lukimcfly/MaturaProjekt/Bilder/Aufbau/arduino-und-breadboard.jpg

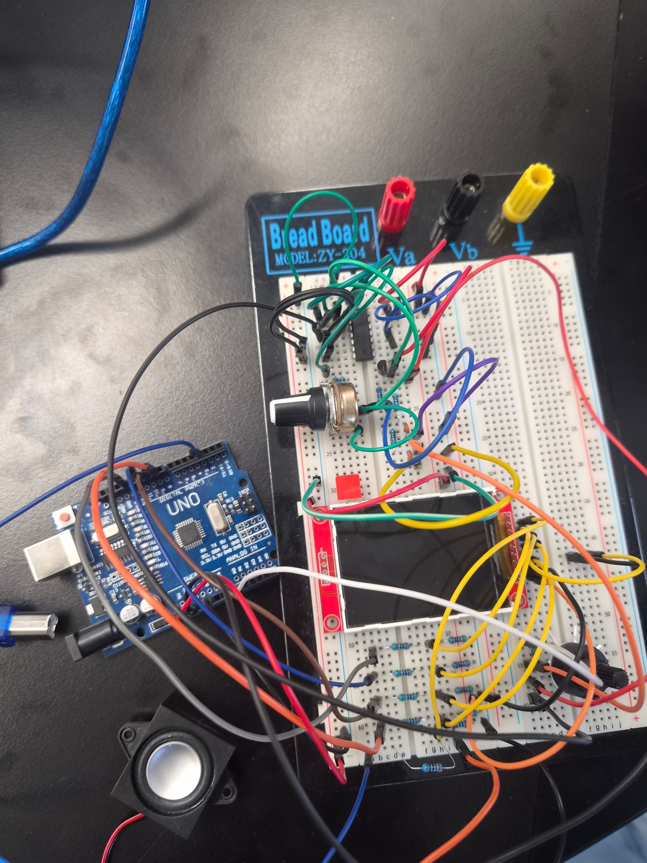
Bilder/Aufbau/arduino-und-breadboard.jpg
