lukimcfly/MaturaProjekt/Bilder/Aufbau/saegezahn-breadboard.jpg

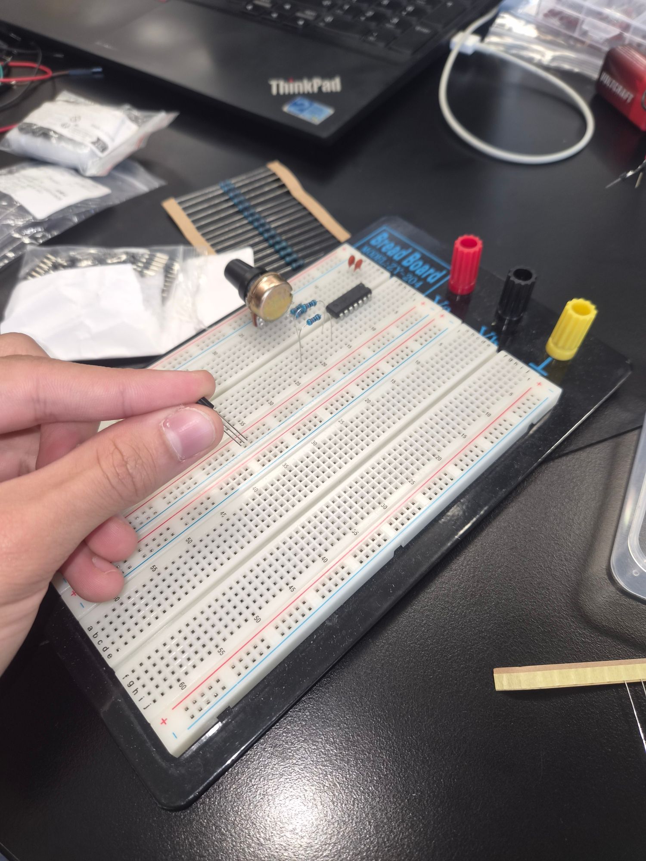
Bilder/Aufbau/saegezahn-breadboard.jpg
