lukimcfly/MaturaProjekt/Bilder/README.md

# Bilder

Alle Bilder zum Projekt. Jedes Bild bekommt hier unten eine Zeile im Index —
sonst weiß in zwei Monaten niemand mehr, was auf `IMG_4471.jpg` zu sehen ist.

## Unterordner

| Ordner | Inhalt |
|---|---|
| `Schaltplaene/` | KiCad-Screenshots, Schaltplanausschnitte, PCB-Layouts |
| `Aufbau/` | Fotos von Breadboard-Aufbauten, Bauteilen, Gehäuse |
| `Messungen/` | Oszilloskop-Screenshots, Spektren, Messprotokolle |

## Bild aus der Zwischenablage speichern

Statt von Hand abzuspeichern: Bild kopieren (Snipping Tool, Strg+C in KiCad),
dann im Projektordner in PowerShell:

```
.\Bilder\zwischenablage-speichern.ps1 saw-oszillator-v3
.\Bilder\zwischenablage-speichern.ps1 breadboard-mixer -Ordner Aufbau
```

Das Datum wird automatisch vorangestellt.

## Dateibenennung

`JJJJ-MM-TT_kurzbeschreibung.png`

Beispiele:
- `2026-08-12_oszillator-schmitt-trigger.png`
- `2026-09-05_breadboard-mixer.jpg`
- `2026-09-10_oszi-saegezahn-440hz.png`

Das Datum vorne sortiert die Bilder automatisch chronologisch und lässt sich
direkt dem passenden Tagebucheintrag zuordnen.

---

## Index

| Datei | Datum | Was ist zu sehen |
|---|---|---|
| `Schaltplaene/2026-08-19_saw-oszillator-kicad-v2.png` | 19.08.2026 | KiCad-Schaltplan Sägezahn-Oszillator, aktuelle Revision mit RVar zur Frequenzeinstellung |
| `Schaltplaene/2026-08-19_saw-oszillator-stromfluss.png` | 19.08.2026 | Erklärskizze zum Stromfluss mit Sägezahn-Kurve und Schaltschwellen V_T+ / V_T− |
| `Messungen/2026-08-19_falstad-simulation-saegezahn.mp4` | 19.08.2026 | Bildschirmaufnahme der Falstad-Simulation: Schaltung und Sägezahn-Kurvenform mit Frequenzregelung |
| `Schaltplaene/2026-09-16_platine-oszillator-oben.png` | 16.09.2026 | Oszillator-Platine, Bestückungsseite — die fertig geroutete Version |
| `Schaltplaene/2026-09-16_platine-oszillator-unten.png` | 16.09.2026 | Oszillator-Platine, Rückseite mit der Massefläche |
| `Schaltplaene/2026-09-21_bedienfeld-uebersicht.png` | 21.09.2026 | Bedienfeld: alle 24 Drehknöpfe, 7 Drehschalter, 13 Kippschalter, 3 Fader, Modus-Taster, 13 Buchsen, Display und Lautsprecherklemmen eines Geräts, mit Referenzen aus VERDRAHTUNG.md |
| *(fehlt noch)* `Schaltplaene/2026-08-12_oszillator-schmitt-trigger.png` | 12.08.2026 | erste Revision des Oszillators (RHigh 20 kΩ, RLow/RB 270 Ω) |
| `Schaltplaene/distortion-schalter-alt-SW2.png` | – | Distortion: ursprünglicher einfacher Umschalter weich/hart (SW2) |
| `Schaltplaene/distortion-schalter-neu-SW4-DPDT.png` | – | Distortion: neuer zweipoliger Umschalter (SW4, DPDT) |
| `Aufbau/saegezahn-breadboard.jpg` | nach den Herbstferien | Sägezahn-Oszillator auf dem Breadboard |
| `Aufbau/arduino-oszilloskop-display.jpg` | nach den Herbstferien | 2,2"-Display (ILI9341) des Arduino-Oszilloskops, Rückseite |
| `Aufbau/arduino-und-breadboard.jpg` | nach den Herbstferien | Arduino Uno, Display und Sägezahn-Oszillator auf dem Breadboard |
| `Aufbau/arduino-oszilloskop-saegezahn-2185hz.jpg` | nach den Herbstferien | Display zeigt den Sägezahn mit 2185 Hz |
| `WhatsApp/IMG-JJJJMMTT-WA….jpg` | im Dateinamen | Fotos aus dem Gruppenchat (Skizzen, Schaltpläne, Simulationen, Messungen). Bekannt: 20260610-WA0011 Oszilloskop LED-Blinker, 20260610-WA0005 Schaltplan Blinker, 20260818-WA0001 Sägezahn v1, 20260819-WA0002 Sägezahn v2, 20260819-WA0001 Produktskizze, 20260820-WA0003 Funktionsgenerator, 20260824-WA0003 / 20260826-WA0000 Distortion, 20260826-WA0009 Falstad-Mixer, 20260909-WA0003 Filter v1 |

---

## Beschreibungen

### 2026-08-19 — Sägezahn-Oszillator, aktuelle Revision (`...kicad-v2.png`)

| Bauteil | Wert | Funktion |
|---|---|---|
| U2A | 74LVC2G17 | Schmitt-Trigger-Buffer, Eingang Pin 1, Ausgang Pin 6 |
| RVar | 0 Ω – 25 kΩ | **einstellbarer Ladewiderstand → bestimmt die Tonhöhe** |
| RHigh | 5 kΩ | fester Anteil des Ladewiderstands, begrenzt die höchste Frequenz |
| C4 | 100 nF | zeitbestimmender Kondensator |
| Q4 | NPN | Entladeschalter, vom Schmitt-Trigger-Ausgang gesteuert |
| RLow | 220 Ω | Entladewiderstand vom Kondensatorknoten zum Kollektor |
| RB | 220 Ω | Basiswiderstand |

**Funktionsprinzip:** C4 lädt sich langsam über RVar + RHigh auf. Bei Erreichen der
oberen Schaltschwelle V_T+ kippt der Schmitt-Trigger-Ausgang auf HIGH, schaltet Q4
durch und entlädt C4 schnell über RLow gegen Masse. Bei V_T− kippt der Ausgang
zurück und der Ladevorgang beginnt von vorn.

Weil der Ladewiderstand (5 – 30 kΩ) rund hundertmal grösser ist als der
Entladewiderstand (220 Ω), dauert das Aufladen sehr viel länger als das Entladen —
genau diese **Asymmetrie erzeugt die Sägezahnform**. Mit RVar lässt sich die
Ladezeit und damit die Frequenz einstellen.

### 2026-08-19 — Erklärskizze Stromfluss (`...stromfluss.png`)

Dieselbe Schaltung mit eingezeichnetem Strompfad und der resultierenden
Sägezahn-Kurve zwischen den beiden Schaltschwellen V_T+ und V_T−. Zeigt anschaulich
den langsamen Anstieg und den steilen Abfall. Bauteilwerte in dieser Skizze noch
aus der ersten Revision (RHigh 20 kΩ, RLow 270 Ω, RB 2,2 kΩ).

### 2026-08-12 — erste Revision (Bilddatei fehlt noch)

Gleiche Topologie, andere Werte: RHigh 20 kΩ, RLow 270 Ω, RB 270 Ω, C4 ohne
festen Wert. Noch ohne einstellbaren Widerstand, also mit fester Frequenz.

### 2026-08-19 — Falstad-Simulation (`Messungen/...saegezahn.mp4`)

Bildschirmaufnahme der laufenden Simulation auf `falstad.com/circuit`. Zu sehen
sind die nachgebaute Schaltung und die erzeugte Sägezahnspannung; über den
einstellbaren Widerstand ändert sich die Frequenz.

**Erster Funktionsnachweis des selbst entworfenen Oszillators.**

Standbilder aus dem Video (Kurvenform, Frequenz an beiden Anschlagpunkten von
RVar) sollten noch als PNG gesichert werden — im schriftlichen Kommentar lässt
sich kein Video abdrucken.

### 2026-09-12 — Leiterplatten-Layouts (`Schaltplaene/2026-09-12_platine-*.png`)

3D-Ansichten der fertig gerouteten Platinen, jeweils Ober- und Unterseite.

| Datei | Inhalt |
|---|---|
| `2026-09-12_platine-hauptplatine-oben.png` | Hauptplatine, Bestückungsseite. Oben die Versorgung (Sicherungen, Verpolschutz, Siebung), in der Mitte der Mixer, unten rechts die LM386-Endstufe |
| `2026-09-12_platine-hauptplatine-unten.png` | Hauptplatine, Rückseite — fast durchgehende Massefläche, nur wenige kurze Leiterbahnen |
| `2026-09-12_platine-filter-oben.png` | Filter-Platine, Bestückungsseite. Die beiden Integratoren spiegeln sich um `U401` |
| `2026-09-12_platine-filter-unten.png` | Filter-Platine, Rückseite |

Warum die Rückseite fast leer ist: auf einer zweilagigen Platine **ist** die
Rückseite die Massefläche. Jede Leiterbahn dort schneidet einen Schlitz hinein,
den der Rückstrom umfliessen muss — deshalb kostet der Router das Fahren auf der
Rückseite extra und benutzt sie nur zum Kreuzen.

### 2026-09-16 — Oszillator-Platine (`Schaltplaene/2026-09-16_platine-oszillator-*.png`)

Die dritte und dichteste Platine, jetzt vollständig geroutet.

| Datei | Inhalt |
|---|---|
| `2026-09-16_platine-oszillator-oben.png` | Bestückungsseite. Oben die Versorgung mit den beiden Elkos, links `U103` (Vierfach-Op-Amp im SOIC-14, heute TL074CDR) mit den sechs Dioden der Wellenformung, rechts `U101` (TL074) in der Fassung, unten die beiden grossen Panel-Stecker `POTIS` und `SCHALTER` |
| `2026-09-16_platine-oszillator-unten.png` | Rückseite. Hier ist mehr Kupfer zu sehen als bei den anderen beiden Platinen — die Platine ist dichter, der Router muss öfter auf die Rückseite ausweichen |

Auffällig auf der Unterseite ist **ein längerer Zug quer über die Platine**: das
Netz `O1_AINV`. Dafür wurde eine Sperrfläche bewusst aufgehoben; die Begründung
und die gemessenen Kosten stehen in
[`Platinen/README.md`](../Platinen/README.md).

Die 27 Widerstände stehen **senkrecht** (ein Draht um 180° zurückgebogen) — auf
den Bildern gut zu erkennen. Liegend hätten sie neben den vier ICs keinen Platz
gelassen.
