lukimcfly/MaturaProjekt/Unsere-Materialien/README.md

# Unsere Materialien

Alles, was wir selbst für die Abgabe erstellen.

## Unterordner

| Ordner | Inhalt |
|---|---|
| `Vertrag/` | Der Maturaarbeits-Vertrag (Projektbeschreibung, Fragestellung, Bewertungskriterien) |
| `Logbuch/` | Das offizielle Logbuch zur Abgabe |
| `Schriftlicher-Kommentar/` | Der schriftliche Kommentar / die Projektarbeit |

## Verwandte Ordner außerhalb

- `diary/` — laufendes Arbeitstagebuch, die Rohfassung für das Logbuch
- `plan/` — Zeitpläne
- `quellen/` — Lernmaterial, wird später zum Quellenverzeichnis
