lukimcfly/MaturaProjekt/KI-Protokolle/2026-09-09_1fea6b0a.md

# Sitzung 1fea6b0a

- Sitzungs-ID: `1fea6b0a-24cf-402c-9ea6-93644efb6f1b`
- Zeitraum: 2026-09-09 bis 2026-09-09
- Modell(e): claude-opus-5
- Nutzer-Prompts: 8

> Lesbare Fassung: Prompts und Antworten im Wortlaut, Werkzeugaufrufe nur als Kurzzeile, Werkzeug-Ausgaben weggelassen.

---
### 🧑 Nutzer · 2026-09-09 13:14 UTC

Kicad file: C:\Users\<user>\Downloads\MaturaProjekt\KicadCircuit

in there you will find 2 schematic files of my circuit design for synthesizer. final goal: 3 oscillators, going into mixer, going through 2x filter in series, and then into amplifier. audiojack in oscillator is used to connect a single oscillator to filter (2 of these in total, separate from the others). make a new project, and create a final schematic containing everything, that is in total: 3 oscillators, 1 mixer, 4 filter, leading into amplifier. for mixer, use the schematic of the open falstad project in claude browser. for everything else, use the schematics from the files. make sure its clean, and if you have additional questions, ask. Love u <3

**🤖 Claude:**

I'll start by looking at your existing schematic files.

- *Werkzeug: Bash* — List KiCad project files
- *Werkzeug: mcp__Claude_Browser__tabs_context* — 

**🤖 Claude:**

The in-app browser has no tabs open — the Falstad project may be in your real Chrome. Let me check both while I read the schematics.

- *Werkzeug: Bash* — Inspect Filter schematic header and symbols
- *Werkzeug: ToolSearch* — 
- *Werkzeug: mcp__claude-in-chrome__tabs_context_mcp* — 
- *Werkzeug: Bash* — Extract symbol instances from both schematics

**🤖 Claude:**

Chrome isn't connected, and the in-app browser has no tabs open. Let me dig into the schematics first.

- *Werkzeug: Bash* — Extract labels and text from schematics

**🤖 Claude:**

No hierarchical labels — both sheets are fully wired flat. Let me map the actual topology of the Filter.

- *Werkzeug: Bash* — List Filter components with refs and values
- *Werkzeug: Bash* — Dump Filter schematic body without lib_symbols

---
### 🧑 Nutzer · 2026-09-09 13:15 UTC

[Request interrupted by user]

---
### 🧑 Nutzer · 2026-09-09 13:15 UTC

The in-app browser has no tabs open — the Falstad project may be in your real Chrome. -> sorry, now it's open in the claude browser. Continue

- *Werkzeug: mcp__Claude_Browser__tabs_context* — 
- *Werkzeug: mcp__Claude_Browser__javascript_tool* — 
- *Werkzeug: mcp__Claude_Browser__javascript_tool* — 
- *Werkzeug: Bash* — Decode Falstad circuit from URL
- *Werkzeug: Bash* — Try LZMA decode of Falstad circuit

**🤖 Claude:**

Let me just use Falstad's own export dialog.

- *Werkzeug: mcp__Claude_Browser__browser_batch* — 
- *Werkzeug: mcp__Claude_Browser__browser_batch* — 
- *Werkzeug: mcp__Claude_Browser__javascript_tool* — 
- *Werkzeug: mcp__Claude_Browser__javascript_tool* — 
- *Werkzeug: mcp__Claude_Browser__computer* — 

**🤖 Claude:**

The File menu is open — clicking "Export As Text".

- *Werkzeug: mcp__Claude_Browser__computer* — 
- *Werkzeug: mcp__Claude_Browser__javascript_tool* — 

**🤖 Claude:**

Got the full mixer netlist. Now let me map the oscillator schematic.

- *Werkzeug: Bash* — List oscillator components
- *Werkzeug: Bash* — Dump component lists and bodies
- *Werkzeug: Bash* — Dump component lists with UTF-8 output

**🤖 Claude:**

I've now got: the Falstad mixer netlist (3× [1µF → 10k pot → 22k] summing into an NPN common-emitter stage: 10µF coupling, 47k/10k bias, 330Ω collector, 10Ω+90Ω emitter with 470µF bypass, 47µF output), plus both KiCad sheets parsed.

Before I build, four things I genuinely can't infer:

- *Werkzeug: AskUserQuestion* — 

**🤖 Claude:**

Power rails: I'll go with **split ±12V + GND** — best fit here. All the op-amps you use (LM324, OPA1662, ADA4625, OPA4196) then swing around 0 V with no mid-rail bias network anywhere, the Falstad mixer's NPN stage runs unchanged off +12V/GND (its output is already AC-coupled), and the LM386 is a single-supply part that takes +12V/GND directly. One supply, no extra biasing block.

Let me inspect the instance/UUID format so replication is valid KiCad 9.

- *Werkzeug: Bash* — Inspect symbol instances format
- *Werkzeug: Bash* — Locate KiCad symbol libraries
- *Werkzeug: Bash* — Search for KiCad install
- *Werkzeug: Bash* — Check KiCad symbol library path

**🤖 Claude:**

Full KiCad 9 libraries are available locally — I can pull exact symbol definitions. Let me verify the parts I need.

- *Werkzeug: Bash* — Verify needed symbols exist in KiCad libs
- *Werkzeug: Bash* — Find potentiometer and passive symbols
- *Werkzeug: Bash* — Write s-expression parser helper

**🤖 Claude:**

Now let me verify the parser round-trips and validate the pin-position transform against the source files.

- *Werkzeug: Bash* — Validate parser and extract library pin coordinates
- *Werkzeug: Write* — C:\Users\<user>\AppData\Local\Temp\claude\C--Users-<user>-Downloads-MaturaProjekt\1fea6b0a-24cf-402c-9ea6-93644efb6f1b\scratchpad\sexpr.py
- *Werkzeug: Bash* — Validate parser round-trip and dump lib pin coords

**🤖 Claude:**

Parser round-trips cleanly. Now validating the pin-placement transform empirically against both source sheets.

- *Werkzeug: Write* — C:\Users\<user>\AppData\Local\Temp\claude\C--Users-<user>-Downloads-MaturaProjekt\1fea6b0a-24cf-402c-9ea6-93644efb6f1b\scratchpad\pintest.py
- *Werkzeug: Bash* — Test pin transform hypotheses

**🤖 Claude:**

Transform A confirmed. Let me check for `kicad-cli` (so I can ERC-validate the result) and inspect op-amp power-pin metadata.

- *Werkzeug: Bash* — 

**🤖 Claude:**

`kicad-cli` 9.0.7 is available — I can ERC-check and render the result. Now the op-amp power pins:

- *Werkzeug: Bash* — List power pins of all library symbols used

**🤖 Claude:**

Let me examine the oscillator's output stage to confirm where the output net is.

- *Werkzeug: Bash* — Inspect oscillator output stage wiring

**🤖 Claude:**

Let me run ERC on your original sheets to see what the sources themselves report.

- *Werkzeug: Bash* — Run ERC on original oscillator schematic
- *Werkzeug: Bash* — Run ERC without exit-code flag
- *Werkzeug: Bash* — Run ERC on original filter schematic
- *Werkzeug: Bash* — List oscillator dangling endpoints

**🤖 Claude:**

Now let me pull the pin geometry for the new parts (mixer + LM386 amp).

- *Werkzeug: Bash* — Extract pin geometry for new symbols
- *Werkzeug: Bash* — Resolve BC547 symbol inheritance
- *Werkzeug: Bash* — Get NPN base symbol pins and power symbol names

**🤖 Claude:**

All data gathered. Now writing the generator.

- *Werkzeug: Write* — C:\Users\<user>\AppData\Local\Temp\claude\C--Users-<user>-Downloads-MaturaProjekt\1fea6b0a-24cf-402c-9ea6-93644efb6f1b\scratchpad\kilib.py
- *Werkzeug: Bash* — Map filter output amplifier wiring

**🤖 Claude:**

Now the main build script.

- *Werkzeug: Write* — C:\Users\<user>\AppData\Local\Temp\claude\C--Users-<user>-Downloads-MaturaProjekt\1fea6b0a-24cf-402c-9ea6-93644efb6f1b\scratchpad\build.py
- *Werkzeug: Bash* — Test library loading and bboxes
- *Werkzeug: Bash* — Check power flag on power symbols

**🤖 Claude:**

Now the mixer, amplifier, power section and assembly.

- *Werkzeug: Bash* — Append mixer and amplifier builders
- *Werkzeug: Write* — C:\Users\<user>\AppData\Local\Temp\claude\C--Users-<user>-Downloads-MaturaProjekt\1fea6b0a-24cf-402c-9ea6-93644efb6f1b\scratchpad\blocks.py

**🤖 Claude:**

Now the power section and final assembly.

- *Werkzeug: Write* — C:\Users\<user>\AppData\Local\Temp\claude\C--Users-<user>-Downloads-MaturaProjekt\1fea6b0a-24cf-402c-9ea6-93644efb6f1b\scratchpad\assemble.py
- *Werkzeug: Bash* — Run assembly script

**🤖 Claude:**

Generated. Now the project file, then ERC and a render.

- *Werkzeug: Bash* — Create project file and run ERC
- *Werkzeug: Bash* — Inspect generated schematic head

**🤖 Claude:**

Found the bugs: a duplicated symbol name in the `extends` flattening, and reference collisions between new and copied blocks. Fixing, plus improving the output formatting to match KiCad's style.

- *Werkzeug: Edit* — C:\Users\<user>\AppData\Local\Temp\claude\C--Users-<user>-Downloads-MaturaProjekt\1fea6b0a-24cf-402c-9ea6-93644efb6f1b\scratchpad\sexpr.py
- *Werkzeug: Edit* — C:\Users\<user>\AppData\Local\Temp\claude\C--Users-<user>-Downloads-MaturaProjekt\1fea6b0a-24cf-402c-9ea6-93644efb6f1b\scratchpad\kilib.py

**🤖 Claude:**

Now fixing the reference-collision scheme across all blocks.

- *Werkzeug: Bash* — Patch reference schemes and rebuild
- *Werkzeug: Bash* — Rebuild and run ERC

**🤖 Claude:**

Load still fails. Let me bisect to find the offending construct.

- *Werkzeug: Write* — C:\Users\<user>\AppData\Local\Temp\claude\C--Users-<user>-Downloads-MaturaProjekt\1fea6b0a-24cf-402c-9ea6-93644efb6f1b\scratchpad\bisect.py
- *Werkzeug: Bash* — Bisect the failing schematic element
- *Werkzeug: Bash* — Find which lib symbols fail to load
- *Werkzeug: Bash* — Get detailed error for one failing symbol
- *Werkzeug: Bash* — View rest of the Speaker symbol entry
- *Werkzeug: Bash* — Diff library-sourced vs schematic-embedded R_US

**🤖 Claude:**

Found it — sub-unit symbol names must stay unprefixed (`R_US_1_1`, not `Device:R_US_1_1`).

- *Werkzeug: Edit* — C:\Users\<user>\AppData\Local\Temp\claude\C--Users-<user>-Downloads-MaturaProjekt\1fea6b0a-24cf-402c-9ea6-93644efb6f1b\scratchpad\kilib.py
- *Werkzeug: Bash* — Rebuild and run ERC
- *Werkzeug: Bash* — Re-check which lib symbols still fail

**🤖 Claude:**

lib_symbols are fine now. Bisecting the schematic items.

- *Werkzeug: Bash* — Bisect items for load failure

**🤖 Claude:**

The failure is a literal newline inside a quoted string — KiCad requires `\n` escapes.

- *Werkzeug: Edit* — C:\Users\<user>\AppData\Local\Temp\claude\C--Users-<user>-Downloads-MaturaProjekt\1fea6b0a-24cf-402c-9ea6-93644efb6f1b\scratchpad\sexpr.py
- *Werkzeug: Bash* — Rebuild and run ERC

**🤖 Claude:**

It loads now. Let me see the violation breakdown.

- *Werkzeug: Bash* — Summarize ERC violations

**🤖 Claude:**

Good — it loads. Now fixing the real issues: off-grid block placement (1045 warnings), the supply block wiring, and NC pins.

- *Werkzeug: Bash* — Get Conn_01x03 pin coordinates
- *Werkzeug: Bash* — Rewrite amplifier block on a clean grid
- *Werkzeug: Bash* — Fix string literal in blocks.py
- *Werkzeug: Edit* — C:\Users\<user>\AppData\Local\Temp\claude\C--Users-<user>-Downloads-MaturaProjekt\1fea6b0a-24cf-402c-9ea6-93644efb6f1b\scratchpad\blocks.py

**🤖 Claude:**

Now the supply block rewrite and grid snapping.

- *Werkzeug: Bash* — Verify blocks imports and locate supply function
- *Werkzeug: Bash* — Rewrite the supply block

**🤖 Claude:**

Now grid snapping and the NC-pin pass.

- *Werkzeug: Bash* — Apply grid snap and NC pass, rebuild, ERC

**🤖 Claude:**

Off-grid errors gone (1045 → 0). Let me look at what remains.

- *Werkzeug: Bash* — List remaining non-unit ERC issues

**🤖 Claude:**

Let me inspect the supply block in the generated file to see why those pins read as unconnected.

- *Werkzeug: Bash* — Dump supply block geometry from output
- *Werkzeug: Bash* — Check wires produced by build_supply
- *Werkzeug: Bash* — ERC the supply block in isolation
- *Werkzeug: Bash* — Inspect raw wire and junction syntax

**🤖 Claude:**

Let me export the netlist to see what KiCad actually connects.

- *Werkzeug: Bash* — Export netlist for the supply probe
- *Werkzeug: Bash* — Check wire endpoints at connector pins
- *Werkzeug: Bash* — Check for duplicate UUIDs
- *Werkzeug: Bash* — Minimal connector connection test

**🤖 Claude:**

The minimal case works. Let me add the junction-plus-branch pattern.

- *Werkzeug: Bash* — Test junction-plus-branch pattern

**🤖 Claude:**

Reproduced: a junction placed **mid-wire** with a branch doesn't connect — KiCad expects the wire split at that point. This also affects the mixer's summing bus. Adding a general split pass.

- *Werkzeug: Bash* — Add wire-splitting pass and rebuild
- *Werkzeug: Bash* — List remaining ERC issues
- *Werkzeug: Bash* — Identify oscillator audio jack references
- *Werkzeug: Bash* — Add solo-filter jacks, fix speaker, rebuild

**🤖 Claude:**

The heredoc mangled the escapes again. Fixing those strings directly.

- *Werkzeug: Bash* — View broken region of assemble.py
- *Werkzeug: Bash* — Repair split string literals
- *Werkzeug: Bash* — Rebuild and run ERC

**🤖 Claude:**

Down to 3 errors and 35 warnings, all inherited from the source design. Let me fix the stale note and render it to look at.

- *Werkzeug: Edit* — C:\Users\<user>\AppData\Local\Temp\claude\C--Users-<user>-Downloads-MaturaProjekt\1fea6b0a-24cf-402c-9ea6-93644efb6f1b\scratchpad\assemble.py
- *Werkzeug: Bash* — Export SVG preview
- *Werkzeug: Bash* — Export PDF

**🤖 Claude:**

Let me visually inspect the result.

- *Werkzeug: Read* — C:\Users\<user>\Downloads\MaturaProjekt\SynthesizerFinal\SynthesizerFinal.pdf
- *Werkzeug: mcp__Claude_Browser__navigate* — file:///C:/Users/<user>/Downloads/MaturaProjekt/SynthesizerFinal/preview/SynthesizerFinal.svg

**🤖 Claude:**

Let me verify the connectivity via the netlist — stronger than eyeballing.

- *Werkzeug: Bash* — Verify signal chain nets

**🤖 Claude:**

Connectivity verified end-to-end. Let me check the mixer bus and the solo filters, and look at the odd reference names.

- *Werkzeug: Bash* — Verify mixer bus, transistor and solo jack nets

**🤖 Claude:**

All connectivity checks pass. Last cleanup: the source's non-standard reference `0Ω-25kΩ` produced ugly auto-refs — let me preserve that text as the component value instead.

- *Werkzeug: Bash* — Fix odd references and rebuild
- *Werkzeug: Bash* — List source symbols with non-standard references

**🤖 Claude:**

Three of those are meaningful *names* (`RLow`, `RHigh`, `RB`) with real values — my last patch would clobber them. Refining.

- *Werkzeug: Edit* — C:\Users\<user>\AppData\Local\Temp\claude\C--Users-<user>-Downloads-MaturaProjekt\1fea6b0a-24cf-402c-9ea6-93644efb6f1b\scratchpad\build.py
- *Werkzeug: Bash* — Rebuild and verify renamed components

**🤖 Claude:**

Layout check — let me actually look at it. Starting a local server to view the SVG.

- *Werkzeug: Bash* — Create launch config for preview server
- *Werkzeug: mcp__Claude_Browser__preview_start* — 
- *Werkzeug: Bash* — Create SVG viewer with zoom support
- *Werkzeug: mcp__Claude_Browser__browser_batch* — 

**🤖 Claude:**

Layout is sound. Let me zoom into two spots that look like text collisions.

- *Werkzeug: mcp__Claude_Browser__browser_batch* — 

**🤖 Claude:**

The text is center-justified, so it runs off the page frame. Fixing that.

- *Werkzeug: Edit* — C:\Users\<user>\AppData\Local\Temp\claude\C--Users-<user>-Downloads-MaturaProjekt\1fea6b0a-24cf-402c-9ea6-93644efb6f1b\scratchpad\kilib.py
- *Werkzeug: Bash* — Rebuild with left-justified text
- *Werkzeug: mcp__Claude_Browser__browser_batch* — 

**🤖 Claude:**

Good. Two cosmetic fixes: jack labels overlapping the ground symbol, and the output jack sitting on the diode labels.

- *Werkzeug: Edit* — C:\Users\<user>\AppData\Local\Temp\claude\C--Users-<user>-Downloads-MaturaProjekt\1fea6b0a-24cf-402c-9ea6-93644efb6f1b\scratchpad\assemble.py
- *Werkzeug: Bash* — Rebuild and re-export
- *Werkzeug: mcp__Claude_Browser__browser_batch* — 

**🤖 Claude:**

A few ground labels sit above their symbols and collide. Fixing the power-symbol text placement.

- *Werkzeug: Edit* — C:\Users\<user>\AppData\Local\Temp\claude\C--Users-<user>-Downloads-MaturaProjekt\1fea6b0a-24cf-402c-9ea6-93644efb6f1b\scratchpad\kilib.py
- *Werkzeug: Bash* — Reroute amp ground and rebuild
- *Werkzeug: mcp__Claude_Browser__browser_batch* — 

**🤖 Claude:**

Let me check how KiCad stores property text angle for rotated symbols.

- *Werkzeug: Bash* — Check property angle convention for rotated symbols
- *Werkzeug: mcp__Claude_Browser__browser_batch* — 

**🤖 Claude:**

Two issues: rotated symbols' ref/value text overlaps, and short label stubs. Let me test the property-angle behaviour.

- *Werkzeug: Bash* — Probe property text angle behaviour
- *Werkzeug: Bash* — Create viewer for angle test
- *Werkzeug: mcp__Claude_Browser__browser_batch* — 

**🤖 Claude:**

Confirmed — property angle is relative to the symbol, so it must be `(360 − rot)`. Fixing that and lengthening the label stubs.

- *Werkzeug: Edit* — C:\Users\<user>\AppData\Local\Temp\claude\C--Users-<user>-Downloads-MaturaProjekt\1fea6b0a-24cf-402c-9ea6-93644efb6f1b\scratchpad\kilib.py
- *Werkzeug: Bash* — Lengthen label stubs and rebuild
- *Werkzeug: Bash* — Re-export and clean up test files
- *Werkzeug: mcp__Claude_Browser__browser_batch* — 

**🤖 Claude:**

Text is horizontal now. Tightening a few crowded labels in the mixer's transistor stage.

- *Werkzeug: Bash* — Adjust mixer label positions and re-render
- *Werkzeug: mcp__Claude_Browser__browser_batch* — 
- *Werkzeug: Bash* — Final label tweak, rebuild all outputs
- *Werkzeug: mcp__Claude_Browser__browser_batch* — 

**🤖 Claude:**

Final verification pass.

- *Werkzeug: Bash* — Generate BOM and final stats

**🤖 Claude:**

All checks pass. Writing documentation and cleaning up.

- *Werkzeug: Write* — C:\Users\<user>\Downloads\MaturaProjekt\SynthesizerFinal\README.md
- *Werkzeug: Bash* — Verify claims about jack wiring and filter feedback
- *Werkzeug: Edit* — C:\Users\<user>\Downloads\MaturaProjekt\SynthesizerFinal\README.md
- *Werkzeug: Bash* — Clean up helper files
- *Werkzeug: mcp__Claude_Browser__preview_stop* — 
- *Werkzeug: Write* — C:\Users\<user>\.claude\projects\C--Users-<user>-Downloads-MaturaProjekt\memory\synth-gesamtschaltplan.md
- *Werkzeug: Bash* — Update memory index
- *Werkzeug: SendUserFile* — 

**🤖 Claude:**

Done — new project at [SynthesizerFinal/](SynthesizerFinal), one flat sheet with everything on it.

**Signalweg:** 3 Oszillatoren → Mixer → Filter A → Filter B → LM386 → Lautsprecher, plus Filter C/D als Solo-Filter mit eigenen Klinkenbuchsen.

**Was ich gebaut habe**
- Oszillator 1:1 aus deiner Datei, 3× instanziiert; Filter 4× — A und die beiden Solo-Filter ohne Ausgangsverstärker, B mit (folgt deiner Notiz im Original-Filterblatt).
- Mixer aus der Falstad-Simulation abgelesen: pro Kanal 1 µF → 10 k Poti → 22 k auf die Summierschiene, dann BC547-Emitterschaltung (10 µF Kopplung, 47k/10k Basisteiler, 330 Ω Kollektor, 10 Ω + 90 Ω mit 470 µF, 47 µF Ausgang). Den 1 k Lastwiderstand habe ich mitgenommen, damit Messung und Simulation vergleichbar bleiben.
- LM386-Endstufe mit Master-Poti, Verstärkung 200, Zobel-Glied, 8 Ω Lautsprecher.

**Rails — deine Wahl war delegiert, ich habe ±12 V genommen.** Alle OPVs (LM324, OPA1662, OPA4196, ADA4625) schwingen damit um 0 V, kein Mittenspannungs-Netzwerk nötig; die BC547-Mixerstufe läuft unverändert an +12 V/GND wie simuliert, der LM386 ebenfalls. Ein Netzteil, keine Extra-Blöcke. Die Versorgungs-Units aller 16 Chips habe ich ergänzt und abgeblockt — die fehlten im Original komplett.

**Geprüft mit kicad-cli 9.0.7:** ERC 3 Fehler / 35 Warnungen, alle aus dem Originalentwurf (Pin-Typ des SPICE-NPN-Emitters, ungenutzte OPV-Einheiten, offener Schmitt-Trigger-Eingang). Der Netzliste nach ist die Kette durchgehend verbunden. 252 Bauteile, 181 Netze, BOM liegt bei.

**Vier Punkte solltest du dir ansehen** — gefunden beim Zusammenführen, bewusst nicht stillschweigend geändert:
1. Bei den Ausgangsbuchsen `J101/J201/J301` liegt das Signal am *Sleeve*, der *Tip* am Rückkopplungsknoten von U106 — normalerweise umgekehrt.
2. Bei `U501` geht `R504` vom Ausgang auf den **+**-Eingang, am **−**-Eingang nur `R505` nach Masse. Das ist Mitkopplung.
3. Oszillatorkern und Ausgangsstufe sind nicht verbunden (im Original ein `power:AC`-Symbol ohne Gegenstück) — jetzt als `OSC1_CORE` etc. sichtbar beschriftet.
4. Die Bauteilwerte der Filterblöcke sind im Original leer, stehen also auch in der BOM noch offen.

Sag Bescheid, wenn ich 1–3 korrigieren soll — das sind kleine Eingriffe, ich wollte nur deine Schaltung nicht ungefragt umbauen.

---
### 🧑 Nutzer · 2026-09-09 14:17 UTC

ja bitte korrigier 1-3.

Ait und bitte danach: Mache einen Schaltkreis, der alles was wir haben enthält und wie unser finales produkt sein soll. 

Dabei bitte Werte beachten und falls nötig anpassen (bitte am Schluss eine Liste angeben welche Werte verändert worden sind).
Frequenz, Amplitude, Filterstärke, Für jedes Oszillatorensignal im Mixer amplitude/Effektivität verstelltbar. Und für jeden Oszillator ist die Wave-form verstellbar. -> Das sollte eigentlich schon alles möglich sein in unseren Schaltplänen, aber trotzdem nochmals kurz zur Kontrolle. 

Ziel: Ein einziger finaler Final-Schaltkreis.

**🤖 Claude:**

Understood — beides. Zuerst muss ich die beiden Blöcke wirklich im Detail verstehen (Filterzweige, Oszillator-Regler), bevor ich Werte festlege. Ich hole mir die Netzlisten der Originale.

- *Werkzeug: Bash* — Extract filter netlist and components

**🤖 Claude:**

No response requested.

---
### 🧑 Nutzer · 2026-09-09 14:47 UTC

Continue

**🤖 Claude:**

Filter topology decoded. Four branches off the rotary — series R + shunt C (Tiefpass), series C + shunt R (Hochpass), L-C-C-L Leiter (Bandpass), Parallel-LC-Sperrkreis (Bandsperre), Position 5 = Bypass. But **D1–D5 sitzen in Serie im Signalweg** — das ist ein echtes Problem. Erst der Oszillator:

- *Werkzeug: Bash* — Extract oscillator netlist

**🤖 Claude:**

Ich habe jetzt beide Blöcke vollständig entschlüsselt. Kurzer Kontrollbefund zu deiner Liste:

| Regler | Status |
|---|---|
| **Waveform** pro Oszillator | ✅ `SW1`, 4 Stellungen: Sinus (U1C), Dreieck (U1B), Rechteck (U1A), Sägezahn (U2/Q4) |
| **Mixer-Pegel** pro Kanal | ✅ `RV801/802/803`, 10 k |
| **Frequenz** | ⚠️ nur Sägezahn (`RVar` 0–25 k). Sinus/Dreieck/Rechteck liegen fest auf R6/C6 — deckt sich mit deinem ToDo *„Frequency Regulators kombinieren"* |
| **Amplitude** pro Oszillator | ⚠️ nicht implementiert (dein ToDo *„Amplitude Regulation"*, U6/R20/R4 halbfertig) |
| **Filterstärke** | ⚠️ nur `R4` als Ausgangspegel; Grenzfrequenz liegt fest |

Dazu ein vierter Fund, gravierender als die drei bekannten: **D1–D5 im Filter liegen in Serie im Signalweg** (jeder Zweig endet in einer Diode, alle Kathoden zusammen, dann D5 zum Ausgang). Dioden leiten erst ab ~0,6 V und nur in einer Richtung — das würde das Audiosignal gleichrichten statt filtern. Dasselbe Muster nochmal bei D5/D6 am Filter-Port des Oszillators.

Vier Entscheidungen, die den Schaltkreis wesentlich verändern:

- *Werkzeug: AskUserQuestion* — 

**🤖 Claude:**

Alle vier Empfehlungen übernommen. Beim Durchrechnen der Werte sind zwei weitere echte Fehler aufgetaucht, die ich mit einplane:

- **U2 (74LVC2G17) ist ein 1,65–5,5 V-Baustein** — ich hatte ihn in der Versorgung an +12 V gehängt, das würde ihn zerstören. Und der Sägezahn lädt C4 aus +12 V direkt in seinen Eingang. Beides braucht eine +5 V-Schiene.
- **C6 = 1 µF ergibt f ≈ 14 Hz** — der LM324-Kern schwingt also weit unter dem Hörbereich.

Erst die Geometrie, damit ich weiss, wo ich chirurgisch eingreifen kann:

- *Werkzeug: Bash* — Get positions of key oscillator components

**🤖 Claude:**

R6 ist bereits ein `R_Variable_US` — der Frequenzregler existiert also schon, er hat nur den falschen Wert. Aber beim Durchrechnen der Amplituden stosse ich auf ein architektonisches Problem. Lass mich das prüfen:

- *Werkzeug: Bash* — Find boundary-crossing wires and switch pin geometry

**🤖 Claude:**

Vier saubere Schnittstellen zu SW1 — die Kernstufe lässt sich also als Block ersetzen. Ich hole die restliche Pin-Geometrie:

- *Werkzeug: Bash* — Check part availability and pin geometry

**🤖 Claude:**

Kein 2-poliger Drehschalter in den Standard-Bibliotheken — ich nehme zwei gekoppelte `SW_Rotary_1x5_MP` (zwei Ebenen, so ist ein 2-poliger Drehschalter real auch aufgebaut). Letzte Geometrie, die ich brauche:

- *Werkzeug: Bash* — Map filter-port wiring region

**🤖 Claude:**

Ich habe jetzt das vollständige Bild. Der Befund ist grösser als gedacht:

**Der Oszillatorkern lässt sich nicht durch Werte reparieren.** U1A schwingt eigenständig, U1B und U1C integrieren nur nach. Die Amplitude eines Integrators ist ∝ 1/f — bei 85 Hz würde das Dreieck auf ~300 V wollen und hart clippen, bei 9 kHz bleiben 3 V übrig. Das ist Architektur, nicht Bestückung. Der Standardaufbau (Komparator und Integrator **im Regelkreis**) liefert dagegen bei jeder Frequenz konstante Amplitude.

Dazu kommt: der Sägezahnknoten ist hochohmig und braucht einen Puffer, sonst zieht ihn die nachfolgende Stufe zusammen.

Ich baue den Oszillator daher als saubere Blockstruktur neu auf — gleiche Bauteile, gleiche Funktionen, aber funktionierend verschaltet:

- *Werkzeug: Write* — C:\Users\<user>\AppData\Local\Temp\claude\C--Users-<user>-Downloads-MaturaProjekt\1fea6b0a-24cf-402c-9ea6-93644efb6f1b\scratchpad\parts.py

**🤖 Claude:**

Jetzt der Oszillator als sieben saubere Teilblöcke, über Netznamen verbunden:

- *Werkzeug: Write* — C:\Users\<user>\AppData\Local\Temp\claude\C--Users-<user>-Downloads-MaturaProjekt\1fea6b0a-24cf-402c-9ea6-93644efb6f1b\scratchpad\osc.py

**🤖 Claude:**

You've hit your session limit · resets 6:40pm (Europe/Zurich)

---
### 🧑 Nutzer · 2026-09-09 18:01 UTC

Continue

**🤖 Claude:**

Jetzt der Filter — neu gezeichnet mit 2-Ebenen-Wahlschalter, Puffern und echten Werten:

- *Werkzeug: Write* — C:\Users\<user>\AppData\Local\Temp\claude\C--Users-<user>-Downloads-MaturaProjekt\1fea6b0a-24cf-402c-9ea6-93644efb6f1b\scratchpad\flt.py

**🤖 Claude:**

Jetzt die Montage. Erst noch die Pins des 5-V-Reglers:

- *Werkzeug: Bash* — Get regulator and switch pin geometry
- *Werkzeug: Bash* — Remove explicit no-connects (handled centrally)

**🤖 Claude:**

Jetzt die Montage:

- *Werkzeug: Write* — C:\Users\<user>\AppData\Local\Temp\claude\C--Users-<user>-Downloads-MaturaProjekt\1fea6b0a-24cf-402c-9ea6-93644efb6f1b\scratchpad\assemble2.py
- *Werkzeug: Bash* — Run the new assembly
- *Werkzeug: Bash* — Run ERC on the new schematic

**🤖 Claude:**

It loads. Let me see what's not connecting.

- *Werkzeug: Bash* — List ERC violations

**🤖 Claude:**

Klare Fehlerbilder. Vier Ursachen: Buchsen nicht gespiegelt, eine fehlende Leitung am Pegel-Poti, eine ungenutzte Gatter-Hälfte — und vor allem: mein `split_wires` schneidet nur an Verbindungspunkten, nicht an **Bauteil-Pins**, die mitten auf einer Leitung liegen.

- *Werkzeug: Bash* — Fix jack mirroring and the level-pot wire gap

**🤖 Claude:**

Now the important one — `split_wires` must also cut at pin positions:

- *Werkzeug: Bash* — Split wires at pins, rebuild, ERC

**🤖 Claude:**

Von 77 auf 28. Der Rest:

- *Werkzeug: Bash* — List remaining ERC issues

**🤖 Claude:**

Ein systematischer Fehler: bei gespiegelten Buchsen liegt der Sleeve **über** dem Tip, nicht darunter. Ich korrigiere die Masseführung und ergänze die ungenutzte Gatter-Hälfte:

- *Werkzeug: Bash* — Fix jack grounds, add spare gate, rebuild
- *Werkzeug: Bash* — Repair string literal and rebuild

**🤖 Claude:**

**ERC: 0 Fehler, 0 Warnungen.** Jetzt die inhaltliche Prüfung — ERC sagt nur, dass alles verbunden ist, nicht dass es stimmt:

- *Werkzeug: Bash* — Verify the signal-chain netlist
- *Werkzeug: Bash* — Trace the oscillator-1 switch nets

**🤖 Claude:**

Alle Verbindungen stimmen — der Regelkreis ist geschlossen (`R105` führt vom Dreieck zurück auf den Komparator-Eingang). Jetzt der Filter:

- *Werkzeug: Bash* — Verify filter A branch wiring

**🤖 Claude:**

Filter verifiziert: Ebene A schaltet den Eingang, Ebene B den Ausgang, alle vier Zweige beidseitig getrennt — und die Gegenkopplung `RV403` liegt jetzt am **−**-Eingang. Jetzt die optische Kontrolle:

- *Werkzeug: Bash* — Export SVG/PDF/BOM and set up preview
- *Werkzeug: mcp__Claude_Browser__preview_start* — 
- *Werkzeug: mcp__Claude_Browser__browser_batch* — 
- *Werkzeug: mcp__Claude_Browser__browser_batch* — 

**🤖 Claude:**

Elektrisch stimmt es. Ein paar Beschriftungen überlappen noch — die räume ich auf:

- *Werkzeug: Bash* — Declutter labels and re-render
- *Werkzeug: mcp__Claude_Browser__browser_batch* — 
- *Werkzeug: Bash* — Raise horizontal part labels and re-render
- *Werkzeug: mcp__Claude_Browser__browser_batch* — 

**🤖 Claude:**

Filter liest sich sauber. Zwei letzte Beschriftungskorrekturen, dann die Dokumentation:

- *Werkzeug: Bash* — Final rebuild with all outputs

**🤖 Claude:**

Beim Durchrechnen der Pegel fallen mir zwei echte Probleme auf: das Rechteck käme mit 21 Vss aus dem LM324 und würde die Ausgangsstufe übersteuern, und der Sägezahn liefert nur ~1 Vss. Beides muss angeglichen werden:

- *Werkzeug: Bash* — Add sawtooth gain stage and square divider
- *Werkzeug: Bash* — Repair literals and rebuild
- *Werkzeug: Bash* — Verify the new sawtooth gain and square divider nets

**🤖 Claude:**

Alles verifiziert. Finale Ausgabe und optische Schlusskontrolle:

- *Werkzeug: Bash* — Final export and BOM totals
- *Werkzeug: mcp__Claude_Browser__browser_batch* — 

**🤖 Claude:**

Eine letzte Kollision, dann die Dokumentation:

- *Werkzeug: Bash* — Final fix, rebuild, export, clean up
- *Werkzeug: mcp__Claude_Browser__preview_stop* — 
- *Werkzeug: Write* — C:\Users\<user>\Downloads\MaturaProjekt\SynthesizerFinal\README.md
- *Werkzeug: Bash* — Final netlist verification
- *Werkzeug: Bash* — Correct README figures
- *Werkzeug: SendUserFile* — 
- *Werkzeug: Write* — C:\Users\<user>\.claude\projects\C--Users-<user>-Downloads-MaturaProjekt\memory\synth-gesamtschaltplan.md

**🤖 Claude:**

Fertig. Ein Schaltplan, [SynthesizerFinal/](SynthesizerFinal), ERC **0 Fehler / 0 Warnungen**, Netzliste knotenweise nachgeprüft.

**Punkte 1–3 erledigt:** Ausgangsbuchse entdreht (Tip = Signal), Gegenkopplung des Filterverstärkers auf den −-Eingang gelegt, Kern und Ausgangsstufe verbunden.

**Deine Reglerliste — Kontrolle:** Wellenform und Mixer-Pegel waren schon da. Frequenz gab es nur für den Sägezahn, Amplitude gar nicht, Cutoff gar nicht — alle drei sind jetzt drin. Der Frequenzknopf ist ein 2-fach-Gleichlaufpoti (dein ToDo „Frequency Regulators kombinieren"), ca. 95 Hz – 9,6 kHz.

**Beim Rechnen kamen vier Sachen hoch, die ich nicht vorhergesehen hatte:**

1. **U2 (74LVC2G17) ist ein 1,65–5,5 V-Baustein.** In Rev. 1 hing er an +12 V und der Sägezahn lud seinen Eingang direkt aus +12 V — das hätte ihn zerstört. Jetzt gibt es eine +5 V-Schiene (78L05).
2. **Der Oszillatorkern liess sich nicht über Werte reparieren.** U1A schwang eigenständig, U1B/U1C integrierten nur nach — die Amplitude eines Integrators ist ∝ 1/f, das Dreieck hätte bei 95 Hz über 300 V gewollt und wäre bei 9 kHz auf 3 V geschrumpft. Ich habe Komparator und Integrator in einen Regelkreis gelegt (Standard-Funktionsgenerator) und den Sinus über einen Dioden-Former statt zweite Integration gemacht. **Das ist der grösste Eingriff in deinen Entwurf** — steht in Abschnitt 3.4 der Doku begründet, falls du es anders willst.
3. **Das Rechteck kam mit 21 Vss** aus dem LM324 und hätte die Ausgangsstufe in die Begrenzung getrieben; der Sägezahn lieferte nur ~1 Vss. Beide sind jetzt auf ~7 Vss angeglichen, damit ein Wellenformwechsel keinen Lautstärkesprung macht.
4. **Der Sägezahnknoten war hochohmig** und wäre von der nächsten Stufe zusammengezogen worden — jetzt gepuffert.

**Die Werteliste** steht komplett in Abschnitt 2 der [README](SynthesizerFinal/README.md): 30 Zeilen für den Oszillator mit alt → neu und Begründung, plus die Filterwerte (dort war im Original kein einziger gesetzt).

Zwei Dinge zum Nachprüfen vor dem Aufbau: die 33/68 mH-Drosseln sind die teuersten und toleranzbehaftetsten Teile, und der Gleichlauf der Frequenzpotis stimmt nur auf ~15 % — Sägezahn und Funktionsgenerator folgen unterschiedlichen Zeitgesetzen. Für einen Knopf pro Oszillator reicht es, exakt ginge nur mit zwei getrennten Reglern.

---
### 🧑 Nutzer · 2026-09-09 18:21 UTC

Öffne den Plan in KiCad damit ich ihn anschauen kann

- *Werkzeug: PowerShell* — Locate KiCad and Eeschema executables
- *Werkzeug: PowerShell* — Open the schematic in Eeschema

**🤖 Claude:**

Eeschema läuft, der Plan ist offen (Fenster „SynthesizerFinal — Schematic Editor").

Ein paar Hinweise zum Anschauen:

- **Ganze Seite:** `Ansicht → Zoom auf Seite` bzw. Taste `Home` — das Blatt ist 834 × 825 mm, beim Öffnen siehst du sonst nur einen Ausschnitt.
- **Aufteilung:** links die drei Oszillatoren (je acht beschriftete Teilblöcke A–G), Mitte Mixer und die vier Filter, rechts Endstufe, IC-Versorgung und Netzteil.
- **Netznamen verfolgen:** Die Blöcke sind über Netznamen statt langer Leitungen verbunden (`OSC1_TRI`, `OSC1_WAVE` …). Ein Klick auf ein Netz hebt es hervor; mit `Bearbeiten → Suchen` springst du direkt zu einem Namen.
- **ERC nachvollziehen:** `Werkzeuge → Electrical Rules Checker` → sollte 0/0 melden.

Falls dir Beschriftungen zu dicht stehen: einfach anklicken und mit `M` verschieben — das ändert nichts an den Netzen.

---
### 🧑 Nutzer · 2026-09-09 18:27 UTC

Ok aber der Schaltplan ist immer noch nicht wie ich es wollte. Im moment hast du die Oszillatoren, Filter und so weiter als einzelne Bau-Schaltpläne. Ich will jedoch einen einzelen vollstänging verbunden Schaltkreis der alle unsere bis jetzigen Bau-Schaltpläne enthält. Verstehst du was ich meine? Also nicht mehr alles seperat, sondern ein einzelner verbundener Schaltplan. Das habe ich eigentlich mit "finalem Schaltplan gemeint".

**🤖 Claude:**

Ja, jetzt verstehe ich — du willst die Blöcke **mit echten Leitungen verbunden** sehen, nicht über Netznamen. Im Moment ist jeder Block eine Insel, und `OSC1_TRI` usw. verbinden sie unsichtbar. Man kann das Signal nicht mit dem Finger verfolgen.

Ich zeichne die Verbindungen aus. Zuerst prüfe ich, wie gross ein KiCad-Blatt sein darf — das bestimmt die Anordnung:

- *Werkzeug: Bash* — Test KiCad maximum page size

**🤖 Claude:**

KiCad nimmt auch grosse Blätter. Jetzt die Blockgrössen, damit ich die Kette planen kann:

- *Werkzeug: Bash* — Measure block sizes and port positions

**🤖 Claude:**

Alle Ports sind bekannt. Zwei Blöcke muss ich umdrehen, damit alles links→rechts fliesst, und die Dreieck-Rückführung wird blockintern verdrahtet:

- *Werkzeug: Bash* — Reorient waveselect, internalize feedback

**🤖 Claude:**

Alle Blöcke fliessen jetzt links→rechts. Jetzt die Verdrahtung — die Netznamen werden durch echte Leitungen ersetzt:

- *Werkzeug: Write* — C:\Users\<user>\AppData\Local\Temp\claude\C--Users-<user>-Downloads-MaturaProjekt\1fea6b0a-24cf-402c-9ea6-93644efb6f1b\scratchpad\assemble3.py
- *Werkzeug: Bash* — Build the fully wired version and run ERC

**🤖 Claude:**

0 Fehler — nur meine Leitungs-Korridore liegen nicht auf dem 1,27-mm-Raster:

- *Werkzeug: Bash* — Snap routing to grid and re-check

**🤖 Claude:**

ERC 0/0. Jetzt der entscheidende Test: die Verdrahtung muss **elektrisch identisch** zur geprüften Version sein — nur eben gezeichnet statt benannt:

- *Werkzeug: Bash* — Compare netlists: wired version vs verified label version

**🤖 Claude:**

228 Netze auf beiden Seiten, und der einzige Unterschied ist die Pin-Nummerierung des Koppelkondensators `C_03` — der ist gespiegelt, weil ich den Wellenformschalter gedreht habe. Da ist ein **gepolter** Elko an einer Stelle ohne definierte Gleichspannung; ich mache beide Koppelkondensatoren ungepolt, dann ist die Frage erledigt:

- *Werkzeug: Bash* — Non-polarized coupling caps, rebuild, render
- *Werkzeug: mcp__Claude_Browser__preview_start* — 
- *Werkzeug: mcp__Claude_Browser__browser_batch* — 

**🤖 Claude:**

Das sieht jetzt aus wie **ein** Schaltkreis. Lass mich die Verdrahtung im Detail prüfen — ob Leitungen durch Bauteile laufen:

- *Werkzeug: mcp__Claude_Browser__browser_batch* — 
- *Werkzeug: mcp__Claude_Browser__browser_batch* — 

**🤖 Claude:**

Sauber verdrahtet, keine Leitung läuft durch ein Bauteil — und die Netzlisten-Gegenprobe beweist das auch elektrisch (228 = 228 identische Netze).

Eine Verbesserung: ich setze die Netznamen **zusätzlich** auf die Leitungen. Die Verbindung bleibt gezeichnet, aber du kannst in Eeschema weiterhin nach `OSC1_TRI` suchen:

- *Werkzeug: Bash* — Name the routed nets on the wires
- *Werkzeug: Bash* — Verify netlist is unchanged after naming
- *Werkzeug: Bash* — Confirm electrical equivalence

**🤖 Claude:**

Elektrisch identisch zur geprüften Version. Jetzt die Ausgaben und die Doku:

- *Werkzeug: Bash* — Export PDF/BOM, update README, clean up
- *Werkzeug: mcp__Claude_Browser__preview_stop* — 
- *Werkzeug: PowerShell* — Reopen the updated schematic in Eeschema
- *Werkzeug: SendUserFile* — 

**🤖 Claude:**

Jetzt hast du es richtig verstanden gehabt — ich nicht. Eeschema ist neu geladen (Rev. 3), drück `Home` für die ganze Seite.

**Was jetzt anders ist:** Die Baugruppen sind nicht mehr nebeneinandergestellte Inseln, sondern mit echten Leitungen verbunden. Du kannst den Weg mit dem Finger verfolgen:

- Jeder Block hat Eingänge links, Ausgänge rechts, und die Blöcke stehen in Signalrichtung.
- In jedem Oszillator laufen Sägezahn, Rechteck, Dreieck und Sinus als vier Leitungen in den Wellenformschalter zusammen, dann weiter durch Distortion → Filter-Port → Ausgangsstufe.
- Die drei Oszillatorausgänge laufen rechts hinunter in den Mixer; dessen Ausgang führt unterhalb der Oszillatoren nach links zu Filter A → Filter B → LM386 → Lautsprecher.
- Die Dreieck-Rückführung im Funktionsgenerator ist jetzt blockintern um den Verstärker herum gezeichnet statt über einen Netznamen.

Die Netznamen stehen **zusätzlich** auf den Leitungen — die Verbindung ist gezeichnet, aber du kannst in Eeschema trotzdem nach `OSC1_TRI` oder `MIX_OUT` suchen.

**Zwei Dinge habe ich bewusst nicht als Leitung gezeichnet:**
1. **Versorgung und Masse** bleiben Spannungssymbole (+12 V, −12 V, +5 V, GND). Allein Masse hat 112 Anschlusspunkte — als Leitungen wäre der Plan unlesbar. Das macht jeder Schaltplan so.
2. **Die Solo-Filter C und D** hängen an Klinkenbuchsen, weil sie im Gerät tatsächlich per Kabel eingeschleift werden und nicht fest verdrahtet sind.

Falls du eines von beiden trotzdem ausgezeichnet haben willst, sag Bescheid.

**Kontrolle:** ERC 0 Fehler / 0 Warnungen, und ich habe die Netzliste Netz für Netz gegen die vorher geprüfte Version verglichen — **228 = 228, identisch**. Die Umverdrahtung hat elektrisch nichts verändert, nur sichtbar gemacht. (Nebenbei sind die zwei Koppelkondensatoren im Oszillator jetzt ungepolt statt Elko — an der Stelle liegt keine definierte Gleichspannung an.)
