lukimcfly/MaturaProjekt/KI-Protokolle/2026-09-09_dde0fce2.md

# Sitzung dde0fce2

- Sitzungs-ID: `dde0fce2-516f-4a8c-b976-b3142dbb4919`
- Zeitraum: 2026-09-09 bis 2026-09-09
- Modell(e): claude-opus-5
- Nutzer-Prompts: 2

> Lesbare Fassung: Prompts und Antworten im Wortlaut, Werkzeugaufrufe nur als Kurzzeile, Werkzeug-Ausgaben weggelassen.

---
### 🧑 Nutzer · 2026-09-09 12:30 UTC

Two real bugs, and one that just makes it sound bad.
1. The mixer node is DC-connected to the base. This is the big one. Since the wiper of each pot has a DC path to ground through the pot's lower half, your three pots sit in parallel with the 10k bias resistor. At mid-travel that's 5k per channel, 1.67k for all three, in parallel with 10k → about 1.4k. Your base voltage becomes
12 V × 1.4k / (47k + 1.4k) ≈ 0.35 V
which is under V_BE, so the transistor is essentially cut off. Worse, the value changes as you move the knobs: pots fully up gives ~0.6 V, fully down shorts the base to ground and kills the stage completely. That's the cursed behaviour — the volume knobs are also bias knobs.
Fix: put a coupling cap (10 µF, + toward the base) between the mixer node and the base.
2. The three wipers are tied directly together. Passive summing with no isolation means each channel's wiper is loaded by the other two, so the pots interact: turning one channel up pulls the others down, and none of them are independent. Put a series resistor (10k–47k) between each wiper and the summing node. You lose some level, but the amp has plenty of gain. The proper answer is an op-amp virtual-earth summer, which gives you real channel independence and unity control per input — worth doing if you have a spare op-amp, since you're already on op-amps for the square oscillator.
3. The gain is absurd, so anything that survives the above will clip. With the 100 Ω emitter resistor fully bypassed by 470 µF, r_e ≈ 26 mV / I_E ≈ 2 Ω, so A_v ≈ 330 / 2 ≈ 170. Split the emitter resistor: 10 Ω unbypassed in series with 90 Ω bypassed. Gain drops to ~28 and the distortion goes with it. The flat-topped, notched traces on your scope are this plus problem 1.
Two smaller things: 330 nF into 10k puts your high-pass corner at ~48 Hz, which is right on top of your 60 Hz test tone — you're getting amplitude loss and phase shift before the signal even reaches the mixer. Use 1 µF or larger. And the base input impedance of a bypassed common-emitter stage is only a couple of kΩ and varies with signal level, which loads a passive mixer non-linearly; the summing resistors help, but an emitter follower or op-amp buffer between mixer and amp is the clean solution.
Fix 1 first on its own and see how much of the weirdness disappears — I'd guess most of it.
Ok could you create the fixed circuit visually? So that i can follow your schematic, to draw it in my simulator to see if it works.
Here's the corrected schematic. Teal parts are what's new or changed.
V
visualize
V
visualize show_widget
Wiring notes for redrawing it in the sim:

* The pots stay as you had them — signal into one end, other end to ground, wiper is the output. The only change on that side is the 22k in series with each wiper before the shared bus.
* The 10 µF and 47 µF are polarised in a real build; positive terminal toward the base and toward the collector respectively, since those nodes sit at a higher DC potential than what's on the other side. In the simulator polarity doesn't matter, but get it right in KiCad.
* The emitter split is one node: emitter → 10 Ω → node A → 90 Ω → ground, with the 470 µF from node A to ground. Node A is the junction, not the emitter itself.

What you should see after this: bias sitting near V_B = 2.1 V, V_E = 1.4 V, I_E ≈ 14 mA, collector idling around 7.4 V, and it should stay there no matter where the knobs are. If the collector doesn't sit near 7.4 V, the coupling cap isn't doing its job and something still has a DC path to the base.
If it's still clipping at full input, raise the unbypassed emitter resistor from 10 Ω to 22 Ω — that halves the gain again. And check what your three oscillators actually put out; if the square wave is several volts peak-to-peak you'll want the summing resistors larger on that channel (47k or 100k) so it doesn't dominate the mix.
It's not working. There is basicely only a square-wave. When i changed the resistors, the final wave-form doesnt change at all for some reason. 
Please help again. Btw if you want to, you can use my computer. The simulator is opened in the website in my opera browser. 
Im using the falstad circuit simulator.
Two separate things are going on, and one of them isn't a circuit problem at all.
The scope is on the ground symbol, not the load. The label reads `ground` and `Max=0 V` — the green flat line is that node's voltage, which is 0 by definition, and the yellow trace is the current through that ground connection. Falstad auto-scales every scope to fit, so when you change a resistor the amplitude changes but the drawing rescales to the same height. That's exactly your "doesn't change at all". Right-click the 1k resistor itself → View in New Scope, then right-click the scope → turn off auto-scale (Manual Scale) and set a fixed range. Now you'll see real volts.
The supply is +5 V but the bias network is still the 12 V one. With 47k/10k from 5 V:
V_B = 5 × 10/57 = 0.88 V → V_E = 0.23 V → I_E = 2.3 mA → V_C = 5 − 0.76 = 4.24 V
The collector idles 0.76 V below the rail and 3.8 V above the emitter. It can swing down a long way and almost nothing up, so the positive half of every waveform slams into the rail while the negative half survives — everything comes out looking square-ish regardless of what went in. Gain is still ~330/21 ≈ 16, so a few hundred mV at the base is already more than the stage can produce.
Easiest fix: put the rail back to +12 V and leave everything else. That's what the values were designed around.
If you want to stay at 5 V, rescale the stage: 47k/22k divider, collector 680 Ω, emitter 33 Ω unbypassed + 300 Ω bypassed. That gives V_B = 1.59 V, V_E = 0.94 V, I_E = 2.85 mA, V_C = 3.06 V — roughly centred, with about 2 V of swing each way and a gain of ~16.
Then turn the pots down. All three Falstad sources default to 5 V amplitude; even after the 22k summing network you're delivering a few hundred mV to the base, which is over the top for a gain-of-16 stage. Start with the pots near 10–20% and bring them up until it just starts to flatten, then back off.
One debugging tip: set the three oscillators to different frequencies — say 110 Hz, 160 Hz and 230 Hz instead of all 60 Hz. Right now they're all the same frequency so the sum is one repeating composite and you can't tell which channel is contributing what. With different frequencies you can see each one appear and disappear as you move its pot.
On using your computer: I can only drive Chrome, through the Claude for Chrome extension — Opera won't work even though it's Chromium underneath. If you open the Falstad sim in Chrome with the extension connected, I'm happy to go in and adjust the values and scope settings directly.

We'll continue the Session in this Session pls.

ait we'll work in Claude browser:
https://falstad.com/circuit/circuitjs.html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

I mean it kind of works. But when all wave-signals are the same frequency, i can't really see the waveform, which should be created when combined for example the square and sine (/AC) waveforms.

**🤖 Claude:**

I'll open your circuit in the browser and look at it.

- *Werkzeug: mcp__Claude_Browser__navigate* — https://falstad.com/circuit/circuitjs.html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
- *Werkzeug: mcp__Claude_Browser__computer* — 
- *Werkzeug: mcp__Claude_Browser__computer* — 

**🤖 Claude:**

Good news: it's actually working now. Let me make the scope big enough to actually read.

- *Werkzeug: mcp__Claude_Browser__computer* — 
- *Werkzeug: mcp__Claude_Browser__browser_batch* — 
- *Werkzeug: mcp__Claude_Browser__browser_batch* — 
- *Werkzeug: mcp__Claude_Browser__browser_batch* — 
- *Werkzeug: mcp__Claude_Browser__browser_batch* — 
- *Werkzeug: mcp__Claude_Browser__browser_batch* — 
- *Werkzeug: mcp__Claude_Browser__browser_batch* — 
- *Werkzeug: mcp__Claude_Browser__browser_batch* — 

**🤖 Claude:**

Now it's readable. Let me test your actual question — set all three to the same frequency.

- *Werkzeug: mcp__Claude_Browser__browser_batch* — 

**🤖 Claude:**

Found something important — that square wave source is set to **169.7 V** peak, not 5 V.

- *Werkzeug: mcp__Claude_Browser__browser_batch* — 
- *Werkzeug: mcp__Claude_Browser__browser_batch* — 
- *Werkzeug: mcp__Claude_Browser__browser_batch* — 
- *Werkzeug: mcp__Claude_Browser__browser_batch* — 
- *Werkzeug: mcp__Claude_Browser__browser_batch* — 

**🤖 Claude:**

Output dropped to 69 mV — let me check the transistor's operating point.

- *Werkzeug: mcp__Claude_Browser__browser_batch* — 

**🤖 Claude:**

Let me pull the netlist so I can check exact values.

- *Werkzeug: mcp__Claude_Browser__browser_batch* — 
- *Werkzeug: mcp__Claude_Browser__browser_batch* — 
- *Werkzeug: mcp__Claude_Browser__browser_batch* — 

**🤖 Claude:**

Found it. Let me set the pot sliders properly.

- *Werkzeug: mcp__Claude_Browser__browser_batch* — 
- *Werkzeug: mcp__Claude_Browser__browser_batch* — 
- *Werkzeug: mcp__Claude_Browser__browser_batch* — 
- *Werkzeug: mcp__Claude_Browser__browser_batch* — 

**🤖 Claude:**

Now the real answer to your question — let me set all three to the same frequency.

- *Werkzeug: mcp__Claude_Browser__browser_batch* — 
- *Werkzeug: mcp__Claude_Browser__browser_batch* — 
- *Werkzeug: mcp__Claude_Browser__browser_batch* — 
- *Werkzeug: mcp__Claude_Browser__browser_batch* — 
- *Werkzeug: mcp__Claude_Browser__browser_batch* — 
- *Werkzeug: mcp__Claude_Browser__browser_batch* — 
- *Werkzeug: mcp__Claude_Browser__browser_batch* — 

**🤖 Claude:**

It works now. Let me grab you a link to this fixed state.

- *Werkzeug: mcp__Claude_Browser__browser_batch* — 
- *Werkzeug: mcp__Claude_Browser__javascript_tool* — 
- *Werkzeug: mcp__Claude_Browser__browser_batch* — 

**🤖 Claude:**

Found it — two things, and neither was the topology.

## 1. Your sources are at mains voltage, not 5 V

Falstad's default for AC/square/sawtooth sources is **120 V rms**. When I opened them:

| Channel | Was | Now |
|---|---|---|
| Square | **169.7 V** peak | 5 V |
| Sawtooth | **98 V rms** | 5 V |
| Sine | **120 V rms** (169.7 V peak) | 5 V |

## 2. Your pots were at 0.5 %, not 50 %

This is the sneaky one. The `50` printed next to each pot is **R2 = 50 Ω**, not "50 percent". With a 10 k pot that's the wiper sitting essentially on the ground end — every channel attenuated 200:1.

Those two errors partly cancelled: 170 V × 1/200 ≈ 0.85 V of square got through and swamped everything, while the other two channels contributed nothing measurable. That's exactly your "basically only a square wave". I set the sliders on the right to about 14 % (8.6 k / 1.4 k) — those three "Resistance" sliders in the right-hand panel *are* your volume knobs.

## 3. The scope was autoscaling (the "nothing changes" thing)

Set it to Manual, 1 V/div, 8 divisions, 2 ms/div. Now a resistor change actually moves the trace.

## Your question: same-frequency mixing

It works — I set all three to 200 Hz. You get one stable repeating period where you can read each contributor: the sawtooth ramp, the square's vertical step, and the sine's curvature between them. Output is 1.68 V peak, no clipping.

The two things that were hiding it: at 10 ms/div you were looking at 30+ cycles smeared into a band, and only one channel had any level. Rule of thumb — set ms/div so you see **2–3 periods**, no more.

Here's the working state: [fixed circuit](https://falstad.com/circuit/circuitjs.html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) — all three at 200 Hz, 5 V, pots at 14 %, scope configured.

## One thing I'd still change

The bias is running lower than the design target. Measured: Ic = 7.95 mA, Vbe = 649 mV, Vce = 8.58 V → V_E = 0.80 V, V_B = **1.45 V**, V_C = 9.38 V.

I said 2.1 V earlier, which ignored base current. At 79.5 µA through the 8.2 k Thevenin resistance of the divider you lose 0.65 V, so V_B lands at 1.45 V. The consequence: the collector can swing 8.6 V down but only 2.6 V up — asymmetric, so it clips on positive peaks first. **Change the 47 k to 33 k** and you get I_C ≈ 12 mA, V_C ≈ 8.0 V, which is better balanced. Not urgent at these levels, but it's why the headroom feels one-sided.

---
### 🧑 Nutzer · 2026-09-09 12:42 UTC

good. I now set the max voltages of the signal input sources to 1v from 5v, because it hits the powerrail/ in the scoupe i can see it getting cut off in height at some point. With 1v it doesnt get cut off. Is that fine?

- *Werkzeug: mcp__Claude_Browser__computer* — 

**🤖 Claude:**

Yes, that's fine — but it's worth being clear about *what* you actually changed, because it matters for the real build.

**Electrically, lowering the source from 5 V to 1 V and turning the pot down to 20 % are the same thing.** Both just reduce how many millivolts arrive at the base. The stage doesn't know which one you did.

What you've ended up with is actually a good place to be. Looking at the sim right now: channels 1 and 3 are at full (`50 / 10k`), channel 2 is at zero (`10k / 50`), and the output is 1.74 V peak, clean. So **knob fully up = maximum clean output**. That's exactly how a mixer channel should be scaled — you want the top of the knob's travel to be the edge of clipping, not somewhere in the middle where 80 % of the rotation is useless.

Two things to keep in mind:

**Your real oscillators won't be 1 V.** In the simulator you can just type a number. On the breadboard, whatever your square/saw/sine circuits put out is fixed — and if the square oscillator is an op-amp on ±12 V rails, that's ~20 V p-p, twenty times what you're simulating. The attenuation has to live somewhere in the circuit. So: measure what each oscillator actually produces, then size the summing resistor per channel to bring it down. A hot channel might need 100 k where a quiet one needs 22 k.

**All three channels up will be ~50 % louder than what you're seeing.** Right now only two are contributing. Turn on the sawtooth and check it still doesn't clip before you call the levels final.

**And the clipping was one-sided.** Look back at where it flattened — it was the top of the wave hitting the rail, not both ends. That's the bias asymmetry from last time: V_C sits at 9.38 V, so there's 8.6 V of room downward but only 2.6 V upward. Swapping the 47 k for 33 k moves V_C to about 8.0 V and roughly doubles how much clean output you get before the top flattens. Worth doing, since it means you can run the sources higher and get a healthier signal for the Fourier analysis later.
