lukimcfly/MaturaProjekt/KI-Protokolle/2026-09-11_c1dcfd51.md

# Sitzung c1dcfd51

- Sitzungs-ID: `c1dcfd51-b65a-4db6-aa36-06bad855a632`
- Zeitraum: 2026-09-11 bis 2026-09-11
- Modell(e): claude-opus-5
- Nutzer-Prompts: 2

> Lesbare Fassung: Prompts und Antworten im Wortlaut, Werkzeugaufrufe nur als Kurzzeile, Werkzeug-Ausgaben weggelassen.

---
### 🧑 Nutzer · 2026-09-11 09:48 UTC

ok lowkey can you setup the whole thing as a github project. That way I and my friend can work simultaneously. I'll do the authenticantion etc if you need them (probably), so open it in the browser where i can directly do that part.

- *Werkzeug: PowerShell* — Inspect project, git/gh availability
- *Werkzeug: PowerShell* — List large files and extensions
- *Werkzeug: Write* — C:\Users\<user>\Downloads\MaturaProjekt\.gitignore
- *Werkzeug: Write* — C:\Users\<user>\Downloads\MaturaProjekt\.gitattributes
- *Werkzeug: PowerShell* — Init repo and make first commit
- *Werkzeug: mcp__Claude_Browser__navigate* — https://github.com/new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

**🤖 Claude:**

I've set up the local side, and GitHub's "create repository" page is open in the browser pane.

**Done so far:**
- Turned `MaturaProjekt/` into a git repo on the `main` branch.
- Added a [.gitignore](.gitignore) that skips KiCad lock and backup files, Word temp files and Windows clutter. The `.lck` file currently in the folder is already skipped.
- Added a [.gitattributes](.gitattributes) so images, videos, PDFs and .docx files are treated as binary.
- Made the first commit with all 26 files (about 30 MB). The largest is the 27.5 MB Falstad video, which is under GitHub's 100 MB limit.

**Your part in the browser:**
1. Sign in to GitHub.
2. The form should already be filled in with the name `MaturaProjekt`, set to **private**, with a description. Leave "Add README", ".gitignore" and "license" **unticked**, because the repo already has them. Click **Create repository**.
3. Paste me the repo URL, like `https://github.com/<you>/MaturaProjekt`.

Then I'll push the files. Git Credential Manager will open a sign-in window once; just approve it there.

**After that, to add your friend:** go to the repo → Settings → Collaborators → Add people. They accept the invite and can clone it.

**One thing to know about working at the same time:** KiCad schematic files (`.kicad_sch`) and `.docx` files can't really be merged if you both edit the same one. So don't both edit the same schematic or the Logbuch at once. Markdown files like the diary entries merge fine.

---
### 🧑 Nutzer · 2026-09-11 10:14 UTC

https://github.com/[GitHub-Nutzer]/MaturaProjekt

- *Werkzeug: PowerShell* — Add remote and push main
- *Werkzeug: mcp__Claude_Browser__navigate* — https://github.com/[GitHub-Nutzer]/MaturaProjekt/settings/access
- *Werkzeug: mcp__Claude_Browser__navigate* — https://github.com/login?return_to=%2F[GitHub-Nutzer]%2FMaturaProjekt%2Fsettings%2Faccess

**🤖 Claude:**

Everything is now on GitHub at https://github.com/[GitHub-Nutzer]/MaturaProjekt, and the push went through without errors.

**To add your friend:** the browser pane is showing a GitHub sign-in page. It isn't logged in, which is why the repo's settings page first showed "Page not found" (private repos look like that when you're signed out). Once you sign in, it goes to **Settings → Collaborators → Add people**. Enter your friend's GitHub username and they'll get an invite by email.

**For your friend, once they've accepted:**
```bash
git clone https://github.com/[GitHub-Nutzer]/MaturaProjekt.git
```

**How you both work day to day:**
1. **Before you start:** run `git pull` to get the other person's changes.
2. **After you've worked:** run `git add -A`, then `git commit -m "what you did"`, then `git push`.
3. If `git push` is rejected, the other person pushed first. Run `git pull`, then push again.

Don't both edit the same `.kicad_sch` file or the Logbuch `.docx` at the same time, because git can't merge those. Separate diary files per day merge fine.

If you'd rather click than type, GitHub Desktop or VS Code's Source Control panel do the same pull/commit/push steps. I can also just do the commit and push for you after each session.
