lukimcfly/MaturaProjekt/KI-Protokolle/2026-10-21_9a1cd49d.md

# GitHub sync check

- Sitzungs-ID: `9a1cd49d-4fd4-46bd-8854-9a24f8ae14c3`
- Zeitraum: 2026-10-21 bis 2026-10-21
- Modell(e): claude-opus-5-5
- Nutzer-Prompts: 8

> Lesbare Fassung: Prompts und Antworten im Wortlaut, Werkzeugaufrufe nur als Kurzzeile, Werkzeug-Ausgaben weggelassen.

---
### 🧑 Nutzer · 2026-10-21 11:23 UTC

@"C:\Users\<user>\Downloads\Merkblatt_Schriftlicher_Kommentar (2).pdf" @"C:\Users\<user>\Downloads\Literaturangaben 2024 (2).pdf" @"C:\Users\<user>\Downloads\Checkliste wissenschaftliche Maturaarbeiten (2).pdf" @"C:\Users\<user>\Downloads\2025_zitierregeln (1).pdf" @"C:\Users\<user>\Downloads\Verwendung von KI (1).docx" @"C:\Users\<user>\Downloads\Merkblatt_Nachweis_KI.pdf"
See that everything gets synced with github. My friend uploaded some stuff, idk if i yet uploaded all my stuff.

- *Werkzeug: Bash* — Check remote, fetch, and show status

---
### 🧑 Nutzer · 2026-10-21 11:23 UTC

[Request interrupted by user for tool use]

---
### 🧑 Nutzer · 2026-10-21 11:25 UTC

Continue?

- *Werkzeug: Bash* — Show remote and working tree status
- *Werkzeug: Bash* — Fetch and compare local with GitHub
- *Werkzeug: Bash* — Fast-forward to GitHub and list documents in repo
- *Werkzeug: Bash* — Inspect school documents folder and ignore rules
- *Werkzeug: Bash* — Read school documents README

**🤖 Claude:**

Pulled your friend's changes. Now I'm putting the six school documents you attached into `Schul-Unterlagen/` and pushing them.

- *Werkzeug: Bash* — Copy attached school documents into repo folder
- *Werkzeug: Bash* — Update README, commit and push to GitHub

**🤖 Claude:**

Your local copy and GitHub now match.

- **Your friend's changes are in your local copy now.** Their commit ("2/3 PCB Designs done, still WIP") had the PCB designs in `Platinen/`, the scripts in `Werkzeuge/`, new board photos in `Bilder/`, the diary entry for 2026-09-12 and a bigger version of the `SynthesizerFinal` schematic. You had no local changes, so nothing clashed.
- **Your stuff:** besides the six school files you attached, there was nothing of yours that wasn't on GitHub yet. I put the six files in [Schul-Unterlagen/](Schul-Unterlagen/) with cleaned-up names (no "(2)" suffixes), listed them in [the folder's README](Schul-Unterlagen/README.md), and pushed. They're on GitHub now.

**Be careful in KiCad:** it looks like you still have `SynthesizerFinal` open. The file on disk is now your friend's newer schematic. Close it **without saving**, then reopen it. If you save the old version that's still open, you'll overwrite their changes.

---
### 🧑 Nutzer · 2026-10-21 11:34 UTC

1. A question: Can you see my custom created skills (they were made on my pc, so idk if it reached the notebook, probably not, i don't see them), they should be called "/deepen" and "/panel".
2. So to explain the Situation: My friend has uploaded the latest work, but we are basicely done with the pcb plate and circuits, we also ordered the final pcb plate already and its on the way. So the things we need to do now is the question of our project (idk if you have our Maturaproject vertrag or something liket that should it be called), but we kind also have the comparision of a digital and an anolog sound. We should analyze it with fourrier or so, idk how exactly should we do that, but i wouldn't do it so big, since our main work was creating the analog synthesizer (we just needed a question as to why we would create this synthesizer and "understanding/fun" doesnt count for it). But since we don't have yet the pcb plate, we don't have the analog synthesizer and need to wait for it to produce actual sounds, so we can't do it fully yet, but we can at least prepare for it (how we should it, what we even do, and how big should it be (cause we only have 3 weeks left)). The 2. thing we can do is the formal stuff like the "schriftlicher kommentar" and everything that should still be done for the "abgabe". 

So firstly explain th situation where we are, besides the pcb plate done and on the way

- *Werkzeug: Bash* — Look for custom skills and survey project folders
- *Werkzeug: Read* — C:\Users\<user>\.claude\projects\C--Users-<user>-Downloads-MaturaProjekt\memory\matura-projekt-inhalt.md
- *Werkzeug: Bash* — Read plan, materials, diary, sources and skills list
- *Werkzeug: Bash* — Extract text from school PDFs

**🤖 Claude:**

Let me read the key school documents directly.

- *Werkzeug: Read* — C:\Users\<user>\Downloads\MaturaProjekt\Schul-Unterlagen\Merkblatt_Schriftlicher_Kommentar.pdf
- *Werkzeug: Read* — C:\Users\<user>\Downloads\MaturaProjekt\Schul-Unterlagen\Merkblatt_Nachweis_KI.pdf
- *Werkzeug: Read* — C:\Users\<user>\Downloads\MaturaProjekt\Schul-Unterlagen\Checkliste_wissenschaftliche_Maturaarbeiten.pdf
- *Werkzeug: Bash* — Extract text from logbook and KI docx
- *Werkzeug: Bash* — Extract text from logbook and KI docx (UTF-8)
- *Werkzeug: Bash* — Extract text from logbook and KI docx
- *Werkzeug: ToolSearch* — 
- *Werkzeug: mcp__4702f3be-bac4-4925-8f54-6102c1aba1c9__search* — 
- *Werkzeug: mcp__4702f3be-bac4-4925-8f54-6102c1aba1c9__search* — 

**🤖 Claude:**

I've read through the repo and the school documents. Here's where things stand.

## 1. Your skills `/deepen` and `/panel`

They're not on this laptop. Custom skills live on the computer where you made them, in `C:\Users\<you>\.claude\skills\<name>\` (each skill is a folder with a `SKILL.md`). The only skills here are the standard ones the app syncs. To get yours over, copy the `deepen` and `panel` folders from your PC into `C:\Users\<user>\.claude\skills\` on this laptop. Or I can put them in the repo under `.claude/skills/`. Then they'd come along with every `git pull`, and your friend would get them too.

## 2. Where the project stands

**Done:**
- The schematic (`SynthesizerFinal`, revision 4), with no errors in KiCad's electrical check.
- The three board layouts, the files the factory needs to make them, the parts lists and the front-panel wiring table (153 wires). Per your message, the boards are ordered.

**Not done, roughly by urgency:**

1. **The research question.** It isn't written down anywhere. It's not in the repo, and I couldn't find a project agreement in your school mails or files either. Check whether you handed something in at the start. Your written work has to be built around this question: the guidelines want it stated and justified in the introduction and answered in the conclusion. So this comes first.

2. **Building the synth.** Once the boards arrive you still have to solder three oscillator boards, four filter boards and the main board, wire 153 front-panel wires, get a ready-made ±12 V power supply and fix whatever doesn't work. That's real work inside the 3 weeks, and the Fourier measurements depend on it. Are the parts for the boards ordered too, or only the boards themselves?

3. **The Fourier analysis.** Nothing is prepared yet. You're right to keep it small. Much of it can be set up before the synth exists: the method, the digital reference sound and the analysis script.

4. **The written report (schriftlicher Kommentar).** Not started. The school wants **5–15 pages** with a fixed structure:
   - title page and table of contents
   - introduction with the research question
   - research (what is already known)
   - method, including why you built the product the way you did
   - results
   - bibliography and list of figures

   Formatting: 1.5 line spacing, justified text, footnote citations, and it has to be **printed and bound**. Plan a day for that before 10.11.

5. **The official logbook is two months behind.** `Logbuch neu.docx` stops at **19/08/26**. Since then there's only one diary file (12/09). Breadboard testing, finishing the PCBs, ordering and everything else since mid-September isn't documented. You can rebuild a lot of it from the git history and the diary.

6. **Declaring AI use is the biggest risk.** The 12/09 entry says the PCB work was done "mit KI-Unterstützung", and the 40 scripts in `Werkzeuge/` came out of that. The school rules say:
   - Every AI use goes into the logbook with the AI's name and version, the exact prompt, the date and how you used the answer.
   - In the grid "Verwendung von KI" you note the logbook page for each use.
   - In the report, the AI use is written out after the list of figures.
   - **Not declaring it counts as cheating** (the work may have to be redone).
   - Heavy AI use also lowers how much counts as your own work.

   So both of you should dig up the old chats now while they still exist. Write honestly about what you designed yourselves (oscillator idea, choosing the modules, the circuit fixes) and what the AI tooling did. This session counts too.

7. **Sources are thin.** `quellen/` only has YouTube videos. For the research chapter and the citation rules you need a few solid sources: chip datasheets, one or two books or articles on analog synthesis and on Fourier analysis.

Minor: the 12/09 diary entry names your friend, which goes against your no-names rule for the diary. Also, the timeline in `plan/` ended with the autumn holidays and is out of date.

**My suggestion for the order:** decide the research question this week (it decides how big the Fourier part has to be). Then write a new plan for the 20 days until 10.11 that covers building the synth, the Fourier work, the report, catching up the logbook and the AI declaration. I can draft research questions and a small Fourier method next if you want.

---
### 🧑 Nutzer · 2026-10-21 12:09 UTC

@"C:\Users\<user>\Downloads\[Namen]_Logbuch_Maturarbeit (1).docx" @"C:\Users\<user>\Downloads\Quellen (1).docx" @"C:\Users\<user>\Downloads\Zwischenbericht zur Maturaarbeit- Synthesiser.pdf" @"C:\Users\<user>\Downloads\FINAL4_MA_Vertrag_Oscillator (1).docx"
Okay wait i'll send you some more files, idk if the quelle or logbuch are just duplicates or older version or have some missing things, so we need to sync them as well. 
I also sent you the "Vertrag" where you can see what our project exactly is, so i want to estimate how much we should do for the fourrier analyis, comparision between analog and digital.
I also sent you the "Zwischenbericht" that was handed out during "Zwischen Matur", but we only got grade 4 overall. Product was good, bericht and presentation was lacking. That's why we also wanted to start earlier (not on the last day, but 3 weeks before, so that we can actually do it well).

- *Werkzeug: Bash* — Extract text from contract, sources and logbook
- *Werkzeug: Read* — C:\Users\<user>\Downloads\Zwischenbericht zur Maturaarbeit- Synthesiser.pdf
- *Werkzeug: Grep* — (?i)display|oled|lcd|gehäuse

**🤖 Claude:**

Now syncing the four files into the repo.

- *Werkzeug: Bash* — Copy contract, old logbook, feedback and sources into repo

**🤖 Claude:**

Now updating the READMEs and merging the new sources into `lernmaterial.md`.

- *Werkzeug: Bash* — Update READMEs, merge sources, commit and push
- *Werkzeug: Write* — C:\Users\<user>\.claude\projects\C--Users-<user>-Downloads-MaturaProjekt\memory\matura-projekt-inhalt.md
- *Werkzeug: Edit* — C:\Users\<user>\.claude\projects\C--Users-<user>-Downloads-MaturaProjekt\memory\MEMORY.md

**🤖 Claude:**

All four files are now in the repo and on GitHub.

## Which files were new

| File | Duplicate? | Saved as |
|---|---|---|
| Logbook (`[Namen]_Logbuch…`) | **No.** It's the first half of the logbook (11.03.–03.06.2026: contract, low-pass filter, LED blinker, first square wave). `Logbuch neu.docx` only starts on 12.08. | `Unsere-Materialien/Logbuch/Logbuch alt (Maerz-Juni 2026).docx` |
| Quellen | **Mostly new.** Two datasheets, two YouTube videos and two online textbooks weren't in the repo yet. | Original docx in `quellen/`, entries added to `quellen/lernmaterial.md` |
| Vertrag | New | `Unsere-Materialien/Vertrag/` |
| Zwischenbericht | New | `Schul-Unterlagen/` |

For the final hand-in, merge the two logbook halves into one document. There are still gaps: **03.06.–12.08.**, and everything **after 19.08.**

## How big the Fourier part has to be

Your contract settles this. You already have a research question in it: *"Wie können verschiedene analoge Oszillatoren gebaut werden und welche Effekte lassen sich ohne digitale Hilfe erzeugen?"* So the Fourier comparison doesn't have to carry the project. It's a sub-question.

But it's not optional. **Three of the product grading criteria** (the product counts 40%) are about it:
- the comparison was done sensibly and the differences are clearly explained,
- the differences are justified,
- it includes Fourier analyses of the different waves and shows the difference in complexity.

So keep it small, but do it properly. My suggestion:

- **What you measure:** your 3–4 waveforms (sawtooth, square, triangle, "sine") at **one fixed pitch** (e.g. 220 Hz). Each one analog (recorded from the synth) and digital (the same wave generated on the computer). Filter and distortion only as a bonus if there's time.
- **Analysis:** a short Python script that runs a Fourier transform and plots the spectrum. You compare the harmonics with the theory:
  - sawtooth: all harmonics, falling off as 1/n
  - square: odd harmonics only, 1/n
  - triangle: odd harmonics only, falling off faster (1/n²)
- **What you'll probably find:**
  - The analog waves have slightly rounded edges, so the high harmonics drop off faster.
  - Analog pitch drifts slightly and there's some noise.
  - Your "sine" made from the triangle still has odd harmonics in it.
  - The digital waves have exact pitch, but can produce aliasing (wrong extra frequencies above the sampling limit).

  That's the "difference in complexity" the contract asks for, and you can explain why each one happens.
- **Careful with one claim:** the contract says digital "can never recreate" analog sounds. Don't just repeat that. Check it with your measurements and say honestly what the data shows. That's exactly the kind of reflection that gets marked well.
- **In the report:** about 2–3 of the 5–15 pages, with 2–3 figures (waveform plus spectrum, analog next to digital, plus a table of harmonic amplitudes).
- **Effort:** about 8–10 hours total. 4–5 h of prep now, 1–2 h of measuring once the synth works, 2–3 h of writing.
- **What you can prepare now, before the boards arrive:**
  - write the script and test it on any recording (e.g. a phone recording of a tone),
  - create the digital reference waves,
  - write the theory section,
  - decide how you'll record (audio interface or line-in? or the school oscilloscope, maybe with its own FFT function).
- **Backup plan:** if the full synth isn't running in time, measure a single oscillator board.

## What the June feedback means for the next 3 weeks

The feedback lines up with the contract criteria, and the two together are a checklist:

1. **The text looked AI-generated.** Write the report yourselves. I can help with structure, check it against the checklist, and give feedback on your drafts. If I write the text, you'll get the same comment again, plus a problem with the "Eigenleistung" criterion.
2. **Explain the circuits with colored figures:** where current flows, which direction, what is measured where. Same in the presentation.
3. **The Fachgespräch (20%).** They'll ask why your signal looks the way it does, the difference between voltage and current, and what you did yourselves. Given how much AI went into the PCB scripts, you need to be able to explain them and separate your own work from the AI's clearly. The AI declaration in the logbook was already flagged in June. Now it's urgent.
4. **Promised in the contract, not in the design:** a **case**, a **labeled interface**, and a **display that shows the waveform**. The display isn't in the schematic. Either plan a simple version or talk to your supervisor now about changing the contract. Contract changes are allowed if both sides agree.
5. **Strict plan with buffer.** That was a direct ToDo from the feedback.

One more thing: the second page of the Zwischenbericht shows two grade calculations (4.5, and a second one with 5.5). Maybe one of them is from a template, or the two of you got different grades. Worth asking.

Should I write the 20-day plan to 10.11 next (building the synth, Fourier work, report, merging the logbook, AI declaration, case and display), or start with the Fourier prep script?

---
### 🧑 Nutzer · 2026-10-21 12:45 UTC

@"C:\Users\<user>\Downloads\Schriftlicher Kommentar Maturarbeit Synthesizer.pdf"
<!-- reply 2 -->
> The text looked AI-generated.

that was actually annoying, since we actually wrote it ourselves.

<!-- reply -->
> (4.5, and a second one with 5.5). Maybe one of them is from a template, or the two of you got different grades. Worth asking.

no i think the product (the prototype synthesizer) was a 5.5 and the presentation and "Zwischen Schriftlicher Kommentar" was a 4.5.

Okay the Zwischenbericht was the evaluation, i sent you now the "Schriftlicher Kommentar" which we handed out for the Zwischen Matura, so you can directly see what we did there. 

About the AI usage: I think we should explain and note that we used AI for value-calculation in our self designed circuits (which is true). Idk about the pcb, we used AI to design the pcb plate according to our circuits that we had. We used AI for generating the simulations in Kicad, so it could runs some tests (as i heard off, there is no default simulation you can run in kicad, but you need to write some small python programms for each component or so (i hope you can check that and then explain to me shortly how it did that). Trough these simulations it generated data sheets, where the amplifications etc. are all measured (i sent you 2 images of them). Then we used AI to keep things in track, like this current Session. I think the rest was done by ourselves. 

So how should we do exactly the AI usage statement, just answer pls don't write anything yet.

- *Werkzeug: Grep* — (?i)ngspice|spice|\.cir\b|simulat
- *Werkzeug: Read* — C:\Users\<user>\Downloads\Schriftlicher Kommentar Maturarbeit Synthesizer.pdf
- *Werkzeug: Grep* — (?i)ngspice|spice|simulat|falstad
- *Werkzeug: Bash* — Read handoff notes about simulation setup

**🤖 Claude:**

## How the simulation worked

It wasn't one Python program per component. What happened:

1. **The circuit as a text file.** The AI wrote a SPICE netlist (`.cir` file). It lists every part with its value and which nodes it connects to, so it's the schematic written as text.
2. **Models for the chips.** Resistors and capacitors are simple. Op-amps like the LM324 and TL074 need a small replacement circuit (a "macromodel") that copies their datasheet behaviour: maximum gain, how fast the output can change (slew rate), and that the output can't go beyond the supply voltage. The Schmitt trigger needed its own model too. That's what "op-amp macromodels validated against datasheet" in the image means.
3. **ngspice does the calculation.** ngspice is a free circuit simulator. It ran two kinds of analysis:
   - transient: voltage over time, which gives the waveforms in your first image,
   - AC: gain over frequency, which gives the filter curves.
4. **Python only made the charts** from the exported numbers.

So the two images are **simulation reports**, not datasheets. They're numbers calculated from models, not measured on real parts.

Two things to know:
- **Your Zwischen-Kommentar says KiCad has no free simulation. That's wrong.** KiCad has had ngspice built in since version 6. Correct it in the final version, otherwise the teachers notice the contradiction.
- The simulation files (`sim/` and `work/sim/` in `Werkzeuge/HANDOFF.md`) are **not in the repo**. They're probably on your friend's PC. Add them, they're your evidence.

## The important point before the statement

Your summary ("AI did value calculation, PCB, simulation") **undersells it.** The second image and `HANDOFF.md` show the AI also **found design errors and changed the circuit**:
- filters C/D didn't work at all because of a misplaced ground symbol,
- C804 was installed the wrong way round,
- the mixer was clipping,
- LM324 replaced by TL074,
- band-pass filter replaced by a state-variable filter,
- notch filter rebuilt,
- fuses and reverse-polarity protection added,
- levels of the waveforms adjusted to match.

That's not "calculating values", that's checking and redesigning. If the statement doesn't name it, it's **incomplete, and the school counts that as cheating**. If you name it honestly, you only lose some credit for own work, and you get it back by being able to explain each fix.

## How to do the statement (three places, per the school documents)

**1. In the logbook, for each AI use** (Merkblatt Nachweis KI):
- tool and version (e.g. "Claude Code, model Claude Opus 5.5". Your friend's sessions may have used a different model, check those),
- date,
- **the prompt word for word**,
- what you took over, and how.

For long agent sessions like this one, quote the main prompts and add the full chat as an appendix or digital attachment. Sessions in this app can be exported as transcripts.

**2. In the "Verwendung von KI" grid**, with the logbook page for each area:

| Area | What you used AI for |
|---|---|
| Arbeitsplanung & Organisation | Tracking, repo structure, plans (this session) |
| Programmieren & Berechnungen | Value calculations, PCB scripts, simulation netlists, later the Fourier script |
| Untersuchung & Datenerhebung | SPICE simulations |
| Auswertung von Daten | Evaluating the simulations |
| Überprüfung & Kontrolle | Error search in the schematic (the defects above) |
| Hilfsmittel & Werkzeuge | KiCad automation, ngspice, PCB placement and routing |
| Darstellung von Ergebnissen | The charts, if you use them in the report |
| Vorgehen & Methode | Only if you take over my Fourier method suggestion |
| Rückmeldungen | Later, if I give feedback on your drafts |

**3. In the report:**
- a short note right after each section where AI was involved,
- a written-out chapter "Verwendung von KI" after the list of figures: what, why, how you checked it, and a reflection. Reflecting on AI use is its own grading criterion under Arbeitsprozess.

## Three things that make it come out well

- **Draw a clear line between your work and the AI's.** Yours: the concept, the choice of modules, the sawtooth oscillator idea, the breadboard prototypes, assembling and soldering, the measurements, the Fourier analysis, the writing. The AI's: board layout, simulation, error checking and the redesigns listed above. Go through each module and decide whose design it is. The state-variable filter, for example, is probably not yours.
- **Check the simulation against real measurements.** Once the boards are built, measure the actual pitch range, levels and filter curves and compare them with the simulation. That turns "the AI simulated it" into "we checked it against reality", and it's strong material for the Fachgespräch.
- **Talk to your supervisor this week.** The contract requires that AI use is agreed with your supervisor. The feedback already flagged it in June. If you bring the list now, it reads as transparency. If they find it at the hand-in, it reads as hiding something.

On "the text looked AI-generated": that's frustrating when you wrote it yourselves. Probably the general opening ("In einer Welt, in der …") read as generic. What helps: concrete details only you can have, like your own measured values, photos, mistakes and the exact moment something worked. Nobody thinks a text like that came from an AI.

---
### 🧑 Nutzer · 2026-10-21 13:13 UTC

Ok got it. 
Can you explain the whole flow of our synthesizer like how many oscillator we have, filters, when the amplifier comes etc.
Just a short answer psl

- *Werkzeug: Bash* — Read synthesizer overview for signal flow
- *Werkzeug: Bash* — Read signal-chain section of schematic README

**🤖 Claude:**

Here's the signal path from left to right:

```
OSC 1 ┐
OSC 2 ├─► Mixer ─► Filter A ─► Filter B ─► Amplifier (LM386) ─► Speaker
OSC 3 ┘
```

1. **3 oscillators** (all identical). Each one has:
   - a frequency knob, about 95 Hz to 9.6 kHz. It's one double knob that tunes the sawtooth part and the other waveforms together.
   - a waveform switch: sine, triangle, square or sawtooth.
   - its own **distortion** (on/off, soft or hard, and a drive knob).
   - its own volume knob.
2. **Mixer:** combines the three oscillators into one signal, with a level knob for each channel. It's built with a transistor (BC547), not an op-amp.
3. **Filter A, then Filter B,** one after the other. Each filter has:
   - a switch for low-pass, high-pass, band-pass, notch, or bypass (filter off),
   - a cutoff knob, about 106 Hz to 10.6 kHz,
   - a level knob.
4. **Amplifier:** an LM386 chip with the master volume knob. It's the last stage and makes the signal strong enough for the speaker.
5. **Speaker.**

On top of that, there are **Filters C and D**. They're extra filters with their own jack sockets, outside the main path. You plug them in with a cable at one oscillator's filter port, so that oscillator gets filtered on its own before the mixer.

**Power:** a ready-made ±12 V power supply, with fuses and reverse-polarity protection on the main board.

**The 3 boards:** oscillator board ×3, filter board ×4, main board ×1 (mixer, amplifier and power). All knobs and switches sit in the front panel and are connected to the boards with wires.

---
### 🧑 Nutzer · 2026-10-21 13:39 UTC

Ok so i will start writing the Schriftlicher Kommentar a bit (not everything can be written yet, as we have not completely finished it).
My friend generated the Structure for the Kommentar, each containing some explainations about what should be written here like this part:

<pasted_content id="5a5c">
1.3 Eingrenzung des Themas 

✎ Was hier hinein gehört 

–  Was macht ihr bewusst nicht – und warum? Beispiele aus eurem Projekt: 

–  Keine Steuerspannung (CV) / Keyboard-Ansteuerung, kein Hüllkurvengenerator (ADSR), kein LFO – falls zutreffend. Begründung: Zeitbudget, Fokus auf Klangerzeugung. 

–  Netzteil ±12 V fertig gekauft, nicht selbst gebaut (Sicherheit 230 V, Zeit) – steht so im Arbeitstagebuch vom 12.09.2026. 

–  Fourier-Analyse nur für [welche Wellenformen/Frequenzen?] und nur im Vergleich mit [welchem digitalen Synthesizer?]. 

–  Abgleich mit dem Vertrag: Dort sind als Erweiterungen Filter, Envelope Generator, Effekte (Distortion, EQ, Unison) und LFOs genannt, «mind. 2 dieser Erweiterungen werden gemacht». Umgesetzt: Filter und Distortion → Vertrag erfüllt. Envelope, LFO, EQ, Unison bewusst weggelassen – begründen. 

–  Das im Vertrag versprochene Display, das die Wellenform zeigt, ist als separates Arduino-Mini-Oszilloskop (2,2"-Display) umgesetzt – kurz erwähnen und begründen, warum separat statt in der Hauptschaltung (rein analoger Signalweg bleibt unberührt). 

–  Vertrag: Tests auf «Steckbrettern» vor der Platine – falls ihr das (teilweise) übersprungen und direkt Platinen bestellt habt, hier oder in Kap. 3 offen begründen.
</pasted_content id="5a5c">

I now expained what our product is made of, but i hope you can give me an example how i should write it.

**🤖 Claude:**

Here's an example for 1.3. One thing first: the school rules say AI text may be used **as inspiration, but not taken over word for word**. Use this to see how such a section is built, then write your own version. Note this request in the logbook too (date, prompt, "Beispiel als Vorlage für Aufbau verwendet").

---

**Beispiel (1.3 Eingrenzung des Themas):**

> Im Vertrag haben wir neben Oszillatoren, Mixer und Verstärker vier mögliche Erweiterungen genannt, von denen mindestens zwei umgesetzt werden sollten. Wir haben uns für Filter und Distortion entschieden, weil beide den Klang direkt hörbar verändern und sich gut mit der Fourier-Analyse untersuchen lassen. Auf einen Hüllkurvengenerator (ADSR), einen LFO, einen Equalizer und Unison haben wir bewusst verzichtet. Diese Module hätten den Synthesizer zwar vielseitiger gemacht, für die Kernfrage der Arbeit, nämlich wie analoge Oszillatoren aufgebaut sind und klingen, sind sie aber nicht nötig. Mit der verbleibenden Zeit wäre sonst der Aufbau und das Testen der Platinen zu kurz gekommen.
>
> Das Netzteil (±12 V) haben wir fertig gekauft. Ein eigenes Netzteil hätte mit 230 V Netzspannung gearbeitet, was wir aus Sicherheitsgründen nicht selbst bauen wollten.
>
> Das im Vertrag erwähnte Display ist als separates Mini-Oszilloskop mit einem Arduino umgesetzt. Wir haben es absichtlich nicht in die Hauptschaltung eingebaut, da der Signalweg des Synthesizers rein analog bleiben soll. Sonst würde ausgerechnet das Gerät, das wir mit digitalen Synthesizern vergleichen, selbst einen digitalen Teil enthalten.
>
> Die Fourier-Analyse beschränken wir auf [die vier Grundwellenformen bei einer festen Frequenz von 220 Hz] und vergleichen sie mit [denselben Wellenformen, digital erzeugt mit …]. Eine Untersuchung aller Kombinationen aus Filter- und Distortion-Einstellungen hätte den Rahmen der Arbeit gesprengt.

---

**Why it's built this way:**
- **Each paragraph = one decision + the reason.** That's what "Eingrenzung begründen" on the checklist means. The point isn't "we didn't do X", it's *why* that was the right choice.
- **Link it back to the contract and the research question.** That shows the graders the thread running through the work ("roter Faden").
- **The display paragraph turns a possible weak spot into an argument.** It connects the display to your analog-vs-digital comparison.
- **Brackets [ ]** mark things you haven't decided yet. Fill them in once the Fourier method is fixed.
- **Breadboards:** I left that point out because I don't know whether you skipped that step. If you did, add a paragraph saying so openly. That fits better in chapter 3, though, where you describe your working process.

**Tips against the "sounds like AI" impression:**
- Write the way you would explain it to your supervisor. Short sentences, no "In einer Welt, in der …".
- Use concrete details only you know. For example: "Im Juni hat unser Breadboard-Prototyp …" or "Die Platinen kosteten …".
- Be honest about compromises ("wäre zu knapp geworden"). That reads as your own reflection, not as polished AI text.
