lukimcfly/MaturaProjekt/KI-Protokolle/2026-10-21_f8199d6a.md

# btw: you can read my entire prompt meaning for the documenton yo…

- Sitzungs-ID: `f8199d6a-85a1-4c24-8467-5b5cd9bbbef0`
- Zeitraum: 2026-10-21 bis 2026-10-21
- Modell(e): claude-opus-5-5
- Nutzer-Prompts: 5

> Lesbare Fassung: Prompts und Antworten im Wortlaut, Werkzeugaufrufe nur als Kurzzeile, Werkzeug-Ausgaben weggelassen.

---
### 🧑 Nutzer · 2026-10-21 11:23 UTC

@"C:\Users\<user>\Downloads\Merkblatt_Schriftlicher_Kommentar (2).pdf" @"C:\Users\<user>\Downloads\Literaturangaben 2024 (2).pdf" @"C:\Users\<user>\Downloads\Checkliste wissenschaftliche Maturaarbeiten (2).pdf" @"C:\Users\<user>\Downloads\2025_zitierregeln (1).pdf" @"C:\Users\<user>\Downloads\Verwendung von KI (1).docx" @"C:\Users\<user>\Downloads\Merkblatt_Nachweis_KI.pdf"
See that everything gets synced with github. My friend uploaded some stuff, idk if i yet uploaded all my stuff.

- *Werkzeug: Bash* — Check remote, fetch, and show status

---
### 🧑 Nutzer · 2026-10-21 11:23 UTC

[Request interrupted by user for tool use]

---
### 🧑 Nutzer · 2026-10-21 11:25 UTC

Continue?

- *Werkzeug: Bash* — Show remote and working tree status
- *Werkzeug: Bash* — Fetch and compare local with GitHub
- *Werkzeug: Bash* — Fast-forward to GitHub and list documents in repo
- *Werkzeug: Bash* — Inspect school documents folder and ignore rules
- *Werkzeug: Bash* — Read school documents README

**🤖 Claude:**

Pulled your friend's changes. Now I'm putting the six school documents you attached into `Schul-Unterlagen/` and pushing them.

- *Werkzeug: Bash* — Copy attached school documents into repo folder
- *Werkzeug: Bash* — Update README, commit and push to GitHub

**🤖 Claude:**

Your local copy and GitHub now match.

- **Your friend's changes are in your local copy now.** Their commit ("2/3 PCB Designs done, still WIP") had the PCB designs in `Platinen/`, the scripts in `Werkzeuge/`, new board photos in `Bilder/`, the diary entry for 2026-09-12 and a bigger version of the `SynthesizerFinal` schematic. You had no local changes, so nothing clashed.
- **Your stuff:** besides the six school files you attached, there was nothing of yours that wasn't on GitHub yet. I put the six files in [Schul-Unterlagen/](Schul-Unterlagen/) with cleaned-up names (no "(2)" suffixes), listed them in [the folder's README](Schul-Unterlagen/README.md), and pushed. They're on GitHub now.

**Be careful in KiCad:** it looks like you still have `SynthesizerFinal` open. The file on disk is now your friend's newer schematic. Close it **without saving**, then reopen it. If you save the old version that's still open, you'll overwrite their changes.

---
### 🧑 Nutzer · 2026-10-21 11:34 UTC

1. A question: Can you see my custom created skills (they were made on my pc, so idk if it reached the notebook, probably not, i don't see them), they should be called "/deepen" and "/panel".
2. So to explain the Situation: My friend has uploaded the latest work, but we are basicely done with the pcb plate and circuits, we also ordered the final pcb plate already and its on the way. So the things we need to do now is the question of our project (idk if you have our Maturaproject vertrag or something liket that should it be called), but we kind also have the comparision of a digital and an anolog sound. We should analyze it with fourrier or so, idk how exactly should we do that, but i wouldn't do it so big, since our main work was creating the analog synthesizer (we just needed a question as to why we would create this synthesizer and "understanding/fun" doesnt count for it). But since we don't have yet the pcb plate, we don't have the analog synthesizer and need to wait for it to produce actual sounds, so we can't do it fully yet, but we can at least prepare for it (how we should it, what we even do, and how big should it be (cause we only have 3 weeks left)). The 2. thing we can do is the formal stuff like the "schriftlicher kommentar" and everything that should still be done for the "abgabe". 

So firstly explain th situation where we are, besides the pcb plate done and on the way

- *Werkzeug: Bash* — Look for custom skills and survey project folders
- *Werkzeug: Read* — C:\Users\<user>\.claude\projects\C--Users-<user>-Downloads-MaturaProjekt\memory\matura-projekt-inhalt.md
- *Werkzeug: Bash* — Read plan, materials, diary, sources and skills list
- *Werkzeug: Bash* — Extract text from school PDFs

**🤖 Claude:**

Let me read the key school documents directly.

- *Werkzeug: Read* — C:\Users\<user>\Downloads\MaturaProjekt\Schul-Unterlagen\Merkblatt_Schriftlicher_Kommentar.pdf
- *Werkzeug: Read* — C:\Users\<user>\Downloads\MaturaProjekt\Schul-Unterlagen\Merkblatt_Nachweis_KI.pdf
- *Werkzeug: Read* — C:\Users\<user>\Downloads\MaturaProjekt\Schul-Unterlagen\Checkliste_wissenschaftliche_Maturaarbeiten.pdf
- *Werkzeug: Bash* — Extract text from logbook and KI docx
- *Werkzeug: Bash* — Extract text from logbook and KI docx (UTF-8)
- *Werkzeug: Bash* — Extract text from logbook and KI docx
- *Werkzeug: ToolSearch* — 
- *Werkzeug: mcp__4702f3be-bac4-4925-8f54-6102c1aba1c9__search* — 
- *Werkzeug: mcp__4702f3be-bac4-4925-8f54-6102c1aba1c9__search* — 

**🤖 Claude:**

I've read through the repo and the school documents. Here's where things stand.

## 1. Your skills `/deepen` and `/panel`

They're not on this laptop. Custom skills live on the computer where you made them, in `C:\Users\<you>\.claude\skills\<name>\` (each skill is a folder with a `SKILL.md`). The only skills here are the standard ones the app syncs. To get yours over, copy the `deepen` and `panel` folders from your PC into `C:\Users\<user>\.claude\skills\` on this laptop. Or I can put them in the repo under `.claude/skills/`. Then they'd come along with every `git pull`, and your friend would get them too.

## 2. Where the project stands

**Done:**
- The schematic (`SynthesizerFinal`, revision 4), with no errors in KiCad's electrical check.
- The three board layouts, the files the factory needs to make them, the parts lists and the front-panel wiring table (153 wires). Per your message, the boards are ordered.

**Not done, roughly by urgency:**

1. **The research question.** It isn't written down anywhere. It's not in the repo, and I couldn't find a project agreement in your school mails or files either. Check whether you handed something in at the start. Your written work has to be built around this question: the guidelines want it stated and justified in the introduction and answered in the conclusion. So this comes first.

2. **Building the synth.** Once the boards arrive you still have to solder three oscillator boards, four filter boards and the main board, wire 153 front-panel wires, get a ready-made ±12 V power supply and fix whatever doesn't work. That's real work inside the 3 weeks, and the Fourier measurements depend on it. Are the parts for the boards ordered too, or only the boards themselves?

3. **The Fourier analysis.** Nothing is prepared yet. You're right to keep it small. Much of it can be set up before the synth exists: the method, the digital reference sound and the analysis script.

4. **The written report (schriftlicher Kommentar).** Not started. The school wants **5–15 pages** with a fixed structure:
   - title page and table of contents
   - introduction with the research question
   - research (what is already known)
   - method, including why you built the product the way you did
   - results
   - bibliography and list of figures

   Formatting: 1.5 line spacing, justified text, footnote citations, and it has to be **printed and bound**. Plan a day for that before 10.11.

5. **The official logbook is two months behind.** `Logbuch neu.docx` stops at **19/08/26**. Since then there's only one diary file (12/09). Breadboard testing, finishing the PCBs, ordering and everything else since mid-September isn't documented. You can rebuild a lot of it from the git history and the diary.

6. **Declaring AI use is the biggest risk.** The 12/09 entry says the PCB work was done "mit KI-Unterstützung", and the 40 scripts in `Werkzeuge/` came out of that. The school rules say:
   - Every AI use goes into the logbook with the AI's name and version, the exact prompt, the date and how you used the answer.
   - In the grid "Verwendung von KI" you note the logbook page for each use.
   - In the report, the AI use is written out after the list of figures.
   - **Not declaring it counts as cheating** (the work may have to be redone).
   - Heavy AI use also lowers how much counts as your own work.

   So both of you should dig up the old chats now while they still exist. Write honestly about what you designed yourselves (oscillator idea, choosing the modules, the circuit fixes) and what the AI tooling did. This session counts too.

7. **Sources are thin.** `quellen/` only has YouTube videos. For the research chapter and the citation rules you need a few solid sources: chip datasheets, one or two books or articles on analog synthesis and on Fourier analysis.

Minor: the 12/09 diary entry names your friend, which goes against your no-names rule for the diary. Also, the timeline in `plan/` ended with the autumn holidays and is out of date.

**My suggestion for the order:** decide the research question this week (it decides how big the Fourier part has to be). Then write a new plan for the 20 days until 10.11 that covers building the synth, the Fourier work, the report, catching up the logbook and the AI declaration. I can draft research questions and a small Fourier method next if you want.

---
### 🧑 Nutzer · 2026-10-21 11:47 UTC

you can read my entire prompt meaning for the documenton you could basicely note what my prompt was right?

- *Werkzeug: Bash* — List saved session transcripts for this project

**🤖 Claude:**

Yes, I can do that. Your prompts are saved word for word, with dates, and I can read them.

- **This session:** I see all your messages here and can write them down exactly as you typed them.
- **Earlier sessions on this laptop:** Claude Code keeps a full record of every session in this project. There are 6 of them in `C:\Users\<user>\.claude\projects\C--Users-<user>-Downloads-MaturaProjekt\`, going back to the 12 August session. Each record has the exact prompt, the date and time, and which model answered, which may differ from session to session. That covers what the school's KI sheet asks for: AI name and version, the prompt word for word, and the date.

What I can't fill in for you:
- **Your friend's sessions.** They were on their computer, so the records are there. The 12/09 PCB work, for example, probably isn't here. Your friend has to export theirs, or I can process the files if they send them.
- **ChatGPT or other tools** you used in the browser. Those chats have to be copied out of those tools.
- **How you used each answer** ("as inspiration", "partly taken over", and so on). The sheet requires that for every entry. I can suggest wording, but you two have to judge it honestly.

If you want, I'll go through all 6 records and build one list for the KI declaration: date, model, your exact prompt, a short note on what came out of it, and the matching area from the school's "Verwendung von KI" grid. I'd keep only your real prompts and drop the automatic system messages. I'd save it as `Unsere-Materialien/KI-Nachweis.md`, and you can move it into the logbook from there. Should I do it?
