lukimcfly/MaturaProjekt/KI-Protokolle/2026-10-28_b0e88781.md

# Session planning

- Sitzungs-ID: `b0e88781-ed3d-4802-9a19-b4a203525bbc`
- Zeitraum: 2026-10-28 bis 2026-11-04
- Modell(e): claude-opus-5-5
- Nutzer-Prompts: 5

> Lesbare Fassung: Prompts und Antworten im Wortlaut, Werkzeugaufrufe nur als Kurzzeile, Werkzeug-Ausgaben weggelassen.

---
### 🧑 Nutzer · 2026-10-28 12:45 UTC

Where are we, what shall be done today?

- *Werkzeug: Read* — C:\Users\<user>\.claude\projects\C--Users-<user>-Downloads-MaturaProjekt\memory\matura-projekt-inhalt.md
- *Werkzeug: Read* — C:\Users\<user>\.claude\projects\C--Users-<user>-Downloads-MaturaProjekt\memory\matura-diary-workflow.md
- *Werkzeug: Read* — C:\Users\<user>\.claude\projects\C--Users-<user>-Downloads-MaturaProjekt\memory\synth-gesamtschaltplan.md
- *Werkzeug: Bash* — List project files and recent commit history
- *Werkzeug: Bash* — Show plan files and latest diary index entries
- *Werkzeug: Bash* — Show last logbook rows, commentary status, PCB status
- *Werkzeug: mcp__4702f3be-bac4-4925-8f54-6102c1aba1c9__overview* — 
- *Werkzeug: mcp__ccd_turn__wrap_up* — 

**🤖 Claude:**

**The hand-in is Tuesday 10.11.2026, 13 days from now.** It needs two printed copies, a PDF and the Arbeitsjournal. The hardware is in good shape. The writing and documentation are behind.

## Where things stand

**Done**
- The full schematic in `SynthesizerFinal/` (Rev. 2) passes the KiCad electrical check with no errors. The oscillator core was rebuilt.
- PCB layouts and Gerber files exist for the main board and the filter board. The last commit says "2/3 PCB designs, still WIP". The boards were ordered on 21.10 and should arrive soon.
- School documents, the contract and the June feedback are filed.

**Open, most urgent first**
1. **Logbook:** the last row in `Logbuch neu.docx` is **19/08/26**. That leaves a gap of more than two months: the schematic work, the PCB layout on 12.09, the order on 21.10, and whatever happened since. The June feedback specifically called the logbook thin and said AI use wasn't documented, so this gap is risky.
2. **Written commentary (5–15 pages):** nothing is written yet. The folder is empty.
3. **Analog vs. digital Fourier comparison:** this is in the contract's grading criteria for the product, and it hasn't started. It needs measurements, so it depends on working boards.
4. **Build and test:** solder the boards once they arrive, then do a full test.
5. **Promised in the contract but missing from the schematic:** the case, the labelled front panel and the waveform display. You should decide soon whether to build these or explain why they were dropped.

## Today
This afternoon is your Maturaarbeit block: the presentation on presenting your Matura project at 13:30 in the Aula, then lessons until 16:00 in room 7005. My suggestion for the time:

- **Catch up the logbook first (about 45 minutes).** Tell me roughly what you did on each day since 19/08, including where you used AI. I'll write the German table rows into `Logbuch neu.docx` without names, as before.
- **Then outline the written commentary.** Fix the chapter structure (theory, building blocks, design, results, Fourier comparison, reflection) so the writing can run while you wait for the boards.

**Other dates to plan around:**
- Physics test on Friday.
- The full Maturitätsarbeitstag on Wednesday 4.11 is your best day for soldering and measuring.
- The optional competition entry deadline is 8.11.

Did the boards arrive yet, and did anything happen on the project since 21.10?

---
### 🧑 Nutzer · 2026-10-28 12:49 UTC

board (pcb plate) did not arrive yet and we haven't really done anything further either. Ait i guess we shall catch up the logbuch. Can you first search what is expected of the logbuch content-wise and formality-wise?

- *Werkzeug: mcp__ccd_turn__update_plan* — 
- *Werkzeug: Bash* — Extract text from school PDFs/docx and count logbook mentions
- *Werkzeug: Bash* — Show AI-usage doc and contract logbook passages
- *Werkzeug: Read* — C:\Users\<user>\Downloads\MaturaProjekt\Schul-Unterlagen\Merkblatt_Schriftlicher_Kommentar.pdf
- *Werkzeug: Read* — C:\Users\<user>\Downloads\MaturaProjekt\Schul-Unterlagen\Merkblatt_Nachweis_KI.pdf
- *Werkzeug: Read* — C:\Users\<user>\Downloads\MaturaProjekt\Schul-Unterlagen\Zwischenbericht_Rueckmeldung_Juni_2026.pdf
- *Werkzeug: Grep* — (?i)logbuch|journal|arbeitsprozess
- *Werkzeug: mcp__4702f3be-bac4-4925-8f54-6102c1aba1c9__search* — 
- *Werkzeug: Read* — C:\Users\<user>\Downloads\MaturaProjekt\Schul-Unterlagen\Checkliste_wissenschaftliche_Maturaarbeiten.pdf
- *Werkzeug: mcp__4702f3be-bac4-4925-8f54-6102c1aba1c9__search* — 
- *Werkzeug: mcp__ccd_turn__wrap_up* — 

**🤖 Claude:**

The school has **no fixed template for the logbook**. What it does have is grading criteria, AI-declaration rules and your teachers' June feedback. Together these say quite precisely what the logbook needs.

## Why it matters
- **Arbeitsprozess is 20% of the grade.** The contract says it is graded on "das Logbuch und die Betreuungsgespräche", and the logbook itself on «Struktur, Übersichtlichkeit, Reflexionsgehalt».
- **The Arbeitsjournal is handed in with the work on 10.11** (Schulnetz).

## What it must contain
These come from the contract's criteria for the Arbeitsprozess:
- **Project structure:** sub-questions and sub-steps.
- **Planning of each step:** which options you considered, what you tested, and why you chose one.
- **Regular check-ins on where you stand:** what each partial result showed.
- **Reflection on how you worked:** did your approach lead toward the goal?
- **Reflection on your AI use.**
- **Time planning, division of work** between the two of you, problems you communicated, and **input from experts**: teachers or outside people you asked.

The June feedback says the logbook was "sehr mager". It specifically lacked:
- figures, sketches, equations
- **problems and how you solved them**, including mistakes
- flowcharts for any code
- **above all, reflection on the work process**
- detailed AI use ("unbedingt im Logbuch detailliert berichten!")
- and: "Logbuch verbessern und **regelmässig zeigen**!"

## Rules for declaring AI use
This is the strict part.
- **Each AI use goes in the logbook** with:
  - the tool and its version
  - the **exact prompt**
  - the date
  - **how you used the answer** (e.g. «als Inspiration verwendet», «Aufbau teilweise übernommen»)
- **The written commentary has an AI grid** with 12 areas (Themenfindung, Recherche, Hilfsmittel und Werkzeuge, Programmieren und Berechnungen, Überprüfung, Darstellung …). For each area it asks **which page of the logbook** covers that AI use. **So the logbook needs page numbers**, and the AI entries need to be easy to find.
- Undeclared or incompletely declared AI use counts as **«aktive Täuschung»**. The consequences can be having to redo the work and a disciplinary measure. Correctly declared but heavy AI use only lowers the grade for Eigenleistung.

## Formalities
There are no explicit rules for the logbook itself. A sensible baseline:
- consistent dates (you use TT/MM/JJ)
- page numbers
- clear structure
- figures with captions

The 1.5 line spacing and citation rules apply to the written commentary.

## What this means for the catch-up
1. **The schematic and PCB work from September was done to a large extent with me (Claude).** That includes the generator scripts in `Werkzeuge/`, the rebuilt oscillator core and the board layouts. This must be declared in detail: tool, dates, what you asked, and what you decided yourselves (for example the ±12 V supply, the rotary switch, the dual-gang potentiometer). If it isn't declared, the work is the most exposed to a «Täuschung» finding. My earlier help writing the logbook text also counts as AI use.
2. **Mark the late entries as written later**, e.g. «(nachgetragen am 28/10/26)». Back-filling two months is fine. Making it look like it was written on the day is not, and the Fachgespräch would probably expose it anyway.
3. **The current 4 columns (Datum | Arbeitsschritte | Ergebnisse | Reflexionen) have no place for AI use, time spent or who did what.** I'd add a «KI-Nutzung» column and possibly «Dauer / Wer» (as roles, not names), and add page numbers.
4. **Write honest reflections, including about the gap.** For example, that 21.10 to today was a standstill while waiting for the boards, and what you learned from that about planning. That counts as Reflexionsgehalt; it doesn't count against you.

The days to fill so far are **12/09** (PCB layout) and **21/10** (order and school documents), plus the schematic work before 09/09. For each day, I'll need what you did, roughly how long it took, who did what, and which AI prompts you used, as far as you can reconstruct them. I can pull the AI-session dates and contents from our past sessions if that helps.

---
### 🧑 Nutzer · 2026-10-28 13:07 UTC

ait yeah please restructure the logbook. And for the days to fill: Im sorry but i won't be able to accurately remember, if you can please tell me what we did befor and later on that day that's missing. As you said you can also ask the other AI sessions in the MaturaProject for helping remember or maybe it even knows fully what we did on these days. You can also try to get the exact prompts (if that's needed according to the "declaring AI use"), tho i don't know if the exact prompts is suitable as they might have been some long prompts, so mabye summarizing them? Idk how exact we should/must do that.

- *Werkzeug: mcp__ccd_turn__update_plan* — 
- *Werkzeug: ToolSearch* — 
- *Werkzeug: mcp__ccd_session_mgmt__list_sessions* — 
- *Werkzeug: Bash* — List stored session transcripts and commit dates
- *Werkzeug: Bash* — Extract user prompts and active days from past session transcripts
- *Werkzeug: Bash* — List project dirs, show 12.09 diary and handoff notes

**🤖 Claude:**

I found the past AI sessions. Now I'm reading what was actually asked and done on each day.

- *Werkzeug: Bash* — Print full user prompts of key project sessions
- *Werkzeug: Bash* — Read the 21.10 assistant answer about AI declaration
- *Werkzeug: Bash* — Check commit authors and when circuit files and pictures were added
- *Werkzeug: Bash* — Check modification dates of circuit files
- *Werkzeug: mcp__ccd_turn__update_plan* — 
- *Werkzeug: Bash* — Unpack logbook docx and inspect its XML structure
- *Werkzeug: Bash* — Inspect docx parts, relationships and diary header

**🤖 Claude:**

Next I'm checking the 19/08 session for durations and AI use, then I'll rebuild the table.

- *Werkzeug: Bash* — Read the 19.08 session exchanges
- *Werkzeug: Bash* — Find which Claude model each session used
- *Werkzeug: Bash* — Read the mixer debugging session from 09.09
- *Werkzeug: Bash* — Read schematic README for revision history

**🤖 Claude:**

Now I'm pulling the exact prompt texts for the appendix.

- *Werkzeug: Bash* — Collect full prompt texts into a JSON file

**🤖 Claude:**

I have everything I need. Now I'm writing the new logbook structure and the catch-up entries.

- *Werkzeug: mcp__ccd_turn__update_plan* — 
- *Werkzeug: Bash* — List available Word styles and numbering
- *Werkzeug: Write* — C:\Users\<user>\AppData\Local\Temp\claude\C--Users-<user>-Downloads-MaturaProjekt\b0e88781-ed3d-4802-9a19-b4a203525bbc\scratchpad\build_logbuch.py
- *Werkzeug: Edit* — C:\Users\<user>\AppData\Local\Temp\claude\C--Users-<user>-Downloads-MaturaProjekt\b0e88781-ed3d-4802-9a19-b4a203525bbc\scratchpad\build_logbuch.py
- *Werkzeug: Bash* — Build test logbook and check XML is well-formed

**🤖 Claude:**

Built and well-formed. Now I'm rendering it through Word to check the layout visually.

- *Werkzeug: PowerShell* — Render test logbook to PDF with Word
- *Werkzeug: Read* — C:\Users\<user>\AppData\Local\Temp\claude\C--Users-<user>-Downloads-MaturaProjekt\b0e88781-ed3d-4802-9a19-b4a203525bbc\scratchpad\Logbuch_test.pdf
- *Werkzeug: mcp__Claude_Browser__preview_start* — file:///C:/Users/<user>/AppData/Local/Temp/claude/C--Users-<user>-Downloads-MaturaProjekt/b0e88781-ed3d-4802-9a19-b4a203525bbc/scratchpad/Logbuch_test.pdf
- *Werkzeug: mcp__Claude_Browser__computer* — 
- *Werkzeug: Bash* — Check for a PDF rendering library
- *Werkzeug: PowerShell* — Render selected PDF pages to PNG via Windows PDF API

**🤖 Claude:**

Rendered the pages. Now I'm checking them visually.

- *Werkzeug: Read* — C:\Users\<user>\AppData\Local\Temp\claude\C--Users-<user>-Downloads-MaturaProjekt\b0e88781-ed3d-4802-9a19-b4a203525bbc\scratchpad\pg0.png
- *Werkzeug: Read* — C:\Users\<user>\AppData\Local\Temp\claude\C--Users-<user>-Downloads-MaturaProjekt\b0e88781-ed3d-4802-9a19-b4a203525bbc\scratchpad\pg3.png
- *Werkzeug: Read* — C:\Users\<user>\AppData\Local\Temp\claude\C--Users-<user>-Downloads-MaturaProjekt\b0e88781-ed3d-4802-9a19-b4a203525bbc\scratchpad\pg9.png

**🤖 Claude:**

Two layout fixes: the date column wraps badly, and the `[Name]`/`[eingefügt]` markers shouldn't be yellow. Fixing and rebuilding.

- *Werkzeug: Bash* — Apply layout fixes and rebuild test logbook
- *Werkzeug: PowerShell* — Re-render rebuilt logbook pages to PNG
- *Werkzeug: Read* — C:\Users\<user>\AppData\Local\Temp\claude\C--Users-<user>-Downloads-MaturaProjekt\b0e88781-ed3d-4802-9a19-b4a203525bbc\scratchpad\pg4.png
- *Werkzeug: Read* — C:\Users\<user>\AppData\Local\Temp\claude\C--Users-<user>-Downloads-MaturaProjekt\b0e88781-ed3d-4802-9a19-b4a203525bbc\scratchpad\pg10.png

**🤖 Claude:**

Layout looks right. Now I'm installing it in the project.

- *Werkzeug: mcp__ccd_turn__update_plan* — 
- *Werkzeug: Bash* — Copy rebuilt logbook into project and show logbook README
- *Werkzeug: Bash* — Update logbook README with new structure and entries
- *Werkzeug: Edit* — C:\Users\<user>\.claude\projects\C--Users-<user>-Downloads-MaturaProjekt\memory\matura-diary-workflow.md
- *Werkzeug: mcp__ccd_turn__wrap_up* — 
- *Werkzeug: Edit* — C:\Users\<user>\.claude\projects\C--Users-<user>-Downloads-MaturaProjekt\memory\matura-diary-workflow.md

**🤖 Claude:**

I've restructured `Logbuch neu.docx` and filled the gap from 20/08 to today. I rebuilt the entries from the past AI sessions on this PC, the Git history, the 12/09 diary and the schematic README. Anything I couldn't find out is marked yellow for you to fill in. I opened it in Word to check the layout; it comes to 15 pages.

**The new structure:**
- **Six columns:** Datum | Dauer / Wer | Arbeitsschritte | Ergebnisse | Reflexionen | KI-Nutzung.
- Page numbers in the footer, which the school's AI table needs. The header row repeats on every page.
- **Appendix "KI-Nachweis":** 21 prompts quoted word for word, numbered K1–K21. Each one has the date, the tool and version (Claude Code with Claude Opus 5 or 5.5), and what you did with the answer.
- Your four existing rows got the new columns filled where I could. The 12/08 and 19/08 rows now say that the AI typed up the plan and wrote parts of the 19/08 text.

**What I could reconstruct:**

| Date | What happened |
|---|---|
| 20/08–08/09 | Separate KiCad schematics for the oscillator and the filter; the mixer simulated in Falstad. I only know this from the files, so it's thin. |
| 09/09 | Mixer debugging in Falstad (the sources were set to 120 V). The full schematic was merged into one (Rev. 2), with the decisions you made: ±12 V, rotary switch, dual-gang pot. The oscillator core was rebuilt because its amplitude dropped as the frequency rose. |
| 10/09–11/09 | Your partner, with AI: Rev. 3/4, four real errors found (filters C/D wouldn't have worked at all, C804 reversed, …), ngspice simulations, split into three boards. You set up GitHub on 11/09. |
| 12/09 | Your partner, about 8 h: board layouts and manufacturing files, with problems and fixes. |
| 13/09–20/10 | Boards ordered, autumn break. Almost no record, so mostly yellow. |
| 21/10 | School documents filed, a check on where the project stood, how to declare AI use, and the start of the commentary. |
| 28/10 | Today. |

**About exact prompts:** the school's AI guide does ask for the prompt *wörtlich*. I kept your own typed text unchanged, typos included. Pasted material (files, links, a long answer from another AI, your partner's outline) is replaced by a short "[eingefügt: …]" note, and names by [Name]. That keeps the appendix readable without leaving out anything you wrote yourself.

**Still to do, all marked yellow:**
1. **Reflections:** I deliberately left these as guiding questions rather than writing them. The June feedback criticised the AI-like text, and reflection is the part graded most on your own voice.
2. **Durations and who did what** for most days.
3. **Your partner's prompts (K12)** for the 10/09–12/09 sessions. Those sessions ran on their PC, so nothing from them is on this machine. They can export the sessions from the Claude app.
4. **Small facts I couldn't confirm:**
   - The date the boards were ordered.
   - Whether you tested on breadboards. The contract asks for it.
   - Where the pasted mixer answer in K6 came from.
   - Whether you used the example text from 21/10.
5. **Attach the full session exports as a digital appendix**, as promised in the intro note.

I also updated the logbook README to describe the new columns.

---
### 🧑 Nutzer · 2026-10-28 14:58 UTC

"

<pasted_content id="3cc7">
Funktionsprinzip verstanden:
Der Kondensator lädt sich
langsam über den
Ladewiderstand auf. Bei
Erreichen der oberen
Schaltschwelle V_T+ kippt der
Schmitt-Trigger-Ausgang,
schaltet über RB den Transistor
durch und entlädt den
Kondensator schnell über
RLow gegen Masse. Bei V_T−
kippt der Ausgang zurück. Weil
der Ladewiderstand rund
hundertmal grösser ist als der
Entladewiderstand, dauert das
Aufladen viel länger als das
Entladen – genau diese
Asymmetrie erzeugt die
Sägezahnform
</pasted_content id="3cc7">

" -> I don't think we should write so much, i think a short version or rather write what without an explaination: "Kondesator princip voll verstanden". I don't think the explaination should be in the logbuch, but in the "Schriftlicher Kommentar".

"Bilder-Ordner und Skript zum
Speichern aus der
Zwischenablage erstellt" -> I don't think the "Skript zum Speichern" is needed too, because its just the way, instead of the actual thing: We just need to say: "Uploaded and organised files in github/projectfolder (before we set the github up)". 

Generally i tend to describe you as the "Organisator" of our files, sources, images etc. that i send you. That way i can also ask about where we stand etc. (like in this chat). And you were partially responislbe for the Logbuch.

---
*2026-10-28 14:11 · [Kontext zusammengefasst – frühere Unterhaltung wurde komprimiert]*

- *Werkzeug: mcp__ccd_turn__update_plan* — 
- *Werkzeug: Bash* — Search logbook XML for the passages
- *Werkzeug: Bash* — List logbook paragraphs mentioning the passages and AI
- *Werkzeug: Bash* — Unpack docx and show legend and target paragraphs
- *Werkzeug: Bash* — Apply text changes and rezip docx

**🤖 Claude:**

Now render to check the layout.

- *Werkzeug: mcp__ccd_turn__update_plan* — 
- *Werkzeug: PowerShell* — Open in Word, count pages, export PDF
- *Werkzeug: PowerShell* — Render first two PDF pages to PNG
- *Werkzeug: Read* — C:\Users\<user>\AppData\Local\Temp\claude\C--Users-<user>-Downloads-MaturaProjekt\b0e88781-ed3d-4802-9a19-b4a203525bbc\scratchpad\v2_0.png
- *Werkzeug: Read* — C:\Users\<user>\AppData\Local\Temp\claude\C--Users-<user>-Downloads-MaturaProjekt\b0e88781-ed3d-4802-9a19-b4a203525bbc\scratchpad\v2_1.png
- *Werkzeug: Bash* — Install the updated logbook
- *Werkzeug: Edit* — C:\Users\<user>\.claude\projects\C--Users-<user>-Downloads-MaturaProjekt\memory\matura-diary-workflow.md
- *Werkzeug: mcp__ccd_turn__wrap_up* — 

**🤖 Claude:**

I made both changes in `Logbuch neu.docx`, plus the "Organisator" role. I opened it in Word to check; it's still 15 pages.

- **19/08, Ergebnisse:** shortened to "Funktionsprinzip des Sägezahn-Oszillators (Kondensator laden/entladen) vollständig verstanden; Erklärung im schriftlichen Kommentar." That last half-sentence just says where the explanation went. Delete it if you want only the first part.
- **19/08, KI-Nutzung:** now "Claude Code als Organisator: unsere Bilder und Dateien im Projektordner abgelegt und geordnet (vor dem GitHub-Setup)". The script is gone. I changed the matching "Übernahme" line under K3 in the appendix the same way.
- **Legend at the top:** one sentence now says what the AI does for you overall: it files the files, sources and pictures you send it, tells you where the project stands, and helps keep the logbook. That way the individual rows don't have to explain it every time.

I saved the rule (keep the logbook short: what was reached, not how or why) and the "Organisator" role, so later entries follow it.

The 19/08 row still has two long explaining parts in the same style: the mixer approach in Ergebnisse and the reflections, which the AI wrote back then. The same rule probably applies to those too.

---
### 🧑 Nutzer · 2026-11-04 10:31 UTC

can you pls send every chat (or the relevant ones) to the github project: I won't be able to use this device any longer, but i still need every chat and session, so that i know what i did etc. with you. 
Or would you recommend moving all these session to cloud?

- *Werkzeug: mcp__ccd_turn__update_plan* — 
- *Werkzeug: Bash* — List session files and check repo visibility
- *Werkzeug: Bash* — Check repo visibility and session dates
- *Werkzeug: Bash* — Scan transcripts for tokens and passwords
- *Werkzeug: Bash* — Inspect password mentions and personal identifiers
- *Werkzeug: mcp__ccd_turn__update_plan* — 
- *Werkzeug: Bash* — Convert all sessions to readable Markdown in repo
