lukimcfly/MaturaProjekt/Unsere-Materialien/Logbuch/Logbuch alt (Maerz-Juni 2026).docx

# Logbuch Maturarbeit

Lukas Sporrer & Timofey Denisov

11.03.2026:

Wir haben die erste Version unseres Vertrages erstellt. Wir haben die vermuteten Kosten rechechiert.

18.03.2026:

Ausfall
25/03/2026:

Wir haben einen Lowpassfilter gebaut, diesen an einen Wave-Generator angeschlossen und die Welle dann über einen Lautsprecher abgespielt: Zuerst haben wir recherchiert, wie man einen solchen Lowpassfilter baut. Mit unserem neuen Wissen haben wir alle nötigen Teile mit den bestimmten Parametern dafür aus dem Lager geholt. Dazu gehören: 1x Wave-Generator, 1x Lautsprecher, 1x Steckplatte, 1x Capacitor, 1x Potentiometer, 1x Oszilloskope Kabel. Danach haben wir den Schaltkreis gesteckt. Als wir den Wave-Generator angeschaltet haben konnten wir direkt einen Sound hören. Wir hatten eine Weile, bis wir das Oszilloskope richtig eingestellt haben. Mit dem Potenziometer konnten wir die Werten für den Resistor verändern wärend der Laufzeit. So konnten wir schnell den Unterschied des Lowpassfilters hören beim Verstellen des Potenziometers.

01/04/2026:

Wir haben das Feedback zur ersten Version unseres Vertrages erhalten und haben eine neue Version des Vertrages erstellt. Wir haben recherchiert, wie ein LED-Blinker funktioniert und am Schluss einen Schaltplan auf einer Software geplant. Da Timofey einen Zahnarzt Termin hatte, musste er frühzeitig gehen. Lukas hat in der Werkstatt das vorhandene Material begutachtet.

22/04/2026:

Timofey hat Ferienauszug. Lukas hat nach verschiedenen Schaltplan-Designer-Softwares geschaut, um eine bessere Software zu finden. Weiter wurde der LED-Blinker fertig geplant mit den richtigen Werten. Materialen wurden aus der Werkstatt im Physikgebäude geholt und dann auf ein Breadboard gesteckt laut unserer Planung. Beim Anschließen der Batterie hat man direkt gesehen wie sich die beiden LEDs abwechselnd aufblinken. Jedoch war die Frequenz zu hoch, deshalb haben wir ein paar Teile mit höheren Werten ersetzt, so dass es langsamer blinkte.

29/04/2026:

Mit dem LED-Blinker, denn wir letztes Mal gebaut haben, haben wir schon zu einem Teil einen Squarewave, Da im Schaltkreis eine on-off Periode existiert. Deshalb sind wir einen Schritt weitergegangen, um einen funktionstüchtigen Squarewave-Sound aus unserem vorhandenen Schaltkreis zu bauen. Zuerst haben wir recherchiert, wie wir einen Speaker in unseren Schaltkreis integrieren, damit dieser einen Squarewave-Ton produziert. Da der Schaltkreis für den Speaker zu schwach ist, musste noch ein Amplifier eingebaut werden. Dieser haben wir als vollständiges Gerät aus der Werkstatt geholt. Sobald der neue Schaltkreis fertig erstellt wurde und wir ihn mit Strom versorgten, hatte der Speaker schon ein paar Töne gemacht. Jedoch noch nicht im erwünschten Zustand. Die Frequenz des Squarewave-Generators war viel u wenig. Wir mussten die Frequenz von einem sichtbaren Bereich, zu einer Ton-erzeugender Frequenz anpassen. Mit einer Formel konnten wir berechnen, welche Werte für die Capacitors und Resistors genommen werden musste. Mit weiteren Anpassungen der Werte des Amplifier (mussten stark erhöht werden), haben wir einen Ton generiert, der einem nicht-verbundenen Radios anähnelt. Jedoch immer noch nicht der erwünschte Ton, deshalb haben wir angefangen zu recherchieren, wie man einen Amplifier baut. Da es verschiedene Arten von Amplifier gibt, mussten wir zuerst mal schauen, welche Art von Amplifier wir brauchen.

06/05/2026:

Mit der neuen Vertragsvorlage mussten wir zuerst unseren Vertrag nochmals anpassen.

13/05/2026:

20/05/2026:

Ausfall wegen Sonderwoche.

27/05/2026:

Wir haben ein Potenziometer in unseren Stromkreis eingebaut, so dass wir nun einen variablen Resistor haben, mit dem wir die Frequenz des Tones verändern können. Abgesehen vom Ton haben wir im Oszilloskop die Veränderung klar erkennen können. Zusätzlich haben wir realisiert, dass unser Wave-Generator gar keine richtige Squarewave produziert.

03/06/2026:
