lukimcfly/MaturaProjekt/Unsere-Materialien/Logbuch/Logbuch neu.docx

# Logbuch Maturarbeit Synthesizer

Legende: Spätere Nachträge sind beim Datum vermerkt. Rolle der KI: Claude Code dient uns als Organisator – es legt die Dateien, Quellen und Bilder ab, die wir ihm schicken, gibt Auskunft über den Projektstand und führt dieses Logbuch teilweise mit. KI-Prompts stehen im Wortlaut im Anhang (K1, K2, …). [Gelb markiert] = von uns noch zu ergänzen.

Datum | Dauer / Wer | Arbeitsschritte | Ergebnisse | Reflexionen | KI-Nutzung
12/08/26 | ca. 0,5 h Planung, ca. 2–4 h Theorie (Videos) beide | Erstellung eines präzisen Zeitplans bis zu den Herbstferien Verfestigung der Theorie, darunter: - Transistoren - Kondensatoren - Op-Amps - RC Time constant - Tief- und Hochpassfilter (Grenzfrequenz) - Verstärkerklassen (Class A, AB, B, C) | Verständnis der Funktionsweisen von Kondensatoren und Transistoren auf Atomarer Ebene Inspiration/Ideen für Amplifier anhand von Op-Amps Kondensator-Ladezeiten mit Kapazität und Widerstand rechnen | Wir hätten vor und in den Ferien mehr arbeiten sollen, da die Zeit jetzt knapper wie erwartet ist Wir müssen uns an den Zeitplan halten und viel Freizeit für das Projekt aufwenden | Claude Code (Claude Opus 5): Zeitplan aus unserer handschriftlichen Notiz abgetippt, Tagebuch-Ablage eingerichtet. Prompts K1, K2 (Anhang). Übernahme: Ablage und abgetippter Plan übernommen; Inhalt des Plans von uns.
15/08/26 | [Dauer ergänzen] [Wer] | Nach Lösungen für effizienten Oscillator gesucht, welche alle gewünschten Formen erzeugen kann | Lösung gefunden: Square-Wave mit Op-Amp generieren, Square-Wave als Ableitung für Triangle-Wave verwenden, Triangle-Wave für «Sine»-Wave verwenden. Sine in Anführungszeichen weil es keine wahre Sinusform ist | In Mathematik aufpassen lohnt sich | [KI genutzt? Falls ja: wofür]
18/08/26 | [Dauer ergänzen] [Wer] | Brainstorming für Funktionsweise Saw-Wave-Oscillator | Grobe Idee gefunden und skizziert. Braucht aber noch Anpassungen um funktionstüchtig zu werden | Eigene, funktionierende Schemen zu entwerfen braucht extrem kreatives/innovatives Denken, sowie ein Vorstellungsvermögen vom System als ganzes | [KI genutzt? Falls ja: wofür]

19/08/26

[Dauer ergänzen]

[Wer]

Umsetzung der Saw-Wave-Idee vom 18/08 in einen konkreten Schaltplan in KiCad

Recherche zu Relaxationsoszillatoren mit Schmitt-Trigger als Alternative zur Op-Amp-Lösung

Aufsetzen einer geordneten Projektablage, darunter:

- Zeitplan in digitaler Form
- Sammlung aller verwendeten Quellen
- Ordner für Schaltpläne, Aufbaufotos und Messungen

Theorie zum Mixer nachgeholt: Transistor-Audiomischer

Sägezahn-Oszillator im Online-Simulator falstad.com/circuit nachgebaut und simuliert

Schaltplan der Oszillatorstufe steht: Schmitt-Trigger-Buffer 74LVC2G17 (U2A) mit RC-Zeitglied (C4) und NPN-Transistor Q4 als schnellem Entladepfad

Funktionsprinzip des Sägezahn-Oszillators (Kondensator laden/entladen) vollständig verstanden; Erklärung im schriftlichen Kommentar.

Alle Projektdateien liegen jetzt an einem zentralen Ort statt verstreut

Ansatz für die Mixer-Stufe gefunden: Die Signale der drei Oszillatoren lassen sich über je einen Widerstand pro Kanal auf einen gemeinsamen Knoten zusammenführen und anschliessend mit einer Transistorstufe verstärken. Damit kommt der Mixer ohne Op-Amp aus, und über die Widerstandswerte lässt sich die Lautstärke der einzelnen Kanäle gegeneinander einstellen.

Zweite Revision des Oszillators gezeichnet: RHigh auf 5 kΩ verkleinert, RLow und RB auf 220 Ω, C4 auf 100 nF festgelegt und ein einstellbarer Widerstand RVar (0 Ω – 25 kΩ) in den Ladepfad eingefügt. Über RVar lässt sich die Ladezeit und damit die Tonhöhe des Oszillators einstellen.

Überschlagsrechnung zur Frequenz (angenommen 5 V Versorgung, Schaltschwellen laut Datenblatt): Ladezeit = (RVar + RHigh) · C4 · ln((VCC − V_T−)/(VCC − V_T+)). Das ergibt rund 1 kHz bei voll aufgedrehtem RVar bis rund 5,7 kHz bei RVar = 0. Der Bereich liegt damit noch zu hoch und umfasst nur etwa 2,5 Oktaven – mit einem grösseren C4 (z. B. 1 µF) verschiebt sich alles proportional nach unten in einen musikalisch brauchbaren Bereich.

Die Simulation bestätigt die Schaltung: Der Oszillator erzeugt eine saubere Sägezahnspannung, und über den einstellbaren Widerstand lässt sich die Frequenz wie vorgesehen verändern. Damit ist der selbst entworfene Oszillator zum ersten Mal nachweislich funktionsfähig – bisher war er nur auf dem Papier durchdacht.

Als Nachweis wurde eine Bildschirmaufnahme der laufenden Simulation gespeichert (Schaltung und Kurvenform).

Für den Sägezahn ist nicht die Schaltung an sich der Trick, sondern die Asymmetrie zwischen Lade- und Entladezeit. Das war der entscheidende Gedanke, der die grobe Idee vom 18/08 funktionsfähig macht.

Die RC-Theorie vom 12/08 zahlt sich direkt aus: die Frequenz lässt sich über die Zeitkonstante vorher berechnen, statt sie durch Ausprobieren zu finden. Theorie zuerst zu machen war rückblickend die richtige Reihenfolge.

Ein Schmitt-Trigger-Baustein löst hier eine Aufgabe, für die wir ursprünglich einen Op-Amp vorgesehen hatten. Es lohnt sich, für jede Baugruppe mehrere Bauteilarten zu prüfen, statt bei der ersten Idee zu bleiben.

Auch beim Mixer zeigt sich dasselbe Muster: Eine Aufgabe, die wir zuerst dem Op-Amp zugedacht hatten, geht ebenso mit einem Transistor. Für das Endprodukt müssen wir uns bewusst entscheiden, ob wir auf möglichst wenige verschiedene Bauteile setzen oder pro Baugruppe die jeweils sauberste Lösung nehmen.

Der Wechsel von der ersten zur zweiten Revision zeigt, wie wichtig es ist, die Bauteilwerte nicht nur zu setzen, sondern durchzurechnen. Erst die Rechnung macht sichtbar, dass die Frequenz noch nicht im gewünschten Bereich liegt – das hätten wir am Aufbau sonst erst gemerkt, wenn schon alles gelötet ist.

Simulieren vor dem Aufbauen hat sich sofort ausgezahlt. Ein Online-Simulator kostet nichts, braucht keine Bauteile und zeigt in Minuten, ob eine Idee überhaupt trägt. Für die restlichen Baugruppen – Mixer, Amplifier, Distortion und Filter – gehen wir künftig genauso vor: erst rechnen, dann simulieren, dann erst auf das Breadboard.

Der Sägezahn-Oszillator ist die Baugruppe, die wir am wenigsten aus fertigen Vorlagen übernommen haben. Dass ausgerechnet dieser selbst entwickelte Teil in der Simulation auf Anhieb funktioniert, ist die grösste Bestätigung bisher.

Claude Code (Claude Opus 5) als Organisator: unsere Bilder und Dateien im Projektordner abgelegt und geordnet (vor dem GitHub-Setup); Text dieser Logbuchzeile aus unseren Angaben formuliert; zwei Stichworte in der Zeile 12/08 ergänzt; Quellen eingetragen.

Prompts K3–K5. Die Sägezahn-Simulation in Falstad haben wir selbst gemacht.
20/08/26 – 08/09/26 Zeitraum nachgetragen am 28/10/26 | [Dauer ergänzen] [Wer] | Teilschaltpläne der Baugruppen in KiCad ausgearbeitet: - Oszillator (Funktionsgenerator: Rechteck → Dreieck → «Sinus», dazu Sägezahn mit Schmitt-Trigger) - Filter (Tief-, Hoch-, Bandpass, Notch; passive LC-Zweige) Mixer nach dem Video vom 19/08 in Falstad aufgebaut und simuliert (Transistor-Mixer, ein Poti pro Kanal). [Was fehlt hier noch? Breadboard-Tests, Werte gerechnet, …] | Für jede Baugruppe ein eigener Schaltplan: KicadCircuit/Oscillator1.kicad_sch und KicadCircuit/Filter.kicad_sch, Mixer als Falstad-Simulation. [Ergebnisse ergänzen] | [Eure Reflexion: Was war schwierig? Was hat gut geklappt? Lagen wir im Zeitplan (KW 35/36: Komponenten skizzieren, KiCad-Schaltplan)?] | [Wurde KI für Wertberechnungen genutzt? Laut unserer Aussage vom 21/10: ja, für die Wertberechnung in den eigenen Schaltungen. Auf welchem PC/in welchem Chat? Prompts ergänzen.]

09/09/26

nachgetragen am 28/10/26

ca. 6 h (12:30–18:40, mit Pausen)

[Wer]

Mixer-Simulation untersucht: Die Wellenformen waren beim Mischen kaum zu erkennen.

- Signalquellen standen auf dem Falstad-Standardwert 120 V statt 5 V, die Potis fast am Massenende (50 Ω von 10 kΩ).
- Quellen danach auf 1 V gesetzt, weil das Signal sonst an der Versorgungsspannung abgeschnitten wurde.

Gesamtschaltplan: Oszillator-, Filter- und Mixer-Plan zu einem einzigen, durchgehend verbundenen Schaltplan zusammengeführt: 3 Oszillatoren → Mixer → Filter A → Filter B → LM386 → Lautsprecher; Filter C/D als Solo-Filter über Klinkenbuchsen.

Auf Rückfrage von uns entschieden:

- Versorgung ±12 V, daraus +5 V für die Schmitt-Trigger
- Filterwahl über 2-poligen Drehschalter statt Dioden
- «Filterstärke» = Grenzfrequenz (Poti)
- Frequenz pro Oszillator über ein Doppel-Poti (Funktionsgenerator und Sägezahn gleichzeitig)

Mixer in der Simulation brauchbar: Knopf ganz auf = grösste unverzerrte Lautstärke.

SynthesizerFinal Rev. 2: ein flaches Schaltplanblatt, ERC 0 Fehler / 0 Warnungen.

Fehler in unserem Oszillator gefunden: Die Amplitude hing von der Frequenz ab (∝ 1/f). Bei tiefen Tönen wurde das Dreieck abgeschnitten, bei hohen verschwand es fast. Der Oszillatorkern wurde deshalb neu aufgebaut: Komparator und Integrator bilden jetzt einen Regelkreis, der Sinus entsteht über einen Dioden-Former.

[Eure Reflexion, z. B.: Warum ist uns der 1/f-Fehler im eigenen Entwurf nicht aufgefallen (jede Baugruppe nur einzeln und bei einer Frequenz angeschaut?). Was heisst das für die Tests am fertigen Gerät?]

[Wie viel vom Gesamtschaltplan könnt ihr selbst erklären? Was müsst ihr noch nachlesen (Regelkreis, Dioden-Former)?]

Claude Code (Claude Opus 5), 2 Sitzungen. Prompts K6–K10.

Mixer: Fehlerdiagnose übernommen, Korrekturen selbst in Falstad umgesetzt und überprüft.

Gesamtschaltplan: vollständig von der KI erzeugt, inkl. Neuaufbau des Oszillatorkerns und Werteanpassungen. Die Designentscheidungen (links) haben wir getroffen.

10/09/26 – 11/09/26

nachgetragen am 28/10/26

[Dauer ergänzen]

[Wer]

Schaltplan systematisch geprüft und auf Rev. 3/4 gebracht (KiCad-10-Format).

SPICE-Simulationen mit ngspice (in KiCad eingebaut): Wellenformen über die Zeit und Frequenzgänge der Filter; Op-Amps über Makromodelle nach Datenblatt.

Schaltplan in drei Platinenprojekte aufgeteilt: Oszillator (3×), Filter (4×), Hauptplatine (1×).

11/09: GitHub-Repository eingerichtet, damit wir beide gleichzeitig am Projekt arbeiten können.

Gefundene Fehler:

- Filter C und D hätten gar nicht funktioniert: ein Massesymbol lag auf dem Summenpunkt eines Integrators und schloss die virtuelle Masse kurz.
- C804 war verpolt eingezeichnet.
- Keine Stützkondensatoren direkt an den ICs → 29 × 100 nF und 14 × 10 µF ergänzt.
- Mixer übersteuerte (Oszillator bis 14 Vss, Transistorstufe nur bis ca. 8 Vss linear) → R801–803 47k → 100k, R806 330 → 470.

Weitere Änderungen: Distortion-Stufe umgebaut (war ca. 15 dB leiser), Sicherungen und Verpolungsschutz, log-Potis für die Lautstärke, LM324 durch TL074 ersetzt, Bandpass durch State-Variable-Filter ersetzt, Notch neu aufgebaut.

Schaltplan ERC 0/0, alle 305 Platinen-Bauteile mit geprüftem Footprint.

[Eure Reflexion: Was sagt es, dass zwei Filter komplett funktionslos gewesen wären und nur eine systematische Prüfung das gefunden hat? Laut Vertrag sollten Baugruppen vorher auf Steckbrettern getestet werden. Haben wir das gemacht oder bewusst übersprungen? Warum?]

Claude (Version und Prompts auf dem PC des anderen Projektmitglieds, siehe K12): Prüfung, Fehlersuche, Simulationen, Aufteilung in Platinen weitgehend durch KI.

Claude Code (Claude Opus 5): GitHub-Repository eingerichtet, Prompt K11.

[Simulationsdateien (sim/, work/sim/) ins Repository übernehmen. Sie sind der Nachweis.]

12/09/26

nachgetragen am 28/10/26

ca. 8 h

ein Projektmitglied mit KI [Wer]

Vom fertigen Schaltplan zu bestellbaren Leiterplatten:

- Bauteilplatzierung aus den echten Pad-Positionen berechnet (jedes Bauteil neben den IC-Pin, den es bedient)
- Autorouter geschrieben und mehrfach überarbeitet
- Fertigungsdaten erzeugt: Gerber, Bohrdateien, Stücklisten, Bestückungspläne, 3D-Ansichten
- Verdrahtungstabelle für das Bedienfeld: 153 Drähte, aus der Netzliste abgeleitet

Hauptplatine und Filter-Platine: Designregelprüfung (DRC) ohne Fehler, kein Netz offen. Unter 100 × 100 mm (günstige Preisstufe); Oszillator-Platine auf 108 × 108 mm vergrössert.

Probleme und Lösungen:

- Abblockkondensator des LM386 sass 41 mm vom Versorgungspin → auf 4,7 mm verschoben (sonst schwingt der LM386 leicht).
- Oszillator-Platine liess sich nicht routen: Die Stecker-Leitungen kreuzten sich 61-mal. Stiftbelegung umsortiert → 0 Kreuzungen, statt 9 noch 2 offene Netze.
- Ein Prüfskript hat den Schaltplan unbeabsichtigt verändert → aus der Sicherung wiederhergestellt, Netzliste verglichen.

Entscheid: Netzteil ±12 V fertig kaufen (230 V, Sicherheit, Zeit).

[Eure Reflexion: Laut Zeitplan war das PCB-Design erst für KW 38 geplant. Wir waren also eine Woche früher dran. Was davon könnt ihr selbst erklären (Autorouter, Platzierung)?]

Claude (auf dem PC des anderen Projektmitglieds, K12): Platzierung, Autorouter und Fertigungsdaten von der KI programmiert und erzeugt.
13/09/26 – 20/10/26 Zeitraum nachgetragen am 28/10/26 | [Dauer ergänzen] [Wer] | Oszillator-Platine fertig geroutet [prüfen], Gerber-Dateien geprüft [prüfen], Platinen bestellt [Datum der Bestellung ergänzen]. Herbstferien. [Bauteile bestellt? Netzteil gekauft? Arduino-Mini-Oszilloskop (Display) angefangen?] | Platinen bestellt, Lieferung ausstehend. [ergänzen] | [Eure Reflexion: In dieser Zeit ist laut unseren Unterlagen wenig passiert. Wie ist es dazu gekommen und was nehmen wir daraus für die letzten Wochen mit?] | [KI genutzt? Falls ja: wofür]
21/10/26 nachgetragen am 28/10/26 | ca. 3 h (11:20–14:20) [Wer] | Schul-Unterlagen gesammelt und abgelegt (Merkblätter, Checkliste, Zitierregeln, KI-Richtlinien); Vertrag, altes Logbuch, Zwischenbericht und alte Quellensammlung mit dem Repository synchronisiert. Standortbestimmung: Was fehlt bis zur Abgabe am 10/11? Umfang des Fourier-Vergleichs analog/digital anhand des Vertrags abgeschätzt. Vorgehen für die KI-Deklaration geklärt. Mit dem schriftlichen Kommentar begonnen (Gliederung vom anderen Projektmitglied, Kap. 1.3 «Eingrenzung»). | Alle Vorgaben der Schule liegen jetzt im Projektordner. Erkenntnis: Die KI hat nicht nur Werte berechnet, sondern Fehler gefunden und die Schaltung geändert. Das muss vollständig deklariert werden. Korrektur für den Kommentar: KiCad hat mit ngspice sehr wohl einen eingebauten Simulator (im Zwischen-Kommentar stand das Gegenteil). | [Eure Reflexion: z. B. dass wir diesmal drei Wochen vor der Abgabe anfangen wollten und was der Zwischenbericht für die Endabgabe bedeutet.] | Claude Code (Claude Opus 5.5). Prompts K13–K18. Ablage und Synchronisation übernommen; Standortbestimmung und Vorschlag zur KI-Deklaration als Orientierung genutzt; Beispieltext zur Eingrenzung [als Inspiration / übernommen? angeben].
28/10/26 | ca. 2 h [Wer] | Standortbestimmung: 13 Tage bis zur Abgabe, Platinen noch nicht angekommen, seit 21/10 keine weitere Arbeit. Anforderungen an das Logbuch aus Vertrag, KI-Richtlinien, Merkblatt «Nachweis KI» und Zwischenbericht zusammengetragen. Logbuch umgebaut: Spalten «Dauer / Wer» und «KI-Nutzung», Seitenzahlen, Anhang mit den Prompts im Wortlaut. Fehlende Einträge seit 19/08 aus KI-Sitzungsprotokollen, Git-Verlauf, Tagebuch und Projektdateien rekonstruiert. | Logbuch ist bis heute nachgeführt; offene Stellen sind gelb markiert. Wichtigste Anforderungen: Reflexion des Arbeitsprozesses, Probleme und Lösungen, Figuren/Gleichungen, KI-Nutzung mit Tool, Version, Prompt, Datum und Art der Übernahme; die Seitenzahlen des Logbuchs werden im KI-Raster des Kommentars angegeben. | [Eure Reflexion: Warum wurde das Logbuch seit August nicht mehr geführt, obwohl «direkt nach dem Arbeiten dokumentieren» unsere Grundregel war? Was ändern wir bis zur Abgabe?] | Claude Code (Claude Opus 5.5). Prompts K19–K21. Texte der nachgetragenen Zeilen 20/08–21/10 hat die KI aus den Protokollen formuliert; von uns geprüft [nach Prüfung bestätigen]. Reflexionen schreiben wir selbst.

# Anhang: KI-Nachweis – Prompts im Wortlaut

Gemäss Merkblatt «Nachweis der Verwendung von KI» mit System und Version, Prompt, Datum und Art der Übernahme. Unsere eigenen Eingaben stehen im Wortlaut (inkl. Tippfehler). Eingefügte Dateien, Links und fremde Texte sind in «[eingefügt: …]» beschrieben, Namen durch [Name] ersetzt. Reine Fortsetzungsbefehle («Continue») sind nicht aufgeführt. Die vollständigen Sitzungsprotokolle liegen als digitaler Anhang bei [Export beilegen].

K1 · 12/08/26, 12:06 · Claude Code (Modell Claude Opus 5)

Hi there Claude. This Session will be primarily for noting things we do when we work on our matura projekt. We're already halfway trough it (after summerbreak), but we want to continue noting things properly,, so we'll send you messages (what we have done), notes, files etc. You'll analyze please what happened and create a dairy basicely for each day. We good?

Übernahme: Tagebuch-Ablage eingerichtet; Arbeitsweise übernommen.

K2 · 12/08/26, 12:15 · Claude Code (Modell Claude Opus 5)

1. -> Wir werden einen analogischer Synthezier bauen. Plan als phyisches Produkt ist 3 Oszillatoren, Mixer, Amplifier, Distortion, aber es kann sich immer noch etwas änderen, je nach Zeit Bedarf. + dann kommt noch Fourier Analyse von analogem und digitalen Ton und noch all die Dokumente, die wir für die Matura abgeben müssen (am 10. November).

2. -> [Name] (Ich) und [Name], aber versuche keine Namen zu verwenden.

Dann haben wir jetzt schon mal eine Sache erledigt:

Wir haben jetzt einen Zeitplan erstellt bis zu den Herbstferien mit dem Ziel: das phyische Produkt zu erledigen. Der Plan ist als Bild im Anhang (bitte speichere es als text oder was auch immer, anstatt als Bild).

Übernahme: Zeitplan aus unserem Foto abgetippt und übernommen (Inhalt von uns).

K3 · 19/08/26, 12:08 · Claude Code (Modell Claude Opus 5)

add this somewhere for our pictures of the project.

Übernahme: Bilder im Projektordner abgelegt und geordnet.

K4 · 19/08/26, 12:40 · Claude Code (Modell Claude Opus 5)

@"C:\Users\<user>\Downloads\Logbuch neu.docx"

Lowkey can you continue / fill the remaining things into this logbook? Instead of seperate files for each day, we'll just continue in this word document. So please fill any remaining stuff missing. (It's from my partner, so there might be things missing or stuff you didnt know about yet)

Übernahme: Zeile 19/08 von der KI aus unseren Angaben formuliert und übernommen; zwei Theorie-Stichworte in 12/08 ergänzt.

K5 · 19/08/26, 13:33 · Claude Code (Modell Claude Opus 5)

WE DID IT. We simulated our saw-wave circuit on https://www.falstad.com/circuit/ and it shows a saw wave with frequency control.

Please also check the Zwischenablage, i copied 2 more files (1 image for the new circuit in kicat and 1 video of the website showing the wave form and the simulated circuit)

Übernahme: Bild und Video abgelegt, Logbuch ergänzt. Simulation selbst durchgeführt.

K6 · 09/09/26, 12:30 · Claude Code (Modell Claude Opus 5)

«[eingefügt: Antwort eines anderen KI-Chats zur Fehlersuche im Mixer (Herkunft bitte bestätigen), und Link zur Falstad-Simulation]»

I mean it kind of works. But when all wave-signals are the same frequency, i can't really see the waveform, which should be created when combined for example the square and sine (/AC) waveforms.

Übernahme: Fehlerdiagnose (Quellen auf 120 V, Poti-Stellung) übernommen; Korrektur selbst in Falstad umgesetzt.

K7 · 09/09/26, 12:42 · Claude Code (Modell Claude Opus 5)

good. I now set the max voltages of the signal input sources to 1v from 5v, because it hits the powerrail/ in the scoupe i can see it getting cut off in height at some point. With 1v it doesnt get cut off. Is that fine?

Übernahme: Bestätigung übernommen.

K8 · 09/09/26, 13:14 · Claude Code (Modell Claude Opus 5)

Kicad file: C:\Users\<user>\Downloads\MaturaProjekt\KicadCircuit

in there you will find 2 schematic files of my circuit design for synthesizer. final goal: 3 oscillators, going into mixer, going through 2x filter in series, and then into amplifier. audiojack in oscillator is used to connect a single oscillator to filter (2 of these in total, separate from the others). make a new project, and create a final schematic containing everything, that is in total: 3 oscillators, 1 mixer, 4 filter, leading into amplifier. for mixer, use the schematic of the open falstad project in claude browser. for everything else, use the schematics from the files. make sure its clean, and if you have additional questions, ask. Love u <3

Übernahme: Gesamtschaltplan von der KI erstellt.

K9 · 09/09/26, 14:17 · Claude Code (Modell Claude Opus 5)

ja bitte korrigier 1-3.

Ait und bitte danach: Mache einen Schaltkreis, der alles was wir haben enthält und wie unser finales produkt sein soll.

Dabei bitte Werte beachten und falls nötig anpassen (bitte am Schluss eine Liste angeben welche Werte verändert worden sind).

Frequenz, Amplitude, Filterstärke, Für jedes Oszillatorensignal im Mixer amplitude/Effektivität verstelltbar. Und für jeden Oszillator ist die Wave-form verstellbar. -> Das sollte eigentlich schon alles möglich sein in unseren Schaltplänen, aber trotzdem nochmals kurz zur Kontrolle.

Ziel: Ein einziger finaler Final-Schaltkreis.

Übernahme: Werteanpassungen und Neuaufbau des Oszillatorkerns übernommen; Entscheidungen auf Rückfrage von uns.

K10 · 09/09/26, 18:27 · Claude Code (Modell Claude Opus 5)

Ok aber der Schaltplan ist immer noch nicht wie ich es wollte. Im moment hast du die Oszillatoren, Filter und so weiter als einzelne Bau-Schaltpläne. Ich will jedoch einen einzelen vollstänging verbunden Schaltkreis der alle unsere bis jetzigen Bau-Schaltpläne enthält. Verstehst du was ich meine? Also nicht mehr alles seperat, sondern ein einzelner verbundener Schaltplan. Das habe ich eigentlich mit "finalem Schaltplan gemeint".

Übernahme: Schaltplan zu einem durchgehend verbundenen Blatt umgebaut; übernommen.

K11 · 11/09/26, 09:48 · Claude Code (Modell Claude Opus 5)

ok lowkey can you setup the whole thing as a github project. That way I and my friend can work simultaneously. I'll do the authenticantion etc if you need them (probably), so open it in the browser where i can directly do that part.

Übernahme: GitHub-Repository eingerichtet; übernommen.

K12 · 10/09/26 – 12/09/26 · [Tool und Version ergänzen]

[Prompts der Sitzungen auf dem PC des anderen Projektmitglieds ergänzen: Schaltplan Rev. 3/4, Simulationen, Platinen-Layout. Die Sitzungen lassen sich in der Claude-App exportieren.]

Übernahme: [Art der Übernahme ergänzen]

K13 · 21/10/26, 11:23 · Claude Code (Modell Claude Opus 5.5)

@"C:\Users\<user>\Downloads\Merkblatt_Schriftlicher_Kommentar (2).pdf" @"C:\Users\<user>\Downloads\Literaturangaben 2024 (2).pdf" @"C:\Users\<user>\Downloads\Checkliste wissenschaftliche Maturaarbeiten (2).pdf" @"C:\Users\<user>\Downloads\2025_zitierregeln (1).pdf" @"C:\Users\<user>\Downloads\Verwendung von KI (1).docx" @"C:\Users\<user>\Downloads\Merkblatt_Nachweis_KI.pdf"

See that everything gets synced with github. My friend uploaded some stuff, idk if i yet uploaded all my stuff.

Übernahme: Dateien abgelegt und mit GitHub synchronisiert.

K14 · 21/10/26, 11:34 · Claude Code (Modell Claude Opus 5.5)

1. A question: Can you see my custom created skills (they were made on my pc, so idk if it reached the notebook, probably not, i don't see them), they should be called "/deepen" and "/panel".

2. So to explain the Situation: My friend has uploaded the latest work, but we are basicely done with the pcb plate and circuits, we also ordered the final pcb plate already and its on the way. So the things we need to do now is the question of our project (idk if you have our Maturaproject vertrag or something liket that should it be called), but we kind also have the comparision of a digital and an anolog sound. We should analyze it with fourrier or so, idk how exactly should we do that, but i wouldn't do it so big, since our main work was creating the analog synthesizer (we just needed a question as to why we would create this synthesizer and "understanding/fun" doesnt count for it). But since we don't have yet the pcb plate, we don't have the analog synthesizer and need to wait for it to produce actual sounds, so we can't do it fully yet, but we can at least prepare for it (how we should it, what we even do, and how big should it be (cause we only have 3 weeks left)). The 2. thing we can do is the formal stuff like the "schriftlicher kommentar" and everything that should still be done for the "abgabe".

So firstly explain th situation where we are, besides the pcb plate done and on the way

Übernahme: Standortbestimmung als Orientierung genutzt.

K15 · 21/10/26, 12:09 · Claude Code (Modell Claude Opus 5.5)

@"C:\Users\<user>\Downloads\[Namen]_Logbuch_Maturarbeit (1).docx" @"C:\Users\<user>\Downloads\Quellen (1).docx" @"C:\Users\<user>\Downloads\Zwischenbericht zur Maturaarbeit- Synthesiser.pdf" @"C:\Users\<user>\Downloads\FINAL4_MA_Vertrag_Oscillator (1).docx"

Okay wait i'll send you some more files, idk if the quelle or logbuch are just duplicates or older version or have some missing things, so we need to sync them as well.

I also sent you the "Vertrag" where you can see what our project exactly is, so i want to estimate how much we should do for the fourrier analyis, comparision between analog and digital.

I also sent you the "Zwischenbericht" that was handed out during "Zwischen Matur", but we only got grade 4 overall. Product was good, bericht and presentation was lacking. That's why we also wanted to start earlier (not on the last day, but 3 weeks before, so that we can actually do it well).

Übernahme: Dateien abgelegt; Abschätzung zum Fourier-Umfang als Orientierung.

K16 · 21/10/26, 12:45 · Claude Code (Modell Claude Opus 5.5)

@"C:\Users\<user>\Downloads\Schriftlicher Kommentar Maturarbeit Synthesizer.pdf"

<!-- reply 2 -->

> The text looked AI-generated.

that was actually annoying, since we actually wrote it ourselves.

<!-- reply -->

> (4.5, and a second one with 5.5). Maybe one of them is from a template, or the two of you got different grades. Worth asking.

no i think the product (the prototype synthesizer) was a 5.5 and the presentation and "Zwischen Schriftlicher Kommentar" was a 4.5.

Okay the Zwischenbericht was the evaluation, i sent you now the "Schriftlicher Kommentar" which we handed out for the Zwischen Matura, so you can directly see what we did there.

About the AI usage: I think we should explain and note that we used AI for value-calculation in our self designed circuits (which is true). Idk about the pcb, we used AI to design the pcb plate according to our circuits that we had. We used AI for generating the simulations in Kicad, so it could runs some tests (as i heard off, there is no default simulation you can run in kicad, but you need to write some small python programms for each component or so (i hope you can check that and then explain to me shortly how it did that). Trough these simulations it generated data sheets, where the amplifications etc. are all measured (i sent you 2 images of them). Then we used AI to keep things in track, like this current Session. I think the rest was done by ourselves.

So how should we do exactly the AI usage statement, just answer pls don't write anything yet.

Übernahme: Erklärung der Simulation und Vorschlag zur KI-Deklaration als Orientierung genutzt.

K17 · 21/10/26, 13:13 · Claude Code (Modell Claude Opus 5.5)

Ok got it.

Can you explain the whole flow of our synthesizer like how many oscillator we have, filters, when the amplifier comes etc.

Just a short answer psl

Übernahme: Erklärung des Signalflusses zum eigenen Verständnis.

K18 · 21/10/26, 13:39 · Claude Code (Modell Claude Opus 5.5)

Ok so i will start writing the Schriftlicher Kommentar a bit (not everything can be written yet, as we have not completely finished it).

My friend generated the Structure for the Kommentar, each containing some explainations about what should be written here like this part:

«[eingefügt: Abschnitt «1.3 Eingrenzung des Themas» aus der Kommentar-Gliederung des anderen Projektmitglieds]»

I now expained what our product is made of, but i hope you can give me an example how i should write it.

Übernahme: [Beispieltext zur Eingrenzung: als Inspiration oder übernommen?]

K19 · 28/10/26, 12:45 · Claude Code (Modell Claude Opus 5.5)

Where are we, what shall be done today?

Übernahme: Standortbestimmung als Orientierung genutzt.

K20 · 28/10/26, 12:49 · Claude Code (Modell Claude Opus 5.5)

board (pcb plate) did not arrive yet and we haven't really done anything further either. Ait i guess we shall catch up the logbuch. Can you first search what is expected of the logbuch content-wise and formality-wise?

Übernahme: Zusammenstellung der Anforderungen übernommen.

K21 · 28/10/26, 13:07 · Claude Code (Modell Claude Opus 5.5)

ait yeah please restructure the logbook. And for the days to fill: Im sorry but i won't be able to accurately remember, if you can please tell me what we did befor and later on that day that's missing. As you said you can also ask the other AI sessions in the MaturaProject for helping remember or maybe it even knows fully what we did on these days. You can also try to get the exact prompts (if that's needed according to the "declaring AI use"), tho i don't know if the exact prompts is suitable as they might have been some long prompts, so mabye summarizing them? Idk how exact we should/must do that.

Übernahme: Umbau des Logbuchs und nachgetragene Zeilen übernommen; Reflexionen schreiben wir selbst.

Logbuch Maturarbeit Synthesizer · Seite 1 von 1
