lukimcfly/MaturaProjekt/Schul-Unterlagen/README.md

# Schul-Unterlagen

Alles, was von der Schule kommt — nicht von uns selbst erstellt.

Zum Beispiel:
- Vorgaben und Kriterienkataloge zum Maturaprojekt
- Bewertungsraster
- Termin- und Abgabepläne
- Formulare, Vorlagen
- Handouts und Unterlagen aus dem Unterricht

**Abgabetermin Matura: 10. November 2026**

## Abgelegte Dateien

| Datei | Inhalt |
|---|---|
| `Checkliste_wissenschaftliche_Maturaarbeiten.pdf` | Checkliste für Aufbau und Form der Arbeit |
| `Merkblatt_Schriftlicher_Kommentar.pdf` | Vorgaben zum schriftlichen Kommentar |
| `Zitierregeln_2025.pdf` | Zitierregeln |
| `Literaturangaben_2024.pdf` | Format der Literaturangaben |
| `Merkblatt_Nachweis_KI.pdf` | Wie die KI-Nutzung nachgewiesen werden muss |
| `Verwendung_von_KI.docx` | Vorlage/Regeln zur Verwendung von KI |
| `Zwischenbericht_Rueckmeldung_Juni_2026.pdf` | Rückmeldung der Betreuungsperson zur Zwischenpräsentation (Teilnoten, ToDos) |
