lukimcfly/MaturaProjekt/Unsere-Materialien/Logbuch/README.md

# Logbuch

**Aktuelle Datei: `Logbuch neu.docx`** — ab jetzt wird direkt hier weitergeschrieben,
nicht mehr in getrennten Tagesdateien.

## Zwei Teile

| Datei | Zeitraum |
|---|---|
| `Logbuch alt (Maerz-Juni 2026).docx` | 11.03.2026 – 03.06.2026: Vertrag, Tiefpass, LED-Blinker, erste Square-Wave (Fliesstext, ohne Tabelle) |
| `Logbuch neu.docx` | ab 12.08.2026, Tabellenform |

Lücke: 03.06. – 12.08.2026. Die Lücke seit 19.08. wurde am 28.10.2026 aus
KI-Sitzungsprotokollen, Git-Verlauf und `diary/` nachgetragen (gelb markierte Stellen
sind noch von uns zu ergänzen). Für die Abgabe sollten beide Teile in **ein**
Dokument zusammengeführt werden.

## Aufbau (neues Logbuch)

Querformat, Seitenzahlen in der Fusszeile, Kopfzeile der Tabelle wiederholt sich
auf jeder Seite. Eine Zeile pro Arbeitstag (Nachträge beim Datum vermerkt):

| Spalte | Inhalt |
|---|---|
| Datum | Format TT/MM/JJ |
| Dauer / Wer | Zeitaufwand und Beteiligte (ohne Namen) |
| Arbeitsschritte | Was wurde gemacht |
| Ergebnisse | Was ist dabei herausgekommen, Probleme und Lösungen |
| Reflexionen | Was haben wir daraus gelernt (selbst schreiben, nicht von der KI) |
| KI-Nutzung | Tool + Version, wofür, Verweis auf Prompt-Nummer, Art der Übernahme |

Danach folgt der **Anhang «KI-Nachweis»**: jeder Prompt im Wortlaut mit Nummer (K1, K2 …),
Datum, Tool und Art der Übernahme. Die Seitenzahlen von Logbuch und Anhang kommen ins
Raster «Verwendung von KI» im schriftlichen Kommentar.

## Bisherige Einträge

| Datum | Thema |
|---|---|
| 12/08/26 | Zeitplan bis Herbstferien, Theorie (Transistoren, Kondensatoren, Op-Amps, RC, Filter, Verstärkerklassen) |
| 15/08/26 | Oszillator-Konzept: Square → Triangle → «Sine» |
| 18/08/26 | Brainstorming Saw-Wave-Oszillator |
| 19/08/26 | Saw-Wave als KiCad-Schaltplan (Schmitt-Trigger-Relaxationsoszillator), Projektablage aufgesetzt |
| 20/08–08/09/26 | Teilschaltpläne Oszillator und Filter, Mixer in Falstad (nachgetragen) |
| 09/09/26 | Mixer-Fehlersuche, Gesamtschaltplan Rev. 2, Oszillatorkern neu (nachgetragen) |
| 10/09–11/09/26 | Rev. 3/4, Fehlersuche, ngspice-Simulationen, Aufteilung in drei Platinen, GitHub (nachgetragen) |
| 12/09/26 | Platinen-Layout und Fertigungsdaten (nachgetragen) |
| 13/09–20/10/26 | Platinen bestellt, Herbstferien (nachgetragen, lückenhaft) |
| 21/10/26 | Schul-Unterlagen, Standortbestimmung, KI-Deklaration, Beginn Kommentar (nachgetragen) |
| 28/10/26 | Anforderungen ans Logbuch, Logbuch umgebaut und nachgeführt |

## Hinweis

Die Ordner `diary/`, `plan/`, `quellen/` und `Bilder/` sind Zuarbeit und
Nachschlagewerk — das abgabefertige Dokument ist diese Word-Datei.
