lukimcfly/MaturaProjekt/Unsere-Materialien/Schriftlicher-Kommentar/README.md

# Schriftlicher Kommentar

Die schriftliche Arbeit zum Projekt.

Laut Zeitplan ist dafür Zeit in KW 38 und KW 39 vorgesehen
(„wenn Zeit, schriftlicher Kommentar") — siehe `plan/zeitplan-bis-herbstferien.md`.

Zuarbeit:
- `quellen/lernmaterial.md` → Quellenverzeichnis
- `diary/` → Nachweis des Arbeitsprozesses

_Noch keine Dateien abgelegt._
