lukimcfly/MaturaProjekt/KI-Protokolle/2026-08-12_06351956.md

# Sitzung 06351956

- Sitzungs-ID: `06351956-4a56-4b25-9bc4-52c81aceafa9`
- Zeitraum: 2026-08-12 bis 2026-08-19
- Modell(e): claude-opus-5
- Nutzer-Prompts: 12

> Lesbare Fassung: Prompts und Antworten im Wortlaut, Werkzeugaufrufe nur als Kurzzeile, Werkzeug-Ausgaben weggelassen.

---
### 🧑 Nutzer · 2026-08-12 12:06 UTC

Hi there Claude. This Session will be primarily for noting things we do when we work on our matura projekt. We're already halfway trough it (after summerbreak), but we want to continue noting things properly,, so we'll send you messages (what we have done), notes, files etc. You'll analyze please what happened and create a dairy basicely for each day. We good?

- *Werkzeug: PowerShell* — List project directory contents
- *Werkzeug: Read* — C:\Users\<user>\.claude\projects\C--Users-<user>-Downloads-MaturaProjekt\memory\MEMORY.md
- *Werkzeug: AskUserQuestion* — 
- *Werkzeug: Write* — C:\Users\<user>\Downloads\MaturaProjekt\diary\README.md
- *Werkzeug: Write* — C:\Users\<user>\Downloads\MaturaProjekt\diary\_vorlage.md
- *Werkzeug: Write* — C:\Users\<user>\.claude\projects\C--Users-<user>-Downloads-MaturaProjekt\memory\matura-diary-workflow.md
- *Werkzeug: Write* — C:\Users\<user>\.claude\projects\C--Users-<user>-Downloads-MaturaProjekt\memory\MEMORY.md

**🤖 Claude:**

We're good. Setup is done:

- [diary/README.md](diary/README.md) — Index, wird bei jedem Eintrag ergänzt
- [diary/_vorlage.md](diary/_vorlage.md) — Struktur pro Tag: Ziel, Was gemacht wurde, Ergebnisse, Probleme & Lösungen, offene Punkte
- Einträge kommen als `diary/2026-08-12.md` usw.

Ich hab mir gemerkt, dass diese Session dafür da ist — auf Deutsch, eine Datei pro Tag.

**So läuft's ab:** Schick mir einfach, was ihr gemacht habt — formlos, Stichworte, Screenshots, Code, Dateien, egal. Ich sortiere das und schreibe den Eintrag. Wenn ihr das Datum nicht dazuschreibt, nehme ich den heutigen Tag an.

Zwei Dinge, die mir noch fehlen:

1. **Worum geht's im Projekt?** Ein paar Sätze reichen — Thema, Ziel, Technologien. Damit ich die Einträge fachlich richtig formulieren kann statt nur eure Worte umzuschreiben.
2. **Wer arbeitet mit?** Namen bzw. Kürzel der Teammitglieder, damit ich "Beteiligt:" korrekt ausfüllen kann.

Und falls ihr aus der Zeit vor den Ferien noch Notizen habt, die ins Tagebuch sollen: die können wir nachträglich als Einträge mit dem passenden Datum anlegen.

---
### 🧑 Nutzer · 2026-08-12 12:15 UTC

1. -> Wir werden einen analogischer Synthezier bauen. Plan als phyisches Produkt ist 3 Oszillatoren, Mixer, Amplifier, Distortion, aber es kann sich immer noch etwas änderen, je nach Zeit Bedarf. + dann kommt noch Fourier Analyse von analogem und digitalen Ton und noch all die Dokumente, die wir für die Matura abgeben müssen (am 10. November).
2. -> [Name] (Ich) und [Name], aber versuche keine Namen zu verwenden.

Dann haben wir jetzt schon mal eine Sache erledigt:
Wir haben jetzt einen Zeitplan erstellt bis zu den Herbstferien mit dem Ziel: das phyische Produkt zu erledigen. Der Plan ist als Bild im Anhang (bitte speichere es als text oder was auch immer, anstatt als Bild).

- *Werkzeug: PowerShell* — Compute calendar week date ranges for 2026
- *Werkzeug: Write* — C:\Users\<user>\Downloads\MaturaProjekt\plan\zeitplan-bis-herbstferien.md
- *Werkzeug: Write* — C:\Users\<user>\Downloads\MaturaProjekt\diary\2026-08-12.md
- *Werkzeug: Edit* — C:\Users\<user>\Downloads\MaturaProjekt\diary\README.md
- *Werkzeug: Write* — C:\Users\<user>\.claude\projects\C--Users-<user>-Downloads-MaturaProjekt\memory\matura-projekt-inhalt.md
- *Werkzeug: Edit* — C:\Users\<user>\.claude\projects\C--Users-<user>-Downloads-MaturaProjekt\memory\MEMORY.md

**🤖 Claude:**

Erledigt. Zwei Dateien sind entstanden:

**[plan/zeitplan-bis-herbstferien.md](plan/zeitplan-bis-herbstferien.md)** — der handschriftliche Plan als Text, mit den echten Kalenderdaten dazu:

| KW | Datum | Budget | Schwerpunkt |
|---|---|---|---|
| 33 | 10.–16.08. | 7 h | Theorie, Teile bestellen |
| 34 | 17.–23.08. | 10 h | Theorie, Produktskizze, Komponentenrecherche |
| 35 | 24.–30.08. | 12 h | Systemkomponenten skizzieren |
| 36 | 31.08.–06.09. | 10 h | KiCad-Schaltplan, Simulationen |
| 37 | 07.–13.09. | 14 h | Breadboard-Aufbau, Fehlerbehebung |
| 38 | 14.–20.09. | 14 h | PCB entwerfen & bestellen |
| 39 | 21.–27.09. | Puffer | schriftlicher Kommentar |

Gesamt ca. 67 h. Die Korrektur 10 h → 6 h in KW 34 und die gestrichene Pufferwoche in KW 38 sind als Fußnoten drin, damit die Planungsentscheidungen nachvollziehbar bleiben.

**[diary/2026-08-12.md](diary/2026-08-12.md)** — der Tagebucheintrag: Projektumfang, Zeitplanerstellung, Wiederaufnahme der Dokumentation. Ohne Namen, wie gewünscht.

Ich hab mir Projektinhalt, Abgabetermin (10.11.2026) und die Namensregel gemerkt.

**Drei Punkte, bei denen ich nicht raten wollte:**

1. Zwei Zeilen stehen im Blatt *oberhalb* der Wochenüberschrift, wirken nachträglich eingefügt: „Komponenten testen (2 h)" über KW 36 und „Komponenten kombinieren & testen (4 h)" über KW 37. Gehören die zur Woche darüber oder darunter? Ich hab sie vorläufig der jeweils früheren Woche zugeordnet und markiert.
2. Wie viele Stunden habt ihr heute für Planung + Doku-Setup gebraucht? Steht aktuell als „nicht erfasst".
3. Hinter „Teile bestellen" in KW 33 steht ein Zeichen, das ich nicht sicher lesen kann — Häkchen (schon erledigt) oder Ausrufezeichen (wichtig)?

---
### 🧑 Nutzer · 2026-08-12 13:12 UTC

https://www.youtube.com/watch?v=uXr4lXYjXuU&list=PL0o_zxa4K1BV9E-N8tSExU1djL6slnjbL&index=1&pp=iAQB
https://www.youtube.com/watch?v=ImpJUHenhTM&list=PL0o_zxa4K1BV9E-N8tSExU1djL6slnjbL&index=42&pp=iAQB
https://youtu.be/PLQrPqYlPmI?list=PL0o_zxa4K1BV9E-N8tSExU1djL6slnjbL

Some videos i watched

---
### 🧑 Nutzer · 2026-08-12 13:13 UTC

[Request interrupted by user]

---
### 🧑 Nutzer · 2026-08-12 13:17 UTC

ah und für vorhin:

1. -> ja ist gut so, wie du es gemacht hast.
2. -> Planung: ungefähr halb stunde
3. ->Ausrufe zeichen

- *Werkzeug: Edit* — C:\Users\<user>\Downloads\MaturaProjekt\diary\2026-08-12.md
- *Werkzeug: ToolSearch* — 
- *Werkzeug: Edit* — C:\Users\<user>\Downloads\MaturaProjekt\plan\zeitplan-bis-herbstferien.md
- *Werkzeug: Edit* — C:\Users\<user>\Downloads\MaturaProjekt\diary\2026-08-12.md
- *Werkzeug: WebFetch* — https://www.youtube.com/watch?v=uXr4lXYjXuU
- *Werkzeug: WebFetch* — https://www.youtube.com/watch?v=ImpJUHenhTM
- *Werkzeug: WebFetch* — https://www.youtube.com/watch?v=PLQrPqYlPmI
- *Werkzeug: WebFetch* — https://www.youtube.com/playlist?list=PL0o_zxa4K1BV9E-N8tSExU1djL6slnjbL
- *Werkzeug: WebFetch* — https://www.youtube.com/oembed?url=https%3A//www.youtube.com/watch%3Fv%3DuXr4lXYjXuU&format=json
- *Werkzeug: WebFetch* — https://www.youtube.com/oembed?url=https%3A//www.youtube.com/watch%3Fv%3DImpJUHenhTM&format=json
- *Werkzeug: WebFetch* — https://www.youtube.com/oembed?url=https%3A//www.youtube.com/watch%3Fv%3DPLQrPqYlPmI&format=json
- *Werkzeug: Write* — C:\Users\<user>\Downloads\MaturaProjekt\quellen\lernmaterial.md
- *Werkzeug: Edit* — C:\Users\<user>\Downloads\MaturaProjekt\diary\2026-08-12.md
- *Werkzeug: Edit* — C:\Users\<user>\Downloads\MaturaProjekt\diary\2026-08-12.md
- *Werkzeug: Edit* — C:\Users\<user>\Downloads\MaturaProjekt\diary\README.md

**🤖 Claude:**

Antworten eingearbeitet: Dauer auf 0,5 h gesetzt, „Teile bestellen (!)" als dringend markiert (mit Begründung — ab KW 35 hängt alles am Eintreffen der Bauteile), und die Frage zu den Testblöcken ist raus.

Zu den Videos — alle drei sind von *The Organic Chemistry Tutor*:

1. **Basic Electronics For Beginners** (Playlist-Nr. 1)
2. **How Do Capacitors Work?** (Nr. 42)
3. **RC Circuits Physics Problems, Time Constant Explained, Capacitor Charging and Discharging**

Neu angelegt: **[quellen/lernmaterial.md](quellen/lernmaterial.md)** — eine laufende Quellensammlung. Die lohnt sich, weil ihr das später als Quellenverzeichnis für die schriftliche Arbeit braucht und es rückwirkend mühsam zusammenzusuchen ist.

Im Tagebuch stehen sie jetzt unter der KW-33-Aufgabe „Theorie verfestigen", mit dem Bezug zum Projekt: die RC-Zeitkonstante τ = R·C ist die Grundlage sowohl für eure Filterstufen als auch für die zeitbestimmenden Glieder der Oszillatoren.

**Zwei Sachen zum Nachtragen:**

- **Wie lange** habt ihr geschaut? Zählt aufs KW-33-Budget von 7 h.
- **Wann** — heute, oder an einem anderen Tag? Ich hab's vorläufig unter den 12.08. gelegt; wenn's ein anderer Tag war, verschiebe ich es in einen eigenen Eintrag.

Und falls die Playlist-Nummern (1 und 42) heißen, dass ihr nicht der Reihe nach geht, sondern gezielt Themen rauspickt: sag Bescheid, dann notiere ich in der Quellendatei zusätzlich, *warum* ihr welches Video ausgewählt habt. Das ist für die Doku wertvoller als eine reine Linkliste.

---
### 🧑 Nutzer · 2026-08-12 14:33 UTC

Wie lange habt ihr geschaut? -> 1/2 stunden
Wann: Wenn ich kein Datum angebe, dann an dem Tag, an dem ich dir schreibe (Heute)

https://youtu.be/pWOiOUSQvZc?list=PL0o_zxa4K1BV9E-N8tSExU1djL6slnjbL
https://youtu.be/lagfhNjMuQM?list=PL0o_zxa4K1BV9E-N8tSExU1djL6slnjbL
https://youtu.be/J4oO7PT_nzQ
https://www.youtube.com/watch?v=0e_OUyGCaBs&list=PL0o_zxa4K1BV9E-N8tSExU1djL6slnjbL&index=111&pp=iAQB
https://www.youtube.com/watch?v=0e_OUyGCaBs&list=PL0o_zxa4K1BV9E-N8tSExU1djL6slnjbL&index=111&pp=iAQB
+ another 1-2 hours.

- *Werkzeug: WebFetch* — https://www.youtube.com/oembed?url=https%3A//www.youtube.com/watch%3Fv%3DpWOiOUSQvZc&format=json
- *Werkzeug: WebFetch* — https://www.youtube.com/oembed?url=https%3A//www.youtube.com/watch%3Fv%3DlagfhNjMuQM&format=json
- *Werkzeug: WebFetch* — https://www.youtube.com/oembed?url=https%3A//www.youtube.com/watch%3Fv%3DJ4oO7PT_nzQ&format=json
- *Werkzeug: WebFetch* — https://www.youtube.com/oembed?url=https%3A//www.youtube.com/watch%3Fv%3D0e_OUyGCaBs&format=json
- *Werkzeug: Write* — C:\Users\<user>\Downloads\MaturaProjekt\quellen\lernmaterial.md
- *Werkzeug: Edit* — C:\Users\<user>\Downloads\MaturaProjekt\diary\2026-08-12.md
- *Werkzeug: Edit* — C:\Users\<user>\Downloads\MaturaProjekt\diary\2026-08-12.md
- *Werkzeug: Edit* — C:\Users\<user>\Downloads\MaturaProjekt\diary\2026-08-12.md
- *Werkzeug: Edit* — C:\Users\<user>\.claude\projects\C--Users-<user>-Downloads-MaturaProjekt\memory\matura-diary-workflow.md

**🤖 Claude:**

Nachgetragen. Die vier neuen Videos:

- **AC vs DC** — Gleich- vs. Wechselspannung
- **Low Pass Filters and High Pass Filters – RC and RL Circuits** — Grenzfrequenz f_g = 1/(2πRC)
- **Transistors Explained** (The Engineering Mindset — der einzige aus einem anderen Kanal)
- **Transistor Amplifiers – Class A, AB, B, & C Circuits** — Verstärkerklassen

Den letzten Link hattest du doppelt geschickt, ist nur einmal drin.

Der Tageseintrag hat die Theorie jetzt in zwei Blöcken (je 1–2 h). In [quellen/lernmaterial.md](quellen/lernmaterial.md) sind die Videos nach Thema gruppiert statt nach Playlist-Nummer, plus eine Tabelle **Theorie → Baugruppe**:

| Baugruppe | Stand |
|---|---|
| Oszillatoren | Grundlagen da, Oszillatorschaltungen offen |
| Filter | passive Filter behandelt, aktive offen |
| Mixer | offen — Operationsverstärker/Summierverstärker fehlt |
| Amplifier | behandelt |
| Distortion | teilweise (über Verstärkerklassen) |

Die Tabelle zeigt euch beim nächsten Mal direkt, welches Thema als Nächstes dran ist — offen sind vor allem **Operationsverstärker** (braucht ihr für den Mixer) und **Oszillatorschaltungen**.

Datumsregel ist gemerkt: kein Datum = Tag der Nachricht, ich frage nicht mehr nach.

Eine Rückfrage noch: „1/2 stunden" hab ich als **1–2 Stunden** gelesen (wegen dem „+ another 1-2 hours" danach), nicht als halbe Stunde. Damit steht der Tag bei ca. 2–4 h Theorie. Falls du eine halbe Stunde gemeint hast, sag kurz Bescheid — dann korrigiere ich auf ca. 1,5–2,5 h gesamt.

---
### 🧑 Nutzer · 2026-08-12 14:49 UTC

nein prima. Du hast alles gut (perfekt) gemacht. Ich bin schriebe retarded.
Kannst du noch ein paar andere Folders machen:
Schul-unterlagen
Unsere Materialien (Logbuch, Schriftlicher Kommentar)

I will send you the files later.

- *Werkzeug: Write* — C:\Users\<user>\Downloads\MaturaProjekt\Schul-Unterlagen\README.md
- *Werkzeug: Write* — C:\Users\<user>\Downloads\MaturaProjekt\Unsere-Materialien\README.md
- *Werkzeug: Write* — C:\Users\<user>\Downloads\MaturaProjekt\Unsere-Materialien\Logbuch\README.md
- *Werkzeug: Write* — C:\Users\<user>\Downloads\MaturaProjekt\Unsere-Materialien\Schriftlicher-Kommentar\README.md
- *Werkzeug: Write* — C:\Users\<user>\Downloads\MaturaProjekt\README.md
- *Werkzeug: PowerShell* — Show full project file tree

**🤖 Claude:**

Ordner sind angelegt:

```
MaturaProjekt/
├── README.md                      ← Übersicht über alles
├── diary/                         ← Arbeitstagebuch, eine Datei pro Tag
├── plan/                          ← Zeitpläne
├── quellen/                       ← Lernmaterial → später Quellenverzeichnis
├── Schul-Unterlagen/              ← alles von der Schule
└── Unsere-Materialien/
    ├── Logbuch/
    └── Schriftlicher-Kommentar/
```

In jedem Ordner liegt eine kurze README, die sagt was reingehört — dann wisst ihr beide später noch, wo was hinkommt.

Zwei Sachen, die ich dabei entschieden habe:

- **Bindestriche statt Leerzeichen** in den Ordnernamen (`Unsere-Materialien` statt „Unsere Materialien"). Macht Pfade und Links unproblematisch. Wenn du die Leerzeichen lieber hast, benenne ich um.
- **`diary/` bleibt getrennt vom `Logbuch/`.** Das `diary/` ist die formlose laufende Mitschrift, das `Logbuch/` wird die Reinfassung für die Abgabe. So könnt ihr im Tagebuch schreiben wie ihr wollt, ohne dass es gleich abgabetauglich klingen muss — das Umformulieren mache ich später daraus.

Schick die Dateien einfach wenn du sie hast, ich sortiere sie ein.

Und keine Sorge wegen dem Schreiben — genau dafür bin ich da. Du schickst Stichworte, ich mache Fließtext draus.

---
### 🧑 Nutzer · 2026-08-19 12:08 UTC

add this somewhere for our pictures of the project.

- *Werkzeug: Bash* — Create image folder structure
- *Werkzeug: Bash* — Write Bilder README with index and description
- *Werkzeug: Bash* — Add Bilder to top-level README table
- *Werkzeug: Bash* — Add schematic section to diary entry

**🤖 Claude:**

Bilder-Ordner ist da:

```
Bilder/
├── README.md          ← Index + Beschreibungen
├── Schaltplaene/      ← KiCad, PCB-Layouts
├── Aufbau/            ← Breadboard, Bauteile, Gehäuse
└── Messungen/         ← Oszi-Screenshots, Spektren
```

**Eine Sache musst du selbst machen:** Das Bild aus dem Chat kann ich nicht auf die Festplatte schreiben — ich sehe es, habe aber keinen Zugriff auf die Datei. Speicher es bitte hier ab:

```
C:\Users\<user>\Downloads\MaturaProjekt\Bilder\Schaltplaene\2026-08-12_oszillator-schmitt-trigger.png
```

Der Index in [Bilder/README.md](Bilder/README.md) zeigt schon auf diesen Pfad. Namensschema ist `JJJJ-MM-TT_kurzbeschreibung.png` — dann sortiert sich alles chronologisch und lässt sich dem Tagebucheintrag zuordnen.

**Zum Schaltplan** habe ich Bauteilliste und Funktionsprinzip in Textform festgehalten, damit es auch ohne Bild lesbar ist: 74LVC2G17 Schmitt-Trigger, C4 als Zeitglied, Q4 NPN mit RB 270 Ω an der Basis, RHigh 20 kΩ, RLow 270 Ω. Das ist ein **Relaxationsoszillator** — genau die τ = R·C-Theorie aus euren Videos in einer echten Schaltung. Steht so auch im Tagebucheintrag, das ist eine gute Stelle für die Doku: Theorie → Anwendung nachvollziehbar.

Zwei Rückfragen:

1. **Was macht Q4 genau?** Aus dem Ausschnitt allein sehe ich es nicht sicher — Kollektor liegt an +VDC, Emitter über RLow nach Masse, das sieht nach Emitterfolger aus, aber die Verbindung zum Kondensatorknoten fehlt im Bild. Umschalten der Ladegeschwindigkeit? Frequenzsteuerung? Steht als offener Punkt drin, bis du es mir sagst.
2. Der Schaltplan ist laut Zeitplan eigentlich **KW-36-Arbeit** — ihr seid da also drei Wochen vor Plan, oder das ist ein älterer Entwurf. Was von beidem? Falls ersteres, hätte das Auswirkungen auf den Zeitplan und wäre eine gute Notiz fürs Logbuch.

---
### 🧑 Nutzer · 2026-08-19 12:40 UTC

@"C:\Users\<user>\Downloads\Logbuch neu.docx"
Lowkey can you continue / fill the remaining things into this logbook? Instead of seperate files for each day, we'll just continue in this word document. So please fill any remaining stuff missing. (It's from my partner, so there might be things missing or stuff you didnt know about yet)

- *Werkzeug: Skill* — 
- *Werkzeug: Bash* — Check the docx file exists
- *Werkzeug: Bash* — Convert logbook docx to markdown and read it
- *Werkzeug: Bash* — Unpack the docx
- *Werkzeug: Bash* — Extract text and table structure from the logbook
- *Werkzeug: Bash* — Merge runs and inspect table XML structure
- *Werkzeug: Bash* — Install defusedxml and inspect table XML
- *Werkzeug: Bash* — Print last table row XML
- *Werkzeug: Bash* — Inspect the 12/08 row to see list formatting
- *Werkzeug: Bash* — Insert new logbook row and missing theory bullets
- *Werkzeug: Bash* — Repackage and validate the docx
- *Werkzeug: Bash* — Repackage docx preserving entry order and validate
- *Werkzeug: Bash* — Install lxml and validate output docx
- *Werkzeug: Bash* — Validate output docx with utf-8 console
- *Werkzeug: Bash* — Render docx to images for visual check
- *Werkzeug: PowerShell* — Convert docx to pdf with LibreOffice
- *Werkzeug: Bash* — Verify final table content
- *Werkzeug: Bash* — Copy updated logbook into project folder
- *Werkzeug: Bash* — Update Logbuch README
- *Werkzeug: Bash* — Sync source/status files with logbook facts
- *Werkzeug: Bash* — Update memory with new logbook workflow
- *Werkzeug: SendUserFile* — 

**🤖 Claude:**

Logbuch ist ergänzt. **Wichtig:** Ich habe deine Originaldatei in `Downloads` **nicht** überschrieben — die aktualisierte Version liegt jetzt am richtigen Platz:

`Unsere-Materialien\Logbuch\Logbuch neu.docx`

## Was ich ergänzt habe

**Neue Zeile 19/08/26** (heute war leer):
- *Arbeitsschritte:* Saw-Wave-Idee vom 18/08 als KiCad-Schaltplan umgesetzt, Recherche zu Schmitt-Trigger-Relaxationsoszillatoren, Projektablage aufgesetzt
- *Ergebnisse:* Oszillatorstufe mit 74LVC2G17, C4 und Q4 — inklusive Funktionsprinzip
- *Reflexionen:* drei Punkte, siehe unten

**Zwei Stichworte in der 12/08-Theorieliste** ergänzt, die in eurer Aufzählung fehlten, aber in den Videos vorkamen: *Tief-/Hochpassfilter (Grenzfrequenz)* und *Verstärkerklassen (Class A, AB, B, C)*. Sonst habe ich an den Einträgen deines Partners nichts angefasst.

## Der Schaltplan ergibt jetzt Sinn

Durch die Einträge deines Partners hat sich meine offene Frage von vorhin von selbst beantwortet. Das 18/08-Brainstorming zum **Saw-Wave** passt exakt zu dem Bild: **RHigh 20 kΩ lädt den Kondensator langsam, Q4 entlädt ihn über RLow 270 Ω schnell.** Ladezeit ≈ 74× länger als Entladezeit — und genau diese Asymmetrie macht aus dem Dreieck einen Sägezahn. Das ist die Rolle von Q4.

Das steht so in der Reflexionsspalte, weil es eine echte Erkenntnis ist und nicht nur eine Tätigkeit — sowas zählt bei der Bewertung.

## Zwei Dinge zur Kenntnis

1. **Ich konnte das Dokument nicht visuell prüfen** — LibreOffice ist auf dem Rechner nicht installiert, ich kann kein PDF rendern. Die XML-Validierung ist sauber durchgelaufen und ich habe den Text nach dem Zusammenbauen wieder ausgelesen (Tabelle, Reihenfolge, Umlaute, Aufzählungen stimmen). Wirf trotzdem einmal selbst einen Blick rein, bevor du dich drauf verlässt.

2. **13., 14., 16. und 17.08. sind leer.** Da habe ich keine Informationen und wollte nichts erfinden. Falls an den Tagen was lief, schick es mir und ich trage es nach.

Ab jetzt schreibe ich neue Tage direkt als Tabellenzeile in dieses Word-Dokument statt in einzelne Dateien — ist gemerkt. Der `diary/`-Ordner bleibt als Detailablage bestehen (ausführliche Notizen, Quellenlinks, Begründungen), damit ihr beim schriftlichen Kommentar mehr Material habt als die knappen Logbuchzeilen.

---
### 🧑 Nutzer · 2026-08-19 13:07 UTC

https://youtu.be/CKaDxZrjaGA

- *Werkzeug: WebFetch* — https://www.youtube.com/oembed?url=https%3A//www.youtube.com/watch%3Fv%3DCKaDxZrjaGA&format=json
- *Werkzeug: Bash* — Add mixer video content to 19/08 logbook row
- *Werkzeug: Bash* — Repack and validate updated logbook
- *Werkzeug: Bash* — Install updated logbook and verify last row
- *Werkzeug: Bash* — Add mixer video to sources and update status table
- *Werkzeug: SendUserFile* — 

**🤖 Claude:**

**Transistor Audio Mixer Circuit** (The Organic Chemistry Tutor) — eingetragen in die 19/08-Zeile und in die Quellensammlung.

Das schliesst eine Lücke: Der **Mixer** stand bei euch bisher als einzige Baugruppe komplett offen. Jetzt steht in den Ergebnissen, wie er funktioniert — je ein Widerstand pro Kanal auf einen gemeinsamen Knoten, danach eine Transistorstufe zur Verstärkung. Praktischer Nebeneffekt: über die Widerstandswerte stellt ihr gleich die Kanallautstärken gegeneinander ein.

Damit sieht der Stand so aus:

| Baugruppe | Theorie |
|---|---|
| Oszillatoren | Konzept + Saw-Schaltplan |
| Mixer | ✔ neu |
| Amplifier | ✔ |
| Distortion | teilweise |
| Filter | passiv ✔, aktiv offen |

In den Reflexionen steht ein Punkt, den ich für die Bewertung für wertvoll halte: Beim Oszillator *und* beim Mixer habt ihr jeweils eine Aufgabe, die ihr zuerst dem Op-Amp zugedacht hattet, mit einem Transistor gelöst. Daraus wird eine echte Entwurfsentscheidung — möglichst wenige verschiedene Bauteile, oder pro Baugruppe die sauberste Lösung. Genau solche begründeten Abwägungen sind das, was einen Kommentar von einer reinen Tätigkeitsliste unterscheidet.

Bleibt als grösste offene Theorie-Lücke: **aktive Filter**. Das ist laut Zeitplan ohnehin bald dran.

---
### 🧑 Nutzer · 2026-08-19 13:13 UTC

btw why can't you store images that i sent you into folders? Could we try again?

**🤖 Claude:**

Gute Frage — die Antwort ist technisch, aber es gibt eine Lösung.

**Warum es nicht geht:** Wenn du ein Bild in den Chat einfügst, kommt es bei mir als Bild an, das ich anschauen kann — aber es liegt keine Datei auf deiner Festplatte, auf die ich zugreifen könnte. Ich könnte höchstens versuchen, das Bild aus dem Gedächtnis „nachzuzeichnen", und das wäre dann eine Fälschung, keine Kopie. Für einen Schaltplan im Logbuch wäre das ziemlich schlecht.

**Aber:** Wenn die Datei irgendwo bei dir liegt oder noch in der Zwischenablage ist, kann ich sehr wohl ran. Lass mich schauen.

- *Werkzeug: PowerShell* — Find recent image files in common folders
- *Werkzeug: Read* — C:\Users\<user>\Pictures\Screenshots\Screenshot 2026-08-19 141116.png

**🤖 Claude:**

Gefunden. Ein Screenshot von heute 14:11 — und der ist neu, den hatte ich noch nicht gesehen:

- *Werkzeug: PowerShell* — Copy schematic screenshot into project images folder
- *Werkzeug: PowerShell* — Test whether clipboard image access works

**🤖 Claude:**

Und die Zwischenablage hat auch noch ein Bild drin (717×815). Mal sehen, was das ist:

- *Werkzeug: PowerShell* — Save clipboard image to scratchpad for inspection
- *Werkzeug: Read* — C:\Users\<user>\AppData\Local\Temp\claude\C--Users-<user>-Downloads-MaturaProjekt\06351956-4a56-4b25-9bc4-52c81aceafa9\scratchpad\clip.png

**🤖 Claude:**

Das ist eine **neuere Revision** desselben Oszillators — mit anderen Werten. Ich speichere beide:

- *Werkzeug: PowerShell* — Save clipboard schematic into images folder
- *Werkzeug: Bash* — Write clipboard-save helper script
- *Werkzeug: Bash* — Rewrite Bilder README with both images documented
- *Werkzeug: Bash* — Update logbook with revision 2 values and frequency estimate
- *Werkzeug: Bash* — Repack, validate, install updated logbook
- *Werkzeug: SendUserFile* — 

**🤖 Claude:**

Ja, es hat geklappt — auf zwei Wegen.

## Warum Chat-Bilder nicht gehen

Ein eingefügtes Bild kommt bei mir als Bild an, nicht als Datei. Ich sehe es, aber es gibt nichts zu kopieren. Ich könnte es nur „nachmalen", und das wäre bei einem Schaltplan eine Fälschung.

## Was stattdessen funktioniert

**1. Dateien auf der Platte** — ich habe in `Pictures\Screenshots` gesucht und deinen Screenshot von 14:11 gefunden. Direkt kopiert.

**2. Die Zwischenablage** — da lag noch ein Bild drin, und das kann ich auslesen und als PNG speichern. Beide liegen jetzt in `Bilder\Schaltplaene\`.

Für die Zukunft habe ich dir [Bilder/zwischenablage-speichern.ps1](Bilder/zwischenablage-speichern.ps1) geschrieben. Bild kopieren, dann:

```bash
.\Bilder\zwischenablage-speichern.ps1 saw-oszillator-v3
```

Datum kommt automatisch davor. Alternativ: einfach sagen „liegt in der Zwischenablage", dann hole ich es.

## Das Bild aus der Zwischenablage war neu

Das ist eine **zweite Revision** mit anderen Werten — RHigh **5 kΩ** statt 20 k, RLow und RB **220 Ω**, C4 jetzt konkret **100 nF**, und neu ein **RVar 0–25 kΩ** im Ladepfad zur Tonhöheneinstellung. Ich habe die alten Werte im Logbuch entsprechend korrigiert.

## Dabei ist mir etwas aufgefallen

Mit den jetzt konkreten Werten lässt sich die Frequenz ausrechnen:

$$t_{lade} = (R_{Var} + R_{High}) \cdot C_4 \cdot \ln\frac{V_{CC} - V_{T-}}{V_{CC} - V_{T+}}$$

Bei 5 V Versorgung und den Datenblatt-Schwellen (V_T+ ≈ 2,4 V, V_T− ≈ 1,4 V):

| RVar | Ladezeit | Frequenz |
|---|---|---|
| 0 Ω | 163 µs | **≈ 5,7 kHz** |
| 25 kΩ | 977 µs | **≈ 1,0 kHz** |

**Der Bereich liegt zu hoch.** 1–5,7 kHz ist eher Pfeifen als Musik, und es sind nur ~2,5 Oktaven. Mit **C4 = 1 µF** verschiebt sich alles proportional auf **etwa 100–570 Hz** — das ist ein brauchbarer Grundtonbereich.

Die Rechnung steht im Logbuch. Zwei Vorbehalte: Ich habe **5 V** angenommen (steht nirgends) und die typischen Datenblattschwellen des 74LVC2G17 — bei 3,3 V kommen andere Werte raus. Prüft das mit eurer tatsächlichen Versorgungsspannung nach, bevor ihr C4 bestellt.

Das ist genau die Art Fund, die vor dem Löten mehr wert ist als danach — und laut eurem Zeitplan steht das Teilebestellen ja diese Woche an.

---
### 🧑 Nutzer · 2026-08-19 13:33 UTC

WE DID IT. We simulated our saw-wave circuit on https://www.falstad.com/circuit/ and it shows a saw wave with frequency control. 
Please also check the Zwischenablage, i copied 2 more files (1 image for the new circuit in kicat and 1 video of the website showing the wave form and the simulated circuit)

**🤖 Claude:**

Gratulation! Lass mich nachschauen — bei zwei Dateien liegen die vermutlich als Datei-Referenzen in der Zwischenablage, nicht als Bild:

- *Werkzeug: PowerShell* — Inspect clipboard formats and file list

**🤖 Claude:**

Ein File ist drin — das Video. Das Bild ist nicht mehr da (die Zwischenablage hält immer nur das Zuletztkopierte). Ich schaue im WhatsApp-Ordner nach:

- *Werkzeug: PowerShell* — Find recent WhatsApp transfers and screenshots
- *Werkzeug: PowerShell* — Get full path of the WhatsApp image
- *Werkzeug: Read* — C:\Users\<user>\AppData\Local\Packages\5319275A.WhatsAppDesktop_cv1g1gvanyjgm\LocalState\sessions\8B7485B6E0442CF85C4FCED9ECEACFFF7ACFD02A\transfers\2026-34\What

**🤖 Claude:**

Beide gefunden. Das Bild ist allerdings **identisch** mit dem, das ich vorhin schon aus der Zwischenablage geholt habe (gleiche Werte, gleicher Schaltplan) — also kein neuer Stand. Das Video kopiere ich rein:

- *Werkzeug: PowerShell* — Copy simulation video and check for ffmpeg

**🤖 Claude:**

Video liegt drin (27,5 MB). **Ansehen kann ich es nicht** — ffmpeg ist nicht installiert, ich kann keine Einzelbilder rausziehen. Ich dokumentiere es also nach deiner Beschreibung, nicht nach eigener Prüfung.

- *Werkzeug: Bash* — Add Falstad simulation success to logbook
- *Werkzeug: Bash* — Repack, validate, install logbook
- *Werkzeug: Bash* — Update image index and sources with simulation and tools
- *Werkzeug: SendUserFile* — 

**🤖 Claude:**

Stark — der Oszillator ist der Teil, den ihr am wenigsten aus Vorlagen übernommen habt, und ausgerechnet der läuft.

## Was ich gefunden habe

| Datei | Status |
|---|---|
| Video (27,5 MB) | → `Bilder\Messungen\2026-08-19_falstad-simulation-saegezahn.mp4` |
| Bild | **identisch** mit dem, das ich vorhin aus der Zwischenablage hatte — kein neuer Stand |

Beide lagen im WhatsApp-Ordner. In der Zwischenablage war nur das Video: Windows hält immer nur das Zuletztkopierte, zwei Dateien nacheinander kopieren überschreibt sich.

## Was ich nicht konnte

**Das Video habe ich nicht gesehen.** ffmpeg ist nicht installiert, ich kann keine Einzelbilder extrahieren. Alles, was ich dazu ins Logbuch geschrieben habe, stammt aus deiner Beschreibung — Sägezahn und funktionierende Frequenzregelung — nicht aus eigener Prüfung. Das solltest du wissen, falls in der Aufnahme etwas anderes zu sehen ist als du erinnerst.

## Im Logbuch steht jetzt

Bei *Ergebnisse*: Simulation bestätigt die Schaltung, erster Funktionsnachweis. Bei *Reflexionen* zwei Punkte — dass Simulieren vor dem Aufbauen sich sofort ausgezahlt hat und ihr für Mixer, Amplifier, Distortion und Filter genauso vorgeht (rechnen → simulieren → Breadboard), und dass ausgerechnet die selbst entwickelte Baugruppe auf Anhieb lief.

Falstad und KiCad sind als Werkzeuge in der Quellenliste — die gehören ins Quellenverzeichnis.

## Zwei Dinge, die jetzt dran sind

**1. Standbilder aus dem Video ziehen.** In den schriftlichen Kommentar könnt ihr kein Video einbauen. Macht Screenshots von der Kurvenform und speichert sie mit:

```bash
.\Bilder\zwischenablage-speichern.ps1 falstad-saegezahn-kurve -Ordner Messungen
```

**2. Die Frequenz in Falstad ablesen.** Meine Rechnung sagte 1–5,7 kHz — zu hoch für Musik. Der Simulator zeigt euch den echten Wert. Wenn er das bestätigt, ändert C4 von 100 nF auf 1 µF, dann landet ihr bei ~100–570 Hz. Das kostet in der Simulation zwei Minuten und ist genau die Sorte Korrektur, die ihr vor dem Teilebestellen machen wollt — das steht diese Woche an.
