lukimcfly/MaturaProjekt/KI-Protokolle/2026-10-28_cbc54aa2.md

# Schriftlicher Kommentar review

- Sitzungs-ID: `cbc54aa2-58dd-492c-b76f-cfdaab1b8633`
- Zeitraum: 2026-10-28 bis 2026-11-04
- Modell(e): claude-opus-5-5
- Nutzer-Prompts: 2

> Lesbare Fassung: Prompts und Antworten im Wortlaut, Werkzeugaufrufe nur als Kurzzeile, Werkzeug-Ausgaben weggelassen.

---
### 🧑 Nutzer · 2026-10-28 15:01 UTC

@"C:\Users\<user>\Downloads\SchriftlicherKommentarSynthesizer_Gliederung.docx"
So we already started writing the "Schriftlicher Kommentar" as you can see.
This is only a copy of the document, so whatever you do here, it won't be overtaken in the real document. 
Anyways: Pls search what is expected of the "Schriftlicher Kommentar" content- and formality-wise. Then make a review of our current document. (Yeah we're still not done, i know that and i told you.)

- *Werkzeug: mcp__ccd_turn__update_plan* — 
- *Werkzeug: Bash* — Convert document to text and list project files
- *Werkzeug: Bash* — Extract text and structure from the document
- *Werkzeug: Bash* — Re-run extraction with UTF-8 output

**🤖 Claude:**

-I ignores PYTHON* env vars; I'll set the encoding in the script.

- *Werkzeug: Bash* — Fix output encoding and re-run extraction
- *Werkzeug: Read* — C:\Users\<user>\AppData\Local\Temp\claude\C--Users-<user>-Downloads-MaturaProjekt\cbc54aa2-58dd-492c-b76f-cfdaab1b8633\scratchpad\doc\out.txt
- *Werkzeug: Read* — C:\Users\<user>\AppData\Local\Temp\claude\C--Users-<user>-Downloads-MaturaProjekt\cbc54aa2-58dd-492c-b76f-cfdaab1b8633\scratchpad\doc\out.txt
- *Werkzeug: mcp__ccd_turn__update_plan* — 
- *Werkzeug: Bash* — Check school materials and PDF tools
- *Werkzeug: Bash* — Extract text from key school PDFs
- *Werkzeug: Bash* — Extract citation rule PDFs

**🤖 Claude:**

Still reading the school's citation rules; next I'll check the 2025 Zitierregeln, then search the web and write the review.

- *Werkzeug: Bash* — Search citation rules for key topics
- *Werkzeug: Read* — C:\Users\<user>\AppData\Local\Temp\claude\C--Users-<user>-Downloads-MaturaProjekt\cbc54aa2-58dd-492c-b76f-cfdaab1b8633\scratchpad\zit.txt
- *Werkzeug: Bash* — Inspect styles and formatting of written paragraphs
- *Werkzeug: mcp__ccd_turn__update_plan* — 
- *Werkzeug: ToolSearch* — 
- *Werkzeug: WebSearch* — 
- *Werkzeug: WebSearch* — 
- *Werkzeug: Bash* — Extract contract text

**🤖 Claude:**

Done researching; writing the review now.

- *Werkzeug: mcp__ccd_turn__wrap_up* — 

**🤖 Claude:**

## What's expected

The binding sources are the ones already in `Schul-Unterlagen/`. The web search turned up nothing school-specific beyond them, only other schools ([KZO](https://www.kzo.ch/fileadmin/internet/pdf_internet/Unterricht/Maturjahr/Wegleitung_zur_Maturitaetsarbeit_2027.pdf), [KS Seetal](https://ksseetal.lu.ch/-/media/KSSeetal/Dokumente/Download/09_Archiv/09_2_Apriori/H16_aPriori_KS_Seetal.pdf), [Gym Kirchenfeld](https://api.gymkirchenfeld.ch/api/document/file/54021)). They all ask for the same core: describe the product idea, document the process, analyse and evaluate the product.

**Content** (Merkblatt for the Kommentar, plus the Checkliste):
- **Einleitung:** the question stated and justified, topic and relevance, scope and why, key terms, the method, and the structure of the text explained.
- **Recherche:** the goal of the research, what you found, and what that means for your project. The last point is the one people forget.
- **Methode:** the work steps "in Wort und Bild", plus a **Produktbegründung**: why the product had to turn out exactly the way it did.
- **Ergebnisse:** a summary, which parts of the question you answered, lessons from the process, and an outlook.

**Also from your contract and the June feedback:**
- Explain the circuits correctly.
- Make your own contribution visible.
- Include the Fourier comparison.
- Use figures with colours and current direction.
- Make sure the text doesn't read as AI-written.

**Formalities:**
- 5–15 pages, 1.5 line spacing, justified text, page numbers.
- One font, used consistently.
- Footnotes at the bottom of each page.
- Max. 10 % Wikipedia.
- Every footnote and source entry ends with a period.
- Bound copy.
- AI declared with tool, version, exact prompt, date and how you used the output.

Your template already covers all of this correctly. It follows the 2025 Zitierregeln, where web sources in footnotes get the publication date. The 2024 sheet uses the retrieval date instead; the 2025 version is the newer one, so keep doing what you're doing.

## Review of what's written so far

### Formal problems (quick fixes)
1. **Mixed fonts.** 1.1 is in Times New Roman 10 pt and the contract text in 1.2 is Times New Roman 12 pt, both pasted in with their own formatting. 1.3 is in the theme font. The template is set to Arial 11. Fix: select everything → *Formatierung löschen* (Ctrl+Space), or paste with *Nur Text übernehmen*.
2. **The 1.3 body text is styled as "Überschrift 2".** The whole paragraph will show up as a heading in the table of contents. Switch it to Standard.
3. **Red text** in the pasted contract paragraph in 1.2.
4. **2.2 is glued onto the placeholder.** It reads "[Hier schreiben …]Unser finales Produkt…", in grey italics.
5. **The question appears twice in 1.2**, once in your new version and once as in the contract. Keep one.
6. **Unfinished:** "Bei der Fourier-Analyse wurde der Ton" in 1.3. Also double spaces in 1.3.

### Citations
- **Wikipedia is at 40 %.** It's 2 of 5 sources and 2 of 5 footnote citations; the limit is 10 %. The share drops as you add sources, but the cheapest fix is to cut the Steinzeit/Mittelalter sentence (see below). For Moog, use a non-Wikipedia source.
- **The "Comeback" source (instrumentum.ch) is an instrument shop's blog.** They have an interest in selling synths. Add a more neutral source, or mention that it comes from a retailer.
- **IFPI:** "der Mensch im Durchschnitt" overgeneralises. Check who the study actually surveyed and say so, e.g. "Laut einer weltweiten Umfrage der IFPI hören Menschen…".
- **Moog as "der erste kommerziell erhältliche Synthesizer"** is disputed (Buchla worked on his at the same time). "einer der ersten" is safer.
- Footnote format, "Vgl.", the alphabetical order and the closing periods are all correct.

### Content, section by section
**1.1:** The second paragraph is good. "da wir auch selbst elektronische Musik produzieren" is exactly the personal voice the school wants, and the step from "Comeback" to "messbarer Unterschied?" leads nicely to the Fourier part. The first paragraph is the weak spot. Hours of listening, Stone Age, Middle Ages: that's a generic "since the dawn of time" opening, the kind of thing the June feedback called "generisch/KI-artig", and it has nothing to do with your question. Start at the Moog sentence or at the analog/digital contrast instead.

**1.2:** This is still mostly the contract text, and as the template's warning says, it states claims as facts:
- "digitale Alternativen können … niemals rekreieren" and "analoge Geräte sind viel praktischer" have to become a hypothesis or your motivation.
- "Um den Unterschied … zu **beweisen**" assumes the result. Use "untersuchen" or "prüfen".
- "würden wir … vergleichen": write it in the indicative, since you're actually doing it.
- The extended question ("…und wie messen sie sich mit ihren digitalen Gegenstücken?") is the right idea, because it ties in the Fourier part, but it's a clumsy run-on. Something like: *«Wie lassen sich analoge Oszillatoren und Effekte ohne digitale Hilfe bauen, und worin unterscheiden sich ihre Klänge im Frequenzspektrum von digital erzeugten?»* Clear the change with [Betreuungsperson] and mention it in the text.
- Language: "Synthetisator" vs. "Synthesizer" (pick one). "Das **e**rzeugen" should be "Erzeugen". "sich **an** … interessieren" should be "für". "trivial genug" is an anglicism. The sentence "Schliesslich haben wir es uns als Ziel gesetzt, einen … Synthetisator, welcher … werden können." has no verb; "zu bauen" is missing.
- Missing: concrete, checkable goals that 5.2 can come back to.

**1.3:** The content is right: you chose filter and distortion, and say why. Still to fix:
- "Auf … haben wir **uns** bewusst verzichtet" should be "haben wir bewusst verzichtet".
- "Das Netzteil (12 V) **wurden**" should be "wurde", and it's ±12 V.
- "Beide lassen sich direkt sehen im Oszilloskop und hören im Klang" has odd word order. Try "Ihre Wirkung ist auf dem Oszilloskop sichtbar und im Klang hörbar."
- "etwas mehr Schwierigkeiten …, was mit der Zeit etwas knapp werden könnte" is vague. Say concretely: time budget, plus your focus on sound generation.
- Still missing: the scope of the Fourier comparison (which waveforms, which digital synth), and if it applies, why you skipped the breadboards the contract mentions.

**2.2:** The text you wrote is a **product description**, not "Prinzip und Entwicklung des Synthesizers" (history, subtractive synthesis, analog vs. digital). It belongs in **3.2** (Konzept/Blockschaltbild) and partly in 3.7. Moved there, it becomes a good basis. Language to fix:
- "wie **start** ein bestimmtes gemixt" (a typo and a missing noun)
- "Vier" should be lowercase
- "in **der** Serie **nachdem**" should be "in Serie nach dem"
- "Volumen" should be "Lautstärke"
- "PCB platte" should be "Leiterplatte"
- "Amplifier" should be "Verstärker/Endstufe"
- "auf **einer** … Platte übertragen" should be "auf eine"
- "abspielende Wellenform" should be "gespielte"
- Sine-/Saw-/Triangle-/Squarewave: use the German terms, or explain the English ones once and then stick to them. Your template asks for consistent terminology.

### The bigger picture
About 1.5 pages of the planned 13–15 are written, with **13 days left** (deadline 10.11.). According to the repo, the build/test documentation (3.6) and the whole Fourier part (Ch. 4) have no data yet, and they depend on the finished device. Those are the critical path, not the wording.

**One more thing:** this review is itself an AI use, under "Rückmeldungen und Orientierung" and "Überprüfung und Kontrolle". Add it to 8.1/8.2 and the Logbuch with this prompt, today's date (28.10.2026) and the model (Claude Opus 5.5), for example "Rückmeldung als Orientierung genutzt, Korrekturen selbst umgesetzt."

---
### 🧑 Nutzer · 2026-11-04 10:28 UTC

can i tranfer this chat to this device? (im on remote control)

**🤖 Claude:**

Sort of. With Remote Control you're already in this chat from that device, so you can keep reading and replying there. The session itself still runs on your PC, though, so it only works while the PC is on and awake.

If you want it to stop depending on the PC, there are two options:

- **Move it to the cloud.** I can move this session into a cloud session, which keeps running with the PC off. It needs your GitHub repo and a cloud environment set up. Files that only exist on the PC won't be there, like the copy of the Kommentar in `Downloads` and anything not pushed to GitHub.
- **Keep just the result.** I can save the review as a file and send it to you, so you have it on that device even after this session ends.

Should I do one of those?
