lukimcfly/MaturaProjekt/plan/zeitplan-bis-herbstferien.md

# Zeitplan Sommerferien → Herbstferien

**Erstellt:** 12.08.2026 · **Ziel:** das physische Produkt (analoger Synthesizer) bis zu den Herbstferien fertigstellen
**Quelle:** handschriftliche Planungsnotiz, hier abgetippt

> Grundregel: **Arbeitsprozess immer direkt nach dem Arbeiten dokumentieren.**

---

## KW 33 · 10.08. – 16.08.2026 — 7 h
- Theorie verfestigen (7 h)
- Teile bestellen **(!)** — im Original als besonders wichtig markiert

## KW 34 · 17.08. – 23.08.2026 — 10 h
- Theorie verfestigen (6 h) *(ursprünglich 10 h geplant, auf 6 h korrigiert)*
- Grobe Produktskizze (2 h)
- Systemkomponenten recherchieren / erlernen (Mixer, Filter, OSCs …) (2 h)

## KW 35 · 24.08. – 30.08.2026 — 12 h (+ 2 h)
- Dito, d. h. Systemkomponenten weiter recherchieren / erlernen (4 h)
- Systemkomponenten skizzieren (8 h)
- Komponenten testen (2 h) *(nachträglich eingefügt, Zuordnung KW 35 oder KW 36 offen)*

## KW 36 · 31.08. – 06.09.2026 — 10 h
- KiCad-Schaltplan machen, bis fertig (10 h)
- Werte kontrollieren, Simulationen laufen lassen wenn möglich

## KW 37 · 07.09. – 13.09.2026 — 14 h (+ 4 h)
- Komponenten kombinieren & testen (4 h) *(nachträglich eingefügt, Zuordnung KW 36 oder KW 37 offen)*
- Ganzes Produkt auf Breadboards stecken & testen
- Fehlerbehebung, Optimierung (14 h)

## KW 38 · 14.09. – 20.09.2026 — 14 h
- PCB-Platte entwerfen & bestellen (14 h)
- Teile für das Endprodukt bestellen
- Wenn Zeit: schriftlicher Kommentar
- *(ursprünglich als Pufferwoche vorgesehen, gestrichen)*

## KW 39 · 21.09. – 27.09.2026 — Puffer
- Pufferwoche
- Wenn Zeit: schriftlicher Kommentar

## Danach
**Herbstferien** — physisches Produkt soll zu diesem Zeitpunkt stehen.

---

**Summe verplant:** ca. 67 h (ohne die beiden nachträglich eingefügten Testblöcke: 61 h)
