lukimcfly/MaturaProjekt/KI-Protokolle/memory/matura-projekt-inhalt.md

---
name: matura-projekt-inhalt
description: "Inhalt des Maturaprojekts — analoger Synthesizer plus Fourier-Vergleich analog/digital, Abgabe 10.11.2026, Vertrag und Zwischenfeedback."
metadata:
  node_type: memory
  type: project
  originSessionId: 9a1cd49d-4fd4-46bd-8854-9a24f8ae14c3
  modified: 2026-10-21T12:10:07.676Z
---

Maturaarbeit ([Schule], [Klasse], zwei Personen, Betreuung: siehe Vertrag in
`Unsere-Materialien/Vertrag/`). Titel provisorisch: «Vom Schaltkreis zum Klang».
Fragestellung laut Vertrag: Wie können verschiedene analoge Oszillatoren gebaut
werden und welche Effekte lassen sich ohne digitale Hilfe erzeugen?

Teile: (1) analoger Synthesizer (Produkt, 40 % der Note), (2) Vergleich analog vs.
digital mit Fourieranalysen — steht explizit in den Produkt-Bewertungskriterien des
Vertrags, (3) schriftlicher Kommentar 5–15 S., (4) Logbuch inkl. KI-Nachweis.
Vertrag verspricht auch Gehäuse, beschriftetes Interface und ein Display für die
Wellenform (Stand 21.10.2026 nicht im Schaltplan).

**Abgabe: 10.11.2026. Schlusspräsentation 24.–26.11.2026.** Platinen am 21.10.2026
bestellt und unterwegs.

Zwischenpräsentation Juni 2026: Note ~4.5. Kritik: Text wirkte KI-generiert,
Bausteine-Theorie zu mager, Figuren ohne Farben/Stromrichtung, Logbuch mager
(keine Reflexion, KI-Nutzung nicht dokumentiert), Projektmanagement, Strom/Spannung
verwechselt, Eigenleistung nicht erklärbar. Deshalb wollen sie diesmal 3 Wochen
vorher beginnen.

In den Tagebucheinträgen keine Namen verwenden — "wir" bzw. "beide Projektmitglieder".
Arbeitsregel: Arbeitsprozess direkt nach dem Arbeiten dokumentieren.

Siehe [[matura-diary-workflow]], [[synth-gesamtschaltplan]].
