lukimcfly/MaturaProjekt/Bilder/Schaltplaene/2026-08-19_saw-oszillator-kicad-v2.png

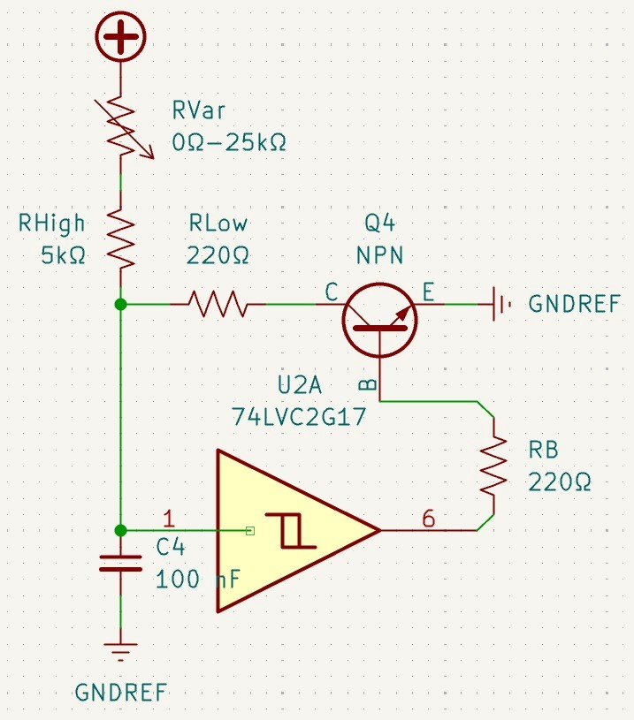
Bilder/Schaltplaene/2026-08-19_saw-oszillator-kicad-v2.png
