lukimcfly/MaturaProjekt/Bilder/Schaltplaene/2026-08-19_saw-oszillator-stromfluss.png

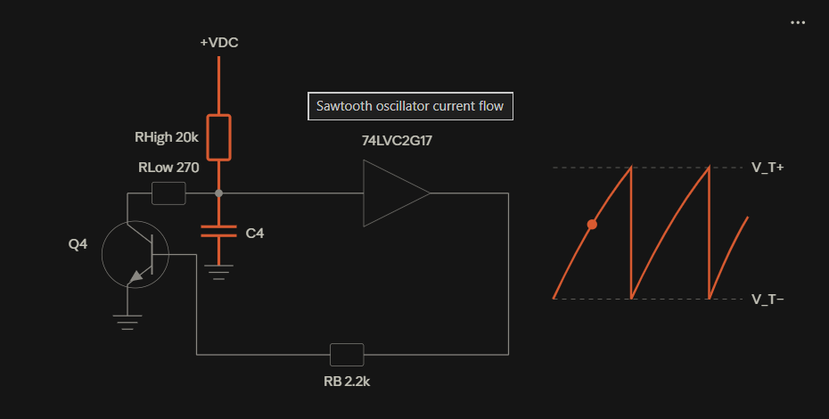
Bilder/Schaltplaene/2026-08-19_saw-oszillator-stromfluss.png
