lukimcfly/MaturaProjekt/Bilder/Schaltplaene/2026-09-12_platine-filter-oben.png

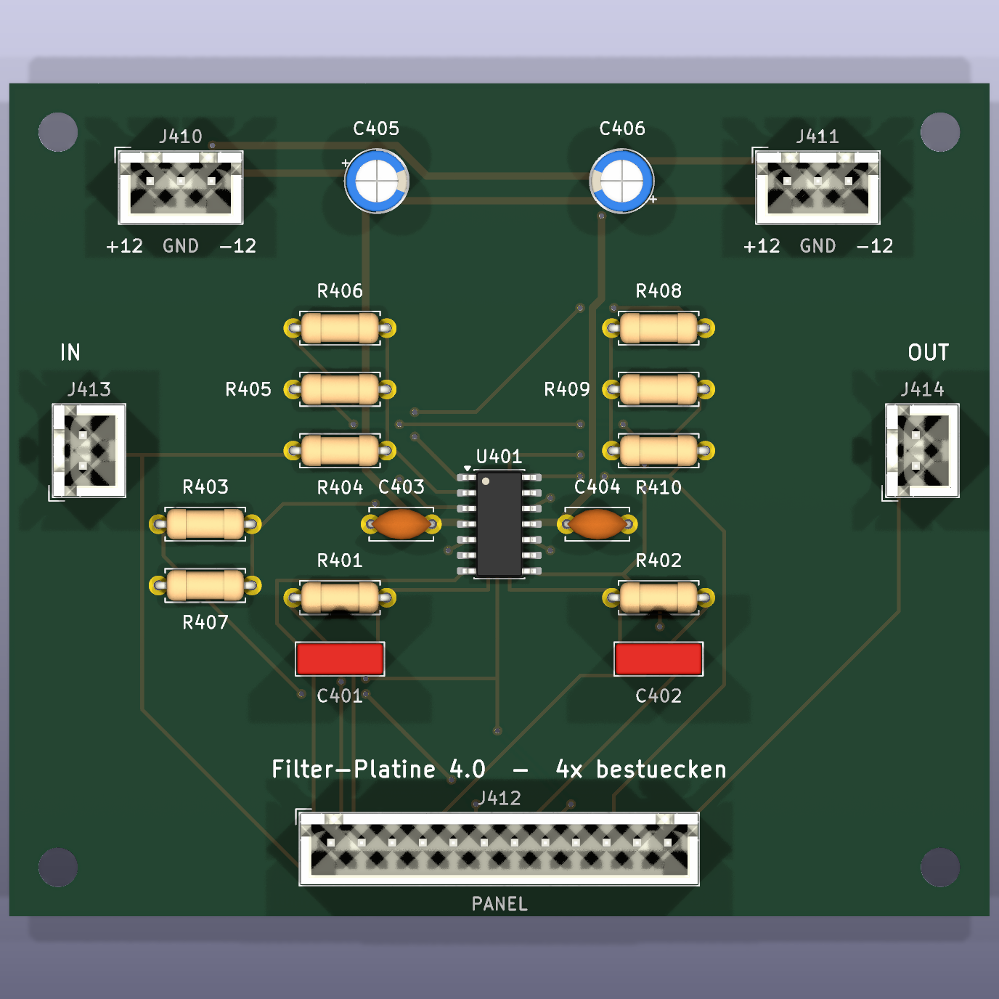
Bilder/Schaltplaene/2026-09-12_platine-filter-oben.png
