lukimcfly/MaturaProjekt/Bilder/Schaltplaene/2026-09-12_platine-filter-unten.png

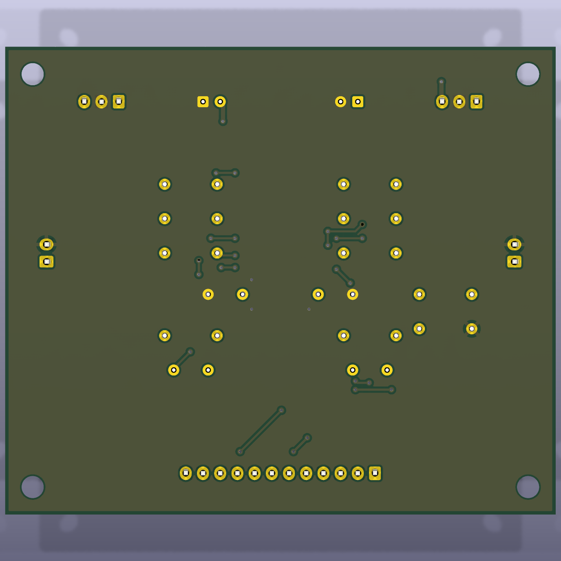
Bilder/Schaltplaene/2026-09-12_platine-filter-unten.png
