lukimcfly/MaturaProjekt/Bilder/Schaltplaene/2026-09-12_platine-hauptplatine-unten.png

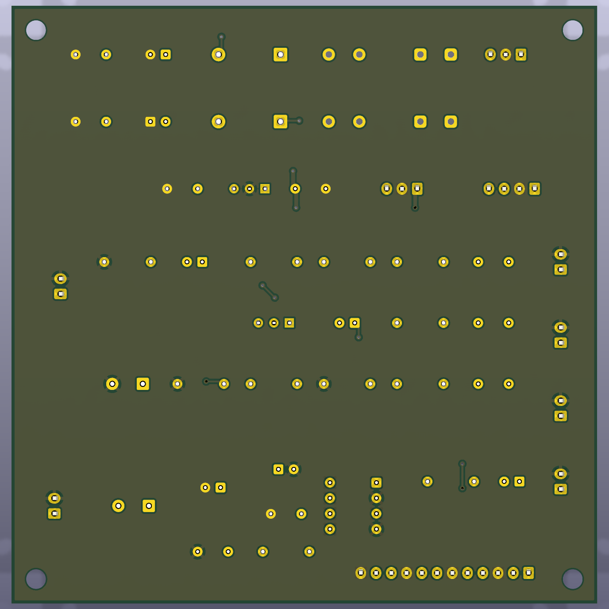
Bilder/Schaltplaene/2026-09-12_platine-hauptplatine-unten.png
