lukimcfly/MaturaProjekt/Bilder/Schaltplaene/2026-09-16_platine-oszillator-unten.png

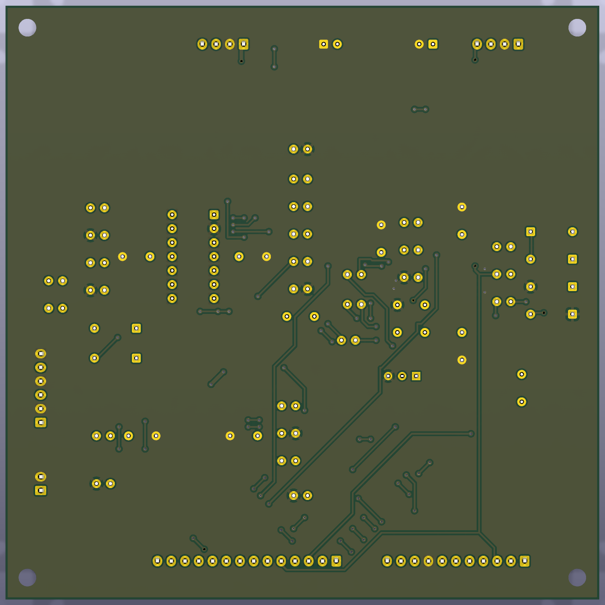
Bilder/Schaltplaene/2026-09-16_platine-oszillator-unten.png
