lukimcfly/MaturaProjekt/Bilder/Schaltplaene/2026-09-21_bedienfeld-uebersicht.png

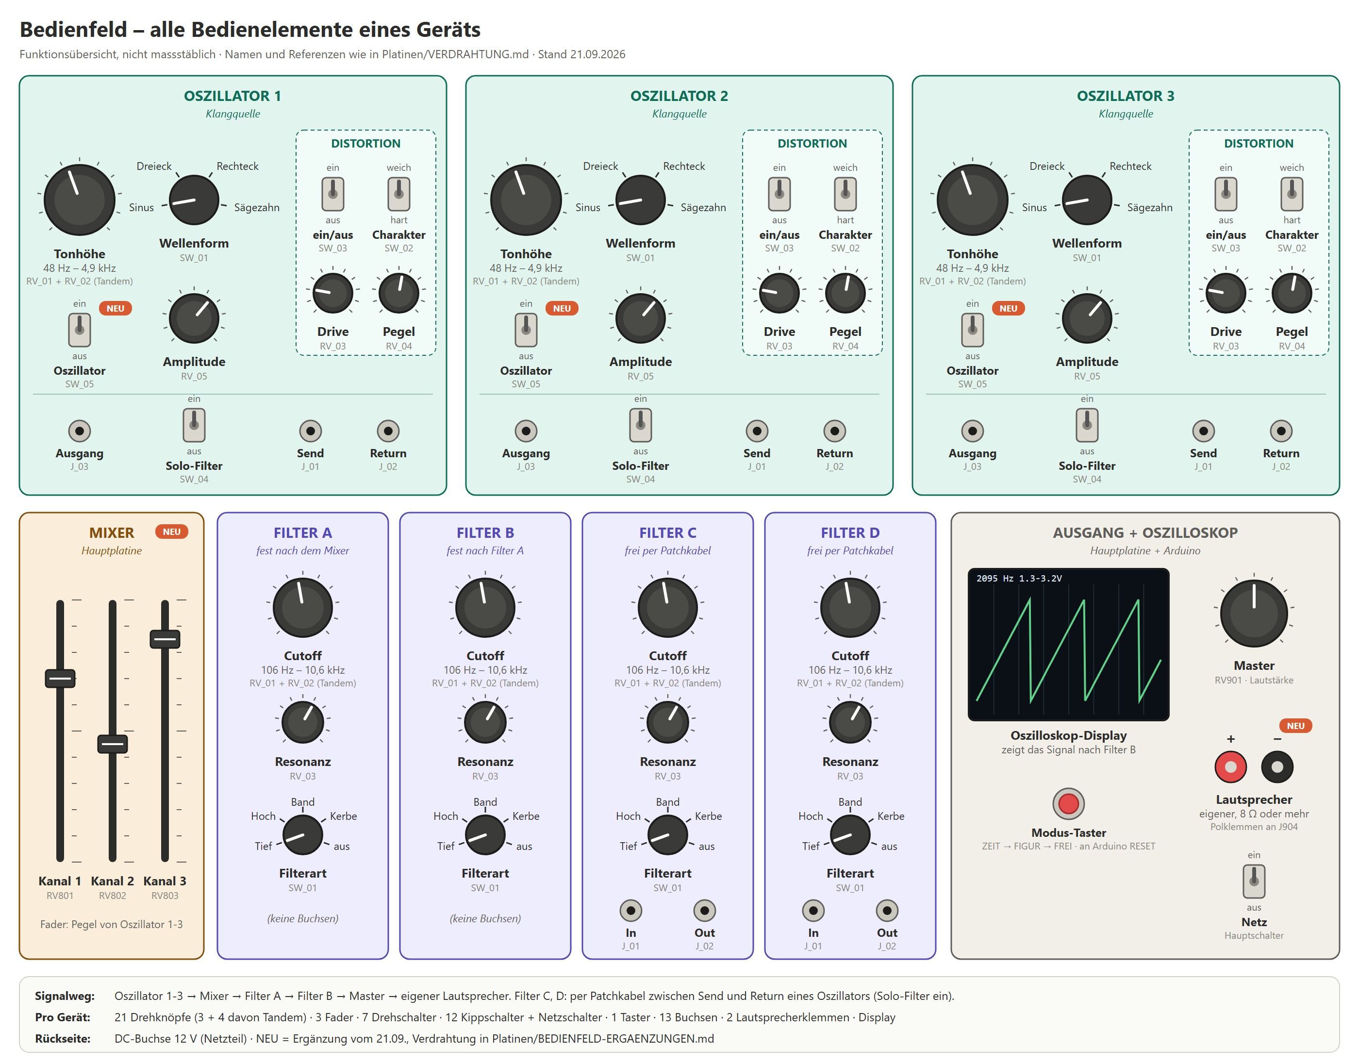
Bilder/Schaltplaene/2026-09-21_bedienfeld-uebersicht.png
