lukimcfly/MaturaProjekt/Bilder/Schaltplaene/distortion-schalter-neu-SW4-DPDT.png

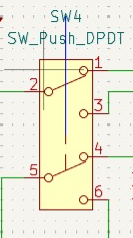
Bilder/Schaltplaene/distortion-schalter-neu-SW4-DPDT.png
