lukimcfly/MaturaProjekt/Bilder/WhatsApp/IMG-20260401-WA0004.jpg

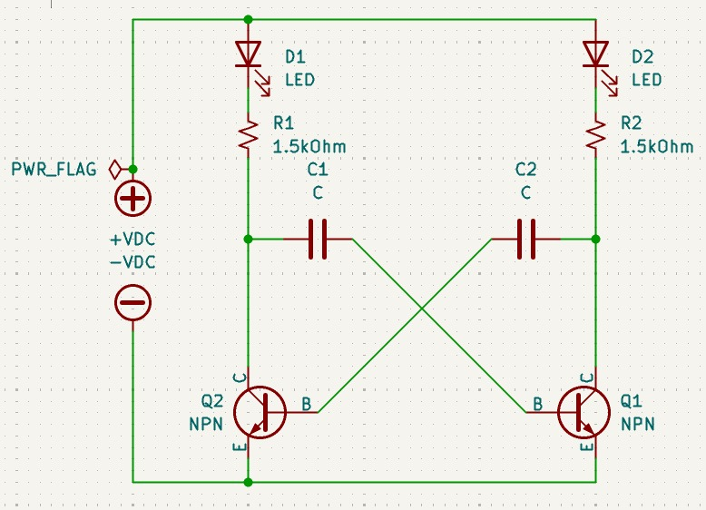
Bilder/WhatsApp/IMG-20260401-WA0004.jpg
