lukimcfly/MaturaProjekt/Bilder/WhatsApp/IMG-20260513-WA0004.jpg

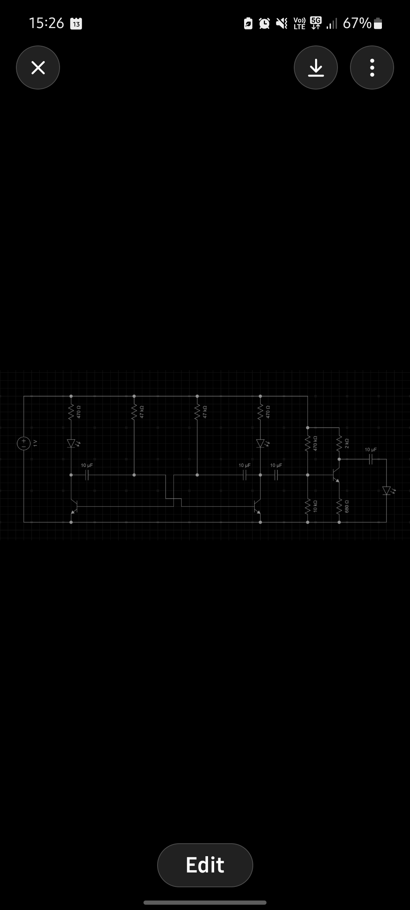
Bilder/WhatsApp/IMG-20260513-WA0004.jpg
