lukimcfly/MaturaProjekt/Bilder/WhatsApp/IMG-20260609-WA0000.jpg

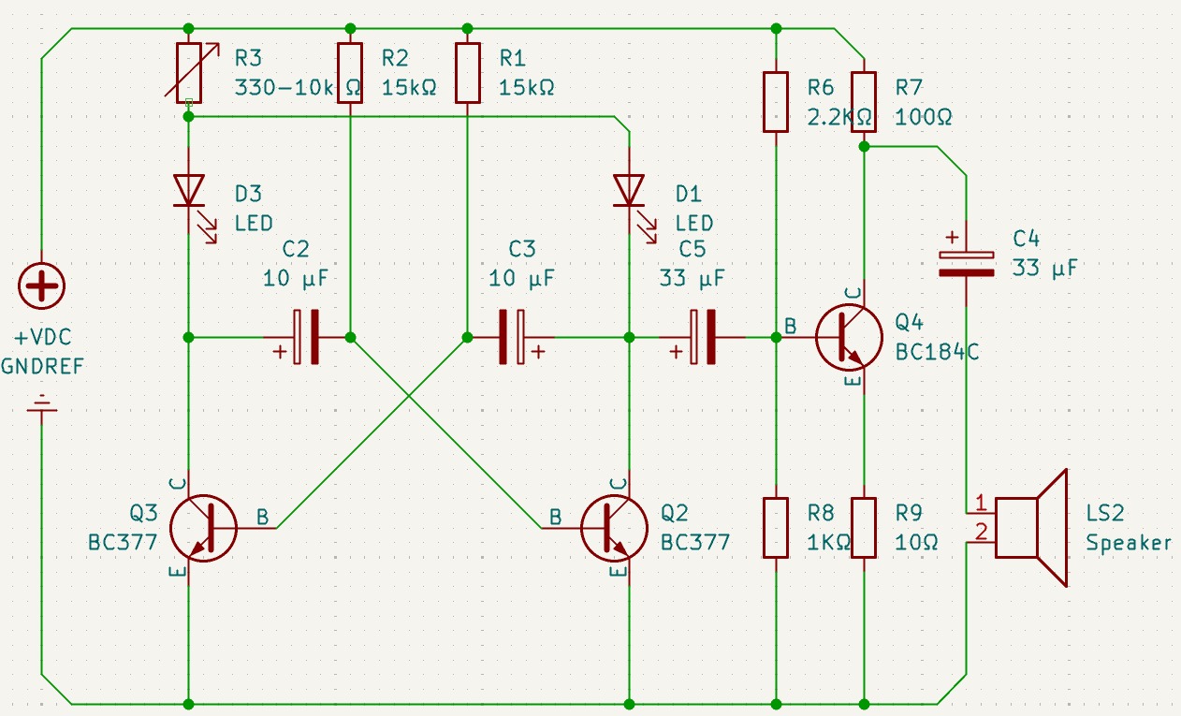
Bilder/WhatsApp/IMG-20260609-WA0000.jpg
