lukimcfly/MaturaProjekt/Bilder/WhatsApp/IMG-20260609-WA0002.jpg

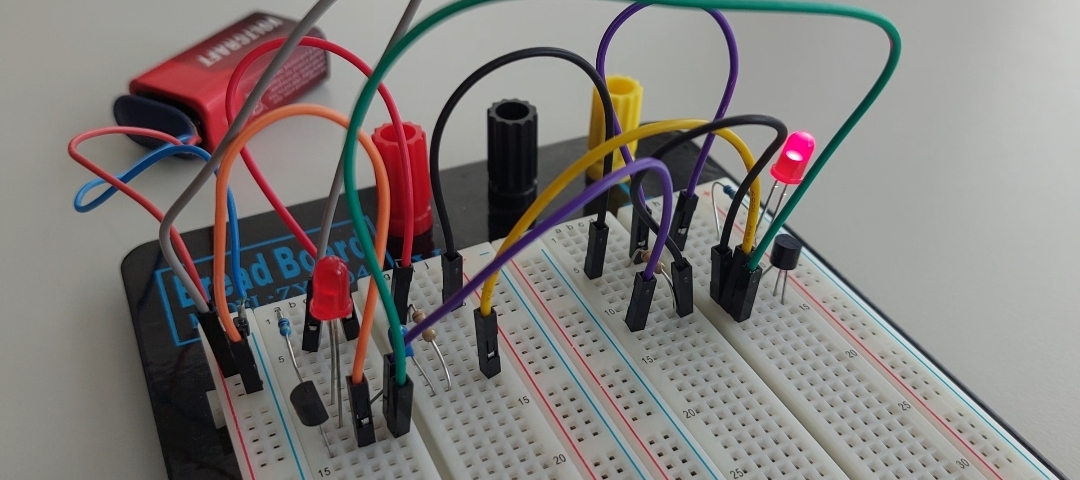
Bilder/WhatsApp/IMG-20260609-WA0002.jpg
