lukimcfly/MaturaProjekt/Bilder/WhatsApp/IMG-20260610-WA0003.jpg

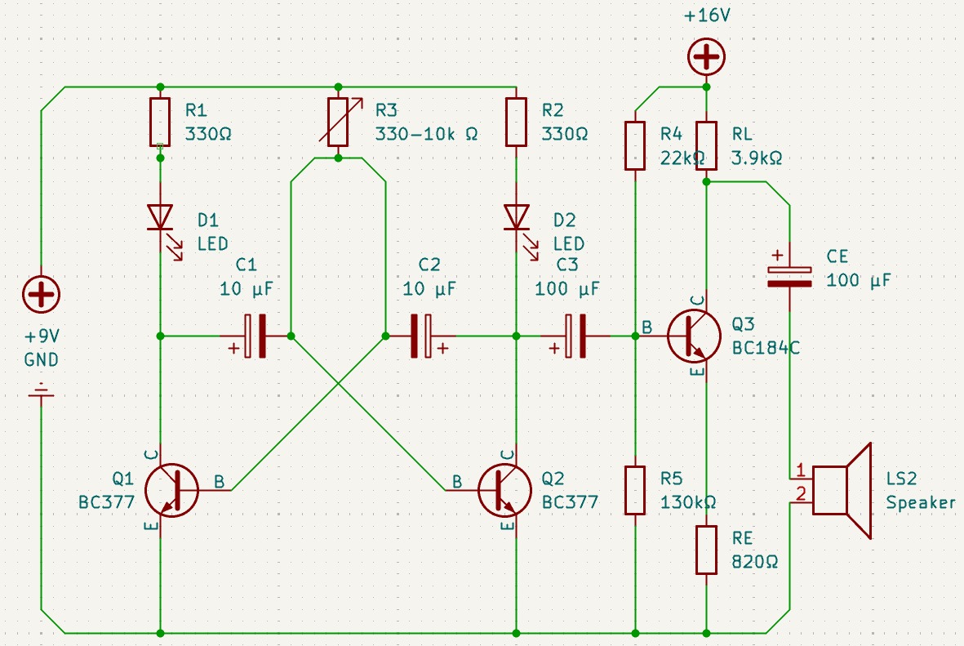
Bilder/WhatsApp/IMG-20260610-WA0003.jpg
