lukimcfly/MaturaProjekt/Bilder/WhatsApp/IMG-20260610-WA0004.jpg

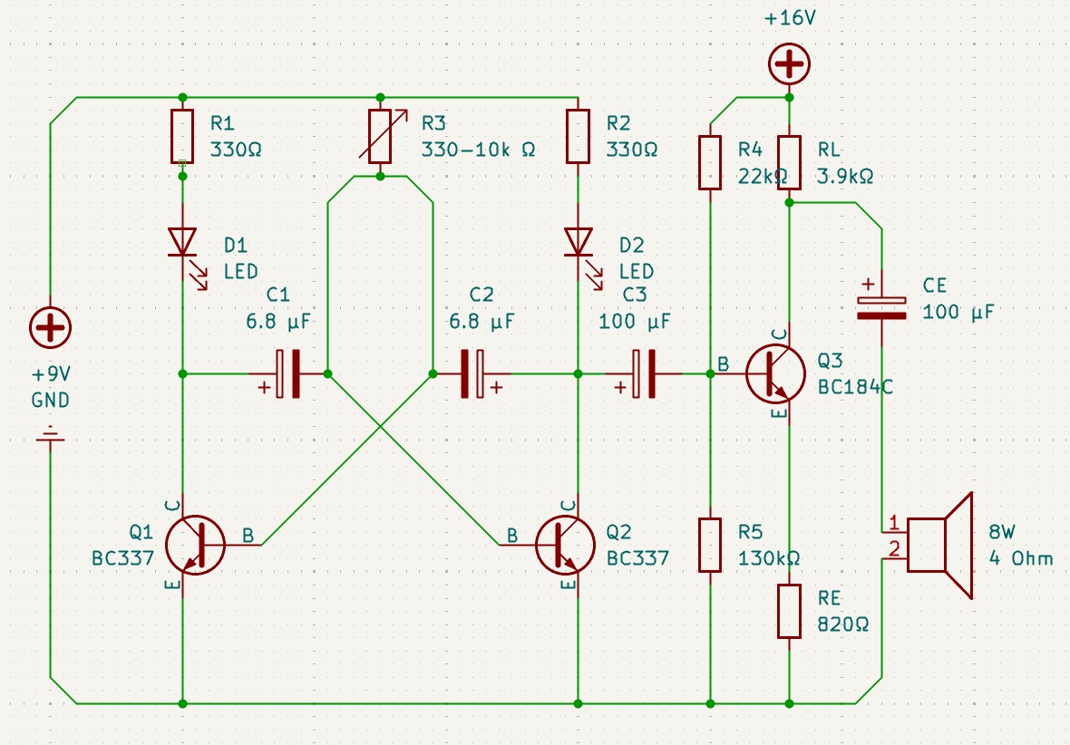
Bilder/WhatsApp/IMG-20260610-WA0004.jpg
