lukimcfly/MaturaProjekt/Bilder/WhatsApp/IMG-20260610-WA0011.jpg

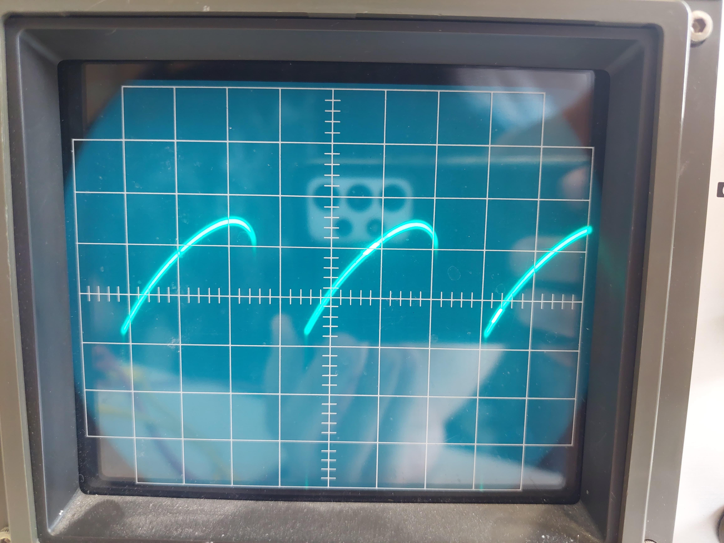
Bilder/WhatsApp/IMG-20260610-WA0011.jpg
