lukimcfly/MaturaProjekt/Bilder/WhatsApp/IMG-20260610-WA0012.jpg

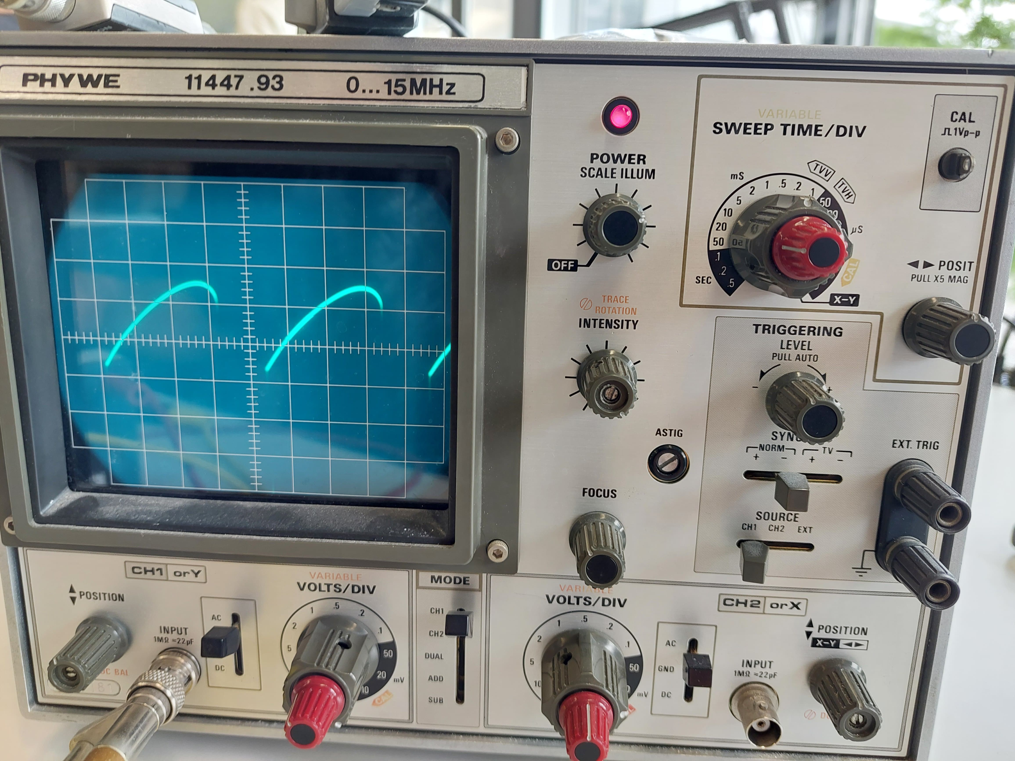
Bilder/WhatsApp/IMG-20260610-WA0012.jpg
