lukimcfly/MaturaProjekt/Bilder/WhatsApp/IMG-20260818-WA0001.jpg

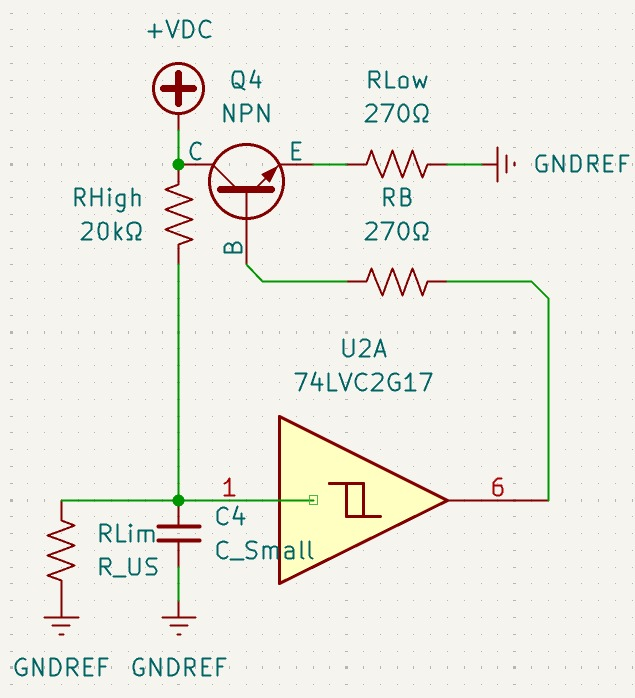
Bilder/WhatsApp/IMG-20260818-WA0001.jpg
