lukimcfly/MaturaProjekt/Bilder/WhatsApp/IMG-20260819-WA0001.jpg

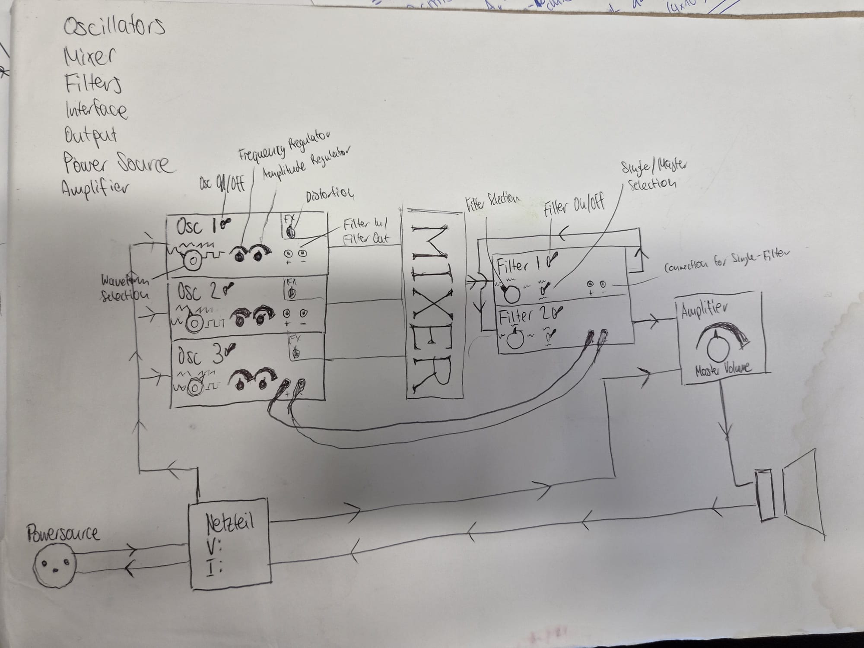
Bilder/WhatsApp/IMG-20260819-WA0001.jpg
