lukimcfly/MaturaProjekt/Bilder/WhatsApp/IMG-20260819-WA0002.jpg

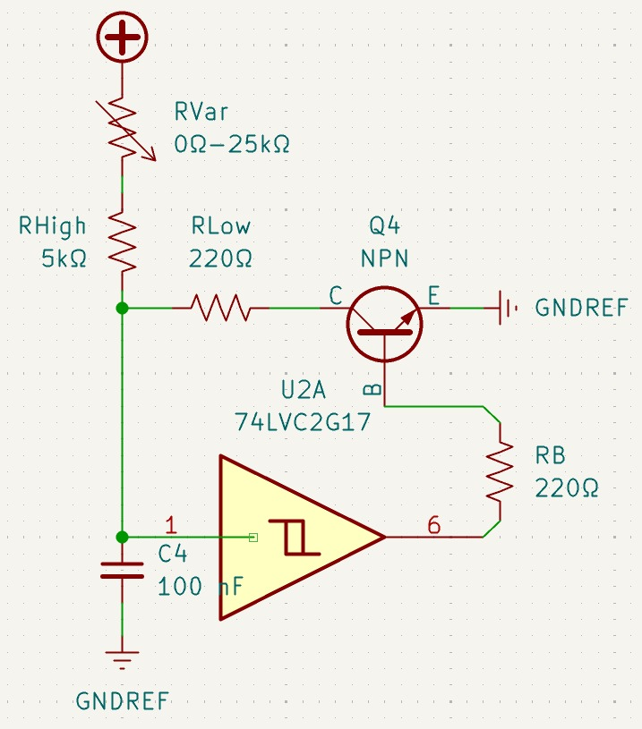
Bilder/WhatsApp/IMG-20260819-WA0002.jpg
