lukimcfly/MaturaProjekt/Bilder/WhatsApp/IMG-20260820-WA0003.jpg

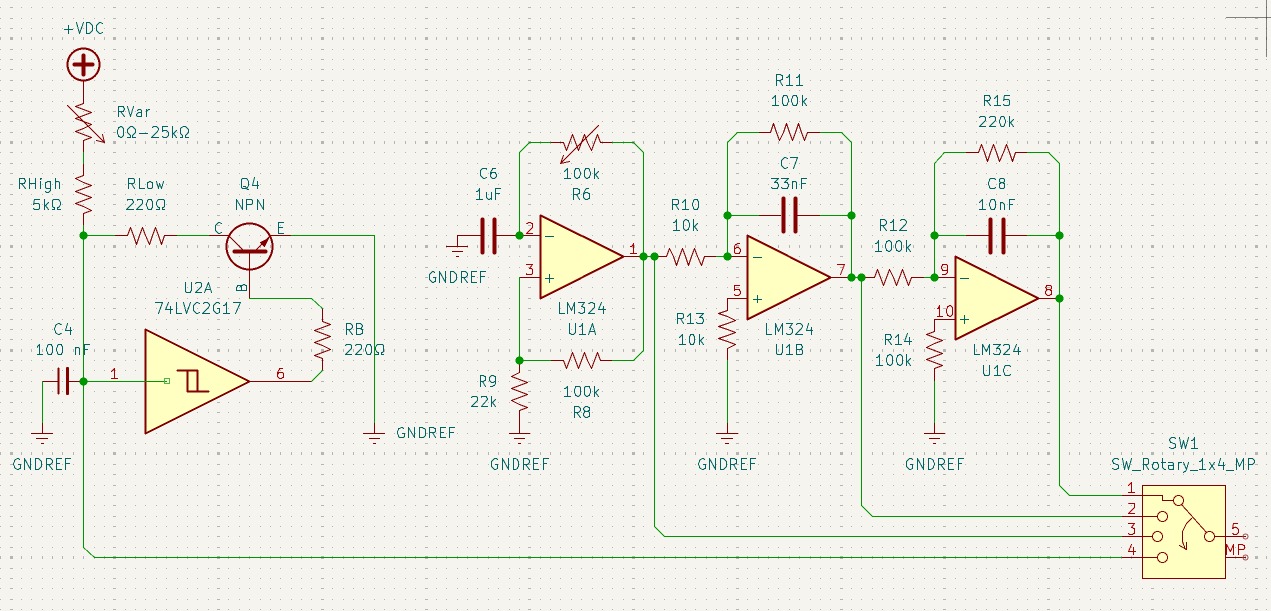
Bilder/WhatsApp/IMG-20260820-WA0003.jpg
