lukimcfly/MaturaProjekt/Bilder/WhatsApp/IMG-20260824-WA0003.jpg

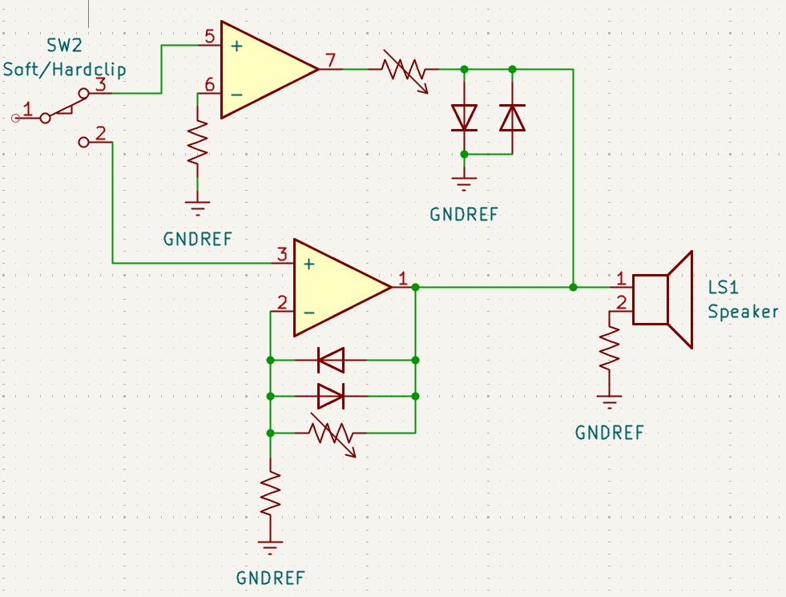
Bilder/WhatsApp/IMG-20260824-WA0003.jpg
