lukimcfly/MaturaProjekt/Bilder/WhatsApp/IMG-20260824-WA0004.jpg

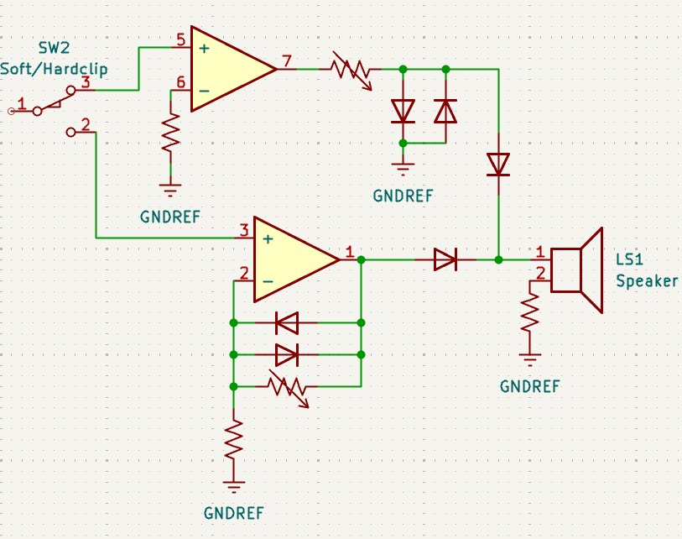
Bilder/WhatsApp/IMG-20260824-WA0004.jpg
