lukimcfly/MaturaProjekt/Bilder/WhatsApp/IMG-20260825-WA0001.jpg

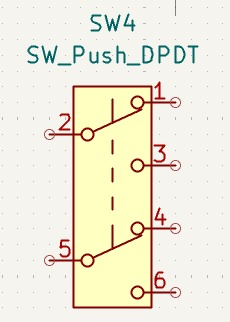
Bilder/WhatsApp/IMG-20260825-WA0001.jpg
