lukimcfly/MaturaProjekt/Bilder/WhatsApp/IMG-20260825-WA0002.jpg

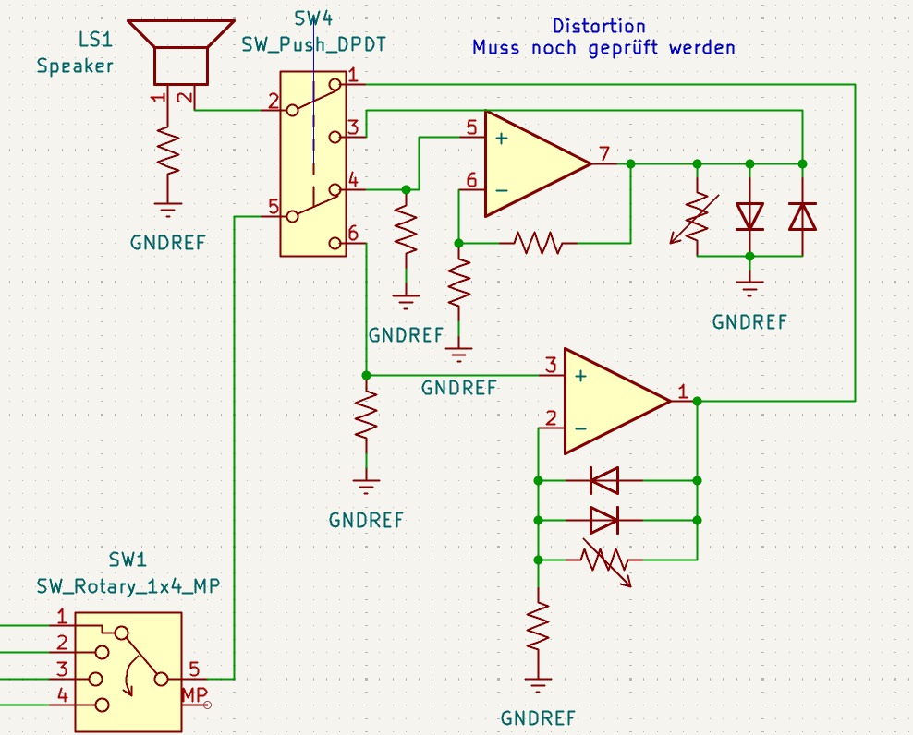
Bilder/WhatsApp/IMG-20260825-WA0002.jpg
