lukimcfly/MaturaProjekt/Bilder/WhatsApp/IMG-20260826-WA0000.jpg

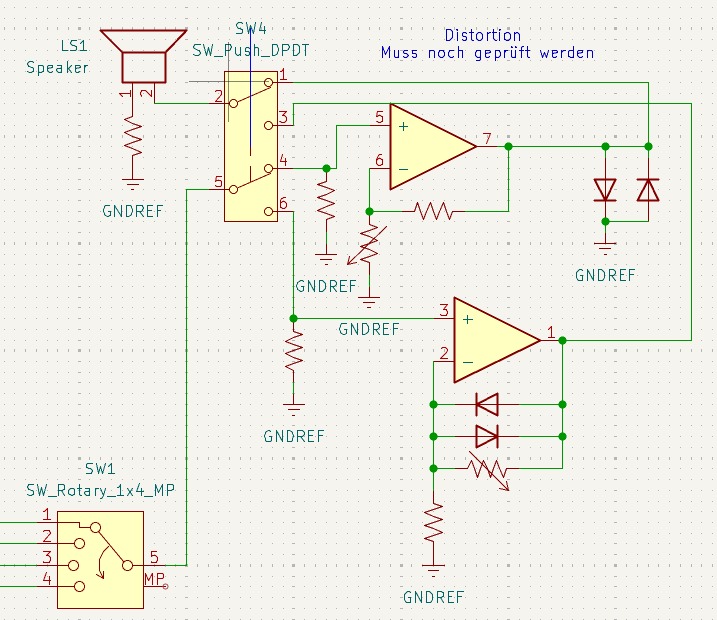
Bilder/WhatsApp/IMG-20260826-WA0000.jpg
