lukimcfly/MaturaProjekt/Bilder/WhatsApp/IMG-20260826-WA0001.jpg

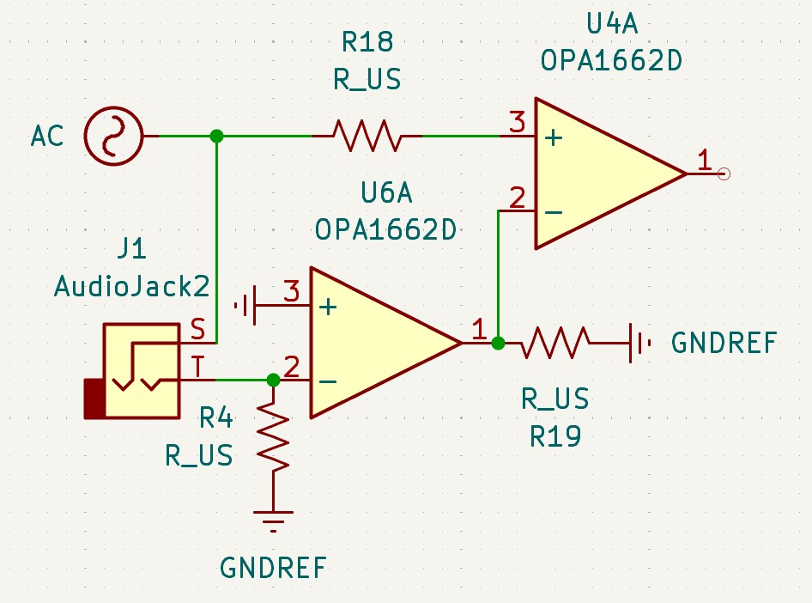
Bilder/WhatsApp/IMG-20260826-WA0001.jpg
