lukimcfly/MaturaProjekt/Bilder/WhatsApp/IMG-20260826-WA0007.jpg

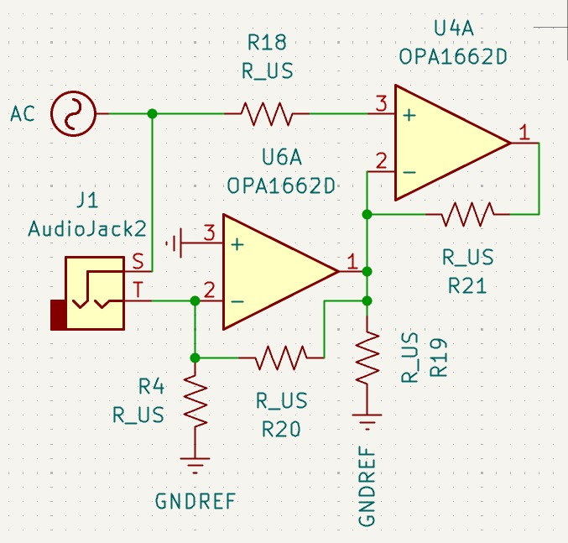
Bilder/WhatsApp/IMG-20260826-WA0007.jpg
