lukimcfly/MaturaProjekt/Bilder/WhatsApp/IMG-20260826-WA0009.jpg

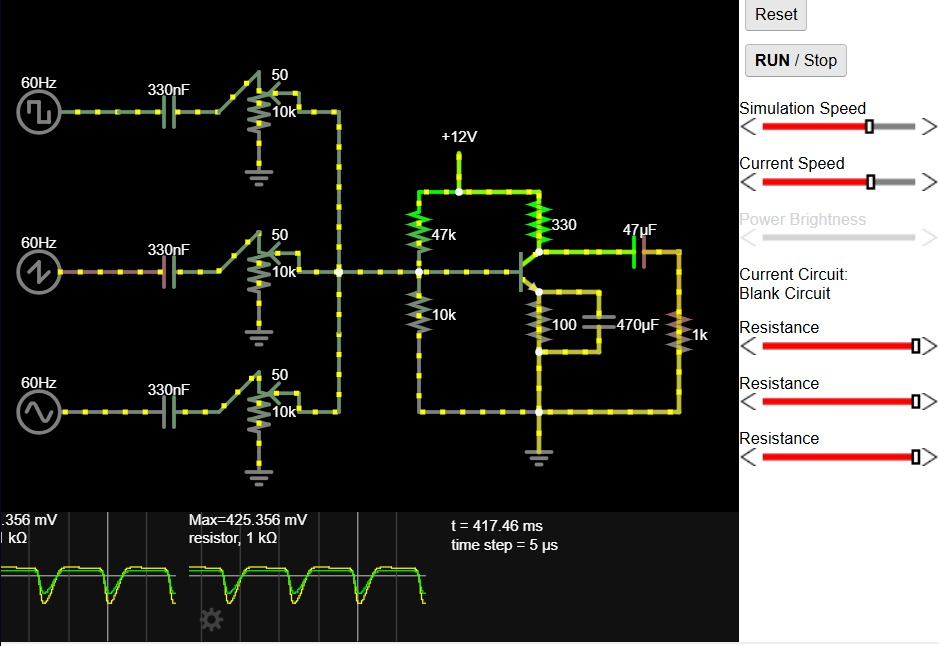
Bilder/WhatsApp/IMG-20260826-WA0009.jpg
