lukimcfly/MaturaProjekt/Bilder/WhatsApp/IMG-20260908-WA0001.jpg

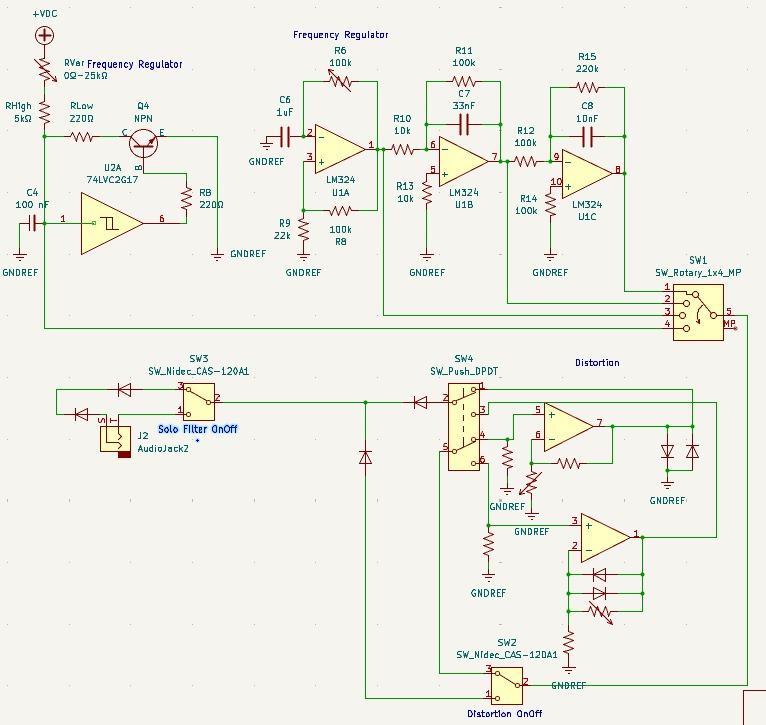
Bilder/WhatsApp/IMG-20260908-WA0001.jpg
