lukimcfly/MaturaProjekt/Bilder/WhatsApp/IMG-20260909-WA0003.jpg

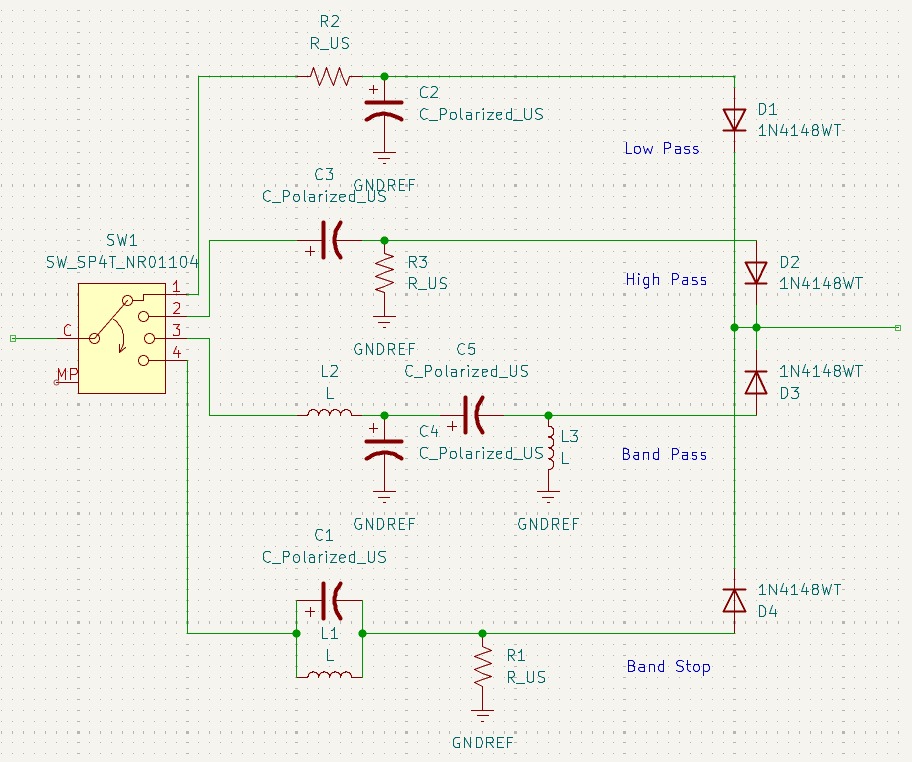
Bilder/WhatsApp/IMG-20260909-WA0003.jpg
