lukimcfly/MaturaProjekt/Bilder/WhatsApp/IMG-20260909-WA0004.jpg

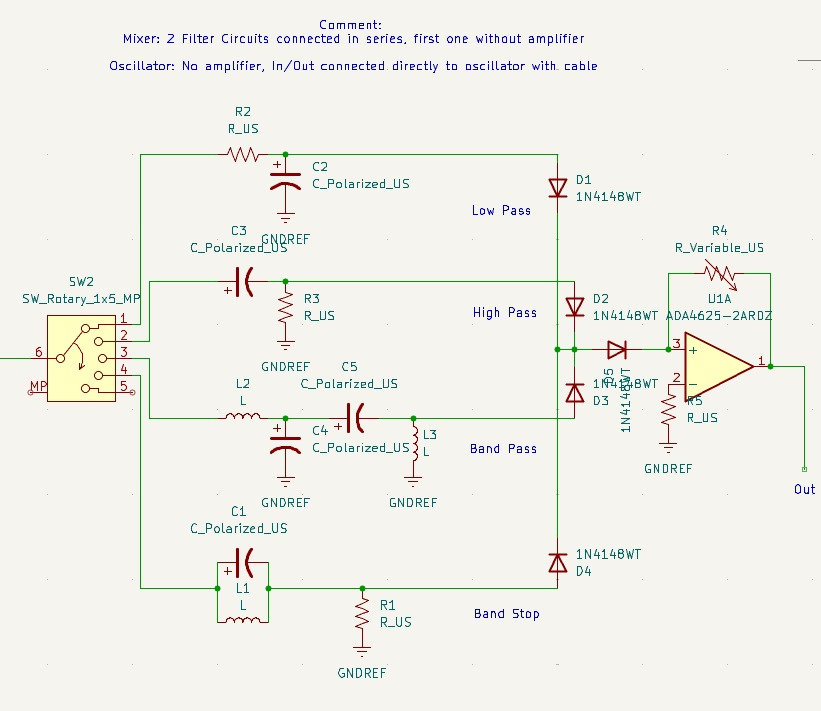
Bilder/WhatsApp/IMG-20260909-WA0004.jpg
