lukimcfly/MaturaProjekt/Bilder/WhatsApp/IMG-20260910-WA0015.jpg

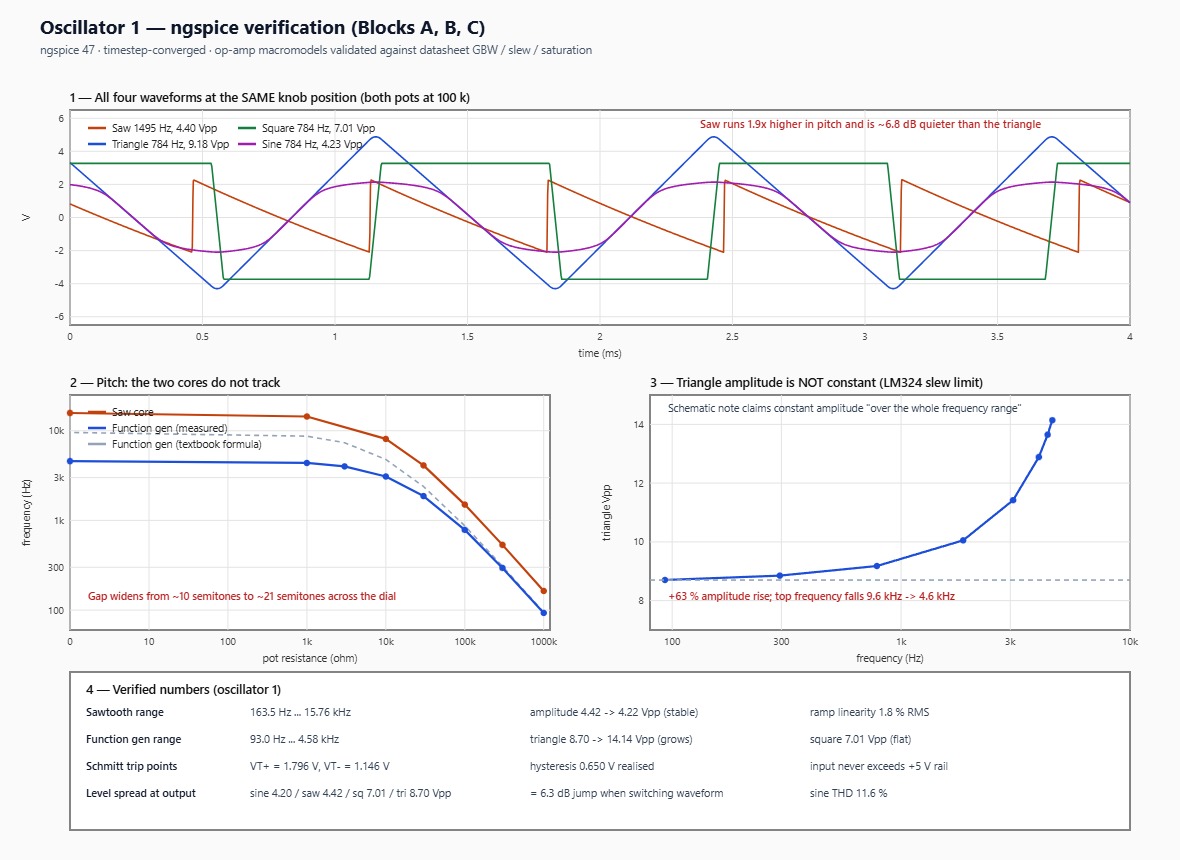
Bilder/WhatsApp/IMG-20260910-WA0015.jpg
