lukimcfly/MaturaProjekt/Bilder/WhatsApp/IMG-20260910-WA0021.jpg

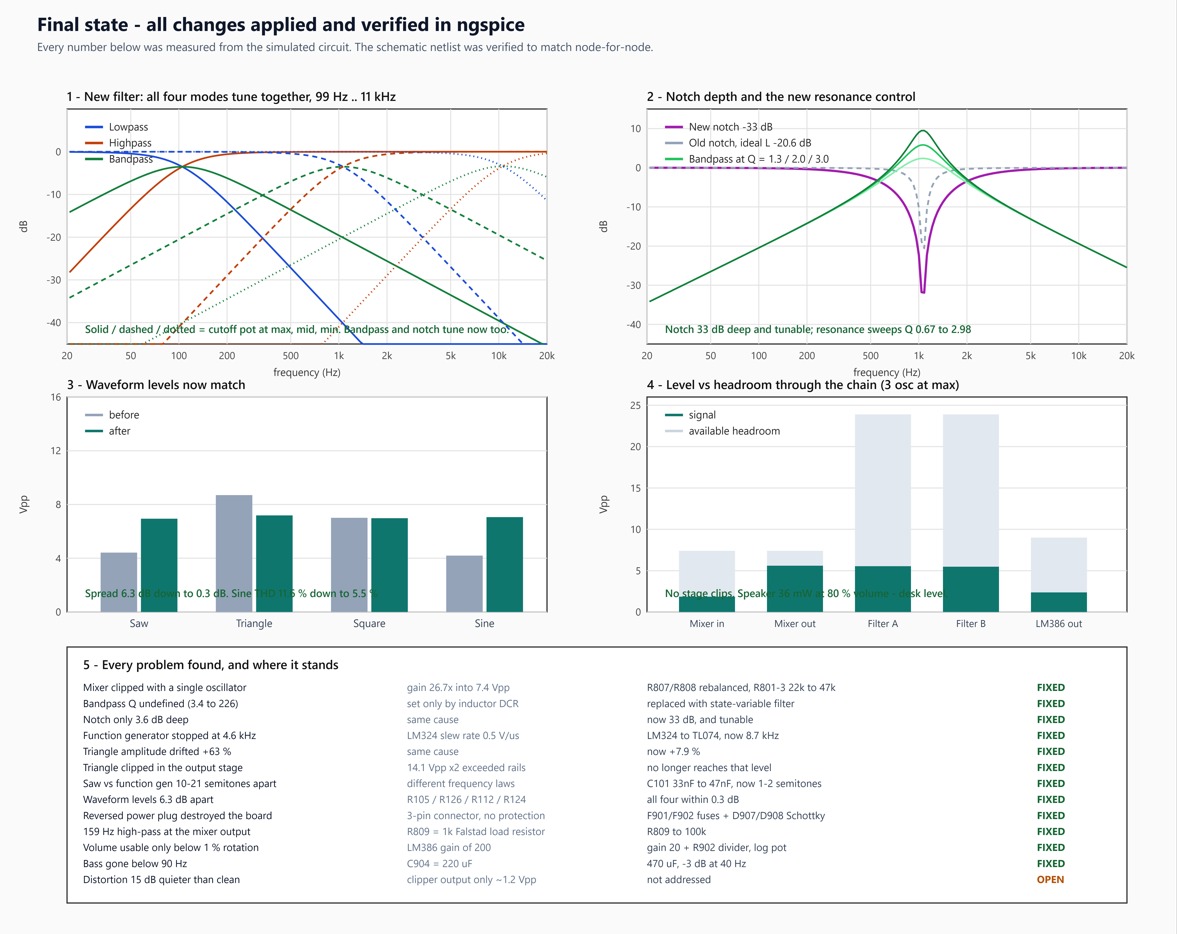
Bilder/WhatsApp/IMG-20260910-WA0021.jpg
