lukimcfly/MaturaProjekt/SynthesizerFinal/BOM.csv

Reference | Value | Footprint
C101,C201,C301 | 56nF | Capacitor_THT:C_Rect_L7.0mm_W2.5mm_P5.00mm
C102,C202,C302,C401,C402,C501,C502,C601,C602,C701,C702 | 15nF | Capacitor_THT:C_Rect_L7.0mm_W2.5mm_P5.00mm
C103,C104,C203,C204,C303,C304,C801-C803 | 1uF | Capacitor_THT:C_Rect_L7.0mm_W4.5mm_P5.00mm
C105-C111,C205-C211,C305-C311,C403,C404,C503,C504,C603,C604,C703,C704,C907,C921,C922,C942 | 100nF | Capacitor_THT:C_Disc_D5.0mm_W2.5mm_P5.00mm
C112,C113,C212,C213,C312,C313,C405,C406,C505,C506,C605,C606,C705,C706 | 10uF/25V | Capacitor_THT:CP_Radial_D5.0mm_P2.50mm
C804,C903 | 10uF/16V | Capacitor_THT:CP_Radial_D5.0mm_P2.50mm
C805 | 470uF/16V | Capacitor_THT:CP_Radial_D10.0mm_P5.00mm
C806 | 47uF/25V | Capacitor_THT:CP_Radial_D6.3mm_P2.50mm
C901 | 10uF/25V bipolar | Capacitor_THT:CP_Radial_D5.0mm_P2.50mm
C904 | 470uF/25V | Capacitor_THT:CP_Radial_D10.0mm_P5.00mm
C905 | 47nF | Capacitor_THT:C_Rect_L7.0mm_W2.5mm_P5.00mm
C906,C931,C932 | 100uF/25V | Capacitor_THT:CP_Radial_D6.3mm_P2.50mm
C941 | 330nF | Capacitor_THT:C_Rect_L7.0mm_W2.5mm_P5.00mm
D101-D106,D201-D206,D301-D306 | 1N4148 | Diode_THT:D_DO-35_SOD27_P7.62mm_Horizontal
D907,D908 | 1N5819 | Diode_THT:D_DO-41_SOD81_P10.16mm_Horizontal
F901,F902 | T500mA | Fuse:Fuseholder_Clip-5x20mm_Littelfuse_111_Inline_P20.00x5.00mm_D1.05mm_Horizontal
J101,J201,J301 | Filter-Send
J102,J202,J302 | Filter-Return
J103,J203,J303 | Ausgang
J110,J210,J310 | Versorgung ein | Connector_JST:JST_XH_B4B-XH-A_1x04_P2.50mm_Vertical
J111,J211,J311 | Versorgung weiter | Connector_JST:JST_XH_B4B-XH-A_1x04_P2.50mm_Vertical
J112,J212,J312 | Panel Potis | Connector_JST:JST_XH_B11B-XH-A_1x11_P2.50mm_Vertical
J113,J213,J313 | Panel Schalter | Connector_JST:JST_XH_B14B-XH-A_1x14_P2.50mm_Vertical
J114,J214,J314 | Panel Buchsen | Connector_JST:JST_XH_B6B-XH-A_1x06_P2.50mm_Vertical
J115,J215,J315 | Audio aus -> Mixer | Connector_JST:JST_XH_B2B-XH-A_1x02_P2.50mm_Vertical
J410,J510,J610,J710 | Versorgung ein | Connector_JST:JST_XH_B3B-XH-A_1x03_P2.50mm_Vertical
J411,J511,J611,J711 | Versorgung weiter | Connector_JST:JST_XH_B3B-XH-A_1x03_P2.50mm_Vertical
J412,J512,J612,J712 | Panel Poti + Wahlschalter | Connector_JST:JST_XH_B12B-XH-A_1x12_P2.50mm_Vertical
J413,J513,J613,J713 | Audio ein | Connector_JST:JST_XH_B2B-XH-A_1x02_P2.50mm_Vertical
J414,J514,J614,J714 | Audio aus | Connector_JST:JST_XH_B2B-XH-A_1x02_P2.50mm_Vertical
J601,J701 | Filter-In
J602,J702 | Filter-Out
J810 | Versorgung -> Oszillatoren | Connector_JST:JST_XH_B4B-XH-A_1x04_P2.50mm_Vertical
J811 | Versorgung -> Filter | Connector_JST:JST_XH_B3B-XH-A_1x03_P2.50mm_Vertical
J812 | Panel Potis | Connector_JST:JST_XH_B12B-XH-A_1x12_P2.50mm_Vertical
J813 | OSC 1 ein | Connector_JST:JST_XH_B2B-XH-A_1x02_P2.50mm_Vertical
J814 | OSC 2 ein | Connector_JST:JST_XH_B2B-XH-A_1x02_P2.50mm_Vertical
J815 | OSC 3 ein | Connector_JST:JST_XH_B2B-XH-A_1x02_P2.50mm_Vertical
J816 | -> Filter A | Connector_JST:JST_XH_B2B-XH-A_1x02_P2.50mm_Vertical
J817 | Filter B -> | Connector_JST:JST_XH_B2B-XH-A_1x02_P2.50mm_Vertical
J904 | Lautsprecher 8R | Connector_JST:JST_XH_B2B-XH-A_1x02_P2.50mm_Vertical
J990 | Netzteil +/-12V | Connector_JST:JST_XH_B3B-XH-A_1x03_P2.50mm_Vertical
Q101,Q201,Q301,Q801 | BC547 | Package_TO_SOT_THT:TO-92_Inline_Wide
R101,R106,R107,R109-R111,R113,R114,R118-R120,R123,R125,R127,R201,R206,R207,R209-R211,R213,R214,R218-R220,R223,R225,R227,R301,R306,R307,R309-R311,R313,R314,R318-R320,R323,R325,R327 | 10k | Resistor_THT:R_Axial_DIN0207_L6.3mm_D2.5mm_P2.54mm_Vertical
R102,R202,R302 | 1k | Resistor_THT:R_Axial_DIN0207_L6.3mm_D2.5mm_P2.54mm_Vertical
R103,R203,R303 | 220 | Resistor_THT:R_Axial_DIN0207_L6.3mm_D2.5mm_P2.54mm_Vertical
R104,R108,R204,R208,R304,R308 | 47k | Resistor_THT:R_Axial_DIN0207_L6.3mm_D2.5mm_P2.54mm_Vertical
R105,R205,R305 | 16k | Resistor_THT:R_Axial_DIN0207_L6.3mm_D2.5mm_P2.54mm_Vertical
R112,R212,R312 | 82k | Resistor_THT:R_Axial_DIN0207_L6.3mm_D2.5mm_P2.54mm_Vertical
R115,R215,R315 | 330k | Resistor_THT:R_Axial_DIN0207_L6.3mm_D2.5mm_P2.54mm_Vertical
R116,R216,R316 | 2.2k | Resistor_THT:R_Axial_DIN0207_L6.3mm_D2.5mm_P2.54mm_Vertical
R117,R122,R217,R222,R317,R322 | 100k | Resistor_THT:R_Axial_DIN0207_L6.3mm_D2.5mm_P2.54mm_Vertical
R121,R221,R321 | 100 | Resistor_THT:R_Axial_DIN0207_L6.3mm_D2.5mm_P2.54mm_Vertical
R124,R224,R324 | 56k | Resistor_THT:R_Axial_DIN0207_L6.3mm_D2.5mm_P2.54mm_Vertical
R126,R226,R326 | 20k | Resistor_THT:R_Axial_DIN0207_L6.3mm_D2.5mm_P2.54mm_Vertical
R401,R402,R501,R502,R601,R602,R701,R702 | 1k | Resistor_THT:R_Axial_DIN0207_L6.3mm_D2.5mm_P7.62mm_Horizontal
R403,R407,R503,R507,R603,R607,R703,R707 | 6.8k | Resistor_THT:R_Axial_DIN0207_L6.3mm_D2.5mm_P7.62mm_Horizontal
R404-R406,R408-R410,R504-R506,R508-R510,R604-R606,R608-R610,R704-R706,R708-R710,R805 | 10k | Resistor_THT:R_Axial_DIN0207_L6.3mm_D2.5mm_P7.62mm_Horizontal
R801-R803,R809 | 100k | Resistor_THT:R_Axial_DIN0207_L6.3mm_D2.5mm_P7.62mm_Horizontal
R804 | 47k | Resistor_THT:R_Axial_DIN0207_L6.3mm_D2.5mm_P7.62mm_Horizontal
R806 | 470 | Resistor_THT:R_Axial_DIN0207_L6.3mm_D2.5mm_P7.62mm_Horizontal
R807 | 100 | Resistor_THT:R_Axial_DIN0207_L6.3mm_D2.5mm_P7.62mm_Horizontal
R808 | 1 | Resistor_THT:R_Axial_DIN0207_L6.3mm_D2.5mm_P7.62mm_Horizontal
R901 | 10 | Resistor_THT:R_Axial_DIN0207_L6.3mm_D2.5mm_P7.62mm_Horizontal
R902 | 68k | Resistor_THT:R_Axial_DIN0207_L6.3mm_D2.5mm_P7.62mm_Horizontal
RV101,RV102,RV201,RV202,RV301,RV302 | 1M lin
RV103,RV203,RV303,RV401,RV402,RV501,RV502,RV601,RV602,RV701,RV702 | 100k lin
RV104,RV204,RV304 | 100k log
RV105,RV205,RV305,RV801-RV803,RV901 | 10k log
RV403,RV503,RV603,RV703 | 47k lin
SW101,SW201,SW301 | Wellenform
SW102,SW202,SW302 | weich/hart
SW103,SW203,SW303 | Distortion ein/aus
SW104,SW204,SW304 | Solo-Filter ein/aus
SW401,SW501,SW601,SW701 | Filterwahl
U101,U201,U301 | TL074 | Package_DIP:DIP-14_W7.62mm_Socket
U102,U202,U302 | 74LVC2G17 | Package_TO_SOT_SMD:SOT-23-6
U103,U203,U303,U401,U501,U601,U701 | TL074CDR | Package_SO:SOIC-14_3.9x8.7mm_P1.27mm
U104,U204,U304 | OPA1662 | Package_SO:SOIC-8_3.9x4.9mm_P1.27mm
U901 | LM386 | Package_DIP:DIP-8_W7.62mm_Socket
U990 | 78L05 | Package_TO_SOT_THT:TO-92_Inline_Wide
