lukimcfly/MaturaProjekt/Platinen/Fertigung/filter-BOM-jlcpcb.csv

Comment | Designator | Footprint | LCSC Part #
TL074CDR | U401 | SOIC-14_3.9x8.7mm_P1.27mm | C12594
