lukimcfly/MaturaProjekt/Platinen/Fertigung/oszillator-BOM-jlcpcb.csv

Comment | Designator | Footprint | LCSC Part #
SN74LVC2G17DBVR | U102 | SOT-23-6 | C10429
TL074CDR | U103 | SOIC-14_3.9x8.7mm_P1.27mm | C12594
OPA1662AIDR | U104 | SOIC-8_3.9x4.9mm_P1.27mm | C882794
