lukimcfly/MaturaProjekt/Platinen/Stuecklisten/BOM_filter.csv

Reference | Value | Footprint
C401,C402 | 15nF | Capacitor_THT:C_Rect_L7.0mm_W2.5mm_P5.00mm
C403,C404 | 100nF | Capacitor_THT:C_Disc_D5.0mm_W2.5mm_P5.00mm
C405,C406 | 10uF/25V | Capacitor_THT:CP_Radial_D5.0mm_P2.50mm
J410 | Versorgung ein | Connector_JST:JST_XH_B3B-XH-A_1x03_P2.50mm_Vertical
J411 | Versorgung weiter | Connector_JST:JST_XH_B3B-XH-A_1x03_P2.50mm_Vertical
J412 | Panel Poti + Wahlschalter | Connector_JST:JST_XH_B12B-XH-A_1x12_P2.50mm_Vertical
J413 | Audio ein | Connector_JST:JST_XH_B2B-XH-A_1x02_P2.50mm_Vertical
J414 | Audio aus | Connector_JST:JST_XH_B2B-XH-A_1x02_P2.50mm_Vertical
R401,R402 | 1k | Resistor_THT:R_Axial_DIN0207_L6.3mm_D2.5mm_P7.62mm_Horizontal
R403,R407 | 6.8k | Resistor_THT:R_Axial_DIN0207_L6.3mm_D2.5mm_P7.62mm_Horizontal
R404-R406,R408-R410 | 10k | Resistor_THT:R_Axial_DIN0207_L6.3mm_D2.5mm_P7.62mm_Horizontal
RV401,RV402 | 100k lin
RV403 | 47k lin
SW401 | Filterwahl
U401 | TL074CDR | Package_SO:SOIC-14_3.9x8.7mm_P1.27mm
