lukimcfly/MaturaProjekt/Platinen/Stuecklisten/BOM_osc.csv

Reference | Value | Footprint
C101 | 56nF | Capacitor_THT:C_Rect_L7.0mm_W2.5mm_P5.00mm
C102 | 15nF | Capacitor_THT:C_Rect_L7.0mm_W2.5mm_P5.00mm
C103,C104 | 1uF | Capacitor_THT:C_Rect_L7.0mm_W4.5mm_P5.00mm
C105-C111 | 100nF | Capacitor_THT:C_Disc_D5.0mm_W2.5mm_P5.00mm
C112,C113 | 10uF/25V | Capacitor_THT:CP_Radial_D5.0mm_P2.50mm
D101-D106 | 1N4148 | Diode_THT:D_DO-35_SOD27_P7.62mm_Horizontal
J101 | Filter-Send
J102 | Filter-Return
J103 | Ausgang
J110 | Versorgung ein | Connector_JST:JST_XH_B4B-XH-A_1x04_P2.50mm_Vertical
J111 | Versorgung weiter | Connector_JST:JST_XH_B4B-XH-A_1x04_P2.50mm_Vertical
J112 | Panel Potis | Connector_JST:JST_XH_B11B-XH-A_1x11_P2.50mm_Vertical
J113 | Panel Schalter | Connector_JST:JST_XH_B14B-XH-A_1x14_P2.50mm_Vertical
J114 | Panel Buchsen | Connector_JST:JST_XH_B6B-XH-A_1x06_P2.50mm_Vertical
J115 | Audio aus -> Mixer | Connector_JST:JST_XH_B2B-XH-A_1x02_P2.50mm_Vertical
Q101 | BC547 | Package_TO_SOT_THT:TO-92_Inline_Wide
R101,R106,R107,R109-R111,R113,R114,R118-R120,R123,R125,R127 | 10k | Resistor_THT:R_Axial_DIN0207_L6.3mm_D2.5mm_P2.54mm_Vertical
R102 | 1k | Resistor_THT:R_Axial_DIN0207_L6.3mm_D2.5mm_P2.54mm_Vertical
R103 | 220 | Resistor_THT:R_Axial_DIN0207_L6.3mm_D2.5mm_P2.54mm_Vertical
R104,R108 | 47k | Resistor_THT:R_Axial_DIN0207_L6.3mm_D2.5mm_P2.54mm_Vertical
R105 | 16k | Resistor_THT:R_Axial_DIN0207_L6.3mm_D2.5mm_P2.54mm_Vertical
R112 | 82k | Resistor_THT:R_Axial_DIN0207_L6.3mm_D2.5mm_P2.54mm_Vertical
R115 | 330k | Resistor_THT:R_Axial_DIN0207_L6.3mm_D2.5mm_P2.54mm_Vertical
R116 | 2.2k | Resistor_THT:R_Axial_DIN0207_L6.3mm_D2.5mm_P2.54mm_Vertical
R117,R122 | 100k | Resistor_THT:R_Axial_DIN0207_L6.3mm_D2.5mm_P2.54mm_Vertical
R121 | 100 | Resistor_THT:R_Axial_DIN0207_L6.3mm_D2.5mm_P2.54mm_Vertical
R124 | 56k | Resistor_THT:R_Axial_DIN0207_L6.3mm_D2.5mm_P2.54mm_Vertical
R126 | 20k | Resistor_THT:R_Axial_DIN0207_L6.3mm_D2.5mm_P2.54mm_Vertical
RV101,RV102 | 1M lin
RV103 | 100k lin
RV104 | 100k log
RV105 | 10k log
SW101 | Wellenform
SW102 | weich/hart
SW103 | Distortion ein/aus
SW104 | Solo-Filter ein/aus
U101 | TL074 | Package_DIP:DIP-14_W7.62mm_Socket
U102 | 74LVC2G17 | Package_TO_SOT_SMD:SOT-23-6
U103 | TL074CDR | Package_SO:SOIC-14_3.9x8.7mm_P1.27mm
U104 | OPA1662 | Package_SO:SOIC-8_3.9x4.9mm_P1.27mm
