lukimcfly/MaturaProjekt/Einkauf/Einkaufsliste_Synthesizer.xlsx

Sheet: Übersicht
Einkaufsliste Synthesizer - sparsame Version
Maturaprojekt · Stand 11.10.2026 · 1 Gerät, Lieferung bis ~18.10. · Preise = Warenkorb-Preise (Tayda, LCSC, Conrad); JLCPCB geschätzt, da nur nach Login
Eingabe
Anzahl Geräte | 1 | die Warenkörbe sind für 1 Gerät gefüllt
Kurs USD → CHF | 0.84 | aufgerundet für die Umrechnungsgebühr von Karte / PayPal - Tageskurs vor dem Bezahlen prüfen
Bauteile pro Blatt (CHF)
Platine | 26.47
Bedienfeld | 62.95
Verbinder | 28.84
Stromversorgung | 24.04
Arduino | 2.35
Mechanik | 4.12
Abgleich+Reserve | 0.81
Werkzeug | 8.56
Total Bauteile (ohne Platinen, ohne Versand) | 158.14
Pro Lieferant (CHF)
Lieferant | Ware | Versand | Total | Versand in Shop-Währung | Versandart
Tayda (TH) | 95.52 | 17.83 | 113.35 | 21.23 USD | DHL Express DDP - MWST, Zoll und Gebühren inbegriffen, 3-5 Tage
LCSC (CN) | 36.82 | 25.20 | 62.02 | 30 USD | DHL Express statt Standard Line: 4-6 statt 7-15 Werktage (Termin!). Preis im Warenkorb prüfen
Conrad (CH) | 25.80 | 9.95 | 35.75 | 9.95 CHF | Post
Kontrolle: Summe Lieferanten = Total Bauteile | stimmt
Platinen bei JLCPCB (Schätzung in USD - der genaue Preis erscheint erst nach dem Login)
Platine | pro Gerät | benötigt | bestellen | Grösse | Hinweis
Oszillator | 3 | 3 | 5 | 108 × 108 mm | Mindestmenge 5 - 3 gebraucht, 2 Reserve
Filter | 4 | 4 | 5 | 80 × 68 mm | Mindestmenge 5 - 4 gebraucht, 1 Reserve
Hauptplatine | 1 | 1 | 5 | 96 × 98 mm | Mindestmenge 5 - 1 gebraucht
Posten | USD | CHF
Oszillator-Platine 108 × 108 mm, 5 Stück, unbestückt | 11.00 | 9.24 | Schätzung - über 100 × 100 mm, darum kein Sonderangebot
Filter-Platine 80 × 68 mm, 5 Stück, unbestückt | 2.00 | 1.68 | Sonderangebot bis 100 × 100 mm
Hauptplatine 96 × 98 mm, 5 Stück, unbestückt | 2.00 | 1.68 | Sonderangebot bis 100 × 100 mm
Versand DHL Express DDP (MWST inbegriffen) | 28.00 | 23.52 | Schätzung; ohne Bestückung ist das Paket leichter als im September
JLCPCB total (Schätzung) | 43.00 | 36.12
GESAMTKOSTEN für 1 Gerät (CHF, inkl. Versand und MWST) | 247.24
pro Gerät | 247.24
Wichtig und leicht zu übersehen
• Vier Bestellungen: JLCPCB (Platinen), LCSC (JST-Stecker, Sonderteile), Tayda (fast alles Übrige), Conrad (Netzteile, Litze). Anleitung: Einkauf/BESTELLEN.md.
• TERMIN: die Teile sollen bis ~18.10.2026 da sein. Darum bei Tayda UND LCSC DHL Express wählen - die Standard-Linie von LCSC braucht 7-15 Werktage und wäre zu spät.
• JLCPCB liefert UNBESTÜCKT. Die 13 SMD-Chips pro Gerät (7 × TL074CDR, 3 × OPA1662, 3 × 74LVC2G17) werden selbst gelötet und sind in der Liste Platine enthalten.
• Der 74LVC2G17 ist SOT-23-6 mit 0,95 mm Raster - der heikelste Chip. Deshalb 10 statt 3 im Warenkorb.
• Die Feiertage in China (25.09.-07.10.) sind vorbei, aber JLCPCB warnt vor Rückstau direkt danach. Platinen zuerst bestellen.
• Vierfach-Op-Amp auf Oszillator und Filter ist jetzt ein TL074CDR statt OPA4196: gleiche Anschlüsse, Simulation deckungsgleich, 0.29 statt 3.62 USD.
• Tonhöhe- und Cutoff-Potis mit Kennlinie C (umgekehrt logarithmisch) - so wie sie verdrahtet sind, verteilt nur C die Oktaven gleichmässig.
• Zeitkondensatoren (56 nF, 15 nF) müssen Folie sein - der Keramik-"104" vom Steckbrett lag 56 % neben dem aufgedruckten Wert.
• Stromversorgung neu: +12 V direkt vom Netzteil, −12 V aus dem DC/DC-Wandler B1212S (+Vo an Masse). Gemeinsame Masse mit dem Arduino ist damit automatisch gegeben.
• Frontplatte höchstens ca. 3 mm dick (Klinkenbuchsen haben ein kurzes Gewinde) - bei dickerem Holz die Löcher von hinten aussenken.
• Arduino nie direkt an ein Audiosignal: die Signale schwingen um 0 V (auch negativ). Immer über die Eingangsstufe (Blatt Arduino), Abgriff FILT_B_OUT an J817.

Sheet: Platine
Platine
Alle Bauteile auf den Platinen - von Hand gelötet. JLCPCB liefert die Platinen unbestückt, deshalb stehen die 13 SMD-Chips (TL074CDR, OPA1662, 74LVC2G17) jetzt mit in dieser Liste.
Bestellmenge = Pro Gerät × Anzahl Geräte (Übersicht) + Zusätzlich - Vorhanden. Bei 1 Gerät ist das genau die Menge im Warenkorb (Shops runden, z. B. Widerstände in 10er-Schritten).
Erledigt | Teil | Wert / Typ | Bauform / Spezifikation | Wo (Referenz) | Pro Gerät | Zusätzlich (Reserve / Rundung) | Vorhanden | Bestellmenge | Lieferant | Art.-Nr. im Shop | Preis/Stk. (Warenkorb) | Währung | Summe CHF | Bemerkung
 | Widerstand | 1 Ω | Metallschicht 1 %, 0,25 W, 0207 (Royal Ohm) | R808 | 1 | 9 | 0 | 10 | Tayda (TH) | A-2244 | 0.015 | USD | 0.13 | nur in 10er-Schritten erhältlich
 | Widerstand | 10 Ω | Metallschicht 1 %, 0,25 W, 0207 (Royal Ohm) | R901 | 1 | 9 | 0 | 10 | Tayda (TH) | A-2198 | 0.015 | USD | 0.13 | nur in 10er-Schritten erhältlich
 | Widerstand | 100 Ω | Metallschicht 1 %, 0,25 W, 0207 (Royal Ohm) | R121, R221, R321, R807 | 4 | 6 | 0 | 10 | Tayda (TH) | A-2245 | 0.015 | USD | 0.13 | nur in 10er-Schritten erhältlich
 | Widerstand | 220 Ω | Metallschicht 1 %, 0,25 W, 0207 (Royal Ohm) | R103, R203, R303 | 3 | 5 | 0 | 8 | Tayda (TH) | A-2246 | 0.015 | USD | 0.10 | nur in 10er-Schritten erhältlich
 | Widerstand | 470 Ω | Metallschicht 1 %, 0,25 W, 0207 (Royal Ohm) | R806 | 1 | 9 | 0 | 10 | Tayda (TH) | A-2247 | 0.015 | USD | 0.13 | nur in 10er-Schritten erhältlich
 | Widerstand | 1kΩ | Metallschicht 1 %, 0,25 W, 0207 (Royal Ohm) | R102, R202, R302, R401, R402, R501, … (11) | 11 | 11 | 0 | 22 | Tayda (TH) | A-2200 | 0.015 | USD | 0.28 | nur in 10er-Schritten erhältlich
 | Widerstand | 2.2kΩ | Metallschicht 1 %, 0,25 W, 0207 (Royal Ohm) | R116, R216, R316 | 3 | 7 | 0 | 10 | Tayda (TH) | A-2341 | 0.015 | USD | 0.13 | nur in 10er-Schritten erhältlich
 | Widerstand | 6.8kΩ | Metallschicht 1 %, 0,25 W, 0207 (Royal Ohm) | R403, R407, R503, R507, R603, R607, R703, R707 | 8 | 2 | 0 | 10 | Tayda (TH) | A-2328 | 0.015 | USD | 0.13 | nur in 10er-Schritten erhältlich
 | Widerstand | 10kΩ | Metallschicht 1 %, 0,25 W, 0207 (Royal Ohm) | R101, R106, R107, R109, R110, R111, … (67) | 67 | 13 | 0 | 80 | Tayda (TH) | A-2203 | 0.015 | USD | 1.01 | nur in 10er-Schritten erhältlich
 | Widerstand | 16kΩ | Metallschicht 1 %, 0,25 W, 0207 (Royal Ohm) | R105, R205, R305 | 3 | 7 | 0 | 10 | Tayda (TH) | A-2206 | 0.015 | USD | 0.13 | nur in 10er-Schritten erhältlich
 | Widerstand | 20kΩ | Metallschicht 1 %, 0,25 W, 0207 (Royal Ohm) | R126, R226, R326 | 3 | 7 | 0 | 10 | Tayda (TH) | A-2339 | 0.015 | USD | 0.13 | nur in 10er-Schritten erhältlich
 | Widerstand | 47kΩ | Metallschicht 1 %, 0,25 W, 0207 (Royal Ohm) | R104, R108, R204, R208, R304, R308, R804 | 7 | 8 | 0 | 15 | Tayda (TH) | A-2279 | 0.015 | USD | 0.19 | nur in 10er-Schritten erhältlich
 | Widerstand | 56kΩ | Metallschicht 1 %, 0,25 W, 0207 (Royal Ohm) | R124, R224, R324 | 3 | 7 | 0 | 10 | Tayda (TH) | A-2191 | 0.015 | USD | 0.13 | nur in 10er-Schritten erhältlich
 | Widerstand | 68kΩ | Metallschicht 1 %, 0,25 W, 0207 (Royal Ohm) | R902 | 1 | 9 | 0 | 10 | Tayda (TH) | A-2334 | 0.015 | USD | 0.13 | nur in 10er-Schritten erhältlich
 | Widerstand | 82kΩ | Metallschicht 1 %, 0,25 W, 0207 (Royal Ohm) | R112, R212, R312 | 3 | 7 | 0 | 10 | Tayda (TH) | A-2338 | 0.015 | USD | 0.13 | nur in 10er-Schritten erhältlich
 | Widerstand | 100kΩ | Metallschicht 1 %, 0,25 W, 0207 (Royal Ohm) | R117, R122, R217, R222, R317, R322, … (10) | 10 | 10 | 0 | 20 | Tayda (TH) | A-2248 | 0.015 | USD | 0.25 | nur in 10er-Schritten erhältlich
 | Widerstand | 330kΩ | Metallschicht 1 %, 0,25 W, 0207 (Royal Ohm) | R115, R215, R315 | 3 | 7 | 0 | 10 | Tayda (TH) | A-2330 | 0.015 | USD | 0.13 | nur in 10er-Schritten erhältlich
 | Folienkondensator | 56 nF | Polyester, RM 5 mm, 7,2 × 2,5 mm | C101, C201, C301 | 3 | 2 | 0 | 5 | Tayda (TH) | A-704 | 0.12 | USD | 0.50 | Zeitkondensator Sägezahn - Folie, keine Keramik! (Keramik lag 56 % daneben)
 | Folienkondensator | 15 nF | Polyester, RM 5 mm, 7,2 × 3,5 mm - passt, neben C102/C401/C402 ist 1,7 mm Luft | C102, C202, C302, C401, C402, C501, … (11) | 11 | 2 | 0 | 13 | Tayda (TH) | A-702 | 0.10 | USD | 1.09 | Zeitkondensator Funktionsgenerator + Filter - Folie
 | Folienkondensator | 47 nF | Polyester, RM 5 mm, 7,2 × 2,5 mm | C905 | 1 | 0 | 0 | 1 | Tayda (TH) | A-563 | 0.065 | USD | 0.05
 | Folienkondensator | 330 nF | Polyester, RM 5 mm, 7,2 × 3,5 mm (Hauptplatine, viel Platz) | C941 | 1 | 1 | 0 | 2 | Tayda (TH) | A-566 | 0.14 | USD | 0.24
 | Folienkondensator | 1 µF | Polyester, RM 5 mm, 7,2 × 5 mm, 63 V - passt, neben C104 bleibt 1 mm Luft | C103, C104, C203, C204, C303, C304, … (9) | 9 | 2 | 0 | 11 | Tayda (TH) | A-8409 | 0.25 | USD | 2.31
 | Keramikkondensator | 100 nF | 50 V, Scheibe, RM 5 mm | C105, C106, C107, C108, C109, C110, … (33) | 33 | 4 | 0 | 37 | Tayda (TH) | A-553 | 0.01 | USD | 0.31 | nur Abblockkondensatoren an den Versorgungspins - dort reicht Scheibenkeramik
 | Elektrolytkondensator | 10 µF / 25 V | radial 5 × 11 mm, 105 °C | C112, C113, C212, C213, C312, C313, … (16) | 16 | 2 | 0 | 18 | Tayda (TH) | A-4534 | 0.02 | USD | 0.30 | 10 µF/16 V der Hauptplatine durch 25-V-Typ ersetzt
 | Elektrolytkondensator | 47 µF / 25 V | radial 5 × 11 mm, 105 °C | C806 | 1 | 1 | 0 | 2 | Tayda (TH) | A-5713 | 0.02 | USD | 0.03
 | Elektrolytkondensator | 100 µF / 25 V | radial 6,3 × 11 mm, 105 °C | C906, C931, C932 | 3 | 2 | 0 | 5 | Tayda (TH) | A-4541 | 0.03 | USD | 0.13
 | Elektrolytkondensator | 470 µF / 25 V | radial 10 × 13 mm, RM 5 mm | C805, C904 | 2 | 1 | 0 | 3 | Tayda (TH) | A-4783 | 0.08 | USD | 0.20 | 470 µF/16 V durch 25-V-Typ ersetzt
 | Elektrolytkondensator | 10 µF bipolar | bipolar 35 V, 5 × 11 mm | C901 | 1 | 1 | 0 | 2 | Tayda (TH) | A-6355 | 0.06 | USD | 0.10 | liegt auf 0 V Gleichspannung - bipolar nötig
 | Diode | 1N4148 | DO-35 | D101, D102, D103, D104, D105, D106, … (18) | 18 | 2 | 0 | 20 | Tayda (TH) | A-157 | 0.01 | USD | 0.17
 | Schottky-Diode | 1N5819 | DO-41 | D907, D908 | 2 | 1 | 0 | 3 | Tayda (TH) | A-484 | 0.05 | USD | 0.13 | Verpolschutz
 | Transistor | BC547 | TO-92 (Beine auf 2,54 mm spreizen) | Q101, Q201, Q301, Q801 | 4 | 2 | 0 | 6 | Tayda (TH) | A-137 | 0.08 | USD | 0.40
 | Spannungsregler | 78L05 | TO-92, L78L05ACZ | U990 | 1 | 1 | 0 | 2 | Tayda (TH) | A-176 | 0.15 | USD | 0.25
 | Op-Amp | TL074 | DIP-14, TL074CN | U101, U201, U301 | 3 | 2 | 0 | 5 | Tayda (TH) | A-1138 | 0.59 | USD | 2.48 | gesockelt - Tausch ohne Löten
 | Endstufe | LM386 | DIP-8, LM386N-4/NOPB (TI) | U901 | 1 | 1 | 0 | 2 | LCSC (CN) | C194458 | 1.0451 | USD | 1.76 | N-4 (bis 18 V) statt N-1 (nur bis 12 V) - bei Tayda nicht lieferbar, deshalb LCSC
 | Op-Amp (SMD) | TL074CDR | SOIC-14, Raster 1,27 mm - von Hand gut lötbar | U103, U203, U303, U401, U501, U601, U701 | 7 | 3 | 0 | 10 | LCSC (CN) | C12594 | 0.2887 | USD | 2.43 | JLCPCB bestückt nicht mehr - selbst löten. Flussmittel benutzen
 | Op-Amp (SMD) | OPA1662 | SOIC-8, Raster 1,27 mm - von Hand gut lötbar | U104, U204, U304 | 3 | 2 | 0 | 5 | LCSC (CN) | C882794 | 1.0769 | USD | 4.52
 | Schmitt-Trigger (SMD) | 74LVC2G17 | SOT-23-6, Raster 0,95 mm - der heikelste Chip | U102, U202, U302 | 3 | 7 | 0 | 10 | LCSC (CN) | C10429 | 0.2575 | USD | 2.16 | Schwellen streuen stark, und von Hand geht der erste Versuch oft daneben: Reserve ist Absicht
 | IC-Fassung | DIP-14 | gedreht (Präzision) | U101, U201, U301 | 3 | 2 | 0 | 5 | Tayda (TH) | A-1317 | 0.24 | USD | 1.01
 | IC-Fassung | DIP-8 | gedreht (Präzision) | U901 | 1 | 1 | 0 | 2 | Tayda (TH) | A-857 | 0.12 | USD | 0.20
 | Feinsicherung | T 500 mA | träge, 5 × 20 mm, Littelfuse 0218.500MXP | F901, F902 | 2 | 3 | 0 | 5 | LCSC (CN) | C142727 | 0.1559 | USD | 0.65 | Reserve bewusst gross - Sicherungen sind Verbrauchsmaterial
 | Sicherungsclip | 5 × 20 mm | Littelfuse 01110501Z (111er-Serie) | F901, F902 (je 2 Clips) | 4 | 6 | 0 | 10 | LCSC (CN) | C151075 | 0.202 | USD | 1.70 | Footprint ist für genau diese Serie gezeichnet
 |  |  |  |  |  |  |  |  |  |  |  | Summe | 26.47

Sheet: Bedienfeld
Bedienfeld
Potis, Schalter, Buchsen, Knöpfe - sitzen im Bedienfeld und sind per Kabel mit den Platinen verbunden.
Bestellmenge = Pro Gerät × Anzahl Geräte (Übersicht) + Zusätzlich - Vorhanden. Bei 1 Gerät ist das genau die Menge im Warenkorb (Shops runden, z. B. Widerstände in 10er-Schritten).
Erledigt | Teil | Wert / Typ | Bauform / Spezifikation | Wo (Referenz) | Pro Gerät | Zusätzlich (Reserve / Rundung) | Vorhanden | Bestellmenge | Lieferant | Art.-Nr. im Shop | Preis/Stk. (Warenkorb) | Währung | Summe CHF | Bemerkung
 | Tandem-Poti (Stereo) | 1 MΩ, Kennlinie C (umgekehrt log.) | Alpha 16 mm, Achse 6 mm rund, Printstifte | RV_01 + RV_02 je Oszillator | 3 | 2 | 0 | 5 | Tayda (TH) | A-8590 | 0.99 | USD | 4.16 | Tonhöhe. C, nicht A: verdrahtet wird Lug 1 (CW) + Schleifer - nur mit C verteilen sich die Oktaven gleichmässig. Siehe BEDIENFELD-ERGAENZUNGEN.md
 | Tandem-Poti (Stereo) | 100 kΩ, Kennlinie C (umgekehrt log.) | Alpha 16 mm, Achse 6,35 mm, Printstifte | RV_01 + RV_02 je Filter | 4 | 2 | 0 | 6 | Tayda (TH) | A-4749 | 0.80 | USD | 4.03 | Cutoff - gleiche Begründung wie bei der Tonhöhe
 | Poti | 100 kΩ lin (B) | 16 mm, Lötfahnen, Achse 6,35 mm | RV_03 je Oszillator (Drive) | 3 | 2 | 0 | 5 | Tayda (TH) | A-5617 | 0.39 | USD | 1.64
 | Poti | 100 kΩ log (A) | Alpha 16 mm, Lötfahnen, Achse 6,35 mm | RV_04 je Oszillator (Distortion-Pegel) | 3 | 2 | 0 | 5 | Tayda (TH) | A-2401 | 0.50 | USD | 2.10
 | Poti | 10 kΩ log (A) | Alpha 16 mm, Lötfahnen, Achse 6,35 mm | RV_05 je Osz. (Amplitude), Master (RV901) | 4 | 2 | 0 | 6 | Tayda (TH) | A-4875 | 0.50 | USD | 2.52
 | Schiebepoti (Fader) | 10 kΩ log (A) | Alpha, 60 mm Schiebeweg, Metallhebel | Mixer Kanal 1-3 (RV801-RV803) | 3 | 2 | 0 | 5 | Tayda (TH) | A-1617 | 1.69 | USD | 7.10 | gleiche 3 Anschlüsse wie im Verdrahtungsplan. Schlitz in der Front ca. 62 mm
 | Fader-Knopf | schwarz | für Schiebepoti | Mixer | 3 | 2 | 0 | 5 | Tayda (TH) | A-5396 | 0.39 | USD | 1.64
 | Poti | 50 kΩ lin (B) | Alpha 16 mm, Lötfahnen, Achse 6,35 mm | RV_03 je Filter (Resonanz) | 4 | 2 | 0 | 6 | Tayda (TH) | A-2398 | 0.50 | USD | 2.52 | Schaltplan sagt 47 kΩ - 50 kΩ ist der gängige Wert und geht genauso
 | Drehschalter | 1 × 12, Anschlag einstellbar | Alpha SR2611F, Lötfahnen, runde Achse | SW_01 Oszillator (4 Stell.), SW_01 Filter (5 Stell.) | 7 | 2 | 0 | 9 | Tayda (TH) | A-1893 | 1.69 | USD | 12.78 | Anschlag mit der Scheibe auf 4 bzw. 5 Stellungen setzen
 | Kippschalter | EIN-EIN (1 × UM) | SPDT, 1M-Serie, 6 mm Einbau | SW_02..SW_05 je Oszillator | 12 | 0 | 0 | 12 | Tayda (TH) | A-3186 | 0.70 | USD | 7.06 | SW_05 = Oszillator ein/aus, siehe BEDIENFELD-ERGAENZUNGEN.md
 | Klinkenbuchse | 3,5 mm mono | PJ-301BM, Einbau, isoliert | J_01..J_03 je Osz., Filter C/D ein/aus | 13 | 2 | 0 | 15 | Tayda (TH) | A-2566 | 0.29 | USD | 3.65 | Frontplatte höchstens ca. 3 mm dick (kurzes Gewinde) - bei dickerem Holz von hinten aussenken
 | Drehknopf | für 6,35-mm-Achse, Madenschraube | KN8E, 20 × 16 mm | 21 Drehpotis + 7 Drehschalter | 28 | 3 | 0 | 31 | Tayda (TH) | A-6751 | 0.40 | USD | 10.42 | Madenschraube hält auch auf den 6-mm-Achsen der 1-MΩ-Tandempotis
 | Taster | Schliesser, tastend | rund, schwarz | Oszilloskop-Modus ZEIT/FIGUR/FREI | 1 | 1 | 0 | 2 | Tayda (TH) | A-3487 | 1.09 | USD | 1.83 | zwischen Arduino-Pin RESET und GND
 | Lautsprecherklemme | rot | Polklemme 4 mm, vergoldet | + an J904 Pin 1 | 1 | 1 | 0 | 2 | Tayda (TH) | A-6484 | 0.45 | USD | 0.76
 | Lautsprecherklemme | schwarz | Polklemme 4 mm, vergoldet | − an J904 Pin 2 | 1 | 1 | 0 | 2 | Tayda (TH) | A-6483 | 0.45 | USD | 0.76
 |  |  |  |  |  |  |  |  |  |  |  | Summe | 62.95

Sheet: Verbinder
Verbinder
JST-XH-Stecker (original JST) und Litze für alle Kabel zwischen den Platinen und zum Bedienfeld.
Bestellmenge = Pro Gerät × Anzahl Geräte (Übersicht) + Zusätzlich - Vorhanden. Bei 1 Gerät ist das genau die Menge im Warenkorb (Shops runden, z. B. Widerstände in 10er-Schritten).
Erledigt | Teil | Wert / Typ | Bauform / Spezifikation | Wo (Referenz) | Pro Gerät | Zusätzlich (Reserve / Rundung) | Vorhanden | Bestellmenge | Lieferant | Art.-Nr. im Shop | Preis/Stk. (Warenkorb) | Währung | Summe CHF | Bemerkung
 | JST-XH Stiftleiste | 2-polig | B2B-XH-A, original JST, RM 2,50 mm | auf den Platinen | 17 | 3 | 0 | 20 | LCSC (CN) | C158012 | 0.0409 | USD | 0.69
 | JST-XH Stiftleiste | 3-polig | B3B-XH-A, original JST, RM 2,50 mm | auf den Platinen | 10 | 0 | 0 | 10 | LCSC (CN) | C144394 | 0.0548 | USD | 0.46
 | JST-XH Stiftleiste | 4-polig | B4B-XH-A, original JST, RM 2,50 mm | auf den Platinen | 7 | 3 | 0 | 10 | LCSC (CN) | C144395 | 0.0625 | USD | 0.53
 | JST-XH Stiftleiste | 6-polig | B6B-XH-A, original JST, RM 2,50 mm | auf den Platinen | 3 | 7 | 0 | 10 | LCSC (CN) | C144397 | 0.092 | USD | 0.77
 | JST-XH Stiftleiste | 11-polig | B11B-XH-A, original JST, RM 2,50 mm | auf den Platinen | 3 | 7 | 0 | 10 | LCSC (CN) | C158031 | 0.1955 | USD | 1.64
 | JST-XH Stiftleiste | 12-polig | B12B-XH-A, original JST, RM 2,50 mm | auf den Platinen | 5 | 5 | 0 | 10 | LCSC (CN) | C158027 | 0.2166 | USD | 1.82
 | JST-XH Stiftleiste | 14-polig | B14B-XH-A, original JST, RM 2,50 mm | auf den Platinen | 3 | 7 | 0 | 10 | LCSC (CN) | C158022 | 0.2686 | USD | 2.26
 | JST-XH Gehäuse | 2-polig | XHP-2, original JST | Kabelseite | 17 | 3 | 0 | 20 | LCSC (CN) | C144401 | 0.0202 | USD | 0.34
 | JST-XH Gehäuse | 3-polig | XHP-3, original JST | Kabelseite | 10 | 0 | 0 | 10 | LCSC (CN) | C144402 | 0.0271 | USD | 0.23
 | JST-XH Gehäuse | 4-polig | XHP-4, original JST | Kabelseite | 7 | 3 | 0 | 10 | LCSC (CN) | C144403 | 0.0239 | USD | 0.20
 | JST-XH Gehäuse | 6-polig | XHP-6, original JST | Kabelseite | 3 | 7 | 0 | 10 | LCSC (CN) | C144405 | 0.0281 | USD | 0.24
 | JST-XH Gehäuse | 11-polig | XHP-11, original JST | Kabelseite | 3 | 7 | 0 | 10 | LCSC (CN) | C157889 | 0.0651 | USD | 0.55
 | JST-XH Gehäuse | 12-polig | XHP-12, original JST | Kabelseite | 5 | 5 | 0 | 10 | LCSC (CN) | C157888 | 0.0597 | USD | 0.50
 | JST-XH Gehäuse | 14-polig | XHP-14, original JST | Kabelseite | 3 | 7 | 0 | 10 | LCSC (CN) | C157886 | 0.0735 | USD | 0.62
 | JST-XH Crimpkontakt | Buchse | SXH-001T-P0.6, original JST, AWG 28-22 | 245 Kontakte pro Gerät | 245 | 0 | 0 | 245 | LCSC (CN) | C140573 | 0.01 | USD | 2.06 | Grosse Reserve: die ersten Crimps gehen erfahrungsgemäss daneben
 | Litze | 0,14 mm² (AWG 26) | Quadrios 22CW001: 10 Farben × 10 m = 100 m | 153 Bedienfeld-Drähte + Platinenkabel | 0 | 1 | 0 | 1 | Conrad (CH) | 2620403 | 15.95 | CHF | 15.95 | ca. 40 m pro Gerät - ein Set reicht für beide
 |  |  |  |  |  |  |  |  |  |  |  | Summe | 28.84

Sheet: Stromversorgung
Stromversorgung
12-V-Steckernetzteil ausserhalb des Holzgehäuses; +12 V direkt, −12 V aus einem kleinen DC/DC-Wandler, 12 V für den Arduino.
Bestellmenge = Pro Gerät × Anzahl Geräte (Übersicht) + Zusätzlich - Vorhanden. Bei 1 Gerät ist das genau die Menge im Warenkorb (Shops runden, z. B. Widerstände in 10er-Schritten).
Erledigt | Teil | Wert / Typ | Bauform / Spezifikation | Wo (Referenz) | Pro Gerät | Zusätzlich (Reserve / Rundung) | Vorhanden | Bestellmenge | Lieferant | Art.-Nr. im Shop | Preis/Stk. (Warenkorb) | Währung | Summe CHF | Bemerkung
 | Steckernetzteil | 12 V DC, 1 A | Mean Well NGE12E12-P1J, Eurostecker, Hohlstecker 5,5/2,1 | versorgt alles | 1 | 0 | 0 | 1 | Conrad (CH) | 3164222 | 9.85 | CHF | 9.85 | Netzspannung bleibt ausserhalb des Holzgehäuses. Bedarf ca. 0,5 A
 | DC/DC-Wandler, isoliert | 12 V → 12 V, 2 W (für −12 V) | B1212S-2WR3 (HI-LINK), SIP-4 | erzeugt −12 V | 1 | 1 | 0 | 2 | LCSC (CN) | C5365309 | 1.2554 | USD | 2.11 | +Vo an Masse, 0V-Ausgang ist dann −12 V. +12 V kommt direkt vom Netzteil. Siehe BEDIENFELD-ERGAENZUNGEN.md
 | Elektrolytkondensator | 22 µF / 25 V | 5 × 11 mm | Eingang DC/DC-Wandler | 1 | 1 | 0 | 2 | Tayda (TH) | A-4784 | 0.07 | USD | 0.12
 | Lochrasterplatine | 50 × 70 mm | doppelseitig | Netzteil-Platinchen | 1 | 1 | 0 | 2 | Tayda (TH) | A-1194 | 0.99 | USD | 1.66
 | DC-Einbaubuchse | 5,5 / 2,1 mm | rund, Gehäuseeinbau | Rückwand | 1 | 1 | 0 | 2 | Tayda (TH) | A-991 | 0.28 | USD | 0.47
 | Kippschalter | Netzschalter | wie die übrigen (A-3186), nur zwei Anschlüsse benutzt | Hauptschalter | 1 | 2 | 0 | 3 | Tayda (TH) | A-3186 | 0.70 | USD | 1.76
 | Rückstellende Sicherung | 1,1 A | Littelfuse RXEF110, bedrahtet | 12-V-Eingang | 1 | 1 | 0 | 2 | LCSC (CN) | C3760872 | 0.4692 | USD | 0.79
 | JST-XH Stiftleiste | 3-polig | B3B-XH-A | Netzteil-Platinchen → J990 | 1 | 9 | 0 | 10 | LCSC (CN) | C144394 | 0.0548 | USD | 0.46
 | JST-XH Gehäuse | 3-polig | XHP-3 | Netzteil-Platinchen → J990 | 1 | 9 | 0 | 10 | LCSC (CN) | C144402 | 0.0271 | USD | 0.23
 | JST-XH Crimpkontakt | Buchse | SXH-001T-P0.6 | Netzteil-Platinchen → J990 | 3 | 752 | 0 | 755 | LCSC (CN) | C140573 | 0.01 | USD | 6.34
 | DC-Kabel | Stecker 5,5/2,1 mit Litze |  | 12 V an die Arduino-Buchse | 1 | 1 | 0 | 2 | Tayda (TH) | A-6806 | 0.15 | USD | 0.25 | Der Arduino läuft an 12 V über seine eigene Buchse; kein USB mehr nötig
 |  |  |  |  |  |  |  |  |  |  |  | Summe | 24.04

Sheet: Arduino
Arduino
Oszilloskop mit Display, fest im Gerät.
Bestellmenge = Pro Gerät × Anzahl Geräte (Übersicht) + Zusätzlich - Vorhanden. Bei 1 Gerät ist das genau die Menge im Warenkorb (Shops runden, z. B. Widerstände in 10er-Schritten).
Erledigt | Teil | Wert / Typ | Bauform / Spezifikation | Wo (Referenz) | Pro Gerät | Zusätzlich (Reserve / Rundung) | Vorhanden | Bestellmenge | Lieferant | Art.-Nr. im Shop | Preis/Stk. (Warenkorb) | Währung | Summe CHF | Bemerkung
 | Arduino Uno R3 | kompatibel, mit ATmega16U2 |  | Oszilloskop | 1 | 0 | 1 | 0 | Tayda (TH) | A-2854 | 9.99 | USD | 0.00 | 1 ist vorhanden
 | TFT-Display | ILI9341, 240 × 320, SPI | 2,8" (2,2" hat Tayda nicht) - gleicher Chip, Sketch läuft unverändert | Oszilloskop | 1 | 0 | 1 | 0 | Tayda (TH) | A-8181 | 7.99 | USD | 0.00 | 1 (2,2") ist vorhanden. Front-Ausschnitt für das 2,8"-Modul grösser machen
 | Widerstand | 510 Ω | 0207, 1 % | Pegelwandler Display | 4 | 6 | 0 | 10 | Tayda (TH) | A-2621 | 0.015 | USD | 0.13
 | Widerstand | 1 kΩ | 0207, 1 % | Pegelwandler Display (4) + Schutzwiderstand vor A0 (1) | 5 | 3 | 0 | 8 | Tayda (TH) | A-2200 | 0.015 | USD | 0.10
 | Widerstand | 220 Ω | 0207, 1 % | Display-Hintergrundlicht | 1 | 1 | 0 | 2 | Tayda (TH) | A-2246 | 0.015 | USD | 0.03
 | Widerstand | 47 kΩ | 0207, 1 % | Eingangsstufe Oszilloskop | 3 | 2 | 0 | 5 | Tayda (TH) | A-2279 | 0.015 | USD | 0.06 | Eingangsstufe: 1 µF → 47k → Knoten (47k nach +5 V, 47k nach GND) → 1k → A0. Abgriff: FILT_B_OUT an J817
 | Folienkondensator | 1 µF | RM 5 mm | Eingangsstufe Oszilloskop | 1 | 1 | 0 | 2 | Tayda (TH) | A-8409 | 0.25 | USD | 0.42
 | Schottky-Diode | BAT85 | DO-35, Vishay BAT85S | Eingangsschutz A0 | 2 | 8 | 0 | 10 | LCSC (CN) | C3312828 | 0.0938 | USD | 0.79 | leiten alles über 5 V und unter 0 V ab - schützt A0 auch bei ±11 V
 | Lochrasterplatine | 50 × 70 mm | doppelseitig | Display-Pegelwandler + Eingangsstufe | 1 | 0 | 0 | 1 | Tayda (TH) | A-1194 | 0.99 | USD | 0.83
 |  |  |  |  |  |  |  |  |  |  |  | Summe | 2.35

Sheet: Mechanik
Mechanik
Befestigung aller Platinen auf dem Holzboden (Messing-Abstandsbolzen direkt ins Holz).
Bestellmenge = Pro Gerät × Anzahl Geräte (Übersicht) + Zusätzlich - Vorhanden. Bei 1 Gerät ist das genau die Menge im Warenkorb (Shops runden, z. B. Widerstände in 10er-Schritten).
Erledigt | Teil | Wert / Typ | Bauform / Spezifikation | Wo (Referenz) | Pro Gerät | Zusätzlich (Reserve / Rundung) | Vorhanden | Bestellmenge | Lieferant | Art.-Nr. im Shop | Preis/Stk. (Warenkorb) | Währung | Summe CHF | Bemerkung
 | Abstandsbolzen | M3 × 8 mm, Aussen-/Innengewinde | Messing | 44 Löcher pro Gerät | 44 | 5 | 0 | 49 | Tayda (TH) | A-1264 | 0.08 | USD | 3.29 | Aussengewinde direkt ins Holz (2,5-mm-Loch vorbohren), Platine oben mit der Schraube
 | Schraube | M3 × 6 mm | Linsenkopf, Stahl | Platine auf Bolzen | 44 | 5 | 0 | 49 | Tayda (TH) | A-1250 | 0.02 | USD | 0.82
 |  |  |  |  |  |  |  |  |  |  |  | Summe | 4.12

Sheet: Abgleich+Reserve
Abgleich+Reserve
Ausweichwerte zum Feinabstimmen und Ersatzteile für Reparaturen - einmalig, nicht pro Gerät.
Bestellmenge = Pro Gerät × Anzahl Geräte (Übersicht) + Zusätzlich - Vorhanden. Bei 1 Gerät ist das genau die Menge im Warenkorb (Shops runden, z. B. Widerstände in 10er-Schritten).
Erledigt | Teil | Wert / Typ | Bauform / Spezifikation | Wo (Referenz) | Pro Gerät | Zusätzlich (Reserve / Rundung) | Vorhanden | Bestellmenge | Lieferant | Art.-Nr. im Shop | Preis/Stk. (Warenkorb) | Währung | Summe CHF | Bemerkung
 | Folienkondensator | 47 nF | wie C101 | Abgleich Sägezahn (C101 kleiner → höher) | 0 | 1 | 0 | 1 | Tayda (TH) | A-563 | 0.065 | USD | 0.05 | nur falls ein Oszillator neben den anderen Wellenformen liegt
 | Folienkondensator | 68 nF | wie C101 | Abgleich Sägezahn (C101 grösser → tiefer) | 0 | 2 | 0 | 2 | Tayda (TH) | A-707 | 0.12 | USD | 0.20
 | Folienkondensator | 12 nF | wie C102 | Bereich Funktionsgenerator höher | 0 | 2 | 0 | 2 | Tayda (TH) | A-620 | 0.08 | USD | 0.13
 | Folienkondensator | 18 nF | wie C102 | Bereich Funktionsgenerator tiefer | 0 | 2 | 0 | 2 | Tayda (TH) | A-703 | 0.10 | USD | 0.17
 | Widerstand | 15 kΩ | 0207, 1 % | R105 kleiner → FG-Bereich höher | 0 | 10 | 0 | 10 | Tayda (TH) | A-2182 | 0.015 | USD | 0.13
 | Widerstand | 18 kΩ | 0207, 1 % | R105 grösser → FG-Bereich tiefer | 0 | 10 | 0 | 10 | Tayda (TH) | A-2207 | 0.015 | USD | 0.13
 |  |  |  |  |  |  |  |  |  |  |  | Summe | 0.81

Sheet: Werkzeug
Werkzeug
Einmalig. Lötzinn und Entlötlitze nur, falls nicht vorhanden (dann Menge eintragen).
Bestellmenge = Pro Gerät × Anzahl Geräte (Übersicht) + Zusätzlich - Vorhanden. Bei 1 Gerät ist das genau die Menge im Warenkorb (Shops runden, z. B. Widerstände in 10er-Schritten).
Erledigt | Teil | Wert / Typ | Bauform / Spezifikation | Wo (Referenz) | Pro Gerät | Zusätzlich (Reserve / Rundung) | Vorhanden | Bestellmenge | Lieferant | Art.-Nr. im Shop | Preis/Stk. (Warenkorb) | Währung | Summe CHF | Bemerkung
 | Crimpzange | für JST-XH | SN-28B, AWG 28-18 |  | 0 | 1 | 0 | 1 | Tayda (TH) | A-5362 | 9.70 | USD | 8.15 | ohne sie lassen sich die ~500 Kontakte nicht sauber anschlagen
 | Kabelbinder | 3 × 100 mm | 100 Stück | Kabelbäume | 0 | 1 | 0 | 1 | Tayda (TH) | A-7409 | 0.49 | USD | 0.41
 | Lötzinn | 0,5-0,7 mm, mit Flussmittel | bleifrei |  | 0 | 0 | 0 | 0 | Conrad (CH) | nur falls nicht vorhanden | 15.00 | CHF | 0.00 | Menge 1 eintragen, falls keins da ist
 | Entlötlitze | 2 mm |  |  | 0 | 0 | 0 | 0 | Conrad (CH) | nur falls nicht vorhanden | 5.00 | CHF | 0.00 | Menge 1 eintragen, falls keine da ist
 |  |  |  |  |  |  |  |  |  |  |  | Summe | 8.56
