lukimcfly/MaturaProjekt/Bilder/Aufbau/arduino-oszilloskop-display.jpg

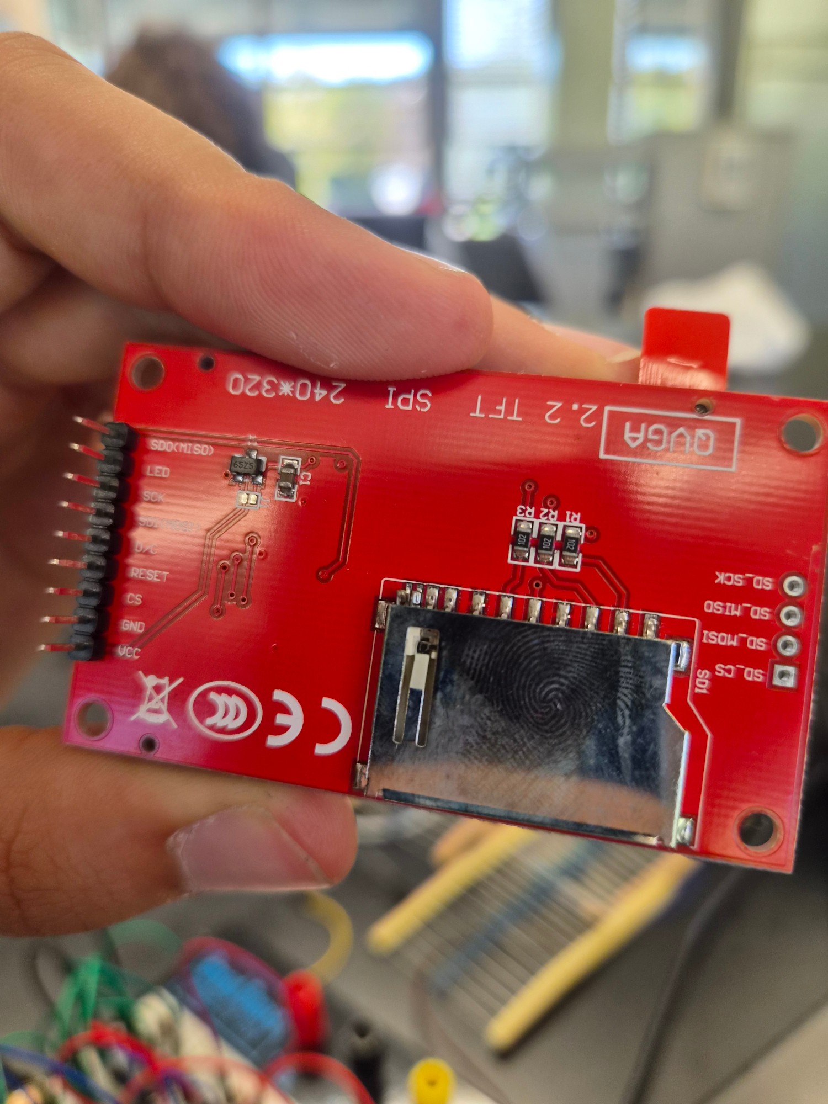
Bilder/Aufbau/arduino-oszilloskop-display.jpg
