lukimcfly/MaturaProjekt/Bilder/Aufbau/arduino-oszilloskop-saegezahn-2185hz.jpg

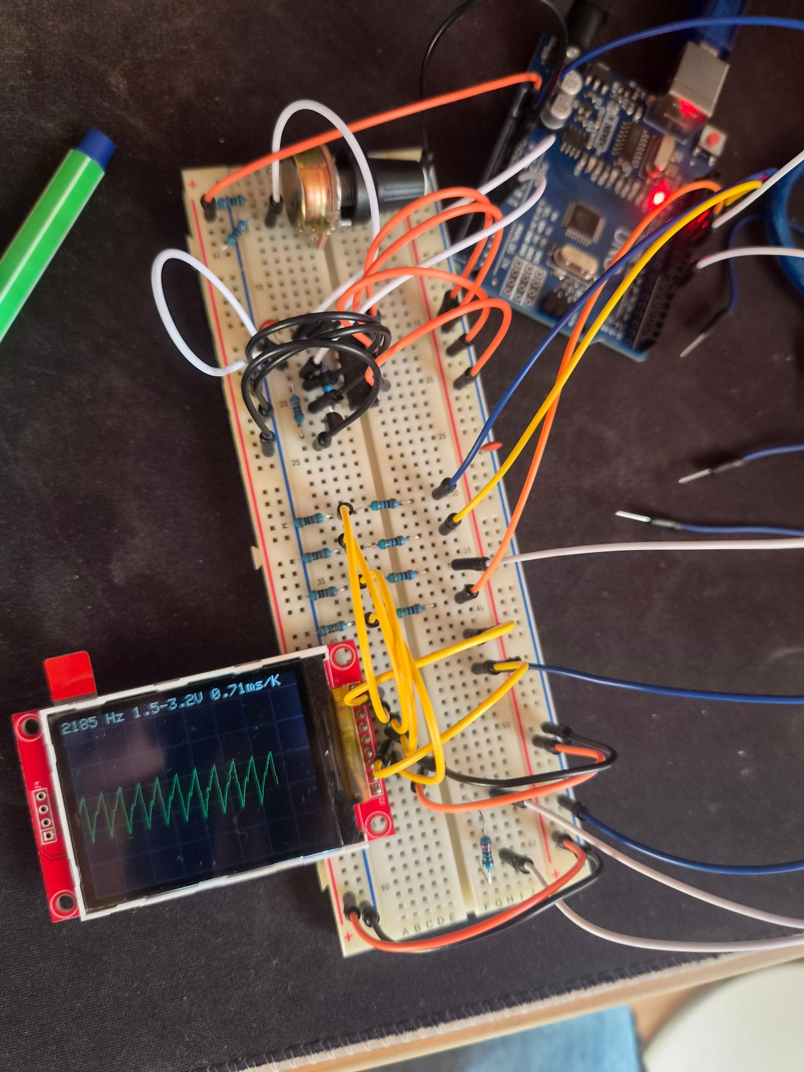
Bilder/Aufbau/arduino-oszilloskop-saegezahn-2185hz.jpg
