lukimcfly/MaturaProjekt/diary/2026-09-22.md

# 2026-09-22 (Di, KW 39)

**Beteiligt:** Timo (Auftrag), KI-Unterstützung (Umsetzung über Nacht)

> Ausführliche Fassung. Die Kurzfassung gehört ins laufende Logbuch
> (`Unsere-Materialien/Logbuch/Logbuch neu.docx`).

## Ziel des Tages

Die Einkaufsliste (CHF 850 für zwei Geräte – ohne Platinen, Versand und Zoll) so
günstig machen, wie es ohne Qualitätsverlust geht, und alle Bestellungen im Browser
so vorbereiten, dass Timo nur noch prüfen und bezahlen muss.

## Ergebnis

**Rund CHF 378 für beide Geräte, alles inbegriffen** (Platinen mit Bestückung,
Versand, MWST): CHF 189 pro Gerät. Vier Warenkörbe:

| Shop | Inhalt | Total |
|---|---|---|
| JLCPCB | Platinen, SMD-Chips bestückt (Login nötig, daher nur geschätzt) | ~CHF 91 |
| LCSC | original JST-Stecker, DC/DC-Wandler, LM386N-4, Sicherungen, SMD-Reserve | CHF 54 |
| Tayda | fast alle übrigen Bauteile und das ganze Bedienfeld | CHF 188 |
| Conrad | 2 Netzteile, 100 m Litze | CHF 45.60 |

## Was gemacht wurde

- **Lieferanten verglichen.** Tayda führt dieselben Hersteller wie Musikding
  (Alpha-Potis, Royal-Ohm-Widerstände), aber zu einem Drittel des Preises, und
  liefert per DHL mit bereits bezahlter MWST (DDP). LCSC hat original JST-Stecker für
  Centbeträge. JLCPCB bleibt der Platinenhersteller – er ist der günstigste, und die
  Platinen erfüllen seine Regeln schon.
- **Vierfach-Op-Amp TL074CDR statt OPA4196** auf Oszillator- und Filterplatine
  (U103, U401): gleiche Anschlussbelegung, gleiches Gehäuse. Filter-Simulation mit
  beiden Modellen: unter 0,1 dB Unterschied. Netzliste: genau 7 Wertänderungen, sonst
  nichts. Grund: JLCPCB muss bei 10 Platinen alle 10 bestücken, also 20 Chips à
  3,62 USD statt à 0,29 USD.
- **Lotpasten-Lage fehlte in den Gerber-Dateien.** Ohne sie kann JLCPCB keine
  Schablone für die Bestückung machen. `fabout.py` exportiert sie jetzt automatisch
  für Platinen mit SMD-Pads.
- **Neue Stromversorgung:** +12 V direkt vom Steckernetzteil, −12 V aus einem
  isolierten 2-W-Wandler (B1212S), dessen Plus-Ausgang an Masse liegt. Ersetzt den
  TRACO-Doppelwandler (CHF 25 → 1 USD) und gibt dem LM386 mehr Strom als vorher.
- **Fehler in der alten Einkaufsliste gefunden:** Sie empfahl für Tonhöhe und Cutoff
  logarithmische Potis (A). So wie die Potis verdrahtet sind (Schleifer + CW-Ende),
  wäre A **schlechter** als linear gewesen – richtig ist **C** (umgekehrt
  logarithmisch): halber Drehweg ≈ 440 Hz statt 54 Hz.
- **Warenkörbe gefüllt** bei Tayda, LCSC und Conrad; jede Menge stimmt mit der
  Excel-Liste überein (das Skript bricht ab, wenn nicht). Sicherungskopien der
  Warenkörbe als CSV in `Einkauf/`.

## Probleme und Lösungen

| Problem | Lösung |
|---|---|
| Im Browser lassen sich keine Dateien hochladen (Gerber für JLCPCB) | Dateien über `window.name` von einer lokalen Seite auf die JLCPCB-Seite gebracht; Prüfsumme verglichen – identisch |
| Tayda-Schnellbestellung nimmt nur 50 Zeilen | in zwei Teilen hinzugefügt; der zweite Teil kam doppelt in den Korb, Mengen danach korrigiert und nachgezählt (1270 Teile) |
| Filmkondensatoren bei Tayda teils dicker als der Footprint (3,5 statt 2,5 mm) | Abstand zu den Nachbarteilen auf der Platine nachgemessen: mindestens 1 mm Luft |
| JLCPCB zeigt den Bestückungspreis erst nach dem Login | geschätzt; Anleitung in `Einkauf/BESTELLEN.md` |

## Offen

- [ ] Bei JLCPCB einloggen und die drei Platinen in den Warenkorb legen
      (Pin-1-Ausrichtung in der Vorschau prüfen!).
- [ ] Bestellen, möglichst **bis 24.09.** – danach chinesische Feiertage.
- [ ] GitHub-Push des Zweigs `pcb-layout-rev4` (Anmeldung durch Timo).
