lukimcfly/MaturaProjekt/diary/2026-09-12.md

# 2026-09-12 (Sa, KW 37)

**Dauer:** ca. 8 h · **Beteiligt:** Timo (mit KI-Unterstützung)

> Ausführliche Fassung. Die Kurzfassung gehört ins laufende Logbuch
> (`Unsere-Materialien/Logbuch/Logbuch neu.docx`).

## Ziel des Tages
Vom fertigen Schaltplan zu **bestellbaren Leiterplatten** kommen: Bauteile
platzieren, Leiterbahnen routen, Fertigungsdaten erzeugen — und vorher
sicherstellen, dass am Schaltplan wirklich nichts mehr offen ist.

## Was gemacht wurde

- **Schaltplan auf Rev. 4 gebracht** und auf das KiCad-10-Format angehoben. Dabei
  vier echte Fehler gefunden (siehe `SynthesizerFinal/README.md`), darunter zwei
  Filter, die durch ein falsch platziertes Massesymbol **überhaupt nicht**
  funktioniert hätten.
- **Drei Platinen-Layouts erstellt** statt neun: die Oszillatoren sind
  untereinander identisch, die Filter ebenfalls. Oszillator 3×, Filter 4×,
  Hauptplatine 1×.
- **Platzierung berechnet statt gezeichnet.** Jedes Bauteil wird neben den
  IC-Pin gesetzt, den es bedient; die Koordinaten kommen aus den echten
  Pad-Positionen des Footprints. Damit können Schaltplan und Layout nicht mehr
  auseinanderlaufen.
- **Autorouter geschrieben und mehrfach überarbeitet** (A\* auf 0,25-mm-Raster,
  Kosten fürs Abbiegen, für Durchkontaktierungen und fürs Fahren auf der
  Rückseite; Aufreissen-und-neu-Routen, wenn ein Netz nicht durchkommt).
- **Fertigungsdaten erzeugt**: Gerber, Bohrdateien, Bohrpläne, Stücklisten,
  Bestückungspläne, 3D-Ansichten.
- **Verdrahtungstabelle** für das Bedienfeld erzeugt: 153 Drähte, einer pro
  Lötfahne, direkt aus der Netzliste abgeleitet statt aus dem Gedächtnis.

## Ergebnisse

- Hauptplatine und Filter-Platine: **DRC ohne Fehler, kein einziges Netz offen**,
  Massefläche in einem Stück.
- Der Schaltplan ist weiterhin ERC-sauber (0 Fehler, 0 Warnungen), jetzt in allen
  vier Dateien (Gesamtplan + drei Platinen-Teilpläne).
- Filter und Hauptplatine bleiben unter 100 × 100 mm und damit in der günstigen
  Preisstufe. Die Oszillator-Platine wurde bewusst auf 108 × 108 mm vergrössert
  (siehe unten).

## Probleme & Lösungen

- **Problem:** Der Stützkondensator des LM386 sass 41 mm von seinem
  Versorgungspin entfernt, das Zobel-Glied 32 bzw. 46 mm vom Ausgang. Das meldet
  keine Prüfregel, weil es keine Regelverletzung ist — aber ein LM386 mit so weit
  entfernter Abblockung schwingt gern, statt zu verstärken.
  → **Lösung:** Abstand zu jedem Versorgungspin systematisch gemessen statt
  angeschaut. Jetzt 4,7 mm bzw. 5,0 mm. Der ganze Ausgangsteil ist dafür nach
  rechts gewandert.

- **Problem:** Die Oszillator-Platine liess sich lange nicht vollständig routen —
  in einem Durchlauf blieben neun Netze offen. Sie ist mit 57 Bauteilen auf
  derselben Fläche rund ein Viertel dichter als die Hauptplatine.
  → **Lösung:** Die Ursache war nicht zu wenig Platz, sondern die
  **Stiftbelegung der beiden Bedienfeld-Stecker**. Deren Leitungen kreuzten sich
  in 61 Paaren, weil die Netze in einer anderen Reihenfolge auf den Stiften lagen
  als die Bauteile auf der Platine stehen. Welcher Draht auf welchen Stift geht,
  ist frei wählbar — das Bedienfeld wird ohnehin von Hand verdrahtet. Nach dem
  Umsortieren: **null Kreuzungen**, und von neun offenen Netzen blieben zwei.

- **Problem:** Beim Versuch, den Autorouter zu beschleunigen, wurde die
  Wegsuche „gieriger" eingestellt. Sie fand Wege schneller — aber schlechtere,
  und ein schlechter Weg blockiert das nächste Netz. Die Filter-Platine kippte
  dadurch von „komplett geroutet" auf „ein Netz offen".
  → **Lösung:** Zurückgenommen und stattdessen das Suchbudget vervierfacht.

- **Problem:** Ein Skript, das nur prüfen sollte, ob alle Werkzeuge noch
  fehlerfrei laden, hat dabei den **Gesamtschaltplan verändert** — einige der
  Skripte erledigen ihre Arbeit schon beim Importieren.
  → **Lösung:** Aus der Sicherung wiederhergestellt und nachgewiesen, dass die
  Netzliste danach Netz für Netz identisch ist. Warnung steht jetzt in
  `Werkzeuge/README.md`.

## Offen / nächste Schritte

- [x] Oszillator-Platine fertig routen (läuft noch; zuletzt zwei offene Netze von 45)
      → am [16.09.2026](2026-09-16.md) erledigt. Die Ursache war **nicht** zu
      wenig Platz, sondern zwei selbst gesetzte Sperrflächen.
- [ ] Gerber aller drei Platinen in einem Viewer durchsehen, bevor bestellt wird
- [ ] Platinen bestellen — Stückzahl beachten: Oszillator 3×, Filter 4×
- [ ] Bauteile bestellen (Stücklisten in `Platinen/Stuecklisten/`)
- [ ] Netzteil ±12 V aussuchen — bewusst **fertig gekauft**, nicht selbst gebaut
- [ ] Bedienfeld-Verdrahtung nach `Platinen/VERDRAHTUNG.md`
