lukimcfly/MaturaProjekt/diary/2026-09-16.md

# 2026-09-16 (Mi, KW 38)

**Dauer:** ca. 3 h · **Beteiligt:** Timo (mit KI-Unterstützung)

> Ausführliche Fassung. Die Kurzfassung gehört ins laufende Logbuch
> (`Unsere-Materialien/Logbuch/Logbuch neu.docx`).

## Ziel des Tages

Die letzten zwei offenen Netze der Oszillator-Platine schliessen, Fertigungsdaten
für alle drei Platinen vollständig machen und alles ins gemeinsame Git-Repository
legen, damit beide daran arbeiten können.

## Was gemacht wurde

- **Oszillator-Platine fertig geroutet.** Alle 45 Netze, kein einziges offen.
  Damit sind jetzt **alle drei Platinen** DRC-sauber und vollständig verdrahtet.
- **Fertigungsdaten der Oszillator-Platine erzeugt**: Gerber, Bohrdateien,
  Bohrpläne, Bestückungsplan, 3D-Ansichten von Ober- und Unterseite.
- **Stücklisten neu erzeugt** — dabei ein echter Bestellfehler gefunden (siehe
  unten).
- **Alles ins Git-Repository übertragen**, inklusive der Skripte.

## Ergebnisse

| Platine | Grösse | DRC | offene Netze | Massefläche |
|---|---|---|---|---|
| Oszillator | 108,1 × 108,1 mm | sauber | 0 | 10 444 mm², **ein Stück** |
| Filter | 80,1 × 68,1 mm | sauber | 0 | 4 969 mm², ein Stück |
| Hauptplatine | 96,1 × 98,1 mm | sauber | 0 | 8 673 mm², ein Stück |

Der Gesamtschaltplan ist weiterhin **ERC-sauber: 0 Fehler, 0 Warnungen**.

## Probleme & Lösungen

- **Problem:** Die beiden letzten Netze der Oszillator-Platine (`O1_AINV` und
  `O1_WSEL`) liessen sich über Tage nicht routen — auch nicht mit grösserer
  Platine, anderer Reihenfolge, kleineren Abständen oder vervierfachtem
  Suchbudget.
  → **Lösung:** Die Ursache waren **zwei selbst gesetzte Sperrflächen**, nicht
  Platzmangel: „keine Rückseiten-Leiterbahn unter einem IC" und „keine zwischen
  den Stiften eines Steckers". Beide Regeln sind sinnvoll, aber es sind
  *eigene* Regeln, keine Fertigungsvorgaben. Für genau diese zwei Netze
  aufgehoben — und beide waren in **drei Sekunden** geroutet. Tagelang war die
  Diagnose falsch.

- **Problem:** Eine aufgehobene Sperrfläche ist nur dann in Ordnung, wenn man
  weiss, was sie kostet. Einfach behaupten „ist schon nicht schlimm" reicht
  nicht.
  → **Lösung:** Nachgemessen statt geschätzt. Die Massefläche verliert
  **73 mm² von 10 517 mm², also 0,69 %**, und bleibt **ein einziges
  zusammenhängendes Stück** — keine abgetrennten Inseln. Zusätzlich die
  Gegenprobe gemacht: mit der IC-Sperrfläche scheitert `O1_AINV` auch nach
  **444 Sekunden** Suche. Der Schlitz ist also nicht Bequemlichkeit, sondern
  tatsächlich nötig.

- **Problem:** Die Stückliste der Oszillator-Platine führte `U102` noch im
  Gehäuse **SOT-363**, obwohl der Schaltplan längst auf **SOT-23-6** geändert
  worden war. Die Stückliste war vor der Änderung erzeugt worden und danach nie
  wieder. Das wäre ein **falsch bestelltes Bauteil** gewesen — dreimal, denn die
  Platine wird dreimal bestückt.
  → **Lösung:** Alle vier Stücklisten neu aus den Schaltplänen erzeugt und
  gegengeprüft. Ausserdem ein Abgleich Schaltplan ↔ Platine über alle drei
  Layouts: **kein einziges abweichendes Gehäuse**.

## Offen / nächste Schritte

- [ ] Prüfen, ob die Oszillator-Platine doch unter 100 × 100 mm passt. Sie war
      vergrössert worden, weil Platzmangel als Ursache vermutet wurde — das war
      falsch. Die kleinere Platine wäre deutlich günstiger, und sie wird **3×**
      gebraucht.
- [ ] Gerber aller drei Platinen in einem Viewer durchsehen, bevor bestellt wird
- [ ] Platinen bestellen — Stückzahl beachten: Oszillator 3×, Filter 4×
- [ ] Bauteile bestellen (Stücklisten in `Platinen/Stuecklisten/`)
- [ ] Netzteil ±12 V aussuchen — bewusst **fertig gekauft**, nicht selbst gebaut
- [ ] Bedienfeld-Verdrahtung nach `Platinen/VERDRAHTUNG.md`
