lukimcfly/MaturaProjekt/diary/2026-08-12.md

# 2026-08-12 (Mi, KW 33)

**Dauer:** ca. 0,5 h Planung + ca. 2–4 h Theorie · **Beteiligt:** beide Projektmitglieder

## Ziel des Tages
Nach den Sommerferien wieder in einen geregelten Arbeitsrhythmus finden: einen
verbindlichen Zeitplan für die verbleibenden Wochen bis zu den Herbstferien
aufstellen und die Projektdokumentation (Arbeitstagebuch) wieder aufnehmen.

## Was gemacht wurde
- Projektumfang für das physische Produkt festgelegt: ein **analoger Synthesizer**
  mit 3 Oszillatoren, Mixer, Amplifier und Distortion. Der Umfang ist bewusst
  noch nicht endgültig — je nach Zeitbedarf kann sich die Modulliste ändern.
- Restliche Projektbestandteile abgegrenzt: **Fourier-Analyse** von analogem und
  digitalem Ton sowie die schriftlichen Dokumente, die zur Matura abzugeben sind.
- **Zeitplan von KW 33 bis KW 39** (bis zu den Herbstferien) erstellt, mit
  Stundenbudget pro Woche und dem Ziel, das physische Produkt bis zu den
  Herbstferien fertigzustellen. Der Plan sieht die Reihenfolge
  Theorie → Systemkomponenten recherchieren und skizzieren → KiCad-Schaltplan →
  Aufbau auf Breadboards → PCB-Entwurf vor, mit KW 39 als Pufferwoche.
- Als Arbeitsregel festgehalten: **Der Arbeitsprozess wird immer direkt nach dem
  Arbeiten dokumentiert**, nicht nachträglich aus dem Gedächtnis.
- Arbeitstagebuch als Ordnerstruktur aufgesetzt (eine Datei pro Arbeitstag) und
  den handschriftlichen Zeitplan in eine durchsuchbare Textfassung übertragen.

### Theorie (KW-33-Aufgabe „Theorie verfestigen") — ca. 2–4 h in zwei Blöcken
Durcharbeiten von Elektronik-Lernvideos, überwiegend aus der Playlist von
*The Organic Chemistry Tutor*. Wir gehen die Playlist nicht der Reihe nach durch,
sondern greifen gezielt die Themen heraus, die für die einzelnen Baugruppen des
Synthesizers gebraucht werden.

**Block 1 — Grundlagen und RC-Verhalten (ca. 1–2 h)**
- *Basic Electronics For Beginners* — Wiederholung der Grundgrößen
  (Spannung, Strom, Widerstand) und der passiven Bauteile
- *How Do Capacitors Work?* — Funktionsweise und Kapazität von Kondensatoren
- *RC Circuits Physics Problems, Time Constant Explained* — RC-Glieder,
  Zeitkonstante τ = R · C, Lade- und Entladekurven

**Block 2 — Filter, Transistoren, Verstärker (ca. 1–2 h)**
- *AC vs DC* — Unterschied Gleich-/Wechselspannung
- *Low Pass Filters and High Pass Filters — RC and RL Circuits* — Tief- und
  Hochpass, Grenzfrequenz f_g = 1/(2πRC)
- *Transistors Explained* (The Engineering Mindset) — Aufbau und
  Funktionsprinzip von Transistoren
- *Transistor Amplifiers — Class A, AB, B, & C Circuits* — Verstärkerklassen,
  Arbeitspunkt und die dabei entstehenden Verzerrungen

**Bezug zum Produkt:** Damit sind zwei der geplanten Baugruppen theoretisch
abgedeckt. Die RC-Theorie und die Filterschaltungen sind die Grundlage für die
Filterstufe und für die zeitbestimmenden Glieder der Oszillatoren; die
Verstärkerklassen liefern direkt die Theorie für den Amplifier — und über das
Thema Übersteuerung/Clipping auch einen ersten Zugang zur Distortion-Stufe.

### Schaltungsentwurf
Ein erster Schaltungsausschnitt in KiCad liegt vor: eine **Oszillatorstufe** rund
um einen Schmitt-Trigger-Buffer **74LVC2G17** mit RC-Zeitglied (C4 plus
Ladewiderstand) und einem NPN-Transistor Q4, dessen Basis über RB = 270 Ω vom
Schmitt-Trigger-Ausgang angesteuert wird.

Damit ist der Sprung von der Theorie in die Praxis gemacht: Das RC-Verhalten und
die Zeitkonstante τ = R·C aus den Lernvideos stecken hier direkt in der
frequenzbestimmenden Baugruppe. Der Kondensator lädt sich auf, bis die obere
Schaltschwelle erreicht ist, kippt den Ausgang, entlädt sich bis zur unteren
Schwelle und kippt zurück — ein selbstschwingender Relaxationsoszillator.

Bild und Bauteilliste: [Bilder/README.md](../Bilder/README.md)

## Ergebnisse
- Zeitplan bis zu den Herbstferien: [plan/zeitplan-bis-herbstferien.md](../plan/zeitplan-bis-herbstferien.md)
- Verplantes Gesamtbudget: ca. 67 h über sieben Wochen
- Tagebuchstruktur unter `diary/` mit Vorlage und Index
- Quellensammlung angelegt: [quellen/lernmaterial.md](../quellen/lernmaterial.md)
- Erster KiCad-Schaltplanausschnitt der Oszillatorstufe (Schmitt-Trigger-Oszillator)

## Probleme & Lösungen
- **Problem:** Die Dokumentation war über die Sommerferien liegen geblieben.
  → **Lösung:** Fester Dokumentationsablauf eingeführt (Notieren direkt im
  Anschluss an jede Arbeitseinheit), damit keine weiteren Lücken entstehen.
- **Problem:** Der ursprüngliche Ansatz von 10 h "Theorie verfestigen" in KW 34
  war zu hoch angesetzt.
  → **Lösung:** Auf 6 h reduziert, die freie Zeit auf Produktskizze und
  Komponentenrecherche verteilt.
- **Problem:** KW 38 war zunächst als Pufferwoche vorgesehen, wird aber für den
  PCB-Entwurf gebraucht.
  → **Lösung:** Puffer auf KW 39 verschoben; KW 38 fest für PCB-Entwurf,
  Bestellung und Teilebeschaffung eingeplant.

## Offen / nächste Schritte
- [ ] KW 33: Theorie verfestigen (7 h) — davon ca. 2–4 h erledigt
- [ ] Theorie-Lücken laut Zuordnungstabelle schließen: aktive Filter,
      Oszillatorschaltungen/Schwingbedingung, Operationsverstärker für den Mixer
- [ ] KW 33: **Teile bestellen — als besonders dringend markiert**, da alle
      praktischen Arbeitsschritte ab KW 35 vom Eintreffen der Bauteile abhängen
- [ ] Rolle von Q4 mit RHigh/RLow in der Oszillatorstufe dokumentieren
- [ ] Abgabetermin im Blick behalten: **10. November 2026**
