lukimcfly/MaturaProjekt/diary/README.md

# Projekttagebuch

Chronologische Dokumentation der Arbeit am Maturaprojekt.
Eine Datei pro Arbeitstag: `diary/JJJJ-MM-TT.md`

> **Ab 19.08.2026:** Das laufende Logbuch wird direkt in
> `Unsere-Materialien/Logbuch/Logbuch neu.docx` weitergeführt.
> Dieser Ordner bleibt als Detailablage bestehen (ausführliche Notizen,
> Quellen, Begründungen), die kurze Fassung steht im Word-Dokument.

## Einträge

<!-- Neueste zuletzt. Format: - [JJJJ-MM-TT](JJJJ-MM-TT.md) — Kurzbeschreibung -->

- [2026-08-12](2026-08-12.md) — Projektumfang festgelegt, Zeitplan bis zu den Herbstferien erstellt, Dokumentation wieder aufgenommen, Theorie: Grundlagen & RC-Glieder
- [2026-09-12](2026-09-12.md) — Platinen-Layout: drei Leiterplatten aus dem Schaltplan abgeleitet, geroutet und Fertigungsdaten erzeugt
- [2026-09-16](2026-09-16.md) — Oszillator-Platine fertig geroutet, alle drei Platinen DRC-sauber, Fertigungsdaten und Skripte ins Repository übertragen
