lukimcfly/MaturaProjekt/diary/_vorlage.md

# JJJJ-MM-TT

**Dauer:** ca. X h · **Beteiligt:** …

## Ziel des Tages
…

## Was gemacht wurde
- …

## Ergebnisse
- …

## Probleme & Lösungen
- **Problem:** … → **Lösung:** …

## Offen / nächste Schritte
- [ ] …
