lukimcfly/MaturaProjekt/SynthesizerFinal/SynthesizerFinal.pdf

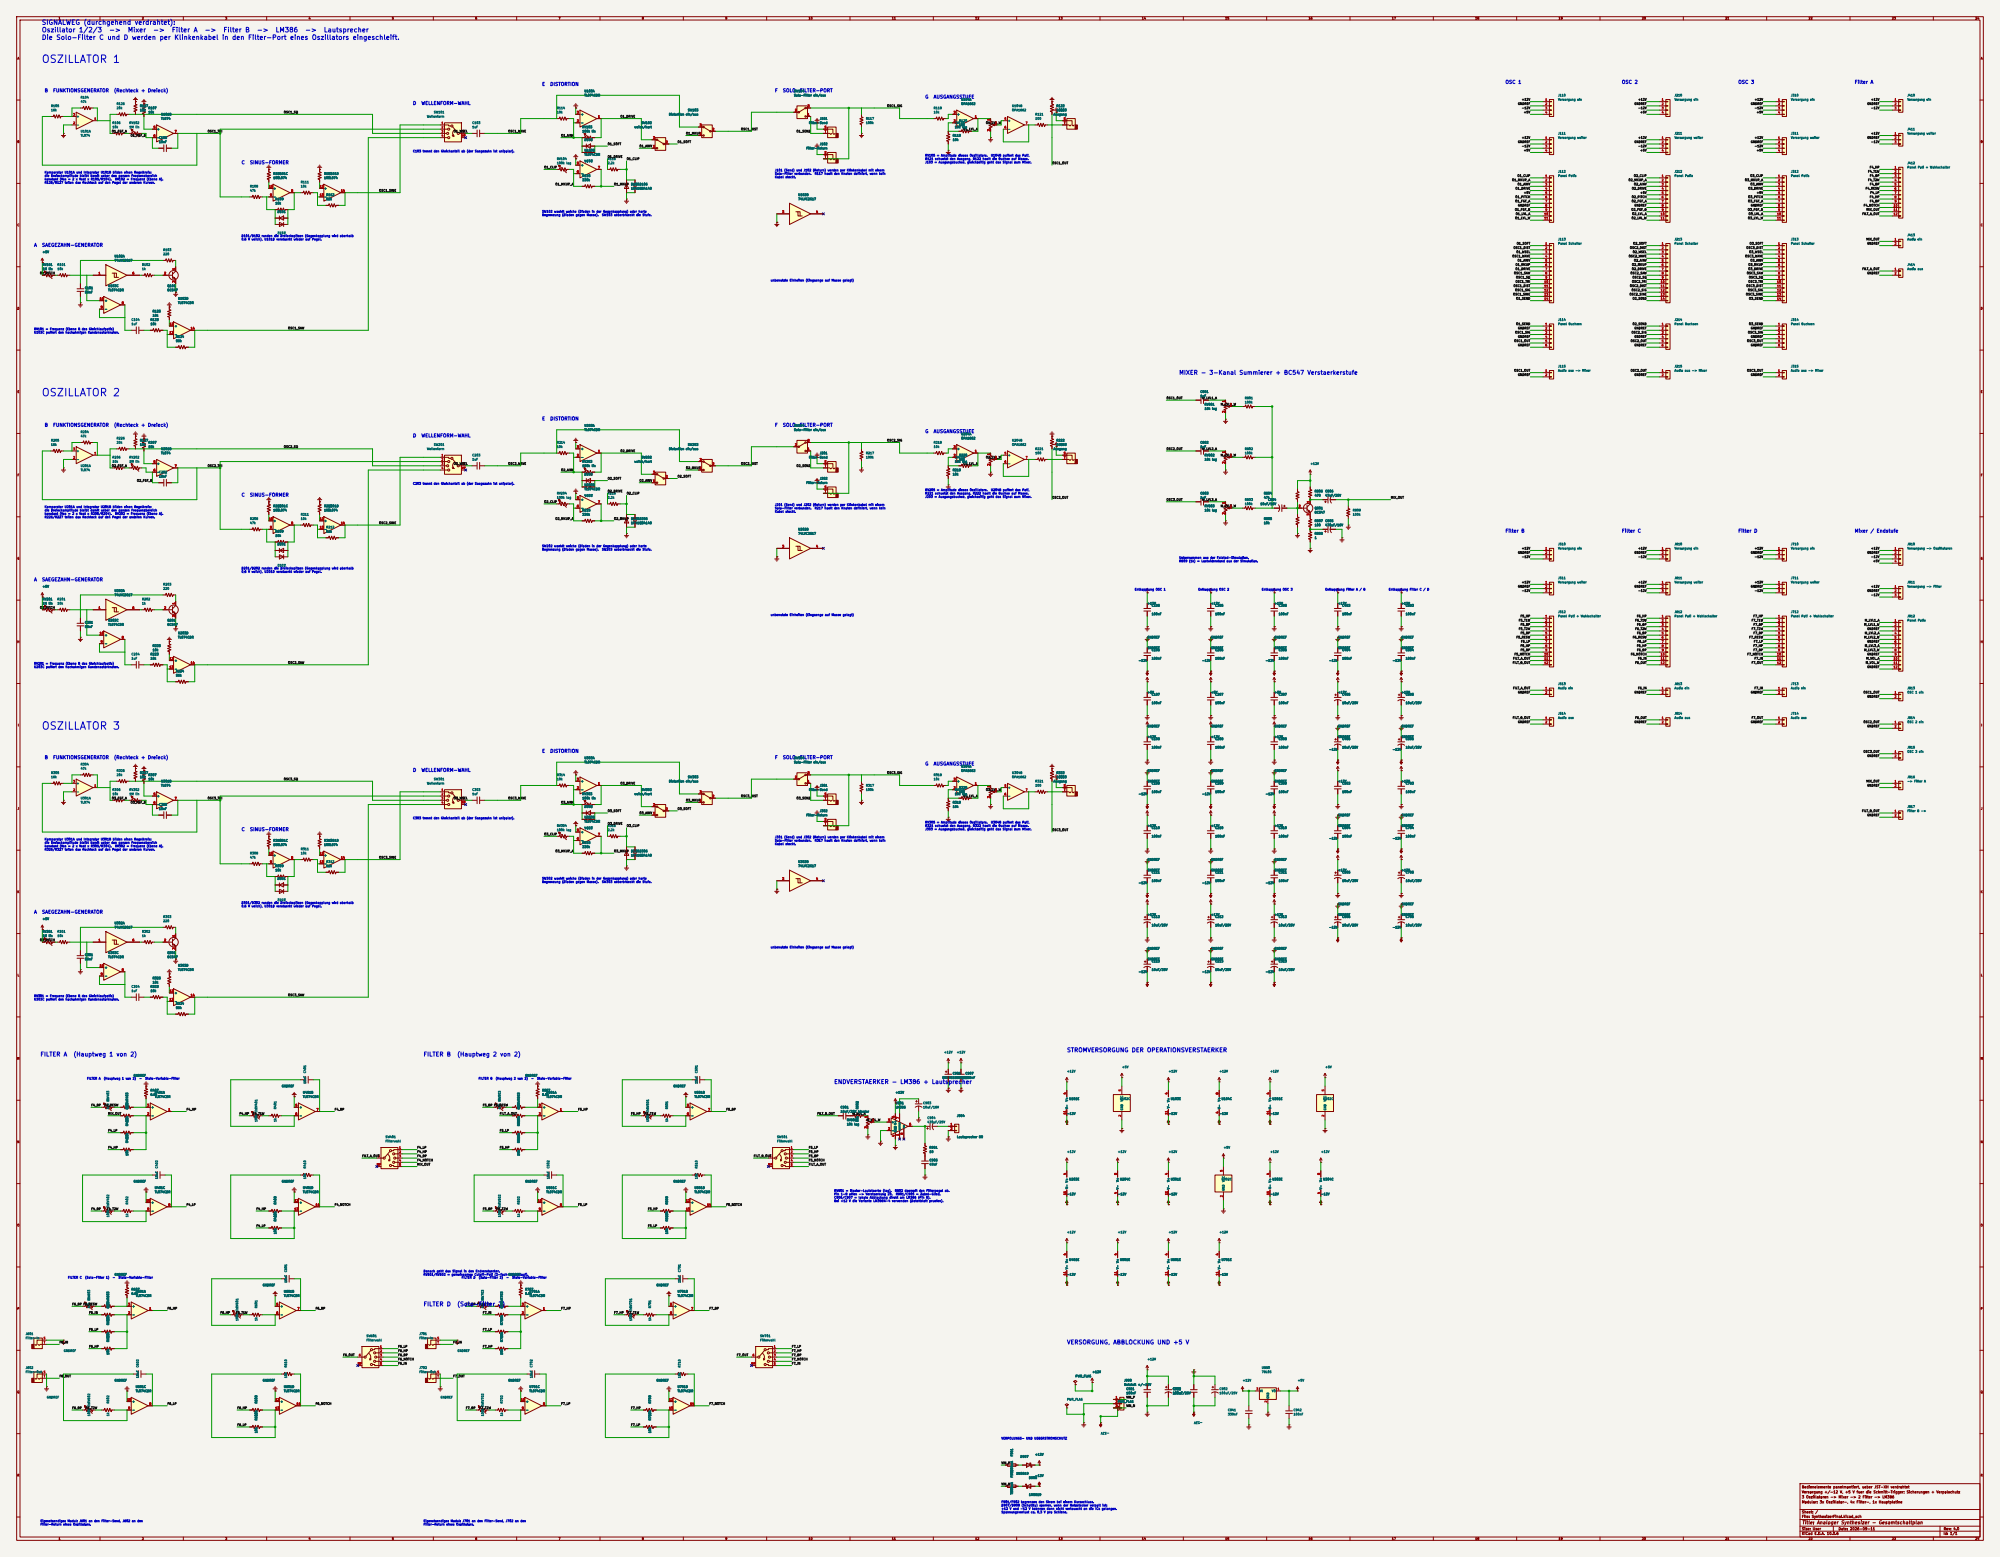
[picture p40: page 1]

SIGNALWEG (durchgehend verdrahtet):
Oszillator 1/2/3 -> Mixer -> Filter A -> Filter B -> LM386 -> Lautsprecher
Die Solo-Filter C und D werden per Klinkenkabel in den Filter-Port eines Oszillators eingeschleift.

F SOLO-FILTER-PORT
Solo-Filter ein/aus

Solo-Filter ein/aus 1

C103 trennt den Gleichanteil ab (der Saegezahn ist unipolar).

Komparator U101A und Integrator U101B bilden einen Regelkreis: die Dreieckamplitude bleibt damit ueber den ganzen Frequenzbereich

J101 (Send) und J102 (Return) werden per Klinkenkabel mit einem

D101/D102 runden die Dreieckspitzen (Gegenkopplung wird oberhalb 0,6 V weich), U101D verstaerkt wieder auf Pegel.

unbenutzte Einheiten (Eingaenge auf Masse gelegt)

Audio aus -> Mixer RV501 100k lin

Solo-Filter ein/ausS

C203 trennt den Gleichanteil ab (der Saegezahn ist unipolar).

Komparator U201A und Integrator U201B bilden einen Regelkreis: die Dreieckamplitude bleibt damit ueber den ganzen Frequenzbereich

J201 (Send) und J202 (Return) werden per Klinkenkabel mit einem

R226/R227 teilen das Rechteck auf den Pegel der anderen Kurven.

D201/D202 runden die Dreieckspitzen (Gegenkopplung wird oberhalb 0,6 V weich), U201D verstaerkt wieder auf Pegel.

RV201 = Frequenz (Ebene B des Gleichlaufpotis) U203C puffert den hochohmigen Kondensatorknoten.

C303 trennt den Gleichanteil ab (der Saegezahn ist unipolar).

Komparator U301A und Integrator U301B bilden einen Regelkreis: die Dreieckamplitude bleibt damit ueber den ganzen Frequenzbereich

unbenutzte Einheiten (Eingaenge auf Masse gelegt) J301 (Send) und J302 (Return) werden per Klinkenkabel mit einem

R326/R327 teilen das Rechteck auf den Pegel der anderen Kurven.

D301/D302 runden die Dreieckspitzen (Gegenkopplung wird oberhalb 0,6 V weich), U301D verstaerkt wieder auf Pegel.

RV301 = Frequenz (Ebene B des Gleichlaufpotis) U303C puffert den hochohmigen Kondensatorknoten. FILTER A (Hauptweg 1 von 2)

Danach geht das Signal in den Endverstaerker. RV501/RV502 = gemeinsames Cutoff-Poti (2-fach-Gleichlauf).

Bedienelemente panelmontiert, ueber JST-XH verdrahtet
Versorgung +/-12 V, +5 V fuer die Schmitt-Trigger; Sicherungen + Verpolschutz
3 Oszillatoren -> Mixer -> 2 Filter -> LM386
Modular: 3x Oszillator-, 4x Filter-, 1x Hauptplatine

F901/F902 begrenzen den Strom bei einem Kurzschluss. D907/D908 (Schottky) sperren, wenn der Netzstecker verpolt ist: +12 V und -12 V koennen dann nicht vertauscht an die ICs gelangen.

Spannungsverlust ca. 0,3 V pro Schiene.

Sheet: /
File: SynthesizerFinal.kicad_sch
Title: Analoger Synthesizer - Gesamtschaltplan

Eigenstaendiges Modul: J601 an den Filter-Send, J602 an den
Filter-Return eines Oszillators.

Eigenstaendiges Modul: J701 an den Filter-Send, J702 an den

Size: User | Rev: 4.0
KiCad E.D.A. 10.0.6 | Id: 1/1
