lukimcfly/MaturaProjekt/Platinen/Hauptplatine/main-bestueckung.pdf

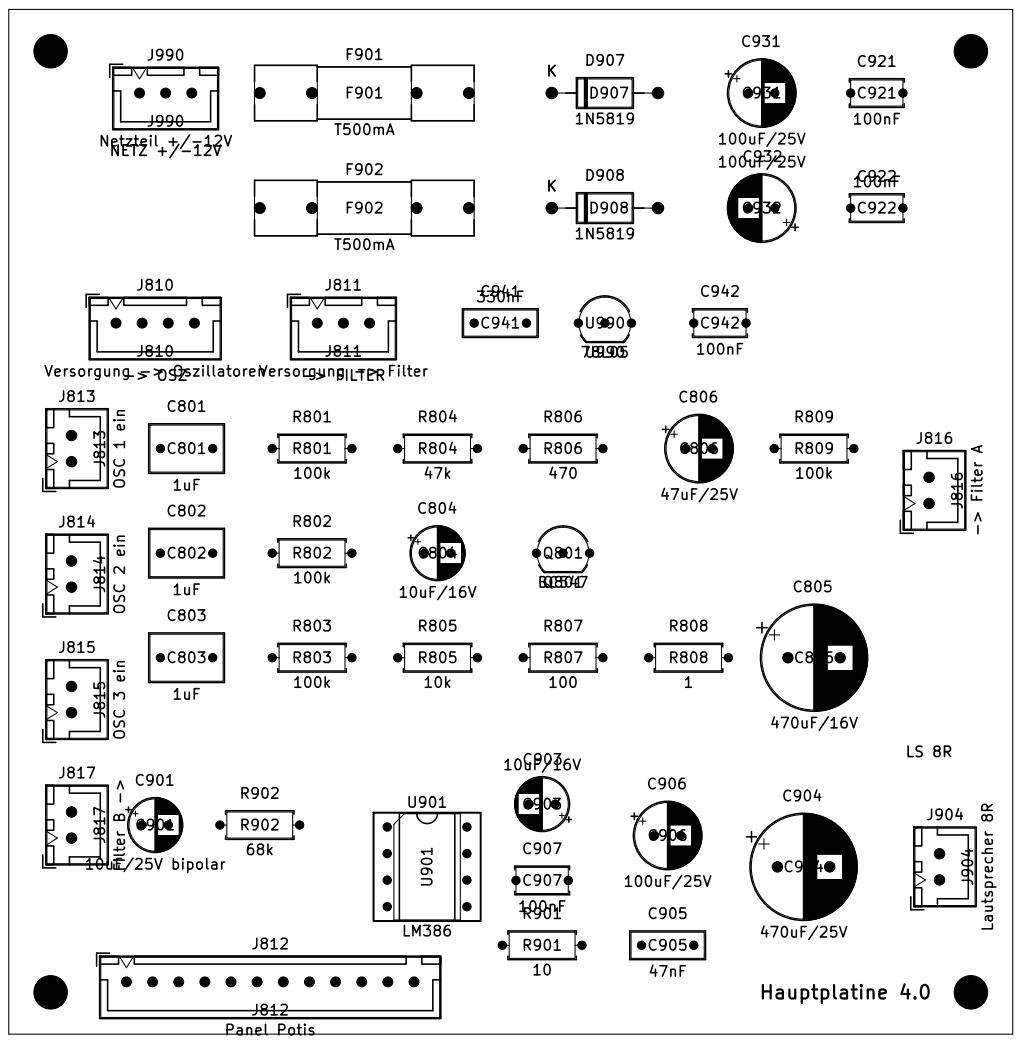
[picture p41: page 1]

Size: A4 | Rev:
KiCad E.D.A. 10.0.6 | Id: 1/1
