lukimcfly/MaturaProjekt/Platinen/Filter/filter-bestueckung.pdf

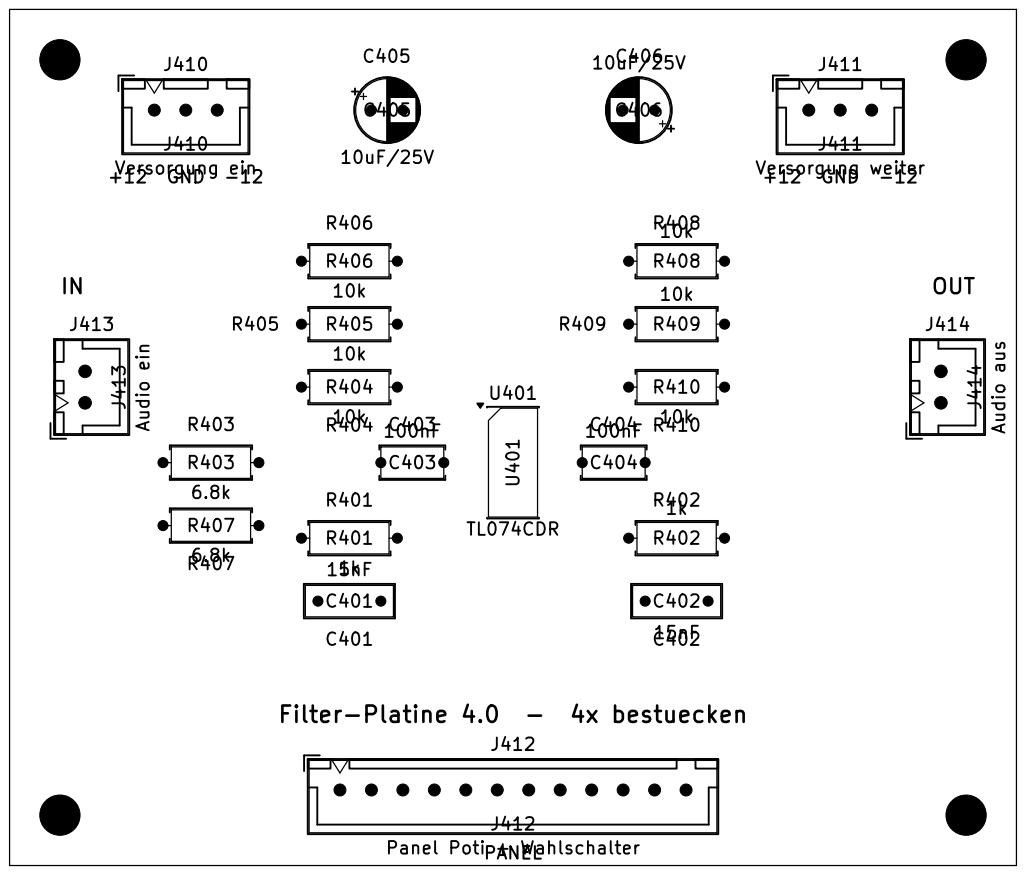
[picture p42: page 1]
