lukimcfly/MaturaProjekt/Platinen/Oszillator/osc-bestueckung.pdf

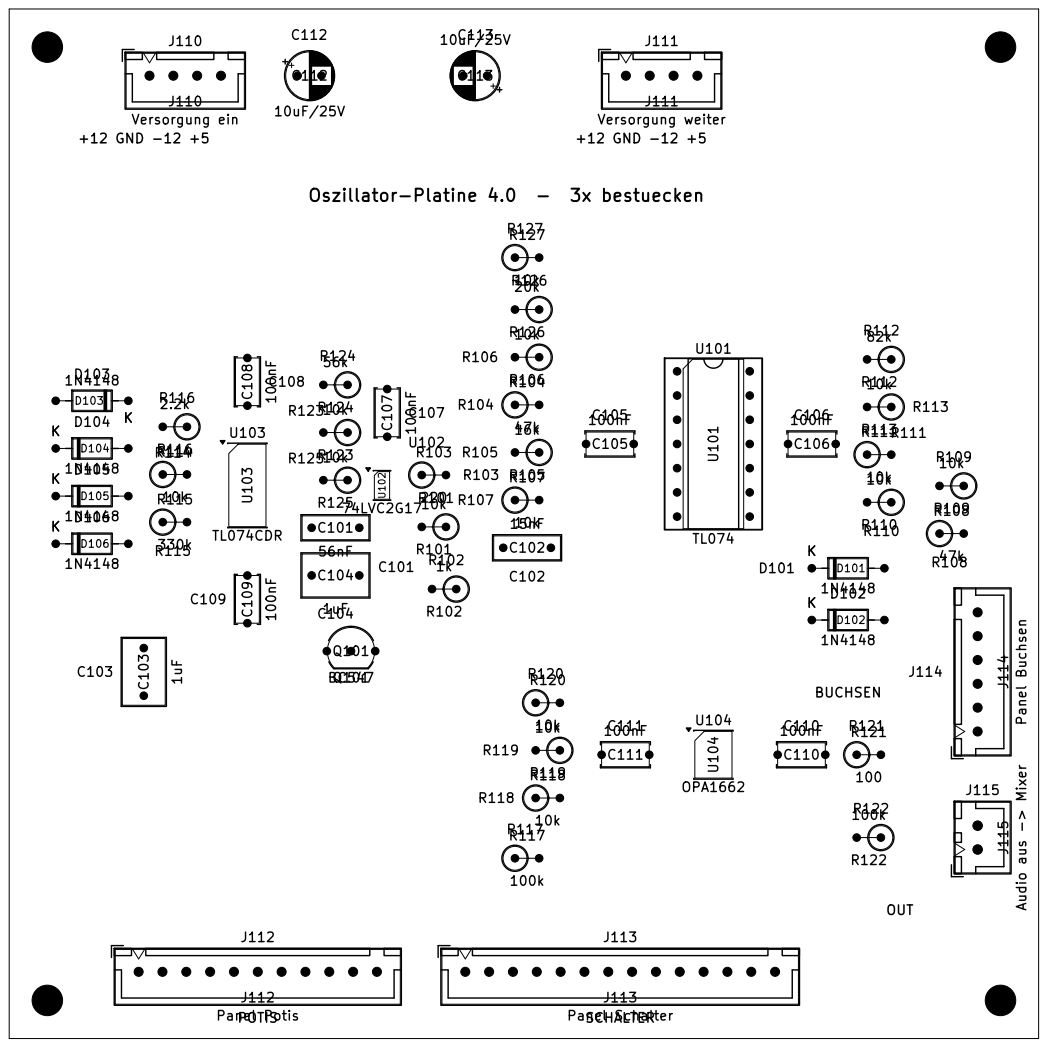
[picture p43: page 1]

OUT Oszillator-Platine 4.0 - 3x bestuecken
