lukimcfly/MaturaProjekt/Platinen/Oszillator/osc.kicad_pcb

## KiCad design Platinen/Oszillator/osc.kicad_pcb (2026-09-22)

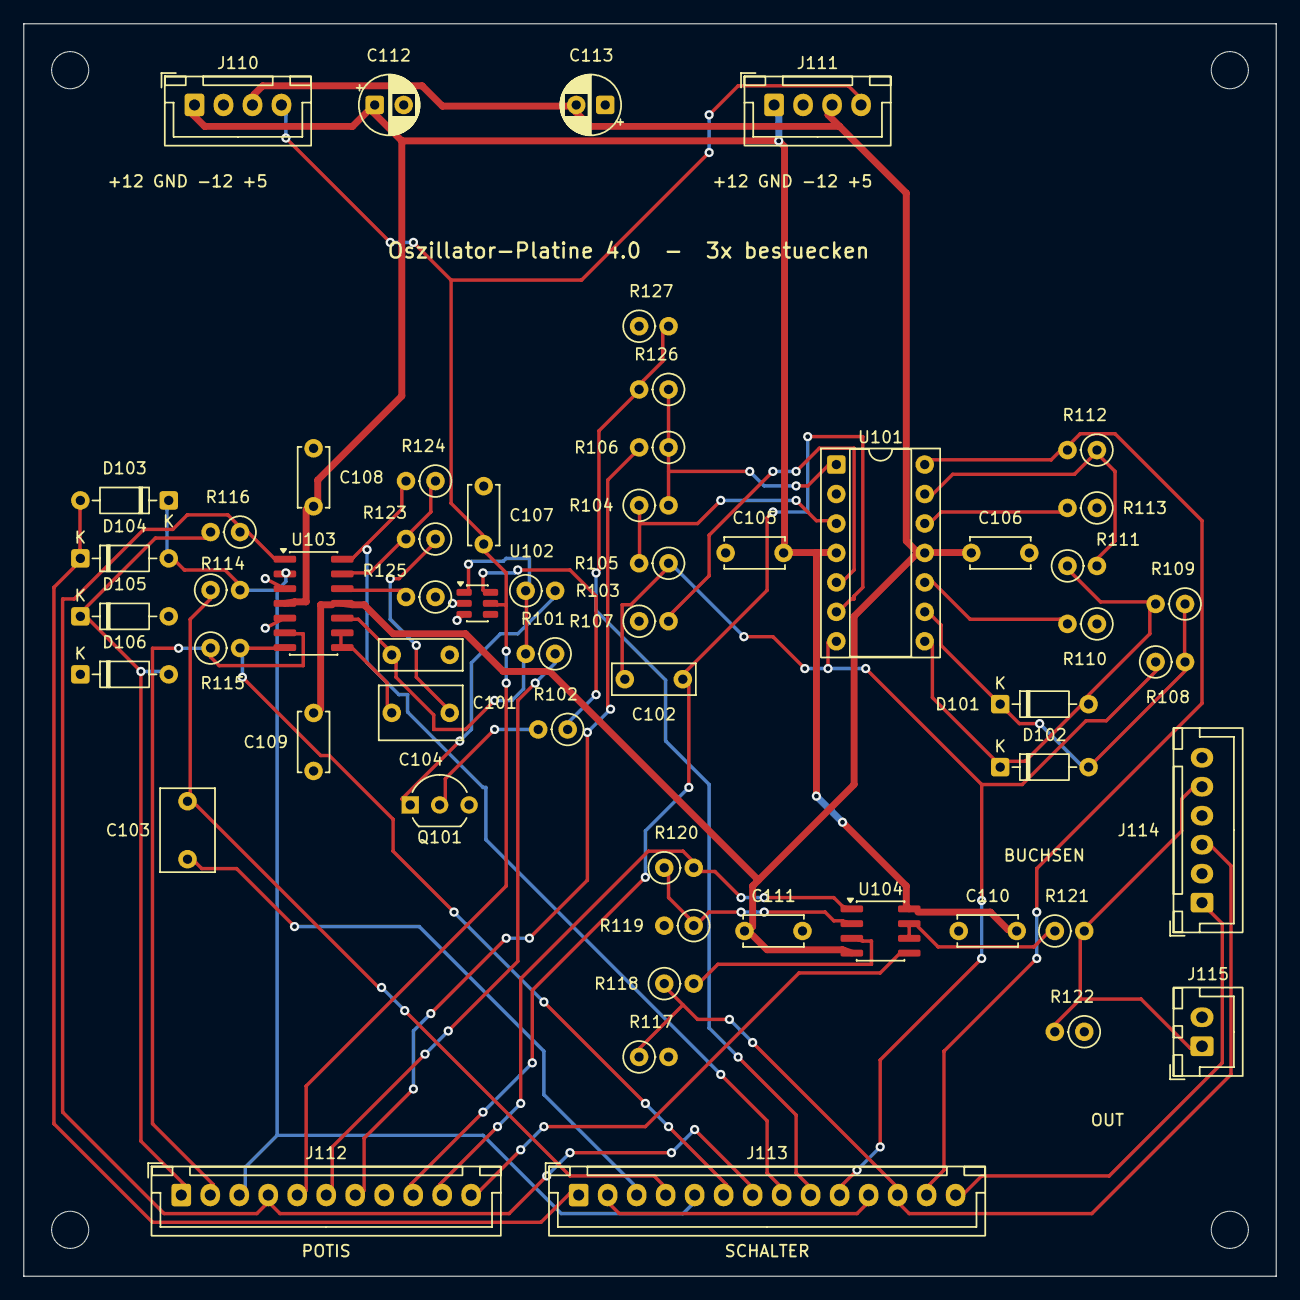
[picture p44: board osc.kicad_pcb from above]

Board: 2 copper layers, 108.0 x 108.0 mm, 61 parts (0 on the bottom side), 44 nets.

Parts:
C101: 56nF; C_Rect_L7.0mm_W2.5mm_P5.00mm
C102: 15nF; C_Rect_L7.0mm_W2.5mm_P5.00mm
C103, C104: 1uF; C_Rect_L7.0mm_W4.5mm_P5.00mm
C105, C106, C107, C108, C109, C110, C111: 100nF; C_Disc_D5.0mm_W2.5mm_P5.00mm
C112, C113: 10uF/25V; CP_Radial_D5.0mm_P2.50mm
D101, D102, D103, D104, D105, D106: 1N4148; D_DO-35_SOD27_P7.62mm_Horizontal
H1, H2, H3, H4: MountingHole_3.2mm_M3
J110: Versorgung ein; JST_XH_B4B-XH-A_1x04_P2.50mm_Vertical
J111: Versorgung weiter; JST_XH_B4B-XH-A_1x04_P2.50mm_Vertical
J112: Panel Potis; JST_XH_B11B-XH-A_1x11_P2.50mm_Vertical
J113: Panel Schalter; JST_XH_B14B-XH-A_1x14_P2.50mm_Vertical
J114: Panel Buchsen; JST_XH_B6B-XH-A_1x06_P2.50mm_Vertical
J115: Audio aus -> Mixer; JST_XH_B2B-XH-A_1x02_P2.50mm_Vertical
Q101: BC547; TO-92_Inline_Wide
R101, R106, R107, R109, R110, R111, R113, R114, R118, R119, R120, R123, R125, R127: 10k; R_Axial_DIN0207_L6.3mm_D2.5mm_P2.54mm_Vertical
R102: 1k; R_Axial_DIN0207_L6.3mm_D2.5mm_P2.54mm_Vertical
R103: 220; R_Axial_DIN0207_L6.3mm_D2.5mm_P2.54mm_Vertical
R104, R108: 47k; R_Axial_DIN0207_L6.3mm_D2.5mm_P2.54mm_Vertical
R105: 16k; R_Axial_DIN0207_L6.3mm_D2.5mm_P2.54mm_Vertical
R112: 82k; R_Axial_DIN0207_L6.3mm_D2.5mm_P2.54mm_Vertical
R115: 330k; R_Axial_DIN0207_L6.3mm_D2.5mm_P2.54mm_Vertical
R116: 2.2k; R_Axial_DIN0207_L6.3mm_D2.5mm_P2.54mm_Vertical
R117, R122: 100k; R_Axial_DIN0207_L6.3mm_D2.5mm_P2.54mm_Vertical
R121: 100; R_Axial_DIN0207_L6.3mm_D2.5mm_P2.54mm_Vertical
R124: 56k; R_Axial_DIN0207_L6.3mm_D2.5mm_P2.54mm_Vertical
R126: 20k; R_Axial_DIN0207_L6.3mm_D2.5mm_P2.54mm_Vertical
U101: TL074; DIP-14_W7.62mm_Socket
U102: 74LVC2G17; SOT-23-6
U103: TL074CDR; SOIC-14_3.9x8.7mm_P1.27mm
U104: OPA1662; SOIC-8_3.9x4.9mm_P1.27mm

Connections:
+5V: C107.1, J110.4, J111.4, J112.5, U102.5
+12V: C105.1, C108.1, C110.1, C112.1, J110.1, J111.1, U101.4, U103.4, U104.8
-12V: C106.2, C109.2, C111.2, C113.2, J110.3, J111.3, U101.11, U103.11, U104.4
/O1_AINV: D103.1, D104.2, J112.3, J113.5, R114.2, U103.2
/O1_CLIP: D105.1, D106.2, J112.1, R116.2
/O1_DRIVE: J112.4, J113.7, R116.1, U103.1
/O1_FGF_A: J112.7, R106.2
/O1_FGF_B: C102.1, J112.9, U101.6
/O1_LVL_A: J112.10, R120.2, U104.1
/O1_LVL_W: J112.11, U104.5
/O1_MKUP: J113.6, R115.2, U103.7
/O1_MKUP_A: J112.2, R115.1, U103.6
/O1_PITCH: J112.6, R101.1
/O1_SEND: J113.14, J114.1
/O1_SOFT: D103.2, D104.1, J113.1
/O1_WSEL: C103.1, J113.3
/OSC1_DIST: J113.2, J113.11
/OSC1_OUT: J114.5, J115.1, R121.2, R122.2
/OSC1_SAW: J113.8, R124.2, U103.14
/OSC1_SIG: J113.12, J114.3, R117.1, R118.1
/OSC1_SINE: J113.13, R112.2, U101.14
/OSC1_SQ: J113.9, R126.2, R127.2
/OSC1_TRI: C102.2, J113.10, R105.1, R108.1, U101.7
/OSC1_WAVE: C103.2, J113.4, R114.1
GNDREF: C101.2, C105.2, C106.1, C107.2, C108.2, C109.1, C110.2, C111.1, C112.2, C113.1, D105.2, D106.1, J110.2, J111.2, J112.8, J114.2, J114.4, J114.6, J115.2, Q101.3, R107.1, R110.1, R113.1, R117.2, R119.2, R122.1, R125.1, R127.1, U101.2, U102.2, U102.3, U103.3, U103.5
unnamed: C104.2, R123.1
unnamed: D101.2, D102.1, R109.2, R111.1, U101.8
unnamed: D101.1, D102.2, R108.2, R109.1, U101.9
unnamed: Q101.2, R102.2
unnamed: Q101.1, R103.2
unnamed: R102.1, U102.6
unnamed: R104.2, R106.1, R126.1, U101.1
unnamed: R104.1, R105.2, U101.3
unnamed: R107.2, U101.5
unnamed: R110.2, U101.10
unnamed: R113.2, U101.12
unnamed: R111.2, R112.1, U101.13
unnamed: C101.1, R101.2, R103.1, U102.1, U103.10
unnamed: C104.1, U103.8, U103.9
unnamed: R125.2, U103.12
unnamed: R123.2, R124.1, U103.13
unnamed: R118.2, U104.3
unnamed: R119.1, R120.1, U104.2
unnamed: R121.1, U104.6, U104.7
