lukimcfly/MaturaProjekt/Platinen/Filter/filter.kicad_pcb

## KiCad design Platinen/Filter/filter.kicad_pcb (2026-09-22)

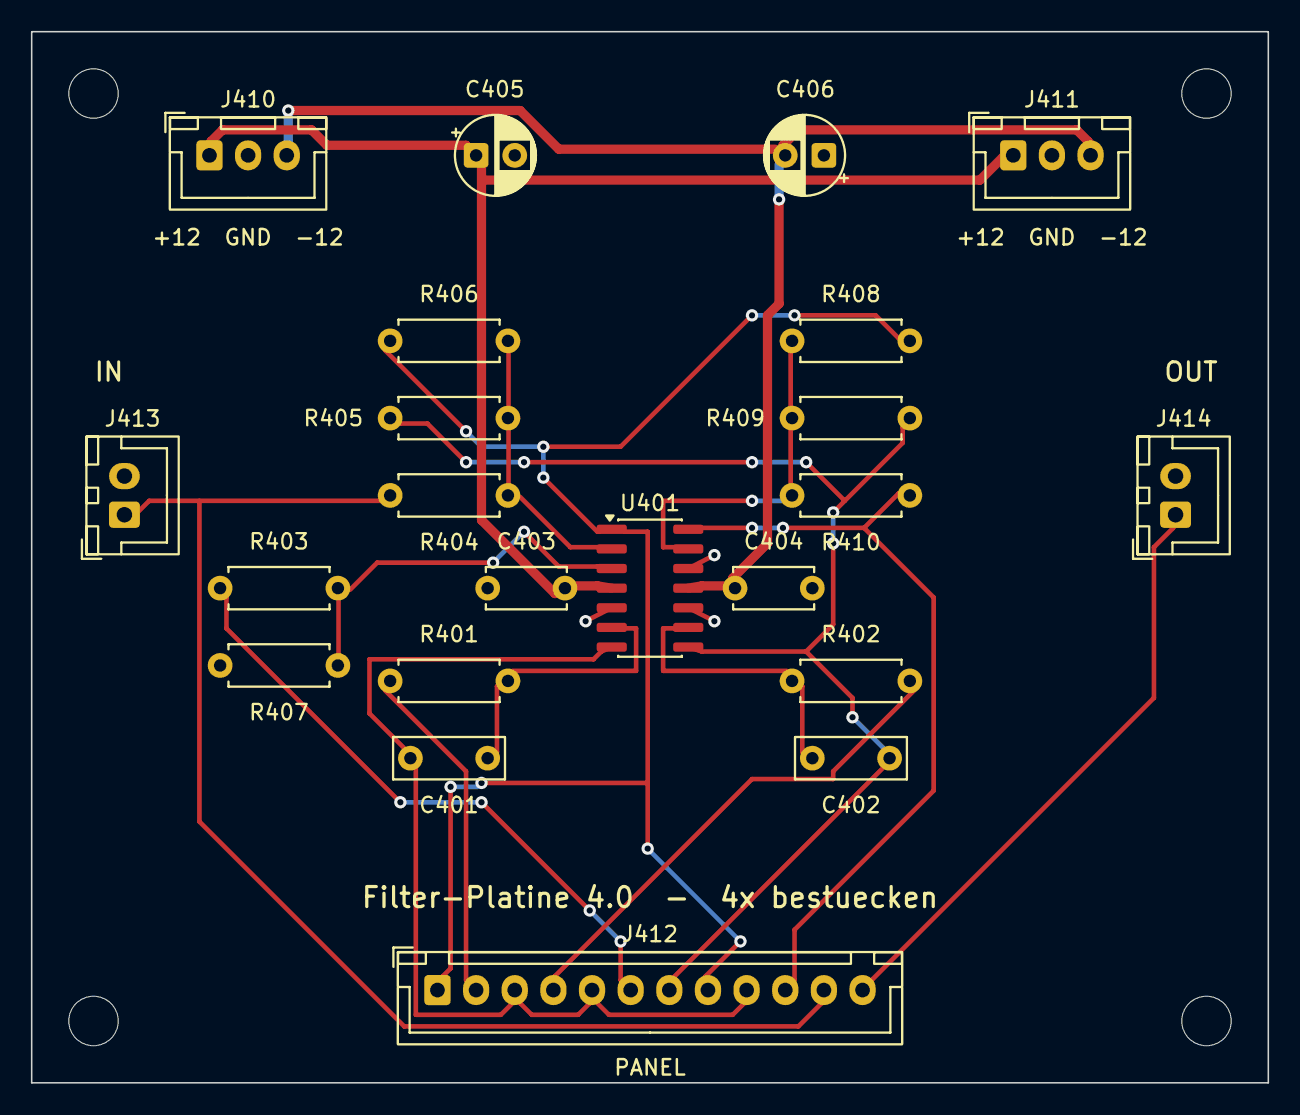
[picture p45: board filter.kicad_pcb from above]

Board: 2 copper layers, 80.0 x 68.0 mm, 26 parts (0 on the bottom side), 17 nets.

Parts:
C401, C402: 15nF; C_Rect_L7.0mm_W2.5mm_P5.00mm
C403, C404: 100nF; C_Disc_D5.0mm_W2.5mm_P5.00mm
C405, C406: 10uF/25V; CP_Radial_D5.0mm_P2.50mm
H1, H2, H3, H4: MountingHole_3.2mm_M3
J410: Versorgung ein; JST_XH_B3B-XH-A_1x03_P2.50mm_Vertical
J411: Versorgung weiter; JST_XH_B3B-XH-A_1x03_P2.50mm_Vertical
J412: Panel Poti + Wahlschalter; JST_XH_B12B-XH-A_1x12_P2.50mm_Vertical
J413: Audio ein; JST_XH_B2B-XH-A_1x02_P2.50mm_Vertical
J414: Audio aus; JST_XH_B2B-XH-A_1x02_P2.50mm_Vertical
R401, R402: 1k; R_Axial_DIN0207_L6.3mm_D2.5mm_P7.62mm_Horizontal
R403, R407: 6.8k; R_Axial_DIN0207_L6.3mm_D2.5mm_P7.62mm_Horizontal
R404, R405, R406, R408, R409, R410: 10k; R_Axial_DIN0207_L6.3mm_D2.5mm_P7.62mm_Horizontal
U401: TL074CDR; SOIC-14_3.9x8.7mm_P1.27mm

Connections:
+12V: C403.1, C405.1, J410.1, J411.1, U401.4
-12V: C404.2, C406.2, J410.3, J411.3, U401.11
/F4_BP: C401.2, J412.3, J412.5, J412.9, U401.7
/F4_HP: J412.1, J412.8, R406.1, R408.1, U401.1
/F4_LP: C402.2, J412.7, R405.1, R409.1, U401.8
/F4_NOTCH: J412.10, R410.2, U401.14
/F4_RESW: J412.6, R403.1
/F4_T1W: J412.2, R401.1
/F4_T2W: J412.4, R402.1
/FILT_A_OUT: J412.12, J414.1
/MIX_OUT: J412.11, J413.1, R404.1
GNDREF: C403.2, C404.1, C405.2, C406.1, J410.2, J411.2, J413.2, J414.2, R407.1, U401.5, U401.10, U401.12
unnamed: R403.2, R407.2, U401.3
unnamed: R404.2, R405.2, R406.2, U401.2
unnamed: C401.1, R401.2, U401.6
unnamed: C402.1, R402.2, U401.9
unnamed: R408.2, R409.2, R410.1, U401.13
