lukimcfly/MaturaProjekt/Platinen/Hauptplatine/main.kicad_pcb

## KiCad design Platinen/Hauptplatine/main.kicad_pcb (2026-09-21)

Schematic: main.kicad_sch, Hauptplatine - Mixer, LM386, Versorgung

Parts:
C801, C802, C803: 1uF; C_Rect_L7.0mm_W4.5mm_P5.00mm
C804, C903: 10uF/16V; CP_Radial_D5.0mm_P2.50mm
C805: 470uF/16V; CP_Radial_D10.0mm_P5.00mm
C806: 47uF/25V; CP_Radial_D6.3mm_P2.50mm
C901: 10uF/25V bipolar; CP_Radial_D5.0mm_P2.50mm
C904: 470uF/25V; CP_Radial_D10.0mm_P5.00mm
C905: 47nF; C_Rect_L7.0mm_W2.5mm_P5.00mm
C906, C931, C932: 100uF/25V; CP_Radial_D6.3mm_P2.50mm
C907, C921, C922, C942: 100nF; C_Disc_D5.0mm_W2.5mm_P5.00mm
C941: 330nF; C_Rect_L7.0mm_W2.5mm_P5.00mm
D907, D908: 1N5819; D_DO-41_SOD81_P10.16mm_Horizontal
F901, F902: T500mA; Fuseholder_Clip-5x20mm_Littelfuse_111_Inline_P20.00x5.00mm_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
J810: Versorgung -> Oszillatoren; JST_XH_B4B-XH-A_1x04_P2.50mm_Vertical
J811: Versorgung -> Filter; JST_XH_B3B-XH-A_1x03_P2.50mm_Vertical
J812: Panel Potis; JST_XH_B12B-XH-A_1x12_P2.50mm_Vertical
J813: OSC 1 ein; JST_XH_B2B-XH-A_1x02_P2.50mm_Vertical
J814: OSC 2 ein; JST_XH_B2B-XH-A_1x02_P2.50mm_Vertical
J815: OSC 3 ein; JST_XH_B2B-XH-A_1x02_P2.50mm_Vertical
J816: -> Filter A; JST_XH_B2B-XH-A_1x02_P2.50mm_Vertical
J817: Filter B ->; JST_XH_B2B-XH-A_1x02_P2.50mm_Vertical
J904: Lautsprecher 8R; JST_XH_B2B-XH-A_1x02_P2.50mm_Vertical
J990: Netzteil +/-12V; JST_XH_B3B-XH-A_1x03_P2.50mm_Vertical
Q801: BC547; TO-92_Inline_Wide
R801, R802, R803, R809: 100k; R_Axial_DIN0207_L6.3mm_D2.5mm_P7.62mm_Horizontal
R804: 47k; R_Axial_DIN0207_L6.3mm_D2.5mm_P7.62mm_Horizontal
R805: 10k; R_Axial_DIN0207_L6.3mm_D2.5mm_P7.62mm_Horizontal
R806: 470; R_Axial_DIN0207_L6.3mm_D2.5mm_P7.62mm_Horizontal
R807: 100; R_Axial_DIN0207_L6.3mm_D2.5mm_P7.62mm_Horizontal
R808: 1; R_Axial_DIN0207_L6.3mm_D2.5mm_P7.62mm_Horizontal
R901: 10; R_Axial_DIN0207_L6.3mm_D2.5mm_P7.62mm_Horizontal
R902: 68k; R_Axial_DIN0207_L6.3mm_D2.5mm_P7.62mm_Horizontal
RV801, RV802, RV803, RV901: 10k log
U901: LM386; DIP-8_W7.62mm_Socket
U990: 78L05; TO-92_Inline_Wide

Connections:
+5V: C942.1, J810.4, U990.1 (VO)
+12V: C906.1, C907.1, C921.1, C931.1, C941.1, D907.1 (K), J810.1, J811.1, R804.1, R806.1, U901.6 (V+), U990.3 (VI)
-12V: C922.2, C932.2, D908.2 (A), J810.3, J811.3
/FILT_B_OUT: C901.1, J817.1
/MIX_OUT: C806.2, J816.1, R809.1
/M_LVL1_A: C801.2, J812.1, RV801.1
/M_LVL1_W: J812.2, R801.1, RV801.2
/M_LVL2_A: C802.2, J812.4, RV802.1
/M_LVL2_W: J812.5, R802.1, RV802.2
/M_LVL3_A: C803.2, J812.7, RV803.1
/M_LVL3_W: J812.8, R803.1, RV803.2
/M_VOL_A: J812.10, R902.2, RV901.1
/M_VOL_W: J812.11, RV901.2, U901.3 (+)
/OSC1_OUT: C801.1, J813.1
/OSC2_OUT: C802.1, J814.1
/OSC3_OUT: C803.1, J815.1
/VIN_N: F902.1, J990.3
/VIN_P: F901.1, J990.1
GNDREF: C805.2, C903.2, C905.2, C906.2, C907.2, C921.2, C922.1, C931.2, C932.1, C941.2, C942.2, J810.2, J811.2, J812.3, J812.6, J812.9, J812.12, J813.2, J814.2, J815.2, J816.2, J817.2, J904.2, J990.2, R805.2, R808.2, R809.2, RV801.3, RV802.3, RV803.3, RV901.3, U901.2 (-), U901.4 (GND), U990.2 (GND)
unnamed: C804.2, R801.2, R802.2, R803.2
unnamed: C805.1, R807.2, R808.1
unnamed: C901.2, R902.1
unnamed: C904.1, R901.1, U901.5
unnamed: C905.1, R901.2
unnamed: D907.2 (A), F901.2
unnamed: D908.1 (K), F902.2
unnamed: C904.2, J904.1
unnamed: C804.1, Q801.2 (B), R804.2, R805.1
unnamed: C806.1, Q801.1 (C), R806.2
unnamed: Q801.3 (E), R807.1
unnamed: C903.1, U901.7 (BYPASS)

Notes on the sheet:
STROMVERSORGUNG DER OPERATIONSVERSTAERKER
VERSORGUNG, ABBLOCKUNG UND +5 V
Mixer / Endstufe
Uebernommen aus der Falstad-Simulation. R809 (1k) = Lastwiderstand aus der Simulation.
SIGNALWEG (durchgehend verdrahtet): Oszillator 1/2/3 -> Mixer -> Filter A -> Filter B -> LM386 -> Lautsprecher Die Solo-Filter C und D werden per Klinkenkabel in den Filter-Port eines Oszillators eingeschleift.
MIXER - 3-Kanal Summierer + BC547 Verstaerkerstufe
VERPOLUNGS- UND UEBERSTROMSCHUTZ
F901/F902 begrenzen den Strom bei einem Kurzschluss. D907/D908 (Schottky) sperren, wenn der Netzstecker verpolt ist: +12 V und -12 V koennen dann nicht vertauscht an die ICs gelangen. Spannungsverlust ca. 0,3 V pro Schiene.
ENDVERSTAERKER - LM386 + Lautsprecher

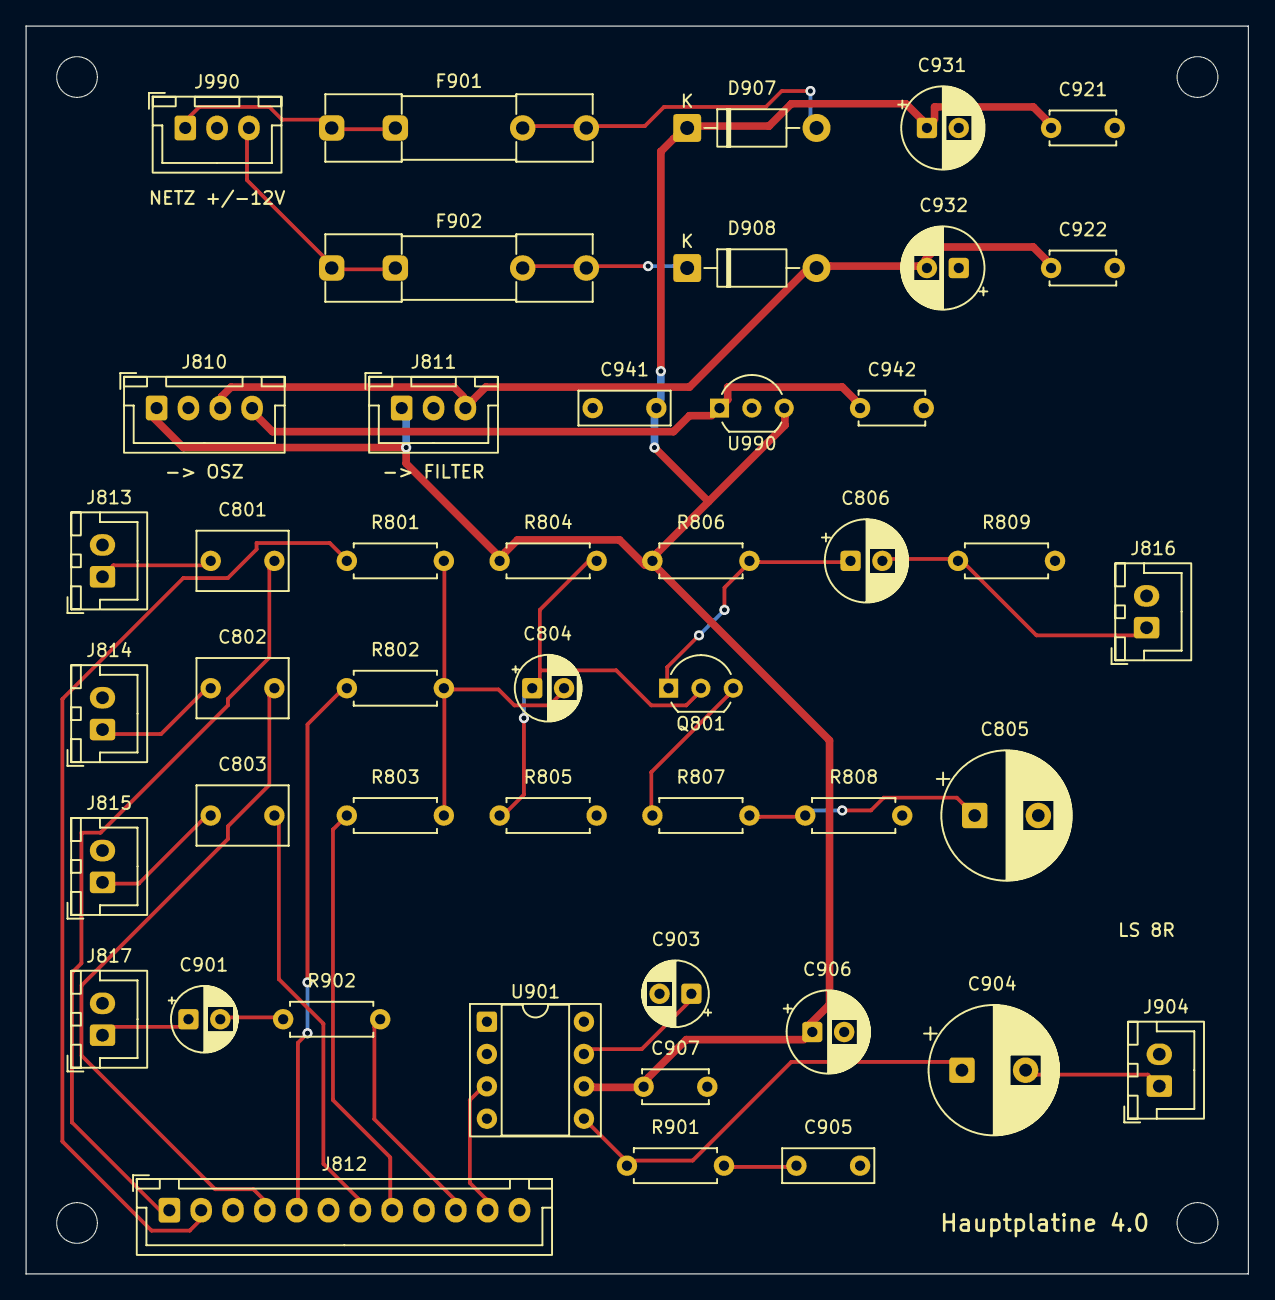
[picture p46: board main.kicad_pcb from above]

Board: 2 copper layers, 96.0 x 98.0 mm, 50 parts (0 on the bottom side), 31 nets.

Other parts of the board:
H1, H2, H3, H4: MountingHole_3.2mm_M3
