lukimcfly/MaturaProjekt/KicadCircuit/Filter.kicad_sch

## KiCad design KicadCircuit/Filter.kicad_sch (2026-09-11)

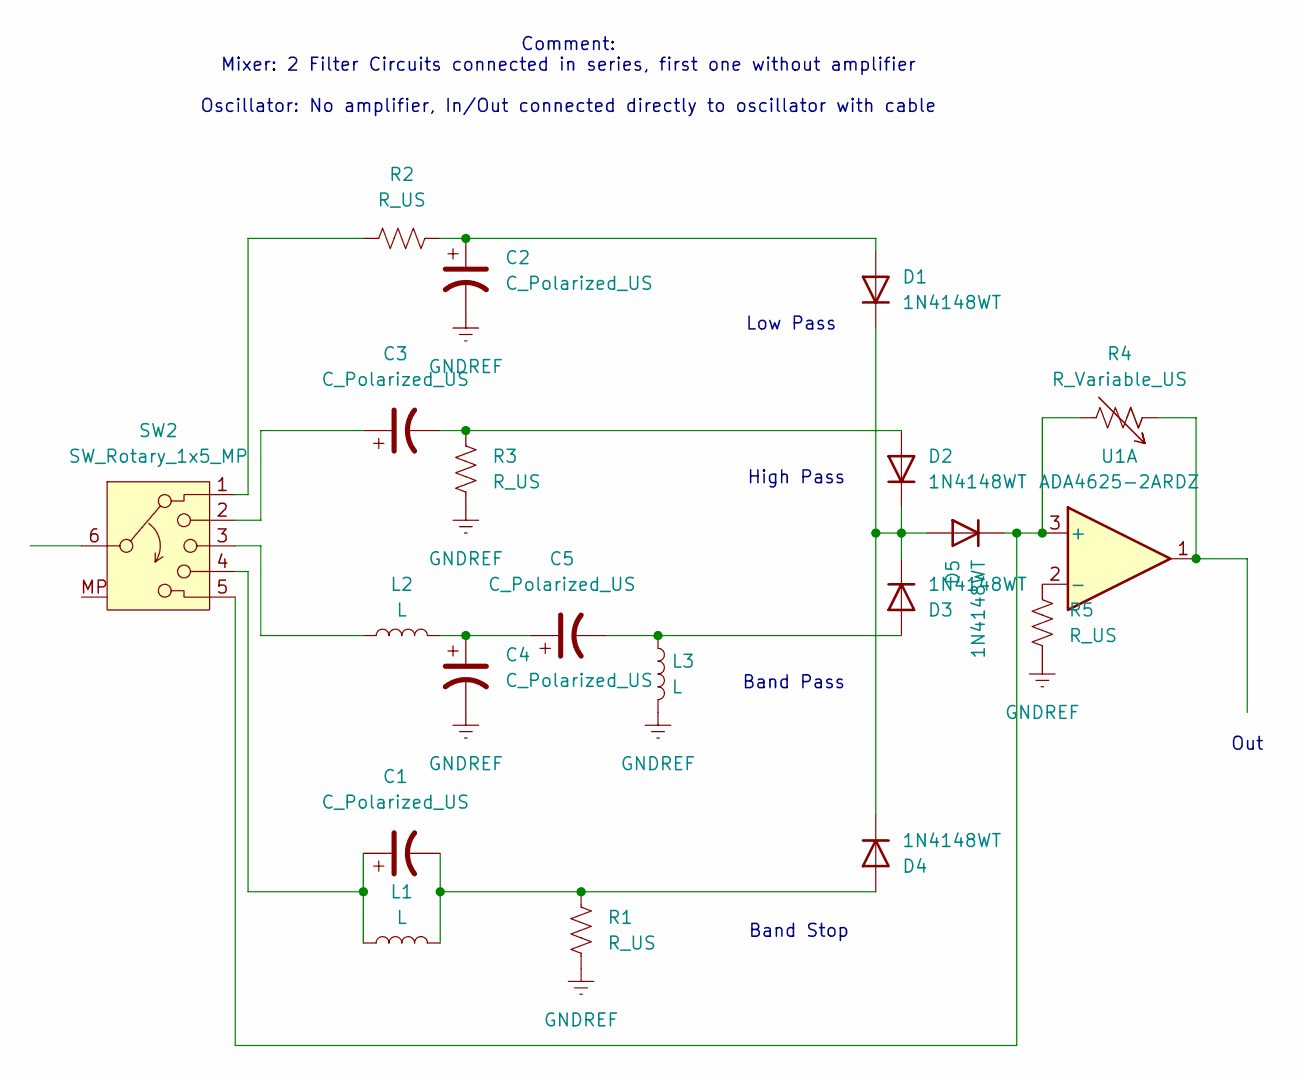
[picture p47: schematic Filter.kicad_sch]

Parts:
C1, C2, C3, C4, C5: C_Polarized_US
D1, D2, D3, D4, D5: 1N4148WT; D_SOD-523
L1, L2, L3: L
R1, R2, R3, R5: R_US
R4: R_Variable_US
SW2: SW_Rotary_1x5_MP
U1: ADA4625-2ARDZ; SOIC-8-1EP_3.9x4.9mm_P1.27mm_EP2.29x3mm

Connections:
GNDREF: C2.2, C4.2, L3.2, R1.2, R3.2, R5.2
unnamed: C1.1, L1.1, SW2.4
unnamed: C1.2, D4.2 (A), L1.2, R1.1
unnamed: C2.1, D1.2 (A), R2.2
unnamed: C3.1, SW2.2
unnamed: C3.2, D2.2 (A), R3.1
unnamed: C4.1, C5.1, L2.2
unnamed: C5.2, D3.2 (A), L3.1
unnamed: D1.1 (K), D2.1 (K), D3.1 (K), D4.1 (K), D5.2 (A)
unnamed: D5.1 (K), R4.2, SW2.5, U1.3 (+)
unnamed: L2.1, SW2.3
unnamed: R2.1, SW2.1
unnamed: R4.1, U1.1
unnamed: R5.1, U1.2 (-)

Notes on the sheet:
Low Pass
Out
Comment: Mixer: 2 Filter Circuits connected in series, first one without amplifier Oscillator: No amplifier, In/Out connected directly to oscillator with cable
Band Stop
Band Pass
High Pass
