lukimcfly/MaturaProjekt/KicadCircuit/Oscillator1.kicad_sch

## KiCad design KicadCircuit/Oscillator1.kicad_sch (2026-09-11)

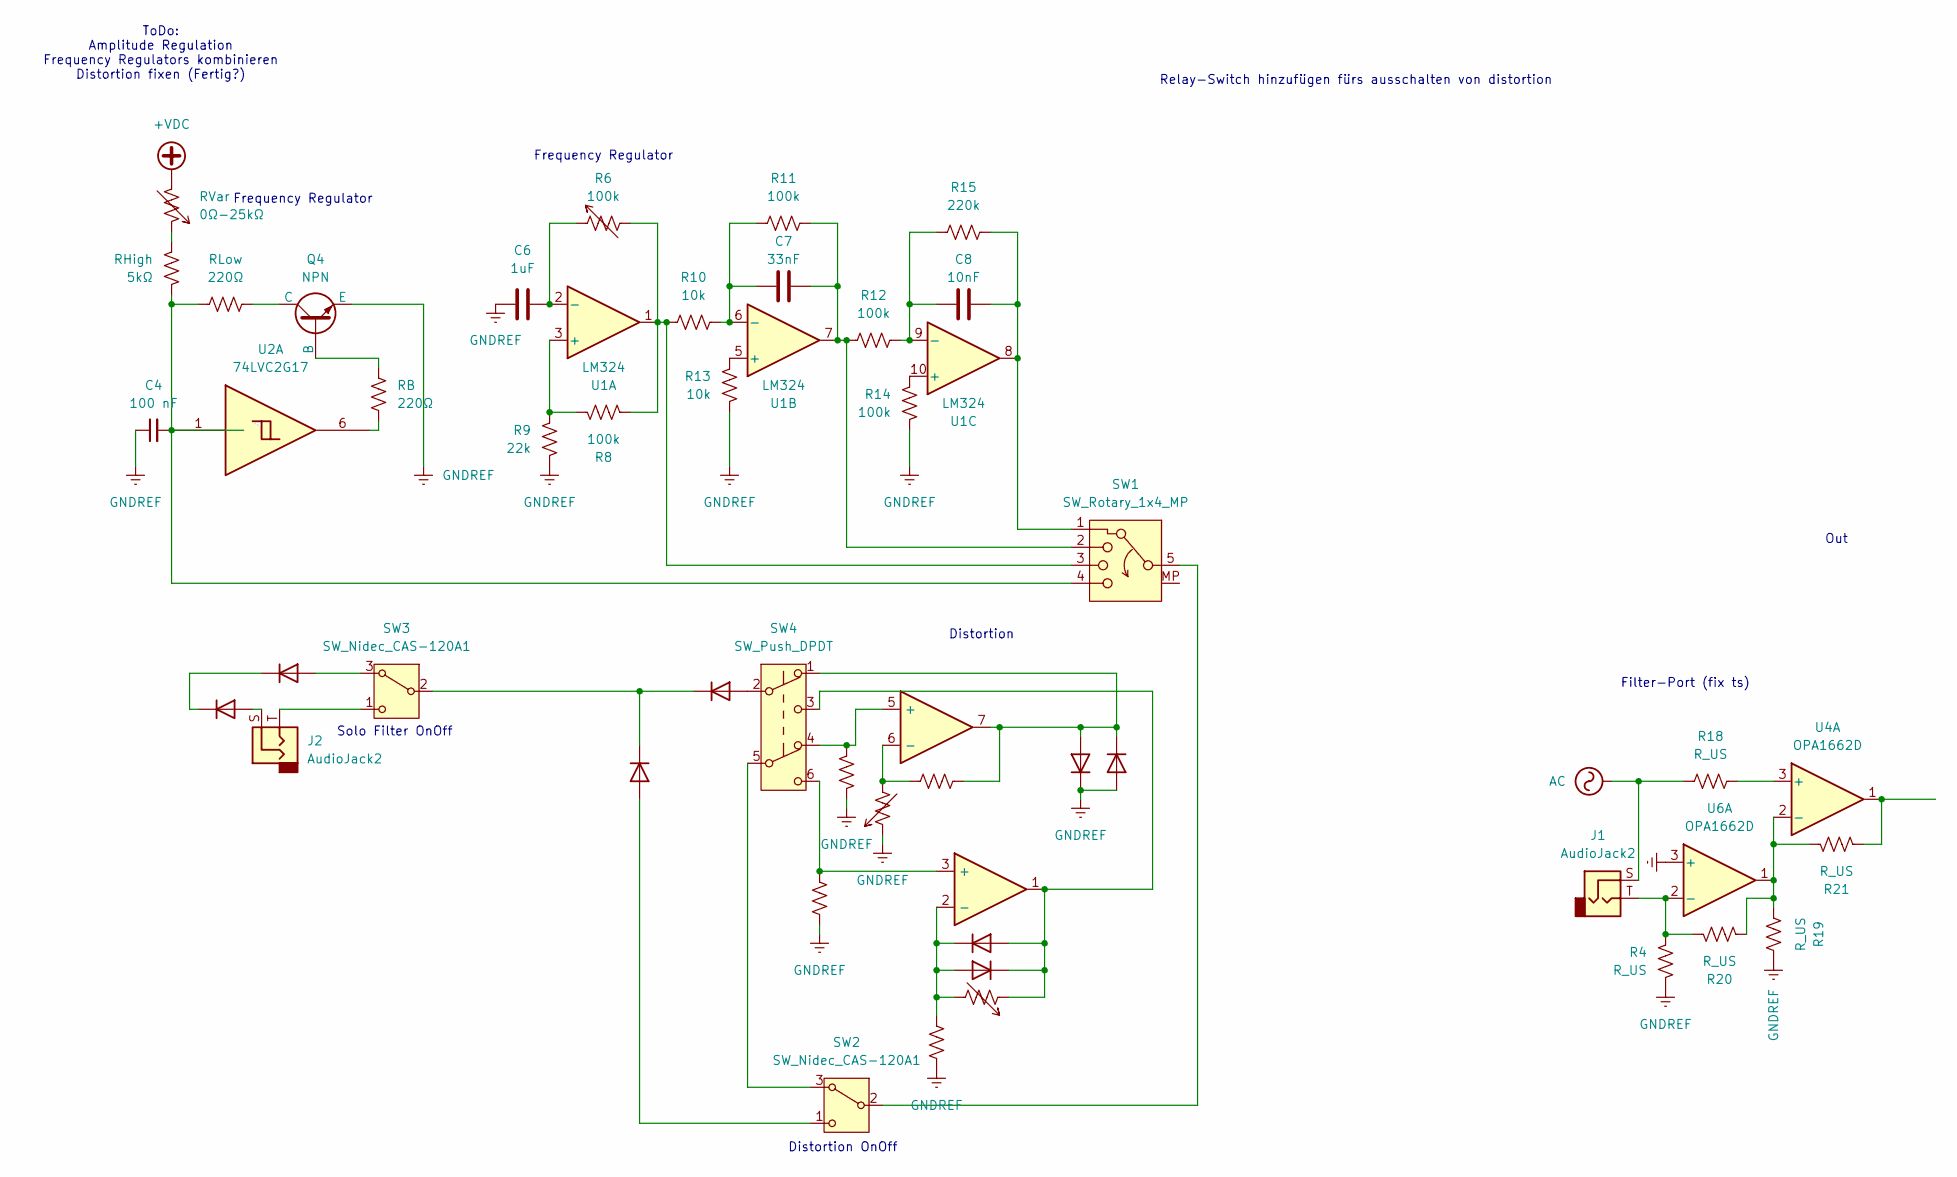
[picture p48: schematic Oscillator1.kicad_sch]

Parts:
0Ω-25kΩ: RVar
C4: 100 nF
C6: 1uF
C7: 33nF
C8: 10nF
D1, D2, D3, D4, D5, D6, D7, D8: 1N4148WT; D_SOD-523
J1, J2: AudioJack2
Q4: NPN
R1, R2: R_Variable_US
R3, R4, R7, R16, R17, R18, R19, R20, R21: R_US
R6, R8, R11, R12, R14: 100k
R9: 22k
R10, R13: 10k
R15: 220k
RB: 220Ω
RHigh: 5kΩ
RLow: 220Ω
SW1: SW_Rotary_1x4_MP
SW2, SW3: SW_Nidec_CAS-120A1; Nidec_Copal_CAS-120A
SW4: SW_Push_DPDT
U1: LM324; DIP-14_W7.62mm
U2: 74LVC2G17
U3: OPA4196xPW; TSSOP-14_4.4x5mm_P0.65mm
U4, U6: OPA1662D; SOIC-8_3.9x4.9mm_P1.27mm

Connections:
+VDC: 0Ω-25kΩ.2
AC: J1.S, R18.1
GNDREF: C4.1, C6.1, D2.2 (A), D3.1 (K), Q4.3 (E), R2.1, R3.2, R4.2, R9.2, R13.2, R14.2, R16.2, R17.1, R19.2, U6.3 (+)
unnamed: 0Ω-25kΩ.1, RHigh.1
unnamed: C4.2, RHigh.2, RLow.1, SW1.4, U2.1
unnamed: C6.2, R6.1, U1.2 (-)
unnamed: C7.1, R10.2, R11.2, U1.6 (-)
unnamed: C7.2, R11.1, R12.1, SW1.2, U1.7
unnamed: C8.1, R12.2, R15.2, U1.9 (-)
unnamed: C8.2, R15.1, SW1.1, U1.8
unnamed: D1.1 (K), D4.2 (A), R1.1, SW4.3 (C), U3.1
unnamed: D1.2 (A), D4.1 (K), R1.2, R3.1, U3.2 (-)
unnamed: D2.1 (K), D3.2 (A), R7.2, SW4.1 (A), U3.7
unnamed: D5.1 (K), D6.1 (K)
unnamed: D5.2 (A), SW3.3 (A)
unnamed: D6.2 (A), J2.S
unnamed: D7.1 (K), D8.1 (K), SW3.2 (B)
unnamed: D7.2 (A), SW4.2 (B)
unnamed: D8.2 (A), SW2.1 (C)
unnamed: J1.T, R4.1, R20.1, U6.2 (-)
unnamed: J2.T, SW3.1 (C)
unnamed: Q4.1 (C), RLow.2
unnamed: Q4.2 (B), RB.1
unnamed: R2.2, R7.1, U3.6 (-)
unnamed: R8.1, R9.1, U1.3 (+)
unnamed: R6.2, R8.2, R10.1, SW1.3, U1.1
unnamed: R13.1, U1.5 (+)
unnamed: R14.1, U1.10 (+)
unnamed: R16.1, SW4.6 (C), U3.3 (+)
unnamed: R17.2, SW4.4 (A), U3.5 (+)
unnamed: R18.2, U4.3 (+)
unnamed: R19.1, R20.2, R21.1, U4.2 (-), U6.1
unnamed: R21.2, U4.1
unnamed: RB.2, U2.6
unnamed: SW1.5, SW2.2 (B)
unnamed: SW2.3 (A), SW4.5 (B)

Notes on the sheet:
Distortion
Distortion OnOff
Frequency Regulator
Solo Filter OnOff
Out
Relay-Switch hinzufügen fürs ausschalten von distortion
ToDo: Amplitude Regulation Frequency Regulators kombinieren Distortion fixen (Fertig?)
Filter-Port (fix ts)
