lukimcfly/MaturaProjekt/SynthesizerFinal/SynthesizerFinal.kicad_sch

## KiCad design SynthesizerFinal/SynthesizerFinal.kicad_sch (2026-09-22)

Schematic: SynthesizerFinal.kicad_sch

Parts:
C101, C201, C301: 56nF; C_Rect_L7.0mm_W2.5mm_P5.00mm
C102, C202, C302, C401, C402, C501, C502, C601, C602, C701, C702: 15nF; C_Rect_L7.0mm_W2.5mm_P5.00mm
C103, C104, C203, C204, C303, C304, C801, C802, C803: 1uF; C_Rect_L7.0mm_W4.5mm_P5.00mm
C105, C106, C107, C108, C109, C110, C111, C205, C206, C207, C208, C209, C210, C211, C305, C306, C307, C308, C309, C310, C311, C403, C404, C503, C504, C603, C604, C703, C704, C907, C921, C922, C942: 100nF; C_Disc_D5.0mm_W2.5mm_P5.00mm
C112, C113, C212, C213, C312, C313, C405, C406, C505, C506, C605, C606, C705, C706: 10uF/25V; CP_Radial_D5.0mm_P2.50mm
C804, C903: 10uF/16V; CP_Radial_D5.0mm_P2.50mm
C805: 470uF/16V; CP_Radial_D10.0mm_P5.00mm
C806: 47uF/25V; CP_Radial_D6.3mm_P2.50mm
C901: 10uF/25V bipolar; CP_Radial_D5.0mm_P2.50mm
C904: 470uF/25V; CP_Radial_D10.0mm_P5.00mm
C905: 47nF; C_Rect_L7.0mm_W2.5mm_P5.00mm
C906, C931, C932: 100uF/25V; CP_Radial_D6.3mm_P2.50mm
C941: 330nF; C_Rect_L7.0mm_W2.5mm_P5.00mm
D101, D102, D103, D104, D105, D106, D201, D202, D203, D204, D205, D206, D301, D302, D303, D304, D305, D306: 1N4148; D_DO-35_SOD27_P7.62mm_Horizontal
D907, D908: 1N5819; D_DO-41_SOD81_P10.16mm_Horizontal
F901, F902: T500mA; Fuseholder_Clip-5x20mm_Littelfuse_111_Inline_P20.00x5.00mm_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
J101, J201, J301: Filter-Send
J102, J202, J302: Filter-Return
J103, J203, J303: Ausgang
J110, J210, J310: Versorgung ein; JST_XH_B4B-XH-A_1x04_P2.50mm_Vertical
J111, J211, J311: Versorgung weiter; JST_XH_B4B-XH-A_1x04_P2.50mm_Vertical
J112, J212, J312: Panel Potis; JST_XH_B11B-XH-A_1x11_P2.50mm_Vertical
J113, J213, J313: Panel Schalter; JST_XH_B14B-XH-A_1x14_P2.50mm_Vertical
J114, J214, J314: Panel Buchsen; JST_XH_B6B-XH-A_1x06_P2.50mm_Vertical
J115, J215, J315: Audio aus -> Mixer; JST_XH_B2B-XH-A_1x02_P2.50mm_Vertical
J410, J510, J610, J710: Versorgung ein; JST_XH_B3B-XH-A_1x03_P2.50mm_Vertical
J411, J511, J611, J711: Versorgung weiter; JST_XH_B3B-XH-A_1x03_P2.50mm_Vertical
J412, J512, J612, J712: Panel Poti + Wahlschalter; JST_XH_B12B-XH-A_1x12_P2.50mm_Vertical
J413, J513, J613, J713: Audio ein; JST_XH_B2B-XH-A_1x02_P2.50mm_Vertical
J414, J514, J614, J714: Audio aus; JST_XH_B2B-XH-A_1x02_P2.50mm_Vertical
J601, J701: Filter-In
J602, J702: Filter-Out
J810: Versorgung -> Oszillatoren; JST_XH_B4B-XH-A_1x04_P2.50mm_Vertical
J811: Versorgung -> Filter; JST_XH_B3B-XH-A_1x03_P2.50mm_Vertical
J812: Panel Potis; JST_XH_B12B-XH-A_1x12_P2.50mm_Vertical
J813: OSC 1 ein; JST_XH_B2B-XH-A_1x02_P2.50mm_Vertical
J814: OSC 2 ein; JST_XH_B2B-XH-A_1x02_P2.50mm_Vertical
J815: OSC 3 ein; JST_XH_B2B-XH-A_1x02_P2.50mm_Vertical
J816: -> Filter A; JST_XH_B2B-XH-A_1x02_P2.50mm_Vertical
J817: Filter B ->; JST_XH_B2B-XH-A_1x02_P2.50mm_Vertical
J904: Lautsprecher 8R; JST_XH_B2B-XH-A_1x02_P2.50mm_Vertical
J990: Netzteil +/-12V; JST_XH_B3B-XH-A_1x03_P2.50mm_Vertical
Q101, Q201, Q301, Q801: BC547; TO-92_Inline_Wide
R101, R106, R107, R109, R110, R111, R113, R114, R118, R119, R120, R123, R125, R127, R201, R206, R207, R209, R210, R211, R213, R214, R218, R219, R220, R223, R225, R227, R301, R306, R307, R309, R310, R311, R313, R314, R318, R319, R320, R323, R325, R327: 10k; R_Axial_DIN0207_L6.3mm_D2.5mm_P2.54mm_Vertical
R102, R202, R302: 1k; R_Axial_DIN0207_L6.3mm_D2.5mm_P2.54mm_Vertical
R103, R203, R303: 220; R_Axial_DIN0207_L6.3mm_D2.5mm_P2.54mm_Vertical
R104, R108, R204, R208, R304, R308: 47k; R_Axial_DIN0207_L6.3mm_D2.5mm_P2.54mm_Vertical
R105, R205, R305: 16k; R_Axial_DIN0207_L6.3mm_D2.5mm_P2.54mm_Vertical
R112, R212, R312: 82k; R_Axial_DIN0207_L6.3mm_D2.5mm_P2.54mm_Vertical
R115, R215, R315: 330k; R_Axial_DIN0207_L6.3mm_D2.5mm_P2.54mm_Vertical
R116, R216, R316: 2.2k; R_Axial_DIN0207_L6.3mm_D2.5mm_P2.54mm_Vertical
R117, R122, R217, R222, R317, R322: 100k; R_Axial_DIN0207_L6.3mm_D2.5mm_P2.54mm_Vertical
R121, R221, R321: 100; R_Axial_DIN0207_L6.3mm_D2.5mm_P2.54mm_Vertical
R124, R224, R324: 56k; R_Axial_DIN0207_L6.3mm_D2.5mm_P2.54mm_Vertical
R126, R226, R326: 20k; R_Axial_DIN0207_L6.3mm_D2.5mm_P2.54mm_Vertical
R401, R402, R501, R502, R601, R602, R701, R702: 1k; R_Axial_DIN0207_L6.3mm_D2.5mm_P7.62mm_Horizontal
R403, R407, R503, R507, R603, R607, R703, R707: 6.8k; R_Axial_DIN0207_L6.3mm_D2.5mm_P7.62mm_Horizontal
R404, R405, R406, R408, R409, R410, R504, R505, R506, R508, R509, R510, R604, R605, R606, R608, R609, R610, R704, R705, R706, R708, R709, R710, R805: 10k; R_Axial_DIN0207_L6.3mm_D2.5mm_P7.62mm_Horizontal
R801, R802, R803, R809: 100k; R_Axial_DIN0207_L6.3mm_D2.5mm_P7.62mm_Horizontal
R804: 47k; R_Axial_DIN0207_L6.3mm_D2.5mm_P7.62mm_Horizontal
R806: 470; R_Axial_DIN0207_L6.3mm_D2.5mm_P7.62mm_Horizontal
R807: 100; R_Axial_DIN0207_L6.3mm_D2.5mm_P7.62mm_Horizontal
R808: 1; R_Axial_DIN0207_L6.3mm_D2.5mm_P7.62mm_Horizontal
R901: 10; R_Axial_DIN0207_L6.3mm_D2.5mm_P7.62mm_Horizontal
R902: 68k; R_Axial_DIN0207_L6.3mm_D2.5mm_P7.62mm_Horizontal
RV101, RV102, RV201, RV202, RV301, RV302: 1M lin
RV103, RV203, RV303, RV401, RV402, RV501, RV502, RV601, RV602, RV701, RV702: 100k lin
RV104, RV204, RV304: 100k log
RV105, RV205, RV305, RV801, RV802, RV803, RV901: 10k log
RV403, RV503, RV603, RV703: 47k lin
SW101, SW201, SW301: Wellenform
SW102, SW202, SW302: weich/hart
SW103, SW203, SW303: Distortion ein/aus
SW104, SW204, SW304: Solo-Filter ein/aus
SW401, SW501, SW601, SW701: Filterwahl
U101, U201, U301: TL074; DIP-14_W7.62mm_Socket
U102, U202, U302: 74LVC2G17; SOT-23-6
U103, U203, U303, U401, U501, U601, U701: TL074CDR; SOIC-14_3.9x8.7mm_P1.27mm
U104, U204, U304: OPA1662; SOIC-8_3.9x4.9mm_P1.27mm
U901: LM386; DIP-8_W7.62mm_Socket
U990: 78L05; TO-92_Inline_Wide

Connections:
+5V: C107.1, C207.1, C307.1, C942.1, J110.4, J111.4, J112.5, J210.4, J211.4, J212.5, J310.4, J311.4, J312.5, J810.4, RV101.1, RV201.1, RV301.1, U102.5 (VCC), U202.5 (VCC), U302.5 (VCC), U990.1 (VO)
+12V: C105.1, C108.1, C110.1, C112.1, C205.1, C208.1, C210.1, C212.1, C305.1, C308.1, C310.1, C312.1, C403.1, C405.1, C503.1, C505.1, C603.1, C605.1, C703.1, C705.1, C906.1, C907.1, C921.1, C931.1, C941.1, D907.1 (K), J110.1, J111.1, J210.1, J211.1, J310.1, J311.1, J410.1, J411.1, J510.1, J511.1, J610.1, J611.1, J710.1, J711.1, J810.1, J811.1, R804.1, R806.1, U101.4 (V+), U103.4 (V+), U104.8 (V+), U201.4 (V+), U203.4 (V+), U204.8 (V+), U301.4 (V+), U303.4 (V+), U304.8 (V+), U401.4 (V+), U501.4 (V+), U601.4 (V+), U701.4 (V+), U901.6 (V+), U990.3 (VI)
-12V: C106.2, C109.2, C111.2, C113.2, C206.2, C209.2, C211.2, C213.2, C306.2, C309.2, C311.2, C313.2, C404.2, C406.2, C504.2, C506.2, C604.2, C606.2, C704.2, C706.2, C922.2, C932.2, D908.2 (A), J110.3, J111.3, J210.3, J211.3, J310.3, J311.3, J410.3, J411.3, J510.3, J511.3, J610.3, J611.3, J710.3, J711.3, J810.3, J811.3, U101.11 (V-), U103.11 (V-), U104.4 (V-), U201.11 (V-), U203.11 (V-), U204.4 (V-), U301.11 (V-), U303.11 (V-), U304.4 (V-), U401.11 (V-), U501.11 (V-), U601.11 (V-), U701.11 (V-)
F4_BP: C401.2, J412.3, J412.5, J412.9, RV402.1, RV403.1, SW401.3, U401.7
F4_HP: J412.1, J412.8, R406.1, R408.1, RV401.1, SW401.2, U401.1
F4_LP: C402.2, J412.7, R405.1, R409.1, SW401.1, U401.8
F4_NOTCH: J412.10, R410.2, SW401.4, U401.14
F4_RESW: J412.6, R403.1, RV403.2
F4_T1W: J412.2, R401.1, RV401.2
F4_T2W: J412.4, R402.1, RV402.2
F5_BP: C501.2, J512.3, J512.5, J512.9, RV502.1, RV503.1, SW501.3, U501.7
F5_HP: J512.1, J512.8, R506.1, R508.1, RV501.1, SW501.2, U501.1
F5_LP: C502.2, J512.7, R505.1, R509.1, SW501.1, U501.8
F5_NOTCH: J512.10, R510.2, SW501.4, U501.14
F5_RESW: J512.6, R503.1, RV503.2
F5_T1W: J512.2, R501.1, RV501.2
F5_T2W: J512.4, R502.1, RV502.2
F6_BP: C601.2, J612.3, J612.5, J612.9, RV602.1, RV603.1, SW601.3, U601.7
F6_HP: J612.1, J612.8, R606.1, R608.1, RV601.1, SW601.2, U601.1
F6_IN: J601.T, J612.11, J613.1, R604.1, SW601.5
F6_LP: C602.2, J612.7, R605.1, R609.1, SW601.1, U601.8
F6_NOTCH: J612.10, R610.2, SW601.4, U601.14
F6_OUT: J602.T, J612.12, J614.1, SW601.6
F6_RESW: J612.6, R603.1, RV603.2
F6_T1W: J612.2, R601.1, RV601.2
F6_T2W: J612.4, R602.1, RV602.2
F7_BP: C701.2, J712.3, J712.5, J712.9, RV702.1, RV703.1, SW701.3, U701.7
F7_HP: J712.1, J712.8, R706.1, R708.1, RV701.1, SW701.2, U701.1
F7_IN: J701.T, J712.11, J713.1, R704.1, SW701.5
F7_LP: C702.2, J712.7, R705.1, R709.1, SW701.1, U701.8
F7_NOTCH: J712.10, R710.2, SW701.4, U701.14
F7_OUT: J702.T, J712.12, J714.1, SW701.6
F7_RESW: J712.6, R703.1, RV703.2
F7_T1W: J712.2, R701.1, RV701.2
F7_T2W: J712.4, R702.1, RV702.2
FILT_A_OUT: J412.12, J414.1, J512.11, J513.1, R504.1, SW401.6, SW501.5
FILT_B_OUT: C901.1, J512.12, J514.1, J817.1, SW501.6
GNDREF: C101.2, C105.2, C106.1, C107.2, C108.2, C109.1, C110.2, C111.1, C112.2, C113.1, C201.2, C205.2, C206.1, C207.2, C208.2, C209.1, C210.2, C211.1, C212.2, C213.1, C301.2, C305.2, C306.1, C307.2, C308.2, C309.1, C310.2, C311.1, C312.2, C313.1, C403.2, C404.1, C405.2, C406.1, C503.2, C504.1, C505.2, C506.1, C603.2, C604.1, C605.2, C606.1, C703.2, C704.1, C705.2, C706.1, C805.2, C903.2, C905.2, C906.2, C907.2, C921.2, C922.1, C931.2, C932.1, C941.2, C942.2, D105.2 (A), D106.1 (K), D205.2 (A), D206.1 (K), D305.2 (A), D306.1 (K), J101.S, J102.S, J103.S, J110.2, J111.2, J112.8, J114.2, J114.4, J114.6, J115.2, J201.S, J202.S, J203.S, J210.2, J211.2, J212.8, J214.2, J214.4, J214.6, J215.2, J301.S, J302.S, J303.S, J310.2, J311.2, J312.8, J314.2, J314.4, J314.6, J315.2, J410.2, J411.2, J413.2, J414.2, J510.2, J511.2, J513.2, J514.2, J601.S, J602.S, J610.2, J611.2, J613.2, J614.2, J701.S, J702.S, J710.2, J711.2, J713.2, J714.2, J810.2, J811.2, J812.3, J812.6, J812.9, J812.12, J813.2, J814.2, J815.2, J816.2, J817.2, J904.2, J990.2, Q101.3 (E), Q201.3 (E), Q301.3 (E), R107.1, R110.1, R113.1, R117.2, R119.2, R122.1, R125.1, R127.1, R207.1, R210.1, R213.1, R217.2, R219.2, R222.1, R225.1, R227.1, R307.1, R310.1, R313.1, R317.2, R319.2, R322.1, R325.1, R327.1, R407.1, R507.1, R607.1, R707.1, R805.2, R808.2, R809.2, RV105.3, RV205.3, RV305.3, RV801.3, RV802.3, RV803.3, RV901.3, U101.2 (-), U102.2 (GND), U102.3, U103.3 (+), U103.5 (+), U201.2 (-), U202.2 (GND), U202.3, U203.3 (+), U203.5 (+), U301.2 (-), U302.2 (GND), U302.3, U303.3 (+), U303.5 (+), U401.5 (+), U401.10 (+), U401.12 (+), U501.5 (+), U501.10 (+), U501.12 (+), U601.5 (+), U601.10 (+), U601.12 (+), U701.5 (+), U701.10 (+), U701.12 (+), U901.2 (-), U901.4 (GND), U990.2 (GND)
MIX_OUT: C806.2, J412.11, J413.1, J816.1, R404.1, R809.1, SW401.5
M_LVL1_A: C801.2, J812.1, RV801.1
M_LVL1_W: J812.2, R801.1, RV801.2
M_LVL2_A: C802.2, J812.4, RV802.1
M_LVL2_W: J812.5, R802.1, RV802.2
M_LVL3_A: C803.2, J812.7, RV803.1
M_LVL3_W: J812.8, R803.1, RV803.2
M_VOL_A: J812.10, R902.2, RV901.1
M_VOL_W: J812.11, RV901.2, U901.3 (+)
unnamed: C101.1, R101.2, R103.1, U102.1, U103.10 (+)
unnamed: C104.1, U103.8, U103.9 (-)
unnamed: C104.2, R123.1
unnamed: C201.1, R201.2, R203.1, U202.1, U203.10 (+)
unnamed: C204.1, U203.8, U203.9 (-)
unnamed: C204.2, R223.1
unnamed: C301.1, R301.2, R303.1, U302.1, U303.10 (+)
unnamed: C304.1, U303.8, U303.9 (-)
unnamed: C304.2, R323.1
unnamed: C401.1, R401.2, U401.6 (-)
unnamed: C402.1, R402.2, U401.9 (-)
unnamed: C501.1, R501.2, U501.6 (-)
unnamed: C502.1, R502.2, U501.9 (-)
unnamed: C601.1, R601.2, U601.6 (-)
unnamed: C602.1, R602.2, U601.9 (-)
unnamed: C701.1, R701.2, U701.6 (-)
unnamed: C702.1, R702.2, U701.9 (-)
unnamed: C804.1, Q801.2 (B), R804.2, R805.1
unnamed: C804.2, R801.2, R802.2, R803.2
unnamed: C805.1, R807.2, R808.1
unnamed: C806.1, Q801.1 (C), R806.2
unnamed: C901.2, R902.1
unnamed: C903.1, U901.7 (BYPASS)
unnamed: C904.1, R901.1, U901.5
unnamed: C904.2, J904.1
unnamed: C905.1, R901.2
unnamed: D101.1 (K), D102.2 (A), R108.2, R109.1, U101.9 (-)
unnamed: D101.2 (A), D102.1 (K), R109.2, R111.1, U101.8
unnamed: D201.1 (K), D202.2 (A), R208.2, R209.1, U201.9 (-)
unnamed: D201.2 (A), D202.1 (K), R209.2, R211.1, U201.8
unnamed: D301.1 (K), D302.2 (A), R308.2, R309.1, U301.9 (-)
unnamed: D301.2 (A), D302.1 (K), R309.2, R311.1, U301.8
unnamed: D907.2 (A), F901.2
unnamed: D908.1 (K), F902.2
unnamed: Q101.1 (C), R103.2
unnamed: Q101.2 (B), R102.2
unnamed: Q201.1 (C), R203.2
unnamed: Q201.2 (B), R202.2
unnamed: Q301.1 (C), R303.2
unnamed: Q301.2 (B), R302.2
unnamed: Q801.3 (E), R807.1
unnamed: R102.1, U102.6
unnamed: R104.1, R105.2, U101.3 (+)
unnamed: R104.2, R106.1, R126.1, U101.1
unnamed: R107.2, U101.5 (+)
unnamed: R110.2, U101.10 (+)
unnamed: R111.2, R112.1, U101.13 (-)
unnamed: R113.2, U101.12 (+)
unnamed: R118.2, U104.3 (+)
unnamed: R119.1, R120.1, U104.2 (-)
unnamed: R121.1, U104.6 (-), U104.7
unnamed: R123.2, R124.1, U103.13 (-)
unnamed: R125.2, U103.12 (+)
unnamed: R202.1, U202.6
unnamed: R204.1, R205.2, U201.3 (+)
unnamed: R204.2, R206.1, R226.1, U201.1
unnamed: R207.2, U201.5 (+)
unnamed: R210.2, U201.10 (+)
unnamed: R211.2, R212.1, U201.13 (-)
unnamed: R213.2, U201.12 (+)
unnamed: R218.2, U204.3 (+)
unnamed: R219.1, R220.1, U204.2 (-)
unnamed: R221.1, U204.6 (-), U204.7
unnamed: R223.2, R224.1, U203.13 (-)
unnamed: R225.2, U203.12 (+)
unnamed: R302.1, U302.6
unnamed: R304.1, R305.2, U301.3 (+)
unnamed: R304.2, R306.1, R326.1, U301.1
unnamed: R307.2, U301.5 (+)
unnamed: R310.2, U301.10 (+)
unnamed: R311.2, R312.1, U301.13 (-)
unnamed: R313.2, U301.12 (+)
unnamed: R318.2, U304.3 (+)
unnamed: R319.1, R320.1, U304.2 (-)
unnamed: R321.1, U304.6 (-), U304.7
unnamed: R323.2, R324.1, U303.13 (-)
unnamed: R325.2, U303.12 (+)
unnamed: R403.2, R407.2, U401.3 (+)
unnamed: R404.2, R405.2, R406.2, U401.2 (-)
unnamed: R408.2, R409.2, R410.1, U401.13 (-)
unnamed: R503.2, R507.2, U501.3 (+)
unnamed: R504.2, R505.2, R506.2, U501.2 (-)
unnamed: R508.2, R509.2, R510.1, U501.13 (-)
unnamed: R603.2, R607.2, U601.3 (+)
unnamed: R604.2, R605.2, R606.2, U601.2 (-)
unnamed: R608.2, R609.2, R610.1, U601.13 (-)
unnamed: R703.2, R707.2, U701.3 (+)
unnamed: R704.2, R705.2, R706.2, U701.2 (-)
unnamed: R708.2, R709.2, R710.1, U701.13 (-)
O1_AINV: D103.1 (K), D104.2 (A), J112.3, J113.5, R114.2, RV103.1, SW102.1 (C), U103.2 (-)
O1_CLIP: D105.1 (K), D106.2 (A), J112.1, R116.2, RV104.1
O1_DRIVE: J112.4, J113.7, R116.1, RV103.2, SW102.3 (A), U103.1
O1_FGF_A: J112.7, R106.2, RV102.1
O1_FGF_B: C102.1, J112.9, RV102.2, U101.6 (-)
O1_LVL_A: J112.10, R120.2, RV105.1, U104.1
O1_LVL_W: J112.11, RV105.2, U104.5 (+)
O1_MKUP: J113.6, R115.2, SW103.1 (C), U103.7
O1_MKUP_A: J112.2, R115.1, RV104.2, U103.6 (-)
O1_PITCH: J112.6, R101.1, RV101.2
O1_SEND: J101.T, J113.14, J114.1, SW104.1 (C)
O1_SOFT: D103.2 (A), D104.1 (K), J113.1, SW102.2 (B)
O1_WSEL: C103.1, J113.3, SW101.5
O2_AINV: D203.1 (K), D204.2 (A), J212.3, J213.5, R214.2, RV203.1, SW202.1 (C), U203.2 (-)
O2_CLIP: D205.1 (K), D206.2 (A), J212.1, R216.2, RV204.1
O2_DRIVE: J212.4, J213.7, R216.1, RV203.2, SW202.3 (A), U203.1
O2_FGF_A: J212.7, R206.2, RV202.1
O2_FGF_B: C202.1, J212.9, RV202.2, U201.6 (-)
O2_LVL_A: J212.10, R220.2, RV205.1, U204.1
O2_LVL_W: J212.11, RV205.2, U204.5 (+)
O2_MKUP: J213.6, R215.2, SW203.1 (C), U203.7
O2_MKUP_A: J212.2, R215.1, RV204.2, U203.6 (-)
O2_PITCH: J212.6, R201.1, RV201.2
O2_SEND: J201.T, J213.14, J214.1, SW204.1 (C)
O2_SOFT: D203.2 (A), D204.1 (K), J213.1, SW202.2 (B)
O2_WSEL: C203.1, J213.3, SW201.5
O3_AINV: D303.1 (K), D304.2 (A), J312.3, J313.5, R314.2, RV303.1, SW302.1 (C), U303.2 (-)
O3_CLIP: D305.1 (K), D306.2 (A), J312.1, R316.2, RV304.1
O3_DRIVE: J312.4, J313.7, R316.1, RV303.2, SW302.3 (A), U303.1
O3_FGF_A: J312.7, R306.2, RV302.1
O3_FGF_B: C302.1, J312.9, RV302.2, U301.6 (-)
O3_LVL_A: J312.10, R320.2, RV305.1, U304.1
O3_LVL_W: J312.11, RV305.2, U304.5 (+)
O3_MKUP: J313.6, R315.2, SW303.1 (C), U303.7
O3_MKUP_A: J312.2, R315.1, RV304.2, U303.6 (-)
O3_PITCH: J312.6, R301.1, RV301.2
O3_SEND: J301.T, J313.14, J314.1, SW304.1 (C)
O3_SOFT: D303.2 (A), D304.1 (K), J313.1, SW302.2 (B)
O3_WSEL: C303.1, J313.3, SW301.5
OSC1_DIST: J113.2, J113.11, SW103.2 (B), SW104.2 (B)
OSC1_OUT: C801.1, J103.T, J114.5, J115.1, J813.1, R121.2, R122.2
OSC1_SAW: J113.8, R124.2, SW101.4, U103.14
OSC1_SIG: J102.T, J113.12, J114.3, R117.1, R118.1, SW104.3 (A)
OSC1_SINE: J113.13, R112.2, SW101.1, U101.14
OSC1_SQ: J113.9, R126.2, R127.2, SW101.3
OSC1_TRI: C102.2, J113.10, R105.1, R108.1, SW101.2, U101.7
OSC1_WAVE: C103.2, J113.4, R114.1, SW103.3 (A)
OSC2_DIST: J213.2, J213.11, SW203.2 (B), SW204.2 (B)
OSC2_OUT: C802.1, J203.T, J214.5, J215.1, J814.1, R221.2, R222.2
OSC2_SAW: J213.8, R224.2, SW201.4, U203.14
OSC2_SIG: J202.T, J213.12, J214.3, R217.1, R218.1, SW204.3 (A)
OSC2_SINE: J213.13, R212.2, SW201.1, U201.14
OSC2_SQ: J213.9, R226.2, R227.2, SW201.3
OSC2_TRI: C202.2, J213.10, R205.1, R208.1, SW201.2, U201.7
OSC2_WAVE: C203.2, J213.4, R214.1, SW203.3 (A)
OSC3_DIST: J313.2, J313.11, SW303.2 (B), SW304.2 (B)
OSC3_OUT: C803.1, J303.T, J314.5, J315.1, J815.1, R321.2, R322.2
OSC3_SAW: J313.8, R324.2, SW301.4, U303.14
OSC3_SIG: J302.T, J313.12, J314.3, R317.1, R318.1, SW304.3 (A)
OSC3_SINE: J313.13, R312.2, SW301.1, U301.14
OSC3_SQ: J313.9, R326.2, R327.2, SW301.3
OSC3_TRI: C302.2, J313.10, R305.1, R308.1, SW301.2, U301.7
OSC3_WAVE: C303.2, J313.4, R314.1, SW303.3 (A)
VIN_N: F902.1, J990.3
VIN_P: F901.1, J990.1

Notes on the sheet:
D201/D202 runden die Dreieckspitzen (Gegenkopplung wird oberhalb 0,6 V weich), U201D verstaerkt wieder auf Pegel.
OSC 2
E DISTORTION
OSZILLATOR 2
A SAEGEZAHN-GENERATOR
C SINUS-FORMER
Eigenstaendiges Modul: J601 an den Filter-Send, J602 an den Filter-Return eines Oszillators.
RV305 = Amplitude dieses Oszillators. U304B puffert das Poti, R321 schuetzt den Ausgang, R322 haelt die Buchse auf Masse. J303 = Ausgangsbuchse, gleichzeitig geht das Signal zum Mixer.
STROMVERSORGUNG DER OPERATIONSVERSTAERKER
C103 trennt den Gleichanteil ab (der Saegezahn ist unipolar).
VERSORGUNG, ABBLOCKUNG UND +5 V
unbenutzte Einheiten (Eingaenge auf Masse gelegt)
G AUSGANGSSTUFE
F SOLO-FILTER-PORT
Entkopplung Filter C / D
RV901 = Master-Lautstaerke (log). R902 daempft den Filterpegel ab. Pin 1-8 offen -> Verstaerkung 20. R901/C905 = Zobel-Glied. C906/C907 = lokale Abblockung direkt am LM386 (Pin 6). Bei +12 V die Variante LM386N-4 verwenden (Datenblatt pruefen).
C203 trennt den Gleichanteil ab (der Saegezahn ist unipolar).
RV301 = Frequenz (Ebene B des Gleichlaufpotis) U303C puffert den hochohmigen Kondensatorknoten.
Mixer / Endstufe
Uebernommen aus der Falstad-Simulation. R809 (1k) = Lastwiderstand aus der Simulation.
Entkopplung OSC 2
SW102 waehlt weiche (Dioden in der Gegenkopplung) oder harte Begrenzung (Dioden gegen Masse). SW103 ueberbrueckt die Stufe.
Komparator U101A und Integrator U101B bilden einen Regelkreis: die Dreieckamplitude bleibt damit ueber den ganzen Frequenzbereich konstant (Vss = 2 x Vsat x R105/R104). RV102 = Frequenz (Ebene A). R126/R127 teilen das Rechteck auf den Pegel der anderen Kurven.
Entkopplung OSC 3
FILTER A (Hauptweg 1 von 2) - State-Variable-Filter
FILTER B (Hauptweg 2 von 2) - State-Variable-Filter
FILTER C (Solo-Filter 1) - State-Variable-Filter
FILTER D (Solo-Filter 2) - State-Variable-Filter
Komparator U201A und Integrator U201B bilden einen Regelkreis: die Dreieckamplitude bleibt damit ueber den ganzen Frequenzbereich konstant (Vss = 2 x Vsat x R205/R204). RV202 = Frequenz (Ebene A). R226/R227 teilen das Rechteck auf den Pegel der anderen Kurven.
Eigenstaendiges Modul: J701 an den Filter-Send, J702 an den Filter-Return eines Oszillators.
Filter A
Entkopplung OSC 1
RV105 = Amplitude dieses Oszillators. U104B puffert das Poti, R121 schuetzt den Ausgang, R122 haelt die Buchse auf Masse. J103 = Ausgangsbuchse, gleichzeitig geht das Signal zum Mixer.
B FUNKTIONSGENERATOR (Rechteck + Dreieck)
D101/D102 runden die Dreieckspitzen (Gegenkopplung wird oberhalb 0,6 V weich), U101D verstaerkt wieder auf Pegel.
J301 (Send) und J302 (Return) werden per Klinkenkabel mit einem Solo-Filter verbunden. R317 haelt den Knoten definiert, wenn kein Kabel steckt.
OSC 3
SIGNALWEG (durchgehend verdrahtet): Oszillator 1/2/3 -> Mixer -> Filter A -> Filter B -> LM386 -> Lautsprecher Die Solo-Filter C und D werden per Klinkenkabel in den Filter-Port eines Oszillators eingeschleift.
MIXER - 3-Kanal Summierer + BC547 Verstaerkerstufe
SW202 waehlt weiche (Dioden in der Gegenkopplung) oder harte Begrenzung (Dioden gegen Masse). SW203 ueberbrueckt die Stufe.
RV205 = Amplitude dieses Oszillators. U204B puffert das Poti, R221 schuetzt den Ausgang, R222 haelt die Buchse auf Masse. J203 = Ausgangsbuchse, gleichzeitig geht das Signal zum Mixer.
Entkopplung Filter A / B
VERPOLUNGS- UND UEBERSTROMSCHUTZ
F901/F902 begrenzen den Strom bei einem Kurzschluss. D907/D908 (Schottky) sperren, wenn der Netzstecker verpolt ist: +12 V und -12 V koennen dann nicht vertauscht an die ICs gelangen. Spannungsverlust ca. 0,3 V pro Schiene.
OSZILLATOR 1
C303 trennt den Gleichanteil ab (der Saegezahn ist unipolar).
FILTER B (Hauptweg 2 von 2)
Filter D
D WELLENFORM-WAHL
OSZILLATOR 3
J201 (Send) und J202 (Return) werden per Klinkenkabel mit einem Solo-Filter verbunden. R217 haelt den Knoten definiert, wenn kein Kabel steckt.
ENDVERSTAERKER - LM386 + Lautsprecher
OSC 1
FILTER D (Solo-Filter 2)
RV101 = Frequenz (Ebene B des Gleichlaufpotis) U103C puffert den hochohmigen Kondensatorknoten.
Filter B
Komparator U301A und Integrator U301B bilden einen Regelkreis: die Dreieckamplitude bleibt damit ueber den ganzen Frequenzbereich konstant (Vss = 2 x Vsat x R305/R304). RV302 = Frequenz (Ebene A). R326/R327 teilen das Rechteck auf den Pegel der anderen Kurven.
J101 (Send) und J102 (Return) werden per Klinkenkabel mit einem Solo-Filter verbunden. R117 haelt den Knoten definiert, wenn kein Kabel steckt.
Danach geht das Signal in den Endverstaerker. RV501/RV502 = gemeinsames Cutoff-Poti (2-fach-Gleichlauf).
RV201 = Frequenz (Ebene B des Gleichlaufpotis) U203C puffert den hochohmigen Kondensatorknoten.
Filter C
FILTER A (Hauptweg 1 von 2)
SW302 waehlt weiche (Dioden in der Gegenkopplung) oder harte Begrenzung (Dioden gegen Masse). SW303 ueberbrueckt die Stufe.
D301/D302 runden die Dreieckspitzen (Gegenkopplung wird oberhalb 0,6 V weich), U301D verstaerkt wieder auf Pegel.
