lukimcfly/MaturaProjekt/(commit log)

2026-09-11 Initialer Stand des Maturaprojekts
    [BOM.csv, Filter.kicad_sch, Oscillator1.kicad_sch, SynthesizerFinal.kicad_sch]
2026-09-12 2/3 PCB Designs done, still WIP
    [BOM.csv, BOM_filter.csv, BOM_main.csv, BOM_osc.csv, SynthesizerFinal.kicad_sch, filter.kicad_pcb, filter.kicad_sch, main.kicad_pcb]
2026-09-16 Platinen: alle drei Layouts fertig, Fertigungsdaten und Werkzeuge ins Repo
    Die Oszillator-Platine ist jetzt vollstaendig geroutet - alle 45 Netze, kein
    offenes. Damit sind alle drei Platinen DRC-sauber mit Massflaeche in einem
    Stueck und koennen bestellt werden.
    Die beiden Netze, die sich tagelang nicht routen liessen (O1_AINV, O1_WSEL),
    scheiterten nicht an zu wenig Platz, sondern an zwei selbst gesetzten
    Sperrflaechen: keine Rueckseiten-Leiterbahn unter einem IC, keine zwischen
    Steckerstiften. Fuer diese zwei Netze aufgehoben - beide in drei Sekunden
    geroutet. Die Kosten sind nachgemessen, nicht geschaetzt: 73 mm2 von 10517 mm2
    Masseflaeche (0,69 %), Flaeche bleibt ein zusammenhaengendes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
    [BOM.csv, BOM_filter.csv, BOM_main.csv, BOM_osc.csv, SynthesizerFinal.kicad_sch, filter.kicad_pcb, filter.kicad_sch, main.kicad_pcb]
2026-09-21 Platinen: gegen JLCPCB-Fertigungsgrenzen geprueft, Bestueckungsdruck angepasst
    Alle drei Platinen direkt aus den Platinendateien vermessen und mit
    https://jlcpcb.com/capabilities/pcb-capabilities verglichen: Leiterbahnen,
    Vias, Restringe, Bohrungen, Lochabstaende und Randabstand liegen alle mit
    Reserve innerhalb der Grenzen.
    Einzige Abweichung: die Bauteil-Umrisse aus der KiCad-Bibliothek sind mit
    0,12 mm gezeichnet, JLCPCB druckt ab 0,15 mm zuverlaessig. Alle 2468 Linien
    auf 0,15 mm verbreitert. Kupfer, Bohrungen und Positionen unveraendert;
    DRC fehlerfrei, kein offenes Netz, Masseflaechen identisch.
    Gerber und Bestueckungsplaene neu erzeugt. Pruef- und Aenderungsskript
    (jlccheck.py, silk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
    [filter.kicad_pcb, main.kicad_pcb, osc.kicad_pcb]
2026-09-21 Oszillator: Frequenzbereich und Saegezahn-Pegel korrigiert, Bestueckungsdateien
    Beim Nachrechnen vor der Bestellung: die Simulationen hatten fuer den
    74LVC2G17 Schwellen von 1,8 / 1,2 V angenommen, das Datenblatt (TI, 5 V)
    gibt VT+ 2,05..3,4 V und VT- 1,25..2,25 V. Damit lag der Saegezahn fast
    eine Oktave unter den anderen Wellenformen am selben Knopf, und sein Pegel
    (7..15 Vss) haette die Ausgangsstufe uebersteuert.
    Drei Werte, gleiche Footprints, Platine unveraendert:
    C_02 6,8 -> 15 nF, C_01 47 -> 56 nF, R_24 110 -> 56 kOhm (je 3x)
    Bereich jetzt 48 Hz .. 4,9 kHz (eine Oktave tiefer, bis in den Bass),
    Saegezahn im Gleichlauf, Pegel 3,8..7,8 Vss statt 7..15.
    Simulation mit feinem Zeitschr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
    [BOM.csv, BOM_osc.csv, SynthesizerFinal.kicad_sch, filter-BOM-jlcpcb.csv, osc.kicad_pcb, osc.kicad_sch, oszillator-BOM-jlcpcb.csv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]
2026-09-21 Einkauf: Einkaufsliste fuer 2 Geraete mit Reserve und Abgleichteilen
    Einkauf/Einkaufsliste_Synthesizer.xlsx - Anzahl Geraete ist ein Eingabefeld,
    alle Bestellmengen rechnen sich daraus (Pro Geraet x Anzahl + Reserve -
    Vorhanden). Platinenteile direkt aus der Stueckliste des Gesamtschaltplans
    gezaehlt; Bedienfeld, JST-Verbinder (245 Kontakte pro Geraet),
    Stromversorgung (Mean Well 12 V + TRACO TMR 6-1222 fuer +-12 V, Arduino an
    12 V), Arduino, Befestigung, Abgleich-/Ersatzteile und Werkzeug von Hand.
    Preise sind Schaetzungen. Enthaelt die JLCPCB-Mengen fuer 2 Geraete.
    [Einkaufsliste_Synthesizer.xlsx]
2026-09-21 Einkauf: Eingangsstufe fuer den Arduino festgelegt (Abgriff FILT_B_OUT, Teiler 1:3 auf 2,5 V, Schutzdioden)
    [Einkaufsliste_Synthesizer.xlsx]
2026-09-21 Bedienfeld-Uebersicht, Modus-Taster ergaenzt, Filter-RV_03 korrekt als Resonanz benannt
    Uebersicht aller Bedienelemente eines Geraets, gegen Schaltplan gezaehlt
    (24 Knoepfe, 7 Drehschalter, 9+1 Kippschalter, 13 Buchsen). Dabei gefunden:
    der Oszilloskop-Modus liess sich nur mit dem RESET-Knopf im Gehaeuse
    wechseln - Modus-Taster (an Arduino RESET) in Einkaufsliste aufgenommen.
    README: RV_03 der Filter ist die Resonanz (Rueckfuehrung des Bandpasses),
    nicht ein Filter-Pegel.
    [Einkaufsliste_Synthesizer.xlsx]
2026-09-21 Bedienfeld: Oszillator ein/aus, Mixer-Fader, Buchse fuer eigenen Lautsprecher
    Alles Bedienfeld-Verdrahtung, keine Platinenaenderung. SW_05 schaltet den
    Eingang von U104B zwischen Amplituden-Poti und Masse um (nicht Schleifer
    auf Masse - das wuerde bei vollem Poti U104A kurzschliessen). Schaltende
    6,3-mm-Buchse trennt den eingebauten Lautsprecher ab. Verdrahtung in
    Platinen/BEDIENFELD-ERGAENZUNGEN.md, Einkaufsliste und Uebersichtsbild
    aktualisiert.
    [Einkaufsliste_Synthesizer.xlsx]
2026-09-21 Bedienfeld: kein eingebauter Lautsprecher mehr, Polklemmen fuer den eigenen
    Ein Klemmenpaar rot/schwarz an J904 reicht: Plus und Minus sind die beiden
    Enden desselben Stromkreises, kein Ein/Aus wie bei Send/Return.
    [Einkaufsliste_Synthesizer.xlsx]
2026-09-22 Einkauf guenstiger: rund CHF 378 fuer 2 Geraete statt CHF 850+
    - Lieferanten: Tayda (Bauteile, Bedienfeld), LCSC (original JST, Sonderteile),
    Conrad (Netzteile, Litze), JLCPCB bleibt fuer die Platinen. Warenkorb-Preise
    vom 22.09.2026, Sicherungskopien der Warenkoerbe als CSV.
    - U103/U401: TL074CDR (C12594) statt OPA4196 - gleiche Anschluesse, Filter-
    Simulation < 0,1 dB Unterschied, Netzliste nur 7 Wertaenderungen.
    - Gerber von Oszillator und Filter mit Lotpasten-Lage (fuer die Bestueckung).
    - Stromversorgung: +12 V direkt, -12 V aus B1212S-2WR3 statt TRACO TMR.
    - Tonhoehe/Cutoff-Potis mit Kennlinie C (A waere bei dieser Verdrahtung falsch).
    - Bestellanleitung Einkauf/BESTELLEN.md, Tag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
    [BOM.csv, BOM_filter.csv, BOM_osc.csv, Einkaufsliste_Synthesizer.xlsx, SynthesizerFinal.kicad_sch, filter-BOM-jlcpcb.csv, filter.kicad_pcb, filter.kicad_sch]
2026-10-21 Schul-Unterlagen: Merkblätter, Checkliste, Zitier- und KI-Regeln abgelegt
2026-10-21 Vertrag, altes Logbuch, Zwischenbericht und alte Quellensammlung abgelegt
2026-11-04 KI-Protokolle aller Claude-Sitzungen (anonymisiert) und überarbeitetes Logbuch
    Lesbare Fassung aller Sitzungen als digitaler Anhang zum KI-Nachweis;
    Namen, E-Mail und Benutzername durch Platzhalter ersetzt. Rohdaten
    bleiben privat. Logbuch: Zeile 19/08 gekürzt, KI-Rolle «Organisator».
2026-11-04 Logbuch: Benutzername in Pfaden und Autor-Metadaten entfernt
2026-11-07 Einkauf: Revision vom 11.10.2026, ein Gerat statt zwei
    Umstellung von 2 Geraten auf 1 Gerat: rund CHF 247 statt CHF 378. Warenkorbe bei Conrad, LCSC und Tayda entsprechend angepasst, Einkaufsliste aktualisiert. EINKAUF-REV-11-10-2026.md halt die Begrundung und die Preisvergleiche fest.
    [Einkaufsliste_Synthesizer.xlsx, warenkorb-conrad.csv, warenkorb-lcsc.csv, warenkorb-tayda.csv]
2026-11-07 Platinen: Aufbauanleitung, Versorgungs-Revision und Fehlersuche vom 06.11.2026
    AUFBAU.md: Aufbau- und Pruefanleitung fuer alle vier Platinensorten, Loettechnik, Pruefungen 1-4. BEDIENFELD-ERGAENZUNGEN.md Abschnitt 9: der DC/DC-Wandler B1212S-2WR3 und die RXEF110 wurden nicht geliefert, statt dessen zwei 12-V-Netzteile in Reihe. FEHLERSUCHE-06-11-2026.md: zwei TL074 zerstoert, Ursache waren beide DC-Buchsen verpolt zusammen mit ueberbrueckten Verpolschutzdioden. Hauptplatine und Filter danach funktional geprueft.
2026-11-07 Bilder: Fotos aus dem Chat, Aufbau-Fotos und Distortion-Schalter hinzugefuegt
